wZuck/YETI60/mechanical/README.zh-CN.md

[英文](README.md) | 简体中文

# YETI60 机械检查

`felk60_plate_hhkb.audited.dxf` 来自 fredlb/FELK60。只修复三处 DXF 字典所有者句柄；圆、折线、圆弧凸度和图层几何在记录的 1e-9 毫米比较精度内不变。

FELK60 上游基线为 1.2 mm 不锈钢定位板。当前 YETI60 两方案均选择 **1.6 mm NiZ／钢板卫星轴定位板**，安装 28 套固定件、H26 不装。垫条原厚下侧 2.0 mm、上侧 1.2 mm；供方压缩性能及真实机构配合待确认。见 [E73 规格](../docs/build/key-mechanism.zh-CN.md)及 [Raytac 规格](../variants/raytac/docs/build/key-mechanism.zh-CN.md)。原上盖 M3 底孔约 2.529 毫米；当前派生设计改为冷粘嵌件座，见装配规范。

当前[装配报告](../docs/audit/yeti60-assembly.json)使用明确暂定的 PCB 至定位板间距，检查当前 PCB 与原始壳体、定位板几何。原生 STEP 基材厚度与声明的含铜、阻焊成品厚度分别记录。见[全面复查](../docs/audit/yeti60-comprehensive-review.zh-CN.md)和[装配渲染](../renders/yeti60-assembly/README.zh-CN.md)。

尚无获准生产的树脂 STL、选定嵌件、树脂收缩余量、合格轴体与胶碗堆叠、最终电池或完整后侧 USB 线缆及插头装配。

运行 `python3 scripts/run_audit.py` 导出当前 PCB 元数据、只读核对定位板几何、检查条件装配及渲染几何。发现 PCB、定位板、元件包络或电池候选包络碰撞时验证失败。依赖固定在 `requirements-audit.txt`。

渲染保持 FELK60 原始壳体尺寸：原始 CAD 坐标系中，上下壳联合包围尺寸为 325.700 × 125.200 × 31.190 毫米。网格线性离散偏差为 0.015 毫米，包围坐标差值检查小于 0.02 毫米。7° 展示旋转为刚性变换，不改变外壳尺寸。见[渲染几何验证](../docs/audit/yeti60-render-geometry.json)。

默认 P2 [工程装配图](../docs/engineering/assembly.zh-CN.md)与[单电芯选型和凹槽设计](../docs/engineering/battery-study.zh-CN.md)已同步。基础 `generated/yeti60-bottom.step` 包含 85×43×4.8 mm、1600 mAh 电池包的凹槽；E73 正式装配使用下述 M01 派生底壳。独立温度保护、供应商签图和实物验收仍是采购／生产条件。

E73 正式使用 [M01 内收定位板与地板修补](../docs/engineering/e73-mechanical-fit-candidate.zh-CN.md)，Raytac 使用其独立检查的 C04 定位板及短 USB 底壳；不要混用装配选项。共享的原 NiZ DXF 和 generated 基础壳体继续作为派生输入，E73 正式底壳为 [M01 STEP](e73-fit/yeti60-e73-bottom-m01.step)。
