wZuck/YETI60/hardware/raytac/README.md

English | [Chinese](README.zh-CN.md)

# Current Raytac candidate downloads

This directory mirrors the current repair candidate PCB, mainboard Gerber/drill ZIP and bottom-stencil ZIP from the [first-article entry](../../variants/raytac/hardware/usb-short-route/FIRST-ARTICLE.md). Identify the files with the [hash manifest](manifest.json). The duplicate download for the previous routing is removed; historical reference files remain in the variant directory.

Use the [first-article entry](../../variants/raytac/hardware/usb-short-route/FIRST-ARTICLE.md) for JLC selections, materials, wiring and case-free validation. Use the complete variant project for editing, models and footprint libraries; the individual PCB copy here is not a complete project. Supplier DFM precedes production; physical acceptance and production approval remain open.
