wZuck/YETI60/variants/raytac/README.zh-CN.md

[英文](README.md) | 简体中文

# YETI60 Raytac

**当前修补主板首样：**[制造文件、普通 JLC 参数、补购与无外壳步骤](hardware/usb-short-route/FIRST-ARTICLE.zh-CN.md)。原目录的旧主板清单、线束和压缩包不能代替当前候选版。

当前 J2 为 [SH 三针、1.0 mm 间距](hardware/usb-short-route/BATTERY-SERVICE.zh-CN.md)。插座按当前候选采购表购买，电池包采用 SHR-03V-S／SSH 端子；下方保留参考表中的 PH 器件行属于历史版本。

**首样下单暂停：**[含电池的无外壳流程](OPEN-BENCH.zh-CN.md) · [USB、螺钉与电池研究](docs/engineering/prototype-qualification.zh-CN.md)。当前制板包未放行下单。

> [下单与制作总入口](BUILD.zh-CN.md)：制板参数、材料、逐步焊接和固件。

> 本目录为同一分支中的 Raytac MDBT50Q-1MV2 方案；E73 方案在[仓库主目录](../../README.zh-CN.md)。两种 PCB 与固件须成套选择，不可互换模组。外壳、定位板与上游来源由仓库根目录共用；运行命令时以本目录为工作目录。

以 Cipulot EC60 为基础、使用 FELK60 外壳的单 nRF52840 静电容键盘 PCB。保留前侧感应焊盘和安装孔位置；右侧新增受控圆角射频支撑区，后侧 USB 子板连接 J1。

**有线使用：**电脑接受 USB 配置后，键盘一边给电池充电，一边通过 USB 发送按键。USB 自动优先于历史保存的蓝牙偏好；拔线后由 ZMK 回退到当前蓝牙配置。E73 和 Raytac 两套方案采用同一策略。描述符中的 500 mA 是输入预算，并非恒定电池充电电流。

> **P2 阶段提交：**保留 C5 JSH 子板；默认改为定制 1600 mAh 单电芯，正式底壳含凹槽，充电设定和 USB500 固件同步更新。工程装配图、PCB 动画及装配渲染记录来源哈希。见[阶段记录](docs/design-checkpoint.zh-CN.md)。

> **当前放行状态：**原生射频支撑区和 USB 保护修补已在工作区实施，完整文件刷新、供方及实物验收仍待完成。先阅读[下单与制作总入口](BUILD.zh-CN.md)，使用前核对报告与当前来源一致。

## 当前复查

**Raytac 当前原生导通检查通过，完整审查刷新、供方和实物验收仍待完成。** [完整复查](docs/audit/yeti60-comprehensive-review.zh-CN.md)记录当前 P2 设计和待供方、公差、线束及实物验收事项。

| 范围 | 结果 |
|---|---|
| PCB | 严格 DRC 0 错误／0 断线，267 对实际引脚连接通过；USB 电阻已改为 0 Ω，电源局部路径已缩短，只用普通机械通孔，无盲埋孔及模组盘中孔，采用 JLC 普通四层叠层 |
| 固件 | 按原理图绑定的新控制核心通过主机 ASan/UBSan；已完成 GPIO/SAADC 与 USB/BLE 目标集成，普通版和校准版构建通过；实机验证待进行 |
| 机械 | 明确暂定 Z 结构下，源 PCB／定位板／壳体无实体相交；胶碗、螺钉和树脂公差未定型 |
| 电池 | 默认定制 1600 mAh，完整包络 85×43×4.8 mm；供方签图、电流资料更正及独立温度保护验收待完成 |
| 可视化 | P2 的 PCB 图／动画、独立工程图和摄影风格装配渲染由来源哈希绑定 |

- [内部连接及线束装配图](docs/engineering/interconnects.zh-CN.md)
- [可行性评估回应](docs/engineering/assessment-response.zh-CN.md)
- [普通工艺制板审查包](docs/engineering/fabrication-review.zh-CN.md)
- [工程装配图及步骤](docs/engineering/assembly.zh-CN.md)
- [28 步逐图焊接与安装指南](docs/assembly/build-guide.zh-CN.md)
- [电池下挖可行性](docs/engineering/battery-study.zh-CN.md)
- [功耗、续航及充电计算](docs/engineering/power-budget.zh-CN.md)
- [材料与采购表](docs/engineering/materials.zh-CN.md)
- [PCB 标记清理](docs/engineering/board-markings.zh-CN.md)
- [完整复查](docs/audit/yeti60-comprehensive-review.zh-CN.md)
- [硬件及特殊制板要求](hardware/ec60-nrf52840/README.zh-CN.md)
- [控制核心、模拟和轨迹](firmware/yeti60/README.zh-CN.md)
- [装配渲染](renders/yeti60-assembly/README.zh-CN.md)
- [PCB 渲染及 360° 动画](renders/ec60-nrf52840/README.zh-CN.md)
- [当前审查索引](docs/audit/README.zh-CN.md)

外壳暂按树脂，信号／射频检查已开始，最小天线铜区检查已通过，USB 信号完整性、关壳射频及实物验收仍待完成。项目文档默认英文并提供 `.zh-CN.md`，机器数据字段保持稳定。

基于 [Cipulot/EC60](https://github.com/Cipulot/EC60) 和 [fredlb/felk60](https://github.com/fredlb/felk60)，保留上游作者、许可证和原名称。`EC60-nRF52840.*` 文件名及 `YAECKB` 库标识为技术兼容保留，公开项目名统一为 **YETI60**。

## 一把键盘需要准备的完整材料

**当前候选方案下单：**使用[首板入口](hardware/usb-short-route/FIRST-ARTICLE.zh-CN.md)、[当前 75 件采购表](hardware/usb-short-route/mainboard-purchase.zh-CN.csv)、[阻容规格](hardware/usb-short-route/PASSIVES.zh-CN.md)及 [C04 定位板／外壳／八条垫片](hardware/usb-short-route/MECHANICAL-FIT.zh-CN.md)。下方电子件和旧线束行属于保留的修补前参考；通用工具／紧固件仍可使用，但应服从这些当前修订。

以下为 **1 把完整键盘的装机净用量，不含备件**。主板与子板可购买焊装成品；若自行焊接，分别准备下面的散件，不能再重复购买同一总成的元件。尚未选定的供应商或型号明确标注，数量确定不代表已获采购放行。

**制板限制：只使用 JLC 普通四层工艺。已将旧盲孔／填孔封盖设计改为普通机械通孔；旧 HDI 文件不可用于下单。** 完成后以最新制板审查清单为准。没有第二颗主控，不需要每键二极管或 MX 热插拔座。

### 优先使用现有库存

按提供的订单库存记录核对标称值和封装，主板 75 只元件中可计划使用库存 **10** 只，净补购 **65** 只。装配前清点实际未使用数量，并完成电容有效容量确认。在途商品不计入可用数量。原始表格保持不变，也不上传到公开仓库。

| 库存型号 | 位号 | 计划使用数量 |
|---|---|---:|
| Samsung CL05B104KO5NNNC，100 nF／16 V／X7R／0402 | C9、C11、C12、C31 | 4 |
| Samsung CL05A105KA5NQNC，1 µF／25 V／X5R／0402 | C13、C48 | 2 |
| Uniroyal 0402WGF0000TCE，零欧姆／0402 | R30、R31 | 2 |
| Uniroyal 0402WGF1001TCE，1 kΩ／1%／0402 | R17 | 1 |
| Uniroyal 0402WGF1002TCE，10 kΩ／1%／0402 | R26 | 1 |

将 [扣除计划库存后的主板补购表](hardware/bom/mainboard-purchase.zh-CN.csv)、[库存判断说明](docs/engineering/inventory-allocation.zh-CN.md) 与下方完整准备清单配合使用。其他总成和结构材料仍需补购或确认兼容性。成品 C5 已包含七只元件；若改为自焊 C5 裸板，库存两只 5.1 kΩ 电阻可供 C5 的 R1／R2 使用。库存 nice!nano、110 mAh 电芯、0805 电容及过短的 PCB 螺丝不能直接替代指定物料。此次库存分配不改变板子或外壳尺寸。

### 需要下单制作哪些 PCB

数量为一把键盘的净用量，板厂起订数量另计。购买成品 C5 时，只制作 **一块主板**；自行焊子板时，制作 **一块主板加一块 C5 JSH 裸板**。

| PCB | 数量 | 尺寸与工艺 | 源文件及制板文件 |
|---|---:|---|---|
| YETI60 Raytac 主板 | 1 块 | 板框包围尺寸 289.39×94.6 mm；JLC 普通四层 FR-4、标称 1.6 mm，只用普通通孔 | [可编辑 KiCad PCB](hardware/ec60-nrf52840/EC60-nRF52840.kicad_pcb)、[当前 Gerber／钻孔审查压缩包](hardware/fabrication/yeti60-raytac-p2-dfm-review.zip)、[制板工艺要求](hardware/ec60-nrf52840/fabrication-notes.zh-CN.md) |
| Unified Daughterboard C5 JSH 子板 | 自焊时 1 块；买成品时 0 块 | 18.0×16.5 mm；**四层板**、标称 1.6 mm、普通通孔；安装孔矩形 14×12.5 mm | [上游固定版本 KiCad PCB](https://github.com/Unified-Daughterboard/UDB-C-JSH/blob/2b6c52aa2de6f9f60ca99c6250e4bdf01e8f4eea/UDB.kicad_pcb)、[下载固定版本 Gerber／钻孔包](https://raw.githubusercontent.com/Unified-Daughterboard/UDB-C-JSH/2b6c52aa2de6f9f60ca99c6250e4bdf01e8f4eea/production/UDB-C-JSH_5.0_gerbers.zip)、[七只焊装散件](hardware/bom/daughterboard.zh-CN.csv) |

两块板使用各自的制板文件，主板压缩包不包含 C5。两个压缩包均有四层铜，C5 不能按双层板下单。主板文件目前用于制造审查，最终物料、钢网及供应商验收仍待完成。J3 已在主板上，只需配探针治具，本设计无须再制作刷写小板。不锈钢定位板、树脂上下壳及五个走线支架属于机械件，不是额外 PCB。自行回流焊时，主板用 **B.Paste**，C5 用 **F.Paste**，钢网和温度曲线须与实际物料匹配。

### 电子总成、电池和连接线

| 材料 | 数量 | 详细规格及包含内容 |
|---|---:|---|
| 主板 PCB | 1 块 | 当前 YETI60 原生 PCB；普通四层 FR-4，目标 1.6 mm 标称厚度，保留 EC 电极／板框／安装中心；CAD 包络 1.6062 mm；按最新普通工艺审查包核对文件后下单 |
| 主板焊装散件 | 75 件 | 下表列明全部位号、数值、封装及指定／候选型号；购买焊装主板时此行已包含 |
| USB 子板 | 1 块焊装成品 | Unified Daughterboard C5 JSH，版本提交 `2b6c52a`；含 USB-C 母座、SH 板端座及其余元件，共 7 个实装元件；不选 S 版 |
| USB 内部线束 | 1 条四芯 | AWG28 多股铜线，绝缘外径不大于 0.8 mm；两端 SHR-04V-S 插壳，共 2 个插壳、8 个 SSH-003T-P0.2-H 端子；1→1 正电源、2→2 D−、3→3 D+、4→4 地。150 mm 为路径中心线，四根实际出线口间长度约 147.64／149.21／150.79／152.36 mm，须按控制路径预成形 |
| 电池总成 | 1 包 | 定制单电芯 YETI60-BAT-1600-1S，最低目标 1600 mAh，整个电池包不超过 85×43×4.8 mm，已包含保护板、温度传感器、包覆、焊片和增长空间；独立温度断充，实际充电窗口须在 15…43°C 内；供方须接受至少 500 mA 连续充电及 4.16–4.23 V 充电稳压范围 |
| 电池引线及插头 | 1 套三线，含在电池总成中 | AWG28、外径不大于 0.8 mm；PHR-3 插壳 1 个、SPH-004T-P0.5S 端子 3 个；1 红色正极、2 黑色负极、3 黄色独立 10k NTC 温度线。温度保护和第三线 NTC 反馈须分开；尺寸和出线位置须供方签图 |
| 外部 USB 数据线 | 1 条 | 主机端按电脑选择 USB-A／USB-C，键盘端 USB-C；必须支持 USB 数据，不能用仅充电线 |

### 主板全部实装元件

0402 电阻均按 1%、不低于 50 mW 选型；0 Ω 位置使用零欧姆连接。220 pF 电容使用 C0G，其余按 X5R／X7R、10% 或更优、不低于 10 V（标注 16 V 的位置使用 16 V）；有效容量仍须核对偏压降额。以下数值是当前电路要求，未选型号处不得自行宣称已定型。

| 位号 | 数量 | 数值／功能 | 封装 | 指定／候选型号 | 计划用库存 | 需补购 | 库存备注 |
| --- | --- | --- | --- | --- | --- | --- | --- |
| C9, C11, C12 | 3 | 100n | C_0402_1005Metric | 厂商型号待选 | 3 | 0 | 已有：Samsung CL05B104KO5NNNC；订单已收货池 100 只（同来源行共享，不可逐行相加）；装配前清点；须确认有效容量 |
| C10 | 1 | 220p | C_0402_1005Metric | 厂商型号待选 | 0 | 1 | 未匹配可用库存；需补购 |
| C13 | 1 | 1u | C_0402_1005Metric | 厂商型号待选 | 1 | 0 | 已有：Samsung CL05A105KA5NQNC；订单已收货池 50 只（同来源行共享，不可逐行相加）；装配前清点；须确认有效容量 |
| C30, C41, C42, C43, C45, C46 | 6 | 10u/10V | C_0603_1608Metric | 厂商型号待选 | 0 | 6 | 未匹配可用库存；需补购 |
| C31 | 1 | 100n/16V | C_0402_1005Metric | 厂商型号待选 | 1 | 0 | 已有：Samsung CL05B104KO5NNNC；订单已收货池 100 只（同来源行共享，不可逐行相加）；装配前清点；须确认有效容量 |
| C32 | 1 | 4.7u/10V | C_0603_1608Metric | 厂商型号待选 | 0 | 1 | 未匹配可用库存；需补购 |
| C40 | 1 | 1u/10V | C_0603_1608Metric | 厂商型号待选 | 0 | 1 | 未匹配可用库存；需补购 |
| C44 | 1 | 100n/16V | C_0603_1608Metric | 厂商型号待选 | 0 | 1 | 未匹配可用库存；需补购 |
| C47 | 1 | 10n | C_0402_1005Metric | 厂商型号待选 | 0 | 1 | 未匹配可用库存；需补购 |
| C48 | 1 | 1u/10V | C_0402_1005Metric | 厂商型号待选 | 1 | 0 | 已有：Samsung CL05A105KA5NQNC；订单已收货池 50 只（同来源行共享，不可逐行相加）；装配前清点；须确认有效容量 |
| D2 | 1 | STATUS | LED_0603_1608Metric | 0603 指示灯，厂商型号待选 | 0 | 1 | 未匹配可用库存；需补购 |
| F1 | 1 | 500mA | Fuse_1206_3216Metric | 1206 自恢复保险丝，保持电流 0.5 A | 0 | 1 | 未匹配可用库存；需补购 |
| J1 | 1 | REAR_USB_DAUGHTERBOARD | JST-SR-4 | JST SM04B-SRSS-TB(LF)(SN)，候选 | 0 | 1 | 未匹配可用库存；需补购 |
| J2 | 1 | PROTECTED_1S_4V2_NTC10K | JST_PH_S3B-PH-SM4-TB_1x03-1MP_P2.00mm_Horizontal | JST S3B-PH-SM4-TB(LF)(SN) | 0 | 1 | 未匹配可用库存；需补购 |
| L1 | 1 | 1.5uH_74438336015 | L_Wuerth_MAPI-3015 | Wurth 74438336015 | 0 | 1 | 未匹配可用库存；需补购 |
| R3, R4, R5, R6, R7, R47, R53, R54 | 8 | 100 | R_0402_1005Metric | 厂商型号待选 | 0 | 8 | 未匹配可用库存；需补购 |
| R8, R9, R10, R11, R12, R13, R14, R15, R16, R18, R19, R20, R21, R23, R24, R25, R42, R43, R44, R45, R46, R48, R49, R50 | 24 | 100k | R_0402_1005Metric | 厂商型号待选 | 0 | 24 | 未匹配可用库存；需补购 |
| R17 | 1 | 1k | R_0402_1005Metric | 厂商型号待选 | 1 | 0 | 已有：Uniroyal 0402WGF1001TCE；订单已收货池 100 只（同来源行共享，不可逐行相加）；装配前清点 |
| R26 | 1 | 10k | R_0402_1005Metric | 厂商型号待选 | 1 | 0 | 已有：Uniroyal 0402WGF1002TCE；订单已收货池 100 只（同来源行共享，不可逐行相加）；装配前清点 |
| R30, R31 | 2 | 0 | R_0402_1005Metric | 厂商型号待选 | 2 | 0 | 已有：Uniroyal 0402WGF0000TCE；订单已收货池 100 只（同来源行共享，不可逐行相加）；装配前清点 |
| R32 | 1 | 2.2k | R_0402_1005Metric | 厂商型号待选 | 0 | 1 | 未匹配可用库存；需补购 |
| R40 | 1 | 2.21k/1% | R_0402_1005Metric | 厂商型号待选 | 0 | 1 | 未匹配可用库存；需补购 |
| R41 | 1 | 7.50k/1% | R_0402_1005Metric | 厂商型号待选 | 0 | 1 | 未匹配可用库存；需补购 |
| R51, R52 | 2 | 1M/1% | R_0402_1005Metric | 厂商型号待选 | 0 | 2 | 未匹配可用库存；需补购 |
| R55 | 1 | 69.8k/1% | R_0402_1005Metric | 厂商型号待选 | 0 | 1 | 未匹配可用库存；需补购 |
| R56 | 1 | 1.69k/1% | R_0402_1005Metric | 厂商型号待选 | 0 | 1 | 未匹配可用库存；需补购 |
| SW1 | 1 | EVQPUC02K_RESET | Panasonic_EVQPUL_EVQPUC | Panasonic EVQPUC02K | 0 | 1 | 未匹配可用库存；需补购 |
| SW100 | 1 | JS102011SAQN_POWER | SW_SPDT_CK_JS102011SAQN | C&K JS102011SAQN | 0 | 1 | 未匹配可用库存；需补购 |
| U1 | 1 | MDBT50Q-1MV2 | Raytac_MDBT50Q | Raytac MDBT50Q-1MV2 | 0 | 1 | 未匹配可用库存；需补购 |
| U2, U4 | 2 | 74HC4051 | TSSOP16 | Nexperia 74HC4051PW,118 | 0 | 2 | 未匹配可用库存；需补购 |
| U3 | 1 | OPA350 | SOIC-8_3.9x4.9mm_P1.27mm | TI OPA350UA | 0 | 1 | 未匹配可用库存；需补购 |
| U5 | 1 | BQ24074RGT | VQFN-16-1EP_3x3mm_P0.5mm_EP1.6x1.6mm | TI BQ24074RGTR | 0 | 1 | 未匹配可用库存；需补购 |
| U6 | 1 | TPS63031DSK | WSON-10-1EP_2.5x2.5mm_P0.5mm_EP1.2x2mm | TI TPS63031DSKR | 0 | 1 | 未匹配可用库存；需补购 |
| U7, U8 | 2 | TPS22919DCK | SOT-363_SC-70-6 | TI TPS22919DCKR | 0 | 2 | 未匹配可用库存；需补购 |

JP1 数量 **0**，保持不装；J3 为 PCB 上的六个 SWD 接触焊盘，不另装排针。主板统计为 43 个电阻、17 个电容及 15 个其他器件，共 75 件。

### 可选：自行焊接 C5 JSH 子板

准备 **C5 JSH 裸板一块及下方七只元件**，替代购买成品子板。[本仓库库存抵扣表](hardware/bom/daughterboard.zh-CN.csv) · [上游固定版本材料表](https://github.com/Unified-Daughterboard/UDB-C-JSH/blob/2b6c52aa2de6f9f60ca99c6250e4bdf01e8f4eea/production/UDB-C-JSH_5.0_bom.csv) · [上游固定版本制板文件](https://github.com/Unified-Daughterboard/UDB-C-JSH/blob/2b6c52aa2de6f9f60ca99c6250e4bdf01e8f4eea/production/UDB-C-JSH_5.0_gerbers.zip)。

| 位号 | 数量 | 厂商及指定型号 | 封装／连接器焊盘 | LCSC 编号 | 计划用库存 | 需补购 | 库存备注 |
| --- | --- | --- | --- | --- | --- | --- | --- |
| D1 | 1 | FTR SMF6.0A | SOD-123FL | C708002 | 0 | 1 | 未匹配可用库存；需补购 |
| F1 | 1 | Shenzhen JDT Fuse ASMD1206-150 | F1206 | C135342 | 0 | 1 | 未匹配可用库存；需补购 |
| J2 | 1 | JST SM04B-SRSS-TB(LF)(SN) | SM04B-SRSS-TB(LF)(SN)_mounting-reliefs | C160404 | 0 | 1 | 未匹配可用库存；需补购 |
| J1 | 1 | Korean Hroparts TYPE-C-31-M-12 | TYPE-C-31-M-12 | C165948 | 0 | 1 | 已有同系列国产替代 6 只；尺寸及针脚待确认，暂不抵扣 |
| R1, R2 | 2 | Uniroyal 0402WGF5101TCE | R0402 | C25905 | 2 | 0 | 已有同型号；订单已收货池 100 只，计划用 2 只；装配前清点 |
| U1 | 1 | Texas Instruments TPD4E05U06DQAR | uSON-10 | C138714 | 0 | 1 | 未匹配可用库存；需补购 |

库存两只 5.1 kΩ 电阻可供 R1／R2 使用，因此自焊选项还需 **五只散件及一块裸板**。国产 TYPE-C-31-M-12 的实物尺寸未确认，暂不抵扣。这些位号属于子板，不能与主板同名位号混用。USB 线束、四只 M2 螺丝及垫圈另按下方准备。LCSC 编号来自固定版本的上游清单，不代表当前价格或库存保证。材料数据版权属于 Unified Daughterboard Project（2023），保留 [MIT 许可证](hardware/usb-daughterboard/LICENSE.upstream)。

### 壳体、静电容结构与紧固件

| 编号 | 材料 | 数量 | 详细规格／验收要求 |
|---|---|---:|---|
| M01 | 上壳 | 1 | 派生 FELK60 HHKB STEP；韧性 SLA 树脂，完成后固化；外部尺寸不缩放 |
| M02 | 底壳 | 1 | 默认 P2 派生 STEP，含 1600 mAh 电池槽，外形不变 |
| M03 | 定位板 | 1 | K07 NiZ 钢板卫星轴 DXF，304 不锈钢，CAD 厚 1.60 mm、成品 1.55—1.60 mm，28 处 M2×0.4；H26 不开安装孔 |
| M04 | NiZ 轴座／滑块及原配消音圈 | 60 套 | K01 每包 5 套，买 13 包共 65 套，装 60、余 5；大键也用普通中央轴座，不用 Deskeys 宽总成 |
| M05 | 胶碗 | 60 个位置 | K03 NiZ 45g 整张 1 张，取至少 60 个完整位置并按 HHKB 裁分；不是 K01 内含材料 |
| M06 | 锥形感应弹簧 | 60 | K02 NiZ 锥簧每包 5 个，买 13 包共 65，装 60、余 5；不是辅助回弹簧 |
| M07 | 钢板卫星轴及钢丝 | 1 套 | K04 原装 GMK Plate mount／2u 买 3 组，装六个壳和柱；用两根短丝，第三组改装 K05 单独 6U 长丝；短丝余 1 |
| M08 | 键帽 | 60 | K06 NicePBT BoW 当前完整套装 1 套，须含 6.0c Centered 居中空格；MX 接口 |
| M09 | 转接支柱 | 28 | YETI60-STANDOFF-46；黄铜 Ø3.5，肩长 4.50±0.03；上端 M2×0.4 外牙长 1.0，下端 M1.6×0.35 内牙深 3.2；H26 不装 |
| M10 | 上侧绝缘膜 | 28 | 聚酰亚胺 0.10±0.02 mm，外径 4.5／内径 1.8；支柱与 PCB 之间，H26 不装 |
| M11 | PCB 螺钉 | 28 | M1.6×5 盘头，头部包络和螺纹须首件确认；H26 不装 |
| M12 | PCB 垫片 | 28 | PEEK，外径不大于 4.0、内径 2.2、厚 0.8 mm；H26 不装，不换金属垫片 |
| M13 | 上壳嵌件 | 4 | 冷粘滚花黄铜 M3×0.5，外径 4.6、长 3.0；底孔 Ø4.85±0.05、深 3.5 |
| M14 | 子板嵌件 | 4 | 冷粘黄铜 M2×0.4，外径 3.2、长 2.5；底孔 Ø3.35±0.05、深 2.9 |
| M15 | 合壳螺钉 | 4 | 建议 M3×5 加 0.30 mm 薄垫；CAD 螺钉座 z=2.59、嵌件入口 z=4.79，名义啮合 2.50 mm；头径不大于 5.6，匹配 Ø5.8 沉孔 |
| M16 | 子板螺钉 | 4 | 建议 M2×4 加 0.30 mm 绝缘垫片；名义啮合 4−1.6062−0.30=2.0938 mm，嵌件长 2.5；头部与连接器间隙仍需检查 |
| M17 | 垫片安装胶棉 | 1 套 | 下侧原厚 2.0 mm、上侧原厚 1.2 mm，按原支承台裁切；名义装后各为 1.0162／0.5838 mm |
| M18 | 脚垫 | 4 个 | [SKUF 硅胶脚垫](https://keeb.io/products/skuf-silicone-rubber-keyboard-feet)，41.8×5.8×2 mm、45A、自带背胶；四个壳体脚槽约 42.2×6.2 mm。购买 1 包 8 个时余 4 个备件 |
| M19 | 嵌件胶粘剂 | 适量 | 与树脂相容的结构环氧胶；仅冷粘，按供方要求固化，不得堵塞螺纹 |
| M20 | 电池固定及绝缘材料 | 1 套 | 非导电可拆固定及边缘防护；胶带厚度计入槽深预算，不能压紧软包电池 |

**按键机构已改为 NiZ＋钢板卫星轴。** [准确选项、数量与安装](docs/build/key-mechanism.zh-CN.md)列出 K01—K07；它们分开购买，不再购买 Deskeys 配件包。PCB 原 29 孔不变，H26 不装，实际用 28 套紧固件。机械库存未核实。

### 补充固定材料和耗材

| 材料 | 数量 | 规格／包含关系 |
|---|---:|---|
| 合壳薄垫片 | 4 | 厚 0.30 mm，配上表 4 颗 M3×5；孔适配 M3，外径不超过螺钉座可用空间 |
| 子板绝缘垫片 | 4 | 厚 0.30 mm，孔适配 M2，配 4 颗 M2×4 |
| 后侧线束固定座底座 | 2 | `mechanical/generated/interconnect-guides/rear-1-base` 和 `rear-2-base` 的 STEP／STL 各 1 件；当前宽 5.4、路径方向长 2 mm |
| 后侧固定座可拆桥 | 2 | 对应 `rear-1-bridge` 和 `rear-2-bridge` 各 1 件；下层三根电池线、上层四根 USB 线，槽半径 0.5 mm |
| 前侧 USB 固定座 | 1 | `front-base` 的 STEP／STL；宽 6、路径方向长 1.8 mm；按壳体坐标安装，不能缩放 |
| 聚酰亚胺绝缘片材 | 1 张 | 至少 100×100×0.10 mm；用于上表 28 片绝缘圆片，已购买裁切件时不重复计入；线束保持膜另用下列带胶材料 |
| 胶棉片材 | 2 张 | 下侧至少 330×130×2.0 mm 一张，上侧至少 330×130×1.2 mm 一张；对应 M17 一套，不重复计数；材质硬度须首件确认 |
| 树脂相容双组分结构胶 | 1 小套 | 嵌件和支座粘接用，按胶与树脂供方工艺选型并完全固化；这是采购包装数，不是已测得耗胶量 |
| 电池可拆固定胶与边缘绝缘 | 1 套 | 槽底到电池包名义仅 0.20 mm；底部胶、绝缘和装配余量的总厚度不得超预算，不能额外压缩软包 |
| 上侧线束保持胶带 | 1 小卷，裁 3 片 | 带胶绝缘膜／胶带，含胶总厚不超过 0.10 mm；覆盖上层导线并向固定座侧面包覆 |
| 可拆桥固定胶带 | 1 小卷 | 非导电、可移除双面胶，总厚 0.05 mm，用于 2 个后侧桥的侧面支承区；上层保持膜与胶总厚不得超过 0.10 mm |

### 需要的工具（可共用，无须每把配一套）

| 工具 | 数量 | 用途／规格 |
|---|---:|---|
| 兼容 nRF52840 的 SWD 调试器 | 1 | 3.3 V 目标电平，支持 SWDIO／SWDCLK／地／复位 |
| J3 弹簧针治具 | 1 套 | 6 根针按 J3 焊盘图布置；3.3 V 为目标参考，不能同时盲目向已供电主板反灌电源 |
| 万用表 | 1 | 逐线导通、极性及上电短路检查 |
| 游标卡尺及厚度量具 | 各 1 | 检查电池完整包络、板厚、支柱和绝缘垫片 |
| 低扭矩螺丝刀及匹配批头 | 1 套 | M1.6／M2／M3；最终扭矩须按样件和螺纹质量确定 |
| 绝缘拨动工具 | 1 | 经底部检修孔操作 SW100 |
| 切割／去毛刺工具、镊子 | 1 套 | 裁垫片、清理支座与安装；不得损伤电池绝缘 |
| 焊台、热风或回流设备、焊料、助焊剂和清洗耗材 | 各 1 套（自行焊接时） | 0402、模组及裸露散热盘需要适合的焊装能力；购买焊装板时不属于随键盘材料 |
| 背面钢网 | 1 张（自行回流焊接时） | 按当前 B.Paste 光绘激光切割，样机暂按 0.10 mm 不锈钢；最终厚度与散热盘开口由贴片工艺确认 |
| 定位板攻牙工具 | 1 套（自行加工定位板时） | M2×0.4 丝锥及匹配底孔加工工具；买已攻牙定位板时不需要重复加工 |
| 嵌件孔精修工具 | 1 套（壳厂未精加工时） | 按 Ø4.85±0.05／Ø3.35±0.05 mm 及规定孔深加工，不能用未测量的打印孔直接代替 |
| 限流电源、电池模拟器、电流记录仪和温度探头 | 各 1 套（样机验证时） | 用于首次上电、充电／终止／温升和续航验收；不计入键盘装机数量 |

详细采购限制见[材料文档](docs/engineering/materials.zh-CN.md)与[功耗及充电计算](docs/engineering/power-budget.zh-CN.md)。电池供方签图、未选元件、静电容机械结构与普通工艺改版验收完成前，不应把这份准备清单当作可直接量产的采购单。
