wZuck/YETI60/firmware/ec60/readme.md

English | [Chinese](readme.zh-CN.md)

# EC60

60% Electrostatic Capacitive PCB, GH60 mounting compatible, with multi-layout support

* Keyboard Maintainer: [cipulot](https://github.com/cipulot)
* Hardware Supported: EC60
* Hardware Availability: TBD

Make example for this keyboard (after setting up your build environment):

    make ec60:default
    make ec60:via

Flashing example for this keyboard:

    make ec60:default:flash
    make ec60:via:flash

See the [build environment setup](https://docs.qmk.fm/#/getting_started_build_tools) and the [make instructions](https://docs.qmk.fm/#/getting_started_make_guide) for more information. Brand new to QMK? Start with our [Complete Newbs Guide](https://docs.qmk.fm/#/newbs).

This is the upstream STM32 reference. These commands do not build or flash the YETI60 nRF52840 application.
