wZuck/YETI60/variants/raytac/firmware/README.md

English | [Chinese](README.zh-CN.md)

# YETI60 firmware

USB charging now uses the [status callback and deconfiguration policy](../docs/testing/usb-event-policy.md), independently of scan polling. Suspend disables charging/input; resume and 500 mA permission follow the actual configuration byte. Both variants share this logic; recalibrate when upgrading from an older bundle.

Current repaired-board files: [candidate firmware and SWD entry](../hardware/usb-short-route/firmware/README.md). Read [selected-profile recovery and calibration v3 compatibility](../docs/testing/firmware-recovery.md); keep the normal/calibrator pair from the same bundle.

The current [nRF52840 control core](yeti60/README.md) and [host simulation](../docs/audit/yeti60-firmware-simulation.json) use the schematic-derived GPIO, SAADC and mux contract. Run `python3 scripts/simulate_yeti60_firmware.py` from the repository root.

Only the current core and its tests are maintained here. Original EC60 QMK sources remain in the attributed `EC60` submodule; duplicate legacy firmware and tests have been removed. The GPL license is retained.

The target module supplies a flashable SWD application, GPIO/ADC driver, USB/BLE stacks and HHKB keymap. Physical calibration and on-device operation require a sample. Host sanitizer tests establish logic behavior with mocked hardware, not on-device operation.

[Buildable target firmware](target/README.md) now supplies a custom YETI60 board, the same portable core, ZMK USB/BLE HID, persistent calibration and normal/calibrator HEX files. On-device verification remains pending.

The [plate/copper/firmware check](../docs/audit/yeti60-key-geometry.json) matches all 60 opening centers to actual ROW/COL copper, including the alternate lands inside SW60/SW62. Right Shift is ROW3/COL13 and Fn is ROW3/COL14; the former ROW3/COL12 and ROW4/COL14 choices were corrected in both the target transform and calibration mask, and both target variants were rebuilt. Geometric coverage does not replace physical key calibration. Follow the [illustrated programming and installation guide](../docs/assembly/build-guide.md).
