wZuck/YETI60/variants/raytac/firmware/README.zh-CN.md

[英文](README.md) | 简体中文

# YETI60 固件

USB 充电控制已改为[状态回调及取消配置处理](../docs/testing/usb-event-policy.zh-CN.md)，不再等待扫描轮询。挂起禁充／输入高阻；恢复和 500 mA 授权按实际配置字节处理。两版共用此逻辑，从旧包升级需重新校准。

当前修补板文件：[候选固件与 SWD 入口](../hardware/usb-short-route/firmware/README.zh-CN.md)。参阅[单槽位恢复和 v3 校准兼容性](../docs/testing/firmware-recovery.zh-CN.md)，普通版和校准版必须来自同一固件包。

当前 [nRF52840 控制核心](yeti60/README.zh-CN.md)和[主机模拟](../docs/audit/yeti60-firmware-simulation.json)使用从原理图推导的 GPIO、SAADC 和复用器契约。在仓库根目录运行 `python3 scripts/simulate_yeti60_firmware.py`。

此处只维护当前核心及其测试。原始 EC60 QMK 源码仍保留在具有上游署名的 `EC60` 子模块中，重复历史固件与测试已移除，GPL 许可证保留。

目标模块提供可通过 SWD 刷写的应用、GPIO／ADC 驱动、USB／蓝牙栈及 HHKB 键位映射；实物校准和实际运行仍待样机。主机消毒器测试验证模拟硬件下的逻辑行为，不证明实机可运行。

[可构建目标固件](target/README.zh-CN.md)现提供 YETI60 自定义板、同一可移植核心、ZMK USB／蓝牙 HID、持久校准和普通／校准版 HEX；实机验证仍待样机。

[定位板／铜箔／固件检查](../docs/audit/yeti60-key-geometry.json)将 60 个开孔中心对应到实际 ROW／COL 铜箔，包括 SW60／SW62 内的备选焊盘。右 Shift 对应 ROW3／COL13，Fn 对应 ROW3／COL14；目标键位变换和校准掩码均已纠正之前的 ROW3／COL12、ROW4／COL14 选择，两版固件已经重新构建。几何覆盖检查不能替代实物逐键校准。安装及刷写参见 [逐图指南](../docs/assembly/build-guide.zh-CN.md)。
