wZuck/YETI60/variants/raytac/firmware/target/README.zh-CN.md

[英文](README.md) | 简体中文

# YETI60 目标固件

静电容扫描已修正为先释放再升行、先钳位再降行；见[模拟时序研究](../../docs/testing/analog-waveform.zh-CN.md)。校准版新增 `yeti_calibrate timing`，报告行 GPIO 调用至 ADC 返回的 RTC 粗略耗时及计时频率，含一格量化余量；实际为 32768 Hz，不能据此确定精确采样时刻。升级后用同包两版重新校准。

USB 充电控制已改为[状态回调及取消配置处理](../../docs/testing/usb-event-policy.zh-CN.md)，不再等待扫描轮询。挂起禁充／输入高阻；恢复和 500 mA 授权按实际配置字节处理。两版共用此逻辑，从旧包升级需重新校准。

当前修补 PCB 使用[候选构建／刷写入口](../../hardware/usb-short-route/firmware/README.zh-CN.md)。[恢复与 v3 校准契约](../../docs/testing/firmware-recovery.zh-CN.md)新增 Fn＋双击 Backspace（两次按下间隔小于 400 ms），仅清除当前蓝牙槽位。首次升级 v3 需重新采集阈值；刷入配套普通版时保留设置。

此 ZMK 模块将已测试的可移植扫描核心接入 nRF52840 GPIO／SAADC，并使用当前原理图生成的引脚头文件。ZMK 提供 USB HID、蓝牙 HID、绑定、五组主机配置和持久设置。HHKB 映射依据实际定位板与感应焊盘对应关系，自定义板使用内部低频 RC 时钟，不占用开发板 LED 引脚，应用从地址零通过 SWD 刷写。

## 可复现构建

准确初始化步骤、自定义工作区及排障见[从新检出仓库构建的环境说明](../../docs/build/firmware-environment.zh-CN.md)。从仓库根目录执行：

```sh
python3 variants/raytac/scripts/prepare_yeti60_workspace.py
python3 variants/raytac/scripts/prepare_yeti60_workspace.py --check
python3 variants/raytac/scripts/build_usb_short_firmware.py
```

上述封装脚本构建当前候选板。独立的 `python3 variants/raytac/scripts/build_yeti60_firmware.py` 构建保留的参考板。两者使用冻结清单及固定容器，拒绝被改动的依赖源码／版本，并记录源码／配置／设备树／产物哈希。ZMK 使用项目 fork `https://github.com/wZuck/zmk` 的 `0862fc0f8c864834007986efcaf52f292ea6d37d`；相对上游只增加了可配置的可连接广播间隔（`ZMK_BLE_ADV_INT_MIN/MAX`）。

构建容器按摘要固定，临时构建目录已忽略。可分发 HEX、BIN、ELF 位于 `firmware/releases/`。J3 使用本项目自定义 SWD 引脚，连接探针前核对硬件契约。校准后更新普通固件时，保留末尾 64 KiB 设置分区；整片擦除会丢失校准与蓝牙绑定。

## 校准与操作

先刷校准版 HEX。全部松键执行 `yeti_calibrate release`，等待 128 帧完成提示。对 60 个实际按键分别操作：先将目标键完全按住，再执行 `yeti_calibrate press <row> <col>`，保持按住直到该键 128 个采样完成提示后再松开。用 `yeti_calibrate status` 检查样本数、最坏边界及保护裕量，全部有效后执行 `yeti_calibrate save`。不带行列的旧 `press` 命令会被拒绝。扫描持有者线程要求每状态至少 64 个有标签样本，拒绝饱和／重叠分布，以保守的六倍标准差保护值，在最坏边界之间选择严格分离的阈值。采样期间或没有有效校准时不发送按键。新指纹包含引脚、设备树、原生 PCB 和校准算法，旧的乐观校准会失效。写普通固件时须保持同一板型和设置分区。

Fn 层提供功能键、方向键和五组蓝牙主机选择。USB／蓝牙 HID 与输出切换由固定版本 ZMK 实现。P2 申请 500 mA（旧版 Zephyr `CONFIG_USB_MAX_POWER=250`）。仅主机接受配置后启用 USB500 充电；此前保持 USB100 且不充电，挂起时禁充并关闭输入，恢复后保留已接受配置。两个链接 ELF 的描述符均已检查。电池报告暂时关闭，待电池与测量接口完成后接入。扫描故障会将模拟前端锁定断电，排查后重启。

## 同时充电与自动优先 USB

电脑接受 USB 配置后，充电与 USB 按键传输同时运行。目标适配层明确选择 ZMK 的 USB 偏好，即使历史设置保存的是蓝牙也会自动切换；已经选择 USB 时不重复写设置。拔线后由 ZMK 回退到当前已连接的蓝牙配置，已有绑定无需重新配对。只供电的电源不会完成枚举，也不会变成 USB 数据主机。

| 主机状态 | 固件运行时充电状态 | 按键链路 |
|---|---|---|
| 已供电，尚未配置 | 禁止充电，USB100 输入模式 | 当前蓝牙配置已连接时可用 |
| 已配置，接受 500 mA | 允许充电，USB500 输入预算与系统负载共用 | 优先 USB，蓝牙已连接也会切换 |
| USB 挂起 | 禁止充电，输入高阻 | 由 ZMK 处理挂起，主机恢复后继续 USB 报告 |
| USB 拔出 | 无 USB 充电 | 当前已连接的蓝牙配置 |

500 mA 并非固定电芯充电电流；实际值受充电设定、负载分流、温度、线损及充电阶段影响。主机回归在 ASan/UBSan 下编译实际适配层，使用 GPIO／工作队列接口；USB 事件测试还编译完整固定版本 ZMK USB 源码。可移植核心另外测试。这些测试检查同时充电与 USB 偏好、历史蓝牙覆盖、挂起／恢复／复位／拔线、失败后重试，以及不重复写设置或 GPIO。该测试没有运行真实 USB 或蓝牙协议栈。

## 空闲功耗策略

扫描线程在有按键、状态变化或有效位置存在待确认消抖边沿时保持 4 ms 间隔；连续 30 s 无按键、变化或待确认边沿后改为 30 ms，并在空闲帧之间通过 U8/AFE_EN 关断 AFE，下一次扫描前重新稳定。参数由 `YETI60_ACTIVE_SCAN_MS`、`YETI60_IDLE_SCAN_MS`、`YETI60_IDLE_AFTER_MS` 和 `YETI60_AFE_IDLE_GATING` 控制。设备树把 REG1 设为 DC/DC；REG0 仍为 LDO，因为板上没有外部 DCCH 电感。BLE 连接优先请求 15–30 ms 间隔并使用 0 dBm；未连接时的可连接广播使用 200–300 ms 间隔（ZMK fork 的 `ZMK_BLE_ADV_INT_MIN/MAX`），主机仍可覆盖连接参数。`CONFIG_ZMK_SLEEP` 仍关闭：EC 键不是 System OFF 的 GPIO 唤醒源，直接启用会导致无法用按键唤醒。

编译通过证明能够生成目标二进制。阈值、时序、USB 枚举、蓝牙配对、电流和唤醒仍需首件实测，启动及校准参数目前属于待测工程参数。此固件不声称已经通过实物验收。

所有启用的 ZMK、Zephyr 和 HAL 依赖均锁定到提交；构建器拒绝不同依赖版本。引脚、设备树、原生 PCB 或校准算法的变化都会使旧校准失效。

本方案固件文件名为 `yeti60-raytac.hex/.bin/.elf`，位于 `firmware/releases/normal/` 与 `firmware/releases/calibrator/`。以本方案目录作为构建工作目录，不可刷写 E73 文件。

[逐键校准操作与拒绝条件](../../../../docs/testing/calibration.zh-CN.md)；[60 键行列命令表](calibration-keys.csv)。

模拟高阻和钳位释放现在使用 `GPIO_DISCONNECTED`，不接数字输入缓冲、输出或上下拉；初始化失败后统一尝试关闭 AFE。源码、主机电气约束与实物边界见[GPIO 模式说明](../../docs/testing/gpio-mode-policy.zh-CN.md)。模式辅助函数已纳入校准指纹，升级需重新校准。

扫描初始化失败时命令立即返回不可用；运行故障关闭模拟前端、释放已记录按键并拒绝继续采集／保存。两个固件均采用 128 项按键事件队列。见[扫描状态与故障回归](../../docs/testing/scan-control.zh-CN.md)，包含实际工作循环、60 键采集和 120 事件突发测试；真实主机送达仍待首板验收。

校准记录现为带独立 CRC-32 的 308 字节，旧 304 字节记录必须重新采集；全局 NVS 设置格式及蓝牙绑定不变。见[校准存储校验与升级](../../docs/testing/calibration-storage.zh-CN.md)。损坏注入已覆盖，真实闪存断电仍待首板验收。

新增[固定版本 NVS 中断恢复模型](../../docs/testing/nvs-powercut.zh-CN.md)：实际 NVS／校准加载代码完成 14,795 次指定中断试验，覆盖垃圾回收和恢复期间再次中断；哨兵及恢复后再次保存均通过。它不是物理 NVMC／欠压／蓝牙验收。NVS 模型本身只增加测试；已有候选产物可用 `--host-tests-only` 重新验证并发布测试，来源变动则必须完整构建。

空闲短按已修补：有效位置首次出现待确认消抖边沿即恢复活动扫描，并保留两帧确认，见[短按／未使用位置及门控测试](../../docs/testing/scan-control.zh-CN.md)。升级须采用配套固件并重新校准；实际首键延迟及单帧噪声引起的额外活动耗电仍需实测。
