wZuck/YETI60/requirements-audit.txt

# CAD audit interpreter: CPython 3.14.7; keep report and mesh generation on the same runtime.
cadquery-ocp==8.0.1.1.0
vtk==9.6.2
ezdxf==1.4.5
matplotlib==3.11.2
Pillow==13.0.0
shapely==2.1.2
