wZuck/YETI60/requirements-render.txt

# Separate from the CAD runtime; bpy requires its supported Python version.
bpy==5.0.1
