wZuck/YETI60/requirements-kicad-routing.txt

# Optional local routing helper, with KiCad's bundled CPython 3.9.
# Install to an isolated target, not the KiCad application installation.
numpy==2.0.2
pillow==11.3.0
