wZuck/YETI60/docs/engineering/e73-mechanical-fit-candidate.zh-CN.md

[English](e73-mechanical-fit-candidate.md) | 简体中文

# E73 正式选用的 M01 定位板与开关地板修补

**M01 现已接入 E73 正式装配、校准指纹及渲染流程。** 已测出的三个定位板／地板接口在规定尺寸包络内通过。这不代表整机或制造验收完成：整板取出、柔性检修运动及其他零件公差仍待检查。已有 C5 子板、PCB、电池基准、感应中心、卫星轴开孔和安装轴均保持原位。

## 可审阅文件

- [M01 定位板 DXF](../../mechanical/e73-fit/yeti60-e73-niz-m01.dxf)及 [STEP](../../mechanical/e73-fit/yeti60-e73-niz-m01.step)：1.6 mm 304 不锈钢，仅外缘内收 0.40 mm。
- [M01 底壳 STEP](../../mechanical/e73-fit/yeti60-e73-bottom-m01.step)及 [STL](../../mechanical/e73-fit/yeti60-e73-bottom-m01.stl)：只增加内部开关地板避空，保留原外形边界及八处受保护嵌件支撑。
- [验收限值](../../mechanical/e73-fit-spec.json)、[生成／测量证据](../audit/e73-fit-candidate.json)、[实现脚本](../../scripts/build_e73_fit_candidate.py)和 [10 项回归测试](../../tests/audit/test_e73_fit_candidate.py)。

图纸逐项保留 **88 个内部 DXF 实体**：60 个按键／卫星轴轮廓与 28 个安装圆孔。H26 继续不装。外缘至开孔的最小剩余金属为 **1.7498 mm**，高于 1.60 mm 标称设计要求；这只是几何检查，不代表钢板强度或挠曲已验收。

## 尺寸计算

定位板包络在 XY 方向包含 0.10 mm 轮廓误差及 0.10 mm 安装点位误差。为避免多边形弦线低估圆盘，另加 0.0001 mm。装好后的上下表面各须保持在标称 Z 的 ±0.10 mm 内，该总误差同时包含板厚、平面度、安装高度和胶棉压缩。

各接口先测放大后实体与壳体的精确距离，再扣除外壳三轴位移的保守上界 `sqrt(3) × 0.15 = 0.2598076 mm`，以及 0.002 mm 计算保护量：

| 接口 | 放大包络距离 | 扣减后余量 | 要求余量 |
|---|---:|---:|---:|
| 定位板／下壳 | 0.449900 mm | 0.188092 mm | ≥0.15 mm |
| 定位板／上壳 | 0.449900 mm | 0.188092 mm | ≥0.15 mm |
| SW100／修补地板 | 0.656200 mm | 0.394392 mm | ≥0.15 mm |

SW100 的安装高度限值为局部 PCB 下表面以下 **3.60 mm**，包含焊锡和拨杆。该值要求来料与安装后测量，并非声称原厂已保证此上限。向下放大的计算为：

```text
成品 PCB 增厚：1.7600 − 1.6062 = 0.1538 mm
支柱肩及绝缘膜：                   0.0300 + 0.0200 mm
定位板安装表面 Z 总误差：          0.1000 mm
固定后 PCB 额外向下弯曲：          0.1500 mm
开关安装高度超出原 3.50 mm 包络：  0.1000 mm
向下放大合计：                     0.5538 mm
```

SW100 每轴 XY 误差包含 0.10 mm 安装包络增量及 0.25 mm 已安装 PCB 点位误差。避空范围为 X **104.975～119.025**、Y **−127.525～−114.725**、Z **−6.710～−5.400 mm**，圆角半径 0.50 mm，切除体积 **41.9270 mm³**。切除部分至已检查朝下／朝后／端部外表面的距离，扣除外壳三轴误差和计算保护量后为 **10.5604 mm**，高于局部 2.0 mm 要求。此值仅覆盖选取的外表面，不代表全部壳体连接筋、操作孔壁、冲击载荷或树脂强度均合格。

上下层各四片 **33×3 mm** 胶棉，在计入位置与轮廓误差后，仍全部位于定位板及实际上下壳承托面上。下层片材原厚 2.0 mm，上层 1.2 mm；胶棉压力、蠕变及胶粘保持力仍待验收。

## 复现与接入

运行 `uv run --python 3.14.7 --with-requirements requirements-audit.txt python scripts/build_e73_fit_candidate.py`，再用同一环境运行 `tests/audit/test_e73_fit_candidate.py`。主审查也执行这两项。测试会拒绝原版定位板、原地板、过大的内收、偏位胶棉和超高开关；测试通过仅证明报告所列的有界接口。

装配现使用 M01 定位板和底壳引用。正常／校准固件及其校准标识绑定选定定位板、误差限值、机构和叠层规格。指南及四张整机图按这些正式输入重新生成。生成顺序为：原壳／PCB 元数据 → M01 零件 → 选定定位板检查 → 完整标称装配 → 线束／网格／渲染，消除了循环依赖。射频／壳体检查同样读取正式壳体、定位板及完整 1.6 mm 板高。文件名中的 `candidate` 仅为保留既有链接；报告用 `selected_by_assembly` 记录当前选用状态。

[原净空缺口计算](e73-mechanical-tolerances.zh-CN.md)有意检查保留的 M01 前定位板和原地板，作为回归证据，不是当前装配结果。整块 PCB 取出、柔性检修运动、其他零件公差、实收 NiZ／卫星轴尺寸，以及电气／充电／射频实测仍未完成。参见[完整 E73 审查](../audit/e73-review.zh-CN.md)。
