wZuck/YETI60/docs/engineering/e73-mechanical-tolerances.zh-CN.md

[English](e73-mechanical-tolerances.md) | 简体中文

# E73 M01 前公差缺口回归

本页保留 **M01 前**定位板／地板缺口诊断。E73 现在选用 [M01](e73-mechanical-fit-candidate.zh-CN.md)，放大的定位板／开关包络已通过。以下数值有意重现旧缺口，用来防止回退，不是当前正式装配的净空。

[原版诊断](../audit/e73-tolerance-diagnostic.json)使用实际定位板外缘分别测量上下壳，并用 E73 的 SW100 包络测量底壳。计算方式为：

`乐观剩余间隙 = 实测标称间隙 − 已知方向性误差之和`

`最少还需增加的净空 = max(0, 0.15 mm − 乐观剩余间隙)`

0.15 mm 是项目预留要求，不是制造商保证。以下只是已知误差小计，未纳入尚未量化的项目，不能当成完整最坏情况验收。

| 接口 | 标称间隙 | 已知误差 | 剩余间隙 | 未计未知项前至少还需增加 |
|---|---:|---|---:|---:|
| 定位板／上壳 | 0.2500 mm | 0.15 mm 壳壁局部误差＋0.002 mm 轮廓近似误差 | 0.0980 mm | 至少 0.0520 mm |
| 定位板／下壳 | 0.2500 mm | 同上 | 0.0980 mm | 至少 0.0520 mm |
| SW100／底壳地板 | 0.4100 mm | 0.1538 mm 成品板增厚＋0.03 mm 支柱肩＋0.02 mm 绝缘膜＋0.15 mm 地板误差 | 0.0562 mm | 至少 0.0938 mm |

板厚增量为 **1.7600 − 1.6062 = 0.1538 mm**，保留 JLC 普通板厚 1.44—1.76 mm 范围及 PCB 顶面固定的基准。不能把 CAD 实际板厚四舍五入成 1.6 mm 来少计误差。

定位板加工与定位、安装 XY 平移／旋转、Z 高度设置及胶棉顺应性仍未量化。SW100 还需包含焊锡和拨杆的最大安装高度、固定后 PCB 弯曲，以及完整检修孔净空。这些与当前为正的孔位／螺钉余量是不同检查。实收 NiZ N+ 卡扣、轴座下裙、钢丝弯形、胶碗预压和按键全行程仍需样件确认。

修补定位板外缘定位净空时，保留全部按键／卫星轴开孔及 28 个攻牙轴。先确定开关安装包络，再仅对底壳内部地板避让并检查剩余壁厚。重新生成完整板壳包络及连续安装／检修路径。保留已经做好的 C5 子板，不能靠下移 PCB、挤占电池空间解决不足。

[诊断实现](../../scripts/study_e73_mechanical_tolerances.py)及 [10 项故障测试](../../tests/audit/test_e73_tolerances.py)会拒绝漏计误差、漏掉壳体接口及擅自改为制造放行。测试通过仅代表如实记录了净空不足。[E73 审查](../audit/e73-review.zh-CN.md)仍保留其他装配、USB、电源和实物门槛。

CAD 证据使用 **CPython 3.14.7** 及 `requirements-audit.txt` 重现，审查脚本默认通过 uv 选择该解释器。一次 CPython 3.11 执行产生了两项约 3e-14 mm 的线长差异，其余报告字段及几何完全一致；几何上可忽略，但整份报告哈希会改变。报告与网格生成需使用同一运行环境；更换环境时应重生成受影响证据，不能改写存储的哈希。原生 KiCad 导出及 Blender 使用各自声明的运行环境。

[正式 M01 修补](e73-mechanical-fit-candidate.zh-CN.md)现已用放大的安装零件包络通过三个接口检查。M01 现已被装配及校准输入正式选用，本页仍有意保留原缺口诊断。
