wZuck/YETI60/docs/engineering/battery-pack-specification.zh-CN.md

[English](battery-pack-specification.md) | 中文

# YETI60-BAT-1600-1S 电池包供方图纸与验收规格

本文件用于定制单电芯保护包的审查与询价，每把键盘 1 包。尚无供方接受该规格，也未授权下单。受控输入为[装配规格](../../mechanical/assembly-spec.json)、[连接规格](../../mechanical/interconnect-spec.json)、[充电计算](power-budget.zh-CN.md)与[电池研究](battery-study.zh-CN.md)。

## 电芯及完整包络

参考电芯为 Honcell HCP404074，数据表日期 2024-04-01，标称 3.7 V；按表内测试协议最低 1600 mAh、典型 1620 mAh。这是电芯参考，不是已验收的成品电池包。表内 0.2C=270 mA、1C=1350 mA 与容量标注矛盾，采购前必须取得更正数据或签署澄清；不能自行将其改写为已确认的 320／1600 mA 限值。[制造商数据表](https://www.honcell.com/Public/Uploads/uploadfile/files/20240401/DATASHEETHCP4040743.7V1600mAhCELL2024.pdf)

**完整成品包不得超过 85×43×4.8 mm**，须包含保护板、温度保护、热敏电阻、焊片折叠、包覆、绝缘、胶粘剂、应力释放及规定寿命／增长条件。必须计入原电芯的交付及循环后厚度余量，不能随后追加。供方须确认包含焊片及折弯的全长；裸电芯外形不是成品包外形。提交正投影尺寸图、公差及保护板／焊片／传感器最厚处剖面、可拆取表面、重量和出线基准。

电池在壳体中的名义边界为 `[228.5,-149,-9.4]` 至 `[313.5,-106,-4.6]` mm。外壳不缩放，不能夹压软包。槽底到电池仅有名义 0.20 mm，总计用于固定胶、绝缘及装配余量；凹槽已包含在正式底壳中。

## 电气与温度要求

| 项目 | 所需答复／验收 |
|---|---|
| 充电协议 | 单节锂离子、名义 4.2 V 恒流／恒压；供方须接受 BQ24074 **4.16／4.20／4.23 V 最小／典型／最大**稳压范围，并与更正后的电芯绝对电压、保护阈值核对 |
| 连续充电能力 | 在获准实际温区内至少 **500 mA**；这是待确认要求，不是已获得的供方额定值。充电器计算最大 445.63 mA，另有 450 mA 编程工程上限 |
| 终止电流 | R56=1.69k／1%，USB500 计算为 16.87／22.94／29.26 mA；供方须接受完整协议，并在配置计时内验证实际终止 |
| 容量 | 明确电芯及成品包的测试温度、倍率、截止电压和充电稳压值；1600 mAh 标注不能证明充电器 4.16 V 低端仍可交付 1600 mAh，须单独表征 |
| 独立温度保护 | 无主控或第三线温度反馈也能断充；计入传感器／芯片误差及热延迟后，实际允许充电窗口必须落在 **15…43°C** 内，名义目标 **18…40°C** |
| 独立温度反馈 | 第三线采用电气特性兼容 **10k 103AT-2** 的热敏电阻并与电芯热耦合；提供阻温表、25°C 阻值／B 值公差、贴附图；厚度不足时选薄型兼容件，不能在包络外突出珠体 |
| 保护电路 | 提供原理图、精确保护芯片／开关管／传感器型号、电压／电流／温度阈值、最坏误差、延迟、恢复条件以及随电压／温度变化的漏电 |
| 证据 | 签署的更正限值、完整包图、容量／充电曲线、温度断充与恢复记录和生产检验标准 |

独立保护与 BQ24074 反馈需要**分开的感温安排**。未经电路验证，不能把保护电路分压接到 BQ 热敏节点上，其偏置会改变测温结果。仅有过压过流保护的保护板或两线电池不满足温度要求，充电芯片的结温调节也不能替代电芯温度保护。[TI BQ24074 SLUS810N 电气特性及 9.3.5／9.3.7 节](https://www.ti.com/lit/ds/symlink/bq24074.pdf)

## 线束及装配接口

每包使用 PHR-3 插壳 1 个、SPH-004T-P0.5S 端子 3 个，AWG28 多股铜线，绝缘外径不超过 0.8 mm。1 红色正极、2 黑色负极、3 黄色 NTC 接负极。图纸须同时标明**针号、卡扣与观察方向**，不能仅凭颜色。引线、插壳及端子已包含在电池包数量中，不再另购重复计数。[JST PH 图纸](https://www.jst.com/wp-content/uploads/2025/06/ePH.pdf)

电池局部原点为完整包络的最小 X／Y／Z 角。应力释放面的目标出线基准为 **[0,14,4.4] mm**，朝 -X；三个针端点沿 Y 偏移 +2／0／-2 mm。这是需要供方签署确认的工程接口要求，出线绝缘仍须处于 4.8 mm 全包厚度内。逐根自由长度和壳体坐标路径见[连接检查报告](../audit/yeti60-interconnects.json)；长度定义为出线面之间的绝缘长度，不是压接下料长度。自由长度名义公差为 ±0.5 mm，同时必须预成形并固定在控制路径内，不能仅凭长度判定可装。供方须接受选定的不小于 4 mm 静态弯曲半径及不小于 5 mm 的包端过渡区，不能弯压电芯焊片或拉扯焊点。

## 验收顺序

连接前核对供方签图、极性、热敏阻值和完整包络。先用电池模拟器验证充电器，再对合格电池记录开机配置 USB500、关机 USB100 两种状态的完整恒流／恒压、终止及计时行为，覆盖获准输入电压、系统负载和温度。验证独立高低温断充及恢复，记录合壳后的充电芯片／电芯温度。使用普通固件，断开 USB 与调试器，测关机漏电、容量和电池侧电流。首件实测与验收仍未完成，计算不能替代实物记录。
