wZuck/YETI60/variants/raytac/hardware/usb-short-route/BATTERY-SERVICE.zh-CN.md

[English](BATTERY-SERVICE.md) | 简体中文

# 低矮 SH 三针电池接口与插拔范围

采用指定的 **SHR-03V-S 无凸耳胶壳，宽 4.0 mm**。目录中的 **SHR-03V-S-B 带凸耳胶壳宽 6.0 mm**，未包含在当前胶壳包络中，不能未经单独适配检查就替换。[JST 胶壳尺寸表](https://www.jst-mfg.com/product/pdf/eng/eSH.pdf)

**SH 三针修订已完成成套资料检查。** 原生电气、制造回读、配套两版固件、装配、连续刚体插拔、线束资料和渲染已一并重验。供方、板厂和实物验收仍按下文要求执行；这不是量产放行。

J2 改用 **JST SM03B-SRSS-TB(LF)(SN)**、**SHR-03V-S** 和三颗 **SSH-003T-P0.2-H** 端子。这是 **SH、1.0 mm 间距**，与旧的 2.0 mm PH 接口不能互插。位置为 **PCB X 155.5／Y 129.0 mm，0°，B.Cu**。1 脚仍接保护包正极，2 脚负极，3 脚接相对负极的 NTC。板框、感应焊盘、安装轴线和 28 套实装五金保留。

## 为什么更换接口

原 PH 胶壳沿轴线拔出时会碰到 H8 五金和底壳。首次向前移位修补了插拔通道，并通过严格原生电气检查，但完整 PH STEP 实体仍与底壳相交 7.341 mm³，因此没有发布该移位稿。旋转 PH 插座又引入其他原生铜间距冲突。低矮 SH 三针方案在保留三根线和外壳外形的同时消除高度冲突。

[JST 对 SH／AWG28 标示额定 1 A、间距 1.0 mm](https://www.jst-mfg.com/product/index.php?lang=2&series=231)，[SH 图纸](https://www.jst.com/wp-content/uploads/2025/06/eSH.pdf)的侧插安装高度为 2.95 mm。本项目充电编程最坏值为 445.63 mA，另设 450 mA 工程上限。标称负载与额定值比较不能验收故障电流持续时间、触点温升或保护性能，电池包及短路条件仍须验证。

插座在 PCB 下方的安装验收包络为 3.20 mm，包含焊接高度；这是来料／装配限值，不是新增的原厂保证。标准 KiCad 模型及五个焊接落脚均与替换后的原生铜焊盘核对。[重放模板](battery-service-j2.json)保留来源和原理图路径，[修补约束](../../scripts/usb_short_battery_service.py)列出各处原生接线。

## 电气及制造修改

BAT_CELL、GND、BAT_NTC 仍接原编号引脚。邻近 APLEX_EN_PIN_0 经两颗孔径 0.30／焊盘 0.50 mm 普通贯通孔转入 In2.Cu，两面盖油。当前候选板共 815 个过孔，不引入盲埋孔、填孔或特殊 JLC 工艺。当前 PCB 与制造文件必须成套使用，旧 PH 焊盘和旧固件不代表本次修订。

主板插座仍是一颗实装器件，主板总数保持 75 件、计划抵扣库存 8 件、净补购 67 件。保护电池包包含一个 SH 三针胶壳和三颗 SH 端子，优先由供方压好。整机 USB／电源／电池合计使用 15 颗 SH 端子，其中两条互连线用 12 颗，电池包自带 3 颗。极性仍须供方编号图和逐针通断核实。

## 线束及插拔检查

SH 三针出线基准为 **外壳坐标 [155.5，−124.425，−3.60] mm**。插头端间距 1 mm，保留的电池主干路线和电池包出线端间距为 2 mm。受控扇出采用 4 mm 半径，前进距离为 `sqrt(4*4*1 - 1)＝3.872983 mm`，之后才改变高度。1／2／3 脚的起点 X 分别是 154.5／155.5／156.5 mm。USB 和板上电源跳线保留。

采用更新后的[关壳自由线长](CLOSED-CASE.zh-CN.md)：三根电池线标称约 **114.92／111.61／108.63 mm**，不是裁线长度。每根自由长度容差 ±0.5 mm，并须按受控路线预成形。理线件位置及电池包端的出线间距保留，真实线材弯曲限值、压接及固定仍需供方证据。

[连续刚体运动检查](audit/plug-motion.json)覆盖 J2／J4 胶壳，以及标称、1.44 和 1.76 mm 板厚。拔出采用完整的 ＋Y 方盒扫掠，与插座包络最终至少分离 0.50 mm；反向也覆盖刚体插入。胶壳计入 0.25 mm 安装余量，并保留有意接触的 PCB 安装基面。原 PH 对 H8 及底壳的阻挡保留为回归证据。

此检查不验收手指／工具、摩擦锁插拔力、自身导线变形、散放插头或带线抬升组件。[JST 操作说明](https://www.jst-mfg.com/product/pdf/eng/handling_e.pdf)要求支撑／握持胶壳，并给导线留出操作余量。遵守[检修边界](SERVICE-PATH.zh-CN.md)、当前[电池供方清单](../../docs/build/battery-vendor-checklist.zh-CN.md)及[开台测试](../../OPEN-BENCH.zh-CN.md)。PCB 指纹变化后，两版固件须重建，并重新采集阈值。
