wZuck/YETI60/variants/raytac/hardware/usb-short-route/POWER-LAYOUT.zh-CN.md

[English](POWER-LAYOUT.md) | 简体中文

# 电源区域重布局与验证

J2 现为 SH 三针插座，PCB 坐标 [155.5，129.0] mm、0°、B.Cu；[原生修补及线束扇出](BATTERY-SERVICE.zh-CN.md)覆盖旧 PH 位置／接口。

当前 U5 焊盘／钢网及 U5／U6 阻焊岛以[封装与普通工艺修订](PACKAGE-MODELS.zh-CN.md)为准；正反面均遮孔，旧的背面开放孔说明已作废。

本页适用于本目录的 USB 修补候选板。原有 U6 输出／反馈和 C46 线路绕过感应接地保护铜条，保守接触铜线长度分别约 29.183 mm 和 28.504 mm；本次移动完整稳压区域并重布充电电容。反馈缩短为 3.555 mm，C46 缩短为 4.681 mm。下表十条局部路径均在元件所在的 B.Cu 完成。

**布局设计检查通过，实物稳定性未验收。** 严格原生检查为 0 错误、0 断线、0 原理图不一致，411 组焊盘连接通过。102 条缺少封装外框的警告只属于非采购感应／机械图形；没有铜箔毛刺、实装封装外框重叠或悬空走线警告。[几何报告](audit/geometry-check.json)另行记录按层合并的地铜连通检查与移动器件的装配间隙。以上不能证明环路稳定性、纹波、USB 眼图、温升或电池充放电实测通过。

## 元件位置

坐标为 KiCad 原生毫米坐标和角度，全部在背面；不是镜像后的焊接视图。电气值和引脚分配保持不变，七颗电源电容继续使用 [0805 采购规格](PASSIVES.zh-CN.md)。C32 不在本次移动区域，仍为（346.4，118.0）mm、90°。旧定位图不能用来寻找下面的移动元件。

| 位号 | X（mm） | Y（mm） | 角度（°） |
|---|---:|---:|---:|
| C40 | 122.0 | 146.9 | -90 |
| C41 | 113.0 | 143.7 | 180 |
| C42 | 121.9 | 142.7 | 0 |
| C43 | 132.0 | 136.5 | 0 |
| C44 | 137.0 | 139.8 | 0 |
| C45 | 132.5 | 143.3 | 0 |
| C46 | 136.0 | 144.0 | 0 |
| L1 | 128.5 | 141.5 | -90 |
| R45 | 124.5 | 136.0 | 0 |
| R46 | 137.0 | 135.0 | 0 |
| R47 | 136.6 | 136.5 | 0 |
| U6 | 133.0 | 140.8 | 0 |

## 局部铜线约束

长度按相互接触的完整铜线对象求和，是保守几何量，不是传播延迟或回路电感。路径接触一个过孔对象不代表切换层；C46 路径接触一个同层节点过孔，但走线仍全在 B.Cu。最大长度和最小线宽是项目设计检查门槛，不是 TI 对稳定性的保证。

| 起点 → 终点 | 长度／上限（mm） | 最小线宽／要求（mm） |
|---|---:|---:|
| U6.4 → L1.1 | 2.829 / 4.0 | 0.300 / 0.300 |
| U6.2 → L1.2 | 1.759 / 4.0 | 0.300 / 0.300 |
| U6.5 → C43.1 | 3.454 / 4.0 | 0.250 / 0.250 |
| U6.8 → C44.1 | 2.334 / 3.0 | 0.200 / 0.200 |
| U6.1 → C45.1 | 1.519 / 3.0 | 0.250 / 0.250 |
| U6.1 → C46.1 | 4.681 / 8.5 | 0.200 / 0.200 |
| U6.1 → U6.10 | 3.555 / 5.0 | 0.200 / 0.200 |
| U5.13 → C40.1 | 3.276 / 4.5 | 0.300 / 0.300 |
| U5.2 → C41.1 | 3.384 / 4.0 | 0.250 / 0.250 |
| U5.10 → C42.1 | 2.242 / 4.0 | 0.300 / 0.300 |

39 组移动器件检查覆盖标称及允许的 PCB 厚度。保守包络与原外壳最小间隙约 0.756 mm，与安装五金约 0.245 mm，与电池包约 31.875 mm。这里改变了 PCB 厚度，没有叠加全部横向贴装、孔位与树脂公差；0.245 mm 不能当作最终装配公差验收。

## 普通通孔与焊接

继续使用 JLC 普通四层 FR4、成品厚度 1.6 mm。相对上一版电容修改稿，新增 9 个普通贯通孔、删除 4 个无用过孔、移动 3 个过孔，电源检查点为 813 个过孔；当前 [SH 三针电池修订](BATTERY-SERVICE.zh-CN.md)再增加 2 个，合计 815 个；精确坐标、孔径与网络见[机器约束](power-layout.json)。新增孔盘／孔径均为 0.50／0.30 mm，不要求盲埋孔、树脂塞孔、电镀填孔或盖帽。

C43 地端、U6 PGND 和 GND 接至本地散热地；C45 使用邻近地过孔。补上了 U5.8 到 U5 散热地的连接，修复原先分裂的地铜；独立检查按各层实际填铜分别合并，仅通过地通孔／镀孔焊盘连接层间，不能因为同属一个铺铜对象就视为导通。

L1 两焊盘之间增加 B.Cu 禁铜区，约 X=126.8～130.2、Y=141.1～141.9 mm，禁止走线、过孔和铺铜。这是本项目的中央焊盘间隙约束。L1 采购型号仍为 Würth 74438336015，实际为 WE-MAPI 3020、1.5 µH，器件最大外形 3.2 × 3.2 × 2.0 mm；原生封装名中保留的 `3015` 是历史技术标识，不是采购尺寸。参见[厂商图纸](https://www.we-online.com/components/products/datasheet/74438336015.pdf)。

## 感应与首板检查边界

感应电极、螺孔、外形与引脚分配保持原位置。为避开新增 U6 通孔，局部调整 F.Cu 的 ROW_DRV3、CHG_EN1 和 In1.Cu 的 ROW1；CHG_N 内层连接也已重布并修平尖角。因此不能把“电极不动”写成“正面全部铜线不动”。实际寄生参数、扫描噪声和逐键校准仍需首板。

本次关闭的是旧电源长绕线的设计问题，不是生产验收。原制板压缩包仍属于旧布线，不可据本页下单。完整关壳检修路径、实际线材、电池供方确认和实物测量另见[候选总入口](README.zh-CN.md)。无需外壳的首板测试按[开台步骤](README.zh-CN.md#焊接及裸板测试顺序)，仍必须准备保护电池包、定位板、NiZ 轴座／滑块、胶碗和弹簧。
