wZuck/YETI60/variants/raytac/hardware/usb-short-route/SERVICE-PATH.zh-CN.md

[English](SERVICE-PATH.md) | 简体中文

# 检修路径：翼板已修补，连接线束仍待验收

[SH 三针电池修订](BATTERY-SERVICE.zh-CN.md)替换 PH 接口，并对 J2／J4 增加连续刚体插拔检查；工具接近、释放后的导线运动、散放插头及带线抬升组件仍需另外验收。

**关壳检修尚未放行。** 当前候选底壳已修补原来的右侧翼板阻挡。连续标称刚体取出检查通过，前提是 USB 和电池线已断开，散开的插头已放在运动包络之外。这不能证明在装好的外壳内可以完成断开操作。

[验证脚本](../../scripts/check_usb_short_vertical_motion.py) · [运动证据](audit/vertical-motion.json) · [壁厚及嵌件保护](audit/closed-assembly.json)

## 已落实的几何修改

- SW100 底部凹槽和 C04 内收定位板见[当前机械适配](MECHANICAL-FIT.zh-CN.md)。凹槽位于内部，保留原外形和操作孔；八条有尺寸的安装垫片替代原料托盘示意。

- 新增圆角半径 0.5 mm 的内部避空，范围 X 357.25～365.25、Y −132.75～−113.75、Z −4.45～12.30 mm，切除定位板承托保护区之外的右侧台阶。原外形边界坐标及嵌件支撑体积保持不变。计入三处新增避空，所检查的剩余壁厚扣除既有 0.15 mm 外壳公差后至少为 2.01 mm；这不代表原壳每一处壁厚都合格。
- 后部 USB 路径改为 Y −100.80 mm。顶挂夹 USB-R1／R2／R3 及其压线膜，朝前／朝后半宽为 2.35／2.70 mm。前侧槽壁标称最薄 0.35 mm，扣除打印公差后为 0.30 mm。不要混用旧夹件或旧线长。
- PCB 与后部夹件的扫掠间隙标称 0.75966 mm。扣除 PCB 位置 0.25、外壳 0.15、夹件粘接位置 0.10、打印 0.05 mm 后，余量 0.20966 mm，要求不低于 0.15 mm。这些是必须在实物上测量确认的装配限值。

## 连续检查证明的范围

检查器将 PCB 和定位板的精确平面轮廓沿完整 22 mm 行程拉伸，包含全部中间姿态。保守扫掠包络覆盖 75 个主板实装元件、28 套安装件、随板供电跳线、其两个插头及理线件／压线膜，本版合计 172 个运动包络。供电线按独立几何段取界，避免把低处扇出高度错误投影到高处直线段。标称条件下它们避开底壳及固定理线件实体。

未修补底壳仍与 PCB、模块的运动扫掠相交。回归测试拒绝旧底壳、旧后部夹件及过度削薄的槽壁。连续检查已取代原来的离散姿态诊断。

## 尚未完成的工作

1. 确定 USB J4、电池 J2 的完整退出／插入路径，握住塑料胶壳操作，并保持每根导线的弯曲半径得到支持。侧插退出会改变插头至首个固定夹件的距离与方向，安装姿态不能证明可拆卸。规定检修操作前，还要验证散插头停放及实际工具通道。当前底壳没有发布新增检修孔。
2. [C04 定位板内收及开关底部凹槽](MECHANICAL-FIT.zh-CN.md)已在给定误差限值内通过这些界面的有界几何检查，包含定位板连续取出。[原方向性诊断](TOLERANCES.zh-CN.md)保留为修补前基线。其他元件公差、按键机构、泡棉和完整带线检修仍待验收。
3. 最终运动／首件检查仍需包含合格的 NiZ 轴座、键帽、胶碗、卫星轴，导线回弹及粘接保持力。PCB／定位板／电子元件的扫掠没有证明这些依赖实物的运动包络合格。

继续暂停制造放行。[候选入口](README.zh-CN.md) · [装配指南](ASSEMBLY.zh-CN.md) · [修订路径](CLOSED-CASE.zh-CN.md)
