wZuck/YETI60/variants/raytac/hardware/usb-short-route/WIRE-QUALIFICATION.zh-CN.md

[English](WIRE-QUALIFICATION.md) | 简体中文

# 线材资格：具体料号尚未确定

本页的 4 mm 弯曲半径约束针对关壳线束。无外壳首板可以按[首板入口](FIRST-ARTICLE.zh-CN.md)采用松散线圈和至少 10 mm 的设计弯曲半径，并让所购线材满足相应供方参数；这不放行当前关壳线材，也不证明完整 USB 链路合格。

关壳路径要求 AWG28 多股铜线、兼容 SH 的统一绝缘外径 0.5～0.8 mm，以及允许不大于 4 mm 的静态弯曲半径。这是设计要求，不是实购导线已经取得的合格证明。参见[路径几何](CLOSED-CASE.zh-CN.md)及[供电核算](POWER-FEED.zh-CN.md)。

## 已研究的料号

[Alpha Wire 2842/19 原厂规格](https://www.alphawire.com/disteAPI/SpecPDF/DownloadProductSpecPdf?productPartNumber=2842/19)第 2、5 页列出 AWG28、19/40 镀银铜、PTFE 绝缘外径 0.027 ±0.002 英寸、20°C 标称直流电阻 58 Ω／1000 英尺，以及十倍线径的弯曲半径。

```text
最大外径 = 0.029 × 25.4 = 0.7366 mm
标称直流电阻 = 58 / 304.8 = 0.19029 Ω/m
按最大外径要求的弯曲半径 = 10 × 0.7366 = 7.366 mm
```

**该型号不能用于当前 4 mm 的关壳路径。** 外径虽合适，原厂弯曲要求却不满足。标称电阻也不能证明采购要求的电阻上限或高温性能。它是单芯导线，不能证明组装后 USB 对线的阻抗。

## 选定前需要的证据

取得准确线材结构、最大外径、规定温度下的静态弯曲许可、电阻随温度变化，以及与指定 JST 端子、压接工具的兼容性。用成品样件检查压接拉力、成形后的回弹、绝缘损伤及实测回路电阻；完整 USB 链路另行验收。如果没有供方支持的导线满足 4 mm 路径，就按最终线材重画理线件和路径，重新检查间隙、自由长度、压降及检修运动。

本页没有批准线材采购。裸板测试时的松放线长不能证明关壳装配合格。[候选入口](README.zh-CN.md) · [装配指南](ASSEMBLY.zh-CN.md)
