wZuck/YETI60/variants/raytac/hardware/usb-short-route/TOLERANCES.zh-CN.md

[English](TOLERANCES.md) | 简体中文

# 壳体公差问题与修补要求

**C04 修补前的基线诊断。** 下表记录原定位板和开关底部为什么需要修补；[当前 C04 定位板、底部凹槽及有界适配结果](MECHANICAL-FIT.zh-CN.md)已取代这三处基线余量问题。整键盘／实物验收仍待完成；仍可进行[无外壳首板验证](FIRST-ARTICLE.zh-CN.md)。

[测量证据](audit/tolerance-diagnostic.json) · [复现 CAD 检查](../../scripts/study_usb_short_tolerances.py) · [检修路径](SERVICE-PATH.zh-CN.md)

## 测得的限制界面

检查器依据实际定位板 DXF，在安装高度 Z 4.2062～5.8062 mm 重建定位板外周侧面，再分别测量其与上、下壳 STEP 的距离。下壳结果还与完整标称取出检查交叉核对。外周测量不含内部轴孔和安装孔，不能替代完整定位板检查。SW100 底部距离和最近点来自完整取出报告。

| 界面 | 标称间隙 | 已量化公差小计 | 乐观剩余间隙 | 达到 0.15 mm 余量至少还需增加的间隙，**未计未知项** |
|---|---:|---:|---:|---:|
| 定位板定位耳／上壳 | 0.2500 mm | 壳壁 0.1500 mm＋弦误差 0.0020 mm | 0.0980 mm | ≥0.0520 mm |
| 定位板定位耳／下壳 | 0.2500 mm | 壳壁 0.1500 mm＋弦误差 0.0020 mm | 0.0980 mm | ≥0.0520 mm |
| SW100／底壳地板 | 0.4100 mm | 0.3538 mm | 0.0562 mm | ≥0.0938 mm |

这些数值是**乐观的方向性小计**，并非完整最坏情况分析。0.15 mm 是项目设计余量，不是厂商或 IPC 保证。即使改按 0.10 mm 余量，SW100 的小计仍不足。余量不足本身并不等于已经证明实物一定碰撞。

定位耳的限制壳壁在**上下两片壳体中都存在**。一组最近点位于 X 307.2877／307.5377、Y −200.8097、Z 4.79 mm 附近。仅修改底壳射频翼板避空，不能解除上壳这一处限制。

## 计算方式与未计项目

每个界面按具体限制方向作公差算术和；不能用统计均方根保证彼此独立的允许最坏情况能装入。下列数值来自[装配规格](../../mechanical/assembly-spec.raytac.json)和[普通 PCB 工艺参数](../../mechanical/pcb-fabrication-spec.json)。

CAD 外周离散采用 0.002 mm 弦误差上限，装配报告中也有记录；这项同样消耗间隙。定位耳先算 `0.25 − 0.15 − 0.002 = 0.098 mm`，尚未加入定位板外周切割尺寸／位置偏差、装好的定位板 XY 位移／转动，以及垫片柔顺性。实际定位板公差和安装位置限值尚未验收，不能默认都是零。0.15 mm 壳体偏差按朝向限制壳壁的方向使用，不宣称它能约束任意三维树脂收缩。

SW100 的计算先固定定位板标称高度：成品 PCB 增厚时，板底向下移动。CAD 成品板厚包络为 **1.6062 mm**，普通工艺接收上限为 **1.76 mm**。因此：

```text
PCB 板底向下增加量 = 1.76 − 1.6062 = 0.1538 mm
已知公差小计 = 0.1538 + 支柱 0.03 + 绝缘片 0.02 + 底面 0.15
             = 0.3538 mm
乐观剩余间隙 = 0.4100 − 0.3538 = 0.0562 mm
```

这里不能把 1.6062 舍入成 1.6。虽然标称板间距为 4.6 mm，仍须加入支柱 0.03 mm 和绝缘片 0.02 mm 公差；不要再把单列的 0.05 mm 堆叠余量加一次，造成同一误差重复计算。

SW100 尚未计入定位板安装 Z／垫片变化、板翘、开关安装高度和焊接离板高度。现有开关 3.5 mm 包络仍是暂定值。[C&K JS102011SAQN 原厂图，第 4 页](https://www.littelfuse.com/assetdocs/littelfuse-c-k-slide-js-series-datasheet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)提供标称尺寸，并未证明本装配的安装高度上限已经合格。不能仅根据标称图缩小包络，或将高度公差当作零。

## 修补及验收顺序

1. 与定位板／外壳供应方确定可测量的定位板外周及安装 XY／Z 限值。应包含最远定位耳处的转角影响、板翘、焊接离板高度和垫片压缩，装配后实际检查。
2. 修改**上下两片壳体**的定位耳侧壁，或修改定位板定位结构并保留键位和安装孔中心。额外侧隙至少为 `0.052 mm＋定位板外周／安装位置等误差项`。保留垫片承托面、嵌件支撑和 FELK60 原外形。只削 0.052 mm 不能算完成修补。
3. 对 SW100 下方避空，或采用重新完整计算的堆叠结构。若有保证的器件最大尺寸，以及受控的焊接／拨柄安装包络，也可据此采用较小开关包络，但必须重新计算整项公差。沿用当前包络时，额外底部间隙至少为 `0.0938 mm＋定位板向下位置／安装高度／板翘等误差项`。同时检查局部外壁余厚、现有操作孔和螺丝支撑。本保留基线不包含修补后的底部 STEP，请使用当前机械适配入口。
4. 依据修补后的几何重新生成壳体／定位板、连续取出检查、全部元件／紧固件／线束检查及图纸／渲染。按批准的限值完成整套公差分析，并纳入实际 NiZ／卫星轴／键帽和插头带线检修路径。
5. 测量首件。CAD 间隙不证明树脂强度、胶粘保持力、导线回弹或按键全行程合格。

以上通过前，当前 PCB 和电池按文档使用带绝缘的无外壳夹具验证。连接实物电池之前，仍须完成供方电池确认。本诊断没有改变 PCB、USB、固件设计及已生成的制板文件。
