wZuck/YETI60/variants/raytac/hardware/usb-short-route/F1-SELECTION.zh-CN.md

[English](F1-SELECTION.md) | 简体中文

# 主板 F1：选定保险丝与修订焊盘

本修补候选板购买 **Littelfuse 0466001.NRHF，1 只**：1206／3216 封装、**1 A、63 V、一次性快断**。[原厂资料](https://www.littelfuse.com/assetdocs/fuse-466-datasheet?assetguid=dbe9bcd7-6072-4adf-bf5b-d33e52a6b90f) · [立创商城 C151135](https://www.lcsc.com/product-detail/Fuses_Littelfuse-0466001-NRHF_C151135.html)。可另买 2 只备件；没有分配库存抵扣。它**仅在本修补候选方案中**替换原来未指定料号的 0.5 A 自恢复保险丝，F1 不能照旧主板材料表购买。

F1 用于次级故障保护，输入电流仍由 BQ24074 和固件的 USB100／USB500 策略控制。1 A 保险丝不代表允许从 USB 取 1 A。熔断后须先排查故障再更换，拔插不会使它复位，不能用导线短接替代。C5 保留自己的上游保险丝和保护元件。

## 为什么选这个电流档

2023 年 6 月版原厂资料给出 70°C 下连续工作的降额示例：

```text
连续工作允许值 = 额定电流 × 0.75 × 0.80
1.00 A 型号：允许 0.600 A，高于配置后的 USB 0.500 A 上限
0.75 A 型号：允许 0.450 A，低于 0.500 A
0.50 A 型号：允许 0.300 A，低于 0.500 A
```

这是原厂针对快断保险丝的标称降额因子，不是本板实测限值，也不是自恢复保险丝的曲线。此设计筛查要求实测 F1 局部环境不超过 70°C。原来的通用自恢复规格没有合格的温度／电阻约定。选定型号标称冷态电阻为 **0.075 Ω**，不是原厂最大值；500 mA 时对应约 37.5 mV 压降、18.75 mW 损耗，尚未计电阻升高。额外线束／触点损耗见[修订供电核算](POWER-FEED.zh-CN.md)。

原厂 25°C 动作时间表规定：两倍额定电流时最长 5 s，三倍时最长 0.2 s。它不能证明与 C5、主机端口或电池保护器的选择性配合，也不表示恰好 1 A 就会熔断。浪涌、高温和故障仍需夹具测试。输入保险丝不能替代保护电池包及其独立温度断充。

## 原生 PCB 的修改

F1 仍在背面 B.Cu，PCB 坐标 **(88.609827, 114.198524) mm，90°**。第 1 脚仍为 USB_5V，第 2 脚仍为 VBUS。原理图改用一次性保险丝符号；原生板和冻结封装库均使用 `Fuse_Littelfuse_0466_1206__F1`。

原厂回流焊图给出焊盘总外跨度 0.150 英寸、内间隙 0.060 英寸、宽度 0.080 英寸。从这些尺寸推导，避免把四舍五入后的毫米标注继续累加：

```text
焊盘长度 = (0.150 − 0.060) / 2 × 25.4 = 1.143 mm
焊盘宽度 = 0.080 × 25.4 = 2.032 mm
中心位置 = ±(0.150 + 0.060) / 4 × 25.4 = ±1.3335 mm
```

原来的 1.25 × 1.75 mm 圆角焊盘已换成上述矩形焊盘；重新填铜，并重跑严格 DRC 和连接检查。原孔位和感应位置保持不变；当前候选版另有[七颗电源电容焊盘修订](PASSIVES.zh-CN.md)及[完整电源区域移动](POWER-LAYOUT.zh-CN.md)，不能把本页的 F1 修改范围当作全部板级修改。保险丝最大本体为 3.302 × 1.651 × 0.660 mm，加上记录的位置／焊接余量后仍在原来更大的 F1 净空包络内。提供的[标称 STEP 包络](models/Littelfuse_0466001_NRHF_nominal.step)使用正确标称尺寸，端头细节和材质仍为示意。

## 安装与验证

1. 按[焊接及开放台架顺序](README.zh-CN.md#焊接与开放台架顺序)，使用本候选板修订的 F1 焊盘和一次性保险丝。检查焊接及电阻时断开电池与 USB。
2. 核对供方料号、顶部代码 H 和实际封装。测电阻时，对独立零件采用四线法；25°C 冷态来料目标不超过 0.10 Ω。普通两线万用表的表笔电阻不能证明这个小阻值合格。
3. 用限流夹具验证带载高温电阻目标不超过 0.15 Ω、局部温度、USB 配置、边充边输入及浪涌。这些电阻是规定的来料／测试限值，不是原厂保证最大值。
4. 熔断后先排查再换件。电源／C5／保险丝／线束配合，以及真实 USB／蓝牙／充电行为，仍属于实物验收项目。

[零件约定](parts-qualification.json) · [修订补购表](mainboard-purchase.zh-CN.csv) · [装配指南](ASSEMBLY.zh-CN.md) · [候选方案入口](README.zh-CN.md)
