wZuck/YETI60/variants/raytac/hardware/usb-short-route/PASSIVES.zh-CN.md

[English](PASSIVES.md) | 简体中文

# 阻容采购规格——修订后的 Raytac 候选板

按下表规格自行选择品牌和供应商即可。这里的 **0402、0603、0805 均为英制封装**，分别对应公制 1005（1.0 × 0.5 mm）、1608（1.6 × 0.8 mm）、2012（2.0 × 1.25 mm），不要误买公制 0402。数量是一块主板的实装数量，不含备件及另行规定的 C5 子板材料。[完整采购表](mainboard-purchase.zh-CN.csv)另含芯片、插座等：主板实装 75 件，计划使用库存 8 件，补购 67 件。

本次修改了七处电源电容及原生焊盘，只适用于本目录的[候选 PCB](EC60-nRF52840.kicad_pcb)。旧制板压缩包和旧焊接位置图不含这些修改。通用阻容不限定品牌；芯片、模块、保险丝、电感和插座继续按完整表中的型号及引脚选购，封装相似不代表可以互换。

**电源长绕线已修补：**完整稳压区域及充电电容已重布，反馈和 C46 保守走线长度分别为 3.555 mm、4.681 mm；十条局部路径均留在 B.Cu。原生 DRC 和按层地铜连通通过。位置、普通散热通孔与检查边界见[电源布局](POWER-LAYOUT.zh-CN.md)，实物稳定性仍须首板验证。

## 电容

均使用无极性陶瓷贴片电容。下表耐压是最低要求；标注两种介质时，X5R、X7R 均可，不能用 Y5V/Z5U。购买更高耐压的器件也要满足后面的有效容量要求。

| 位号 | 实装数量 | 库存／补购 | 容量 | 封装 | 耐压 | 容差 | 介质 |
|---|---:|---:|---|---|---|---|---|
| C9、C11、C12 | 3 | 3／0 | 100 nF | 0402 | ≥16 V | ±10% | X7R |
| C10 | 1 | 0／1 | 220 pF | 0402 | ≥25 V | ±5% | C0G/NP0 |
| C13 | 1 | 1／0 | 1 µF | 0402 | ≥10 V | ±10% | X5R/X7R |
| C30 | 1 | 0／1 | 10 µF | 0603 | ≥10 V | ±10% | X5R/X7R |
| C31 | 1 | 1／0 | 100 nF | 0402 | ≥16 V | ±10% | X7R |
| C32 | 1 | 0／1 | 4.7 µF | **0805** | **≥16 V** | ±10% | X5R/X7R |
| C40 | 1 | 0／1 | 2.2 µF | **0805** | **≥25 V** | ±10% | X5R/X7R |
| C41、C42、C43、C45、C46 | 5 | 0／5 | 22 µF | **0805** | ≥10 V | ±20% | X5R/X7R |
| C44 | 1 | 0／1 | 100 nF | 0603 | ≥16 V | ±10% | X7R |
| C47 | 1 | 0／1 | 10 nF | 0402 | ≥16 V | ±10% | X7R |
| C48 | 1 | 1／0 | 1 µF | 0402 | ≥10 V | ±10% | X5R/X7R |

计划使用库存的八件器件中，六件是电容：四颗 Samsung CL05B104KO5NNNC、两颗 CL05A105KA5NQNC。后者实际耐压为 **25 V**，高于表中的 10 V 最低要求，见 [Samsung 原厂规格](https://product.samsungsem.com/mlcc/CL05A105KA5NQN.do)。装配前核实实际库存数量与外观。C30 仍是 3.3 V 模块附近的补充储能，不把它计入 C45/C46 的稳压输出有效容量。

七处新 0805 电容的瓷体最大外形（含尺寸容差）为 **2.2 × 1.45 × 1.45 mm**。冻结焊盘为 0.9 × 1.2 mm、中心位于 ±0.95 mm，安装方向按原生 PCB。无须额外 PCB、填孔或特殊 JLC 工艺。

## 有效容量与 USB 输入电容预算

以下为**本项目的选型目标**，不能推断任意通用电容都满足，也不是已经实测通过稳压器稳定性。关键电源位置需检查所购器件的直流偏压曲线，并计入初始容差、温度和老化。筛选公式为：`筛选容量 = 标称容量 × 对应偏压下的保留比例 × 容差系数 × 0.85 × 0.90`。0.85 为 X5R/X7R 温度变化留出余量；0.90 是项目老化预留，不能当作所有厂商保证的寿命指标。若器件规定的老化更差，应使用更差系数。仅有典型曲线时，计算属于选型筛查，首板还要测启动和纹波。

| 位置 | 计算偏压 | 筛选结果最低要求 | 用途 |
|---|---:|---|---|
| C32 | 5.25 V | ≥2.2 µF | USB 电源局部旁路，含项目余量 |
| C40 | 5.25 V | ≥1.0 µF | 充电芯片输入旁路 |
| C41 | 4.23 V | ≥4.7 µF | 电池端旁路 |
| C42、C43 | 4.50 V | 每颗 ≥4.7 µF，合计 ≥9.4 µF | 系统输出及升降压芯片局部输入 |
| C45、C46 | 3.60 V | 每颗 ≥5.0 µF，合计 ≥10 µF | 3.3 V 稳压器局部输出 |

TI 对 BQ24074 的 BAT/OUT 建议标称 4.7–47 µF，对 IN 建议 1–10 µF，见[原厂引脚说明](https://www.ti.com/lit/ds/symlink/bq24074.pdf)。C41 为 22 µF，C42＋C43 为 44 µF，均在上述标称范围内。TPS63031 的电容选型节建议标称输入不小于 4.7 µF、输出不小于 10 µF，允许增加输出容量；VINA 建议 0.1 µF、最大 0.22 µF，因此 C44 保持 100 nF，见[原厂 §9.2.2.3](https://www.ti.com/lit/ds/symlink/tps63031.pdf)。上表有效容量是项目额外的设计余量。

3.60 V 是项目采用的保守电容筛选偏压，不是 3.3 V 标称输出，也不是假设稳压器只有 ±2% 误差。TPS63031 原厂电气特性表对省电模式给出相对 3.3 V 最高 +6% 的范围，因此不能只按 3.366 V 筛选该模式。

可参考但**不强制购买**的例子：TDK [C2012X5R1A226M125AB](https://product.tdk.com/en/search/capacitor/ceramic/mlcc/info?part_no=C2012X5R1A226M125AB)、[C2012X5R1C475K125AC](https://product.tdk.com/en/search/capacitor/ceramic/mlcc/info?part_no=C2012X5R1C475K125AC)、[C2012X5R1E225K125AC](https://product.tdk.com/en/search/capacitor/ceramic/mlcc/info?part_no=C2012X5R1E225K125AC)。原厂参考曲线说明：不同耐压和结构的器件，容量下降程度并不一样。有些 10 µF／10 V／0603 在约 4 V 偏压下会损失大部分标称容量，只改采购表上的容量数字并不能解决问题。

直接挂在 USB_5V 上的 C32＋C40 为**标称 6.9 µF，按初始正容差 10% 为 7.59 µF**。这只是主板两个电容在未计偏压前的小计，**不等于 USB 主机看到的全部电容**。还应加入 C5 保护、模块内部旁路及其他直接相连的电容，检查接入浪涌；充电芯片软启动不能隔离并联的 C32/C40。实际接入电流与 USB 信号质量仍须实测。本次增容不改变 USB100/USB500 输入电流策略。

## 电阻及状态灯

全部实装电阻均为 **0402**，额定功率不小于 **0.0625 W（1/16 W）**、耐压不小于 **50 V**、容差 **±1%**、温度系数不大于 **100 ppm/K**。下表写的是阻值，不是丝印编码；0402 本体经常没有字。更高功率只在实际外形仍是 0402 时可用。充电、电流限制和定时电阻保持 ±1%，不要换成邻近的 E24 阻值。

| 位号 | 实装数量 | 库存／补购 | 阻值 |
|---|---:|---:|---|
| R3、R4、R5、R6、R7、R47、R53、R54 | 8 | 0／8 | 100 Ω |
| R8–R16、R18–R21、R23–R25、R42–R46、R48–R50 | 24 | 0／24 | 100 kΩ |
| R17 | 1 | 1／0 | 1 kΩ |
| R26 | 1 | 1／0 | 10 kΩ |
| R32 | 1 | 0／1 | 2.2 kΩ |
| R40 | 1 | 0／1 | 2.21 kΩ |
| R41 | 1 | 0／1 | 7.50 kΩ |
| R51、R52 | 2 | 0／2 | 1 MΩ |
| R55 | 1 | 0／1 | 69.8 kΩ |
| R56 | 1 | 0／1 | 1.69 kΩ |

若自行焊接 C5，另备 **两颗 5.1 kΩ、±1%、0402 电阻**，功率 ≥1/16 W、耐压 ≥50 V，分别用作 CC1/CC2 下拉。这两颗已在独立的 [C5 材料表](../bom/daughterboard.zh-CN.csv)中抵扣库存，不计入上述主板 75 件。C5 保护器件、USB-C 插座、SH 插座及保险丝继续按该表采购。

R17/R26 使用库存 Uniroyal 0402WGF1001TCE／0402WGF1002TCE。**R30/R31 已移除，采购和实装数量都是零。** JP1 保持开路。

D2：一颗普通 **0603 绿色 LED**，不带控制芯片，最大外形 **1.8 × 1.0 × 1.0 mm**；在约 0.4–0.7 mA 下有可见亮度，0.5 mA 时正向压降不高于 2.4 V。R32 是外部限流电阻。原生焊盘 1 为阴极／GND，2 为阳极／LED_A；应核对供应商极性图，不要仅凭外观标记判断。状态灯不限定品牌。

## 焊接与验证变化

C32 仍在原生坐标（346.4，118.0）mm／90°。C40／C41／C42／C43／C45／C46 已随电源区域移动，精确位置见[完整电源位置表](POWER-LAYOUT.zh-CN.md#元件位置)；全部为 B.Cu，不能使用旧位置图。

沿用[候选板装配顺序](ASSEMBLY.zh-CN.md)：电源级阻容与 U5/U6 一起焊接，随后再装模块和模拟部分；检查新焊盘与无电短路情况，限流启动后测 USB／电池供电下的 3.3 V 纹波与负载变化，再复测边充电边 USB 枚举、断开及重连。DRC、连通性、主机固件测试和几何检查不能测出真实模拟稳定性、充电温度或实际电容特性。

[机器可读电源阻容约束](power-passives.json)记录容量、位置、焊盘与保守最大外形。原生检查还会将中英文采购表全部 75 件器件的设计值与新导出网表比较，并检查电阻、电容封装一致性。
