wZuck/YETI60/variants/raytac/hardware/usb-short-route/POWER-FEED.zh-CN.md

[English](POWER-FEED.md) | 简体中文

# 修订 USB 供电路径：压降验收

新增的 J5 → J1 跳线为充电供电路径增加两条导线和两个插接连接器，必须结合最终导线与主板保险丝验证。AWG28 导线在几何上放得下，不代表能够维持完整充电电流。[可复现计算](../../scripts/calculate_usb_short_feed.py)和[计算数据](audit/feed-budget.json)使用新的关壳线长。

正负回路为 C5 SH → J4 → J5 → J1。刻意保守地采用黑色跳线回流时，四条导线合计约 1.0533 m，不含压接内部延长段。四条自由长度各计 +0.5 mm 后，本模型使用 1.0553 m。该模型计入八个载流接触对。原生 PCB 地平面也连接 J1／J4／J5 的地，与黑色供电跳线并联；计算刻意忽略此并联路径，不表示八个接触对实际都流过相同电流，也没有求解 PCB 电流分布。[JST SH 原厂资料第 1 页](https://www.jst-mfg.com/product/pdf/eng/eSH.pdf)规定接触电阻初始最大 20 mΩ，环境试验后最大 40 mΩ。

```text
回路电阻 = 各导线长度 × 每米电阻之和 + 8 × 单个接触电阻
压降 = 输入电流 × 回路电阻
线束损耗 = 输入电流² × 回路电阻
```

采购敏感性计算暂设导线目标：20°C 时不超过 0.25 Ω/m，60°C 时不超过 0.30 Ω/m。**这是建议验收限值，不是已经取得的线材厂数据。** 高温导线目标叠加环境试验后的接触电阻限值，得到回路约 0.637 Ω、500 mA 时压降约 0.318 V。尚未计入额外压接长度／电阻、外接 USB／C5 上游损耗及主板保险丝／铜线，成品回路实测必须覆盖这些项目。不能把本计算当成未指定实购线束的保证上限。

[F1 已选定](F1-SELECTION.zh-CN.md)：Littelfuse 0466001.NRHF，1 A 一次性快断保险丝，焊盘已按原厂图修改。0.075 Ω 是 25°C 冷态标称电阻；0.15 Ω 热态带载电阻是要求实测达到的目标，不是原厂保证上限。把这些数值加入导线／触点模型，得到以下 500 mA 筛查结果。冷态列混合了 20°C 导线目标与保险丝 25°C 标称值，只用于敏感性计算，不是某个工作点的实测。

| C5 SH 板上焊盘电压 | 初始线束＋冷态标称 F1 后 | 高温／环境后线束＋热态目标 F1 后 |
|---:|---:|---:|
| 4.75 V | 4.501 V | 4.357 V |
| 5.00 V | 4.751 V | 4.607 V |
| 5.25 V | 5.001 V | 4.857 V |

表中仍未计 PCB 铜线及额外压接损耗。[BQ24074 原厂资料 N 版第 12 页电气表](https://www.ti.com/lit/ds/symlink/bq24074.pdf)规定 USB 输入动态功率管理阈值最小／典型／最大为 4.35／4.5／4.63 V。用 4.63 V 做保守的**维持完整输入电流的余量筛查**，不能当作器件绝对工作截止电压。5.00 V 时，高温／环境后场景在计入 PCB 损耗之前已经低于该筛查值约 23 mV；4.75 V 时，初始场景也低于该值。输入动态功率管理可能降低充电电流，所以设置的充电电流不等于保证的实际充电速率或充满时间。1 A 保险丝不改变 USB100／USB500 电流策略。

首件验收前需要：

1. 在修订焊盘上安装已选定的一次性 F1，按 [F1 验收要求](F1-SELECTION.zh-CN.md)检查来料身份、电阻、局部温度、浪涌与故障保护配合。料号及标称降额计算已经确定，实物验证仍未完成。
2. 向线束供方取得导线电阻随温度的变化及成品压接／回路电阻，保持规定外径与弯曲几何。
3. 用电池模拟器和正常系统负载，在 USB100 和完成枚举后的 USB500 下测量 C5 SH、J1 输入、U5 IN／OUT 与主控 VBUS。完整测试包含外接 USB 数据线和 C5 保险丝。
4. 验证充电及限流时仍稳定经 USB 输入，并测试挂起、拔插和仅电池蓝牙。不能通过绕过保险丝或调高 USB 电流策略掩盖压降。

保险丝已选定，最终线材、成品回路与保险丝实物验证仍未完成。本计算没有声称实物已经工作。[装配指南](ASSEMBLY.zh-CN.md) · [候选方案入口](README.zh-CN.md)
