wZuck/YETI60/variants/raytac/hardware/usb-short-route/fabrication/drill-report.txt

Drill report for EC60-nRF52840.kicad_pcb
Created on 2000-01-01T00:00:00

Copper Layer Stackup:
    =============================================================
    L1 :  F.Cu                      front
    L2 :  In1.Cu                    in1
    L3 :  In2.Cu                    in2
    L4 :  B.Cu                      back

Drill file 'EC60-nRF52840-PTH.drl' contains
    plated through holes:
    =============================================================
    T1  0.300mm  0.0118"  (212 holes))
    T2  0.400mm  0.0157"  (603 holes))
    T3  2.200mm  0.0866"  (3 holes)  (with 2 slots)

    Total plated holes count 818

Drill file 'EC60-nRF52840-NPTH.drl' contains
    unplated through holes:
    =============================================================
    T1  0.750mm  0.0295"  (2 holes))
    T2  0.900mm  0.0354"  (2 holes))
    T3  2.200mm  0.0866"  (26 holes))

    Total unplated holes count 30
