wZuck/YETI60/docs/audit/e73-review.zh-CN.md

[English](e73-review.md) | 简体中文

# E73 完整方案审查——2026 年 11 月 12 日

下列测量对应正式选定的 M01／PH 主板。后续独立 USB／SH 三针修补检查点记录在本页末尾，不能代替完整复查，也没有关闭整机门槛。

**结论：暂停设计放行。** DRC 和 ARM 构建通过，不能消除已测得的 USB 保护支路问题、PH 电池插头检修干涉及完整机械公差验收缺口；NiZ／钢板卫星轴几何与 M01 局部修补现已同步。使用[制作／审查入口](../../BUILD.zh-CN.md)和[机器可读门槛](e73-readiness.json)。已经做好的 UDB-C-JSH C5 子板保持不变。

本轮实际执行结果：基础资料审查 **63／63 项通过（含指南重生成）**；随后完整复查的 **13／13 个执行步骤成功**，包含 28 个模拟前端 SPICE 灵敏度场景、射频／USB／插拔检查和故障测试。见[本轮复查记录](e73-review-run.json)。命令使用 `--require-design` 返回 **2**，因为测得的设计失败项和未完成门槛仍存在；执行成功不是设计放行。

## 已通过的检查

- E73 引脚分配、全部 43 个厂商焊盘、21 个 GPIO 功能、USB／SWD／电源及五个实际连接的底部焊盘相符。严格原生检查为零错误、零未连接，270 组信号／电源连接及**额外 142 组接地连接**均接通。102 项边界告警来自保留的非实装图形；隐藏焊点仍需实物检查。
- 普通四层 1.6 mm PCB 使用机械贯通孔，无盲埋孔和模组盘中孔。板框、孔位检查通过，制造 DFM 需单独确认。
- E73 正常版和校准版 ARM 固件已重建，核对内部 RC 低频时钟、REG1 LDO、NFC GPIO UICR 和链接后的 500 mA USB 配置，并保留设置分区。尚无实物 USB／BLE 运行测试。
- 充电控制改为同步处理 USB 配置、复位、挂起及取消配置事件。`SET_CONFIGURATION(0)` 不会保留充电许可，充电控制不再等待扫描轮询。11 个测试在 ASan／UBSan 下使用完整的固定版本 ZMK USB 回调，包括初始化、启用和 GPIO 写入故障。E73 特有的 **GPIO1.13 CE_N** 通过独立的 GPIO1 测试设备验证；USB HID 优先切换仍在系统工作队列中串行执行。
- 当前源文件的天线工程检查带内，铜与金属定位板投影均已清空。保留的 Ebyte 来源没有数字化主板净空要求，所以末端 3 mm 仍是临时工程检查区，不能代替距离或抗干扰验收。
- 原参考方案的七线安装路径、标称 PCB／外壳叠层、安装中心、电池包包络和壁厚检查通过。修订后的 NiZ 定位板保留 60 个感应中心，安装 28 套固定件并留空 H26；供方外形、完整检修运动及实物全行程尚未验收。

- E73 的扫描、GPIO、校准 CRC、NVS 恢复及按键流水线回归已针对重新构建的正常版／校准版通过。[当前固件证据](../testing/e73-firmware-validation.zh-CN.md)说明 308 字节记录迁移、受保护的蓝牙恢复手势及模型边界；实物模拟信号／时序裕量仍待测量。

## 设计发现与修补顺序

| 优先级 | 发现 | 修补／验收要求 |
|---|---|---|
| P1 | 主板 TVS 支路为 **29.7482／37.5611 mm**，超过项目设定的 5 mm 目标。J1 至模组路径为 **254.5547／257.8642 mm**，分别经过 **4／6 个过孔**。 | 修订 E73 主板 USB 路由、保护拓扑和参考回流，保留现有 C5，重新生成原生、制造、固件和装配文件。上述几何数值不是 USB 合规测试。 |
| P1 | 原 PH 电池胶壳的标称连续拔出路径与 **H8 相交 6.0978 mm³**，与**底壳相交 23.0639 mm³**；只检查插入后的静态位置没有碰撞。 | 修订 E73 接口高度、位置及插拔通道，重算电池出线点、弯曲半径和理线件。不能未经 E73 走线及几何检查直接照搬 Raytac SH 三针位置。 |
| 仅标称 CAD | 已同步 NiZ、1.6 mm 定位板、三组卫星轴及 28 套固定件；PCB 原 H26 孔保留，但不装五金。 | [定位板契约](plate-mount.json)检查 60 个感应中心及真实 DXF 开孔；完整标称叠层通过。NiZ N+ 塑料件、钢丝弯形、卡扣和全行程仍需局部实物确认。 |
| 局部配合通过；完整公差未关闭 | 正式 M01 在规定误差下，两处定位板／壳体剩余净空均约 0.1881 mm，SW100／地板约 0.3944 mm，高于 0.15 mm 局部要求。 | [正式 M01 修补](../engineering/e73-mechanical-fit-candidate.zh-CN.md)已接入装配、图纸、渲染和固件校准指纹。八处胶棉承托与八处嵌件保护通过；其他元件、安装五金、NiZ／卫星轴行程、完整检修及强度公差仍未关闭。[修补前公差计算](../engineering/e73-mechanical-tolerances.zh-CN.md)保留用于回归。 |
| P1 | Raytac 改进后的局部电源布局、封装落点／阻焊／钢网和九线检修证据尚未全部移植。 | 针对 E73 检查 U5／U6 电源回路、完整封装尺寸、电容降额、普通散热孔的锡膏／阻焊及电池接口净空。网络接通不代表这些项目已验收。 |

测量来源：[USB 路径](USB-signal-paths.json)、[PH 连续插拔](e73-service-motion.json)、[标称装配](yeti60-assembly.json)、[USB 事件测试](usb-event-policy.json)、[完整文件检查](outcome.json)。来源哈希及逐项门槛见 [e73-readiness.json](e73-readiness.json)。

## 供应商与实物验收

仍需电池：带保护的单节 4.2 V 锂电包、1600 mAh 规划容量、完整包络 85×43×4.8 mm、第三根 NTC 线。电芯规格勘误、独立充电温度保护、电压／截止／恢复保证及完整包图纸尚待供应商确认。充电电流计算为标称 402.71 mA、最坏 445.63 mA，不能代替温升和保护动作验收。使用[电池包规格](../engineering/battery-pack-specification.zh-CN.md)。

设计收尾后，先获得板厂 DFM，再检查首板。开台验收包括电源轨、USB 各状态、充电与 USB HID 同时工作、USB／BLE 切换、逐键校准、60 键按下／释放、存储写入断电、温度中断及相应放电限值。完整关壳还需柔性线束／工具检修通道、NiZ／卫星轴实际行程、树脂／嵌件公差和射频／静电容检查。当前没有把任何上述实物项目记为通过。

## 复现方式

使用 KiCad 和 CAD Python 环境运行 `scripts/run_audit.py`；`scripts/test_yeti60_usb_events.py` 使用固定的完整上游回调。运行射频／USB 提取脚本、`scripts/study_e73_service.py`，再运行 `scripts/review_e73_readiness.py`。审查会写入明确的暂停放行结果及失败／未完成门槛；使用 `--require-design` 时，只要仍有未解决项就返回非零。测试程序执行成功不等于方案验收通过。

## USB 修补阶段记录

[E73 独立 USB 修补候选](../engineering/e73-usb-repair.zh-CN.md)已提供自身的原生工程、原理图／网表、采购差异及故障检查。短数据线拓扑与上文正式方案测量分开；[主板参考面及局部模型阶段记录](../engineering/e73-usb-return.zh-CN.md)补充了原生铜箔、电镀接地及焊脚落点检查。[局部匹配度检查](../engineering/e73-usb-local-fit.zh-CN.md)增加候选内部底面修补，以及计入有界公差、按顺序进行的 J5/J4 刚性胶壳拔出检查。[SH 三针电池修补](../engineering/e73-battery-service.zh-CN.md)独立核对 E73 原生重连、五处模型焊脚和 J2 刚性插拔，并由 M03 合并两处内部凹槽。制造放行、完整信号完整性、柔性线束／完整检修验收，以及配套固件／制造文件仍未完成。
