wZuck/YETI60/docs/audit/2026-10-28-feasibility-assessment.zh-CN.md

[English](2026-10-28-feasibility-assessment.md) | 简体中文

# YETI60 P2 键盘方案可行性与元件匹配评估

> 本文是当日 Raytac 基线评估。E73 当前引脚、固件与验证状态见[模组方案](../engineering/module-options.zh-CN.md)，E73 不可使用旧模组引脚编号。 其中 1.2 mm／29 套固定件机构也已由[当前 E73 NiZ 规格](../build/key-mechanism.zh-CN.md)替代。

评估日期：2026-10-28。对象：当前工作目录中的 YETI60 P2，基线提交 `39ae3cc59d0e98faf3aea6630d677b6c8c9ea990`，结合本次工作树。本文是设计评估，不是生产放行文件。

## 1. 结论

**方案在系统架构和静态电气连接层面可行，值得继续制作受控工程样机；目前不宜直接按“已完成产品”批量采购和生产。** 核心 IC 的功能、电压与接口总体匹配；主要未闭环项集中在定制电池、按键机械套件、特殊制板工艺、被动器件具体型号及实物性能。

该方案不是普通 MX 键盘：它组合 EC60 静电容电极、60 键 HHKB 机构、单颗 nRF52840 的 USB/BLE 控制，以及 FELK60 派生树脂壳。元件名称相近、孔位相同或检查脚本通过，都不能单独证明整机兼容。

用一句话概括：**做一台能工作的工程样机可行；按当前文件直接投产不可行。**

| 维度 | 评估 | 判断依据 |
|---|---|---|
| 系统架构 | 可行 | 主控同时承担扫描、USB 和 BLE；独立充电与升降压电源链合理 |
| 核心电子元件 | 总体匹配，附带条件 | 3.3 V 逻辑与模拟前端协调，封装及关键引脚有 CAD 契约；实际波形及降额待测 |
| PCB 可制造性 | 有条件可制造 | 需要支持指定非对称四层 HDI、微盲孔和盘中孔盖铜的板厂 |
| 机械与按键配套 | 部分匹配 | 壳板几何有证据；完整轴座、胶碗、弹簧和稳定机构尚未定型 |
| 电池与充电 | 关键条件未闭环 | 定制包图纸、原厂电流资料矛盾、独立温度保护和完整充电均待验收 |
| 固件 | 可生成目标产物，整机待验证 | 普通版／校准版产物检查及主机模拟通过，实机 USB/BLE 与逐键校准未完成 |
| 功耗与续航 | 可估算，未证实 | 已实现空闲降速、AFE 门控和 REG1 DC/DC；深度睡眠因 EC 键无可靠唤醒而关闭；106.64 小时仍是保守规划点 |
| 采购与复制 | 尚未冻结 | 多个阻容、连接器及机械件未完成最终料号或供方确认 |

不使用综合百分制评分：当前缺少实物数据和采购报价，数字评分会掩盖尚未解决的必要条件。

### 1.1 阶段放行判断

| 阶段 | 判断 | 依据 | 建议动作 |
|---|---|---|---|
| 架构／概念 | 通过 | 单主控、EC 模拟前端、USB/BLE、充电与升降压链路完整；原理图和 PCB 契约检查通过 | 保持当前架构 |
| 受控工程样机（1–3 台） | 有条件通过 | 静态电气、CAD 和固件产物证据齐备；电池、按键机构和特殊制板未闭环 | 先做电源板、局部按键样件，再装整机 |
| 小批试产（10–30 台） | 未通过 | 62／76 个焊装件尚无可下单 MPN；电池、HDI、机构未签图 | 关闭第 8 节 A 类风险后再评估 |
| 量产 | 不通过 | 无实物测试、寿命、认证和供方产能证据 | 不在本次评估范围 |

这张表比“可行／不可行”更重要：当前方案已经跨过“画得出来、连得通、能生成固件”的门槛，但还没有跨过“买得齐、装得上、测得完”的门槛。

## 2. 范围、证据和验证边界

本次阅读当前原理图／网表、PCB 检查数据、BOM、目标固件、机械装配规范、STEP 几何审计、功耗与电池资料，并执行 `python3 scripts/run_audit.py`。验证结果见第 9 节。未重新构建 ARM 固件、未重新渲染摄影图；流水线检查现有目标产物与来源的一致性，复跑主机模拟及 CAD/工程检查。

直接证据优先于 README 结论：

- [原理图与导出一致性](schematic-current.json)、[严格 PCB 检查](../../hardware/ec60-nrf52840/audit-current.json)、[电气路径检查](yeti60-electrical.json)。
- [主板 BOM](../../hardware/bom/mainboard.zh-CN.csv)、[机械及采购要求](../engineering/materials.zh-CN.md)、[装配规范](../../mechanical/assembly-spec.json)。
- [装配检查](yeti60-assembly.json)、[电池槽检查](yeti60-battery-pocket.json)、[目标固件检查](yeti60-target-check.json)、[功耗计算](yeti60-power-budget.json)。
- 第 10 节列出的原厂资料，本次联网核对；库存、报价、交期和供应商量产能力未核实。

开始评估时已有 `EC60` 子模块工作树修改，以及未跟踪的 `mechanical/interconnect-spec.json`、`docs/audit/yeti60-interconnect-connectors.json`、`scripts/check_yeti60_interconnects.py` 和 `scripts/interconnect_geometry.py`。本文没有修改这些内容。前两项给出的 J1／J2 焊盘刚性匹配结论可作为参考，但这套线束检查尚未接入 `run_audit.py`，本次普通 Python 环境也因缺少 OCP 未能复跑，因此不计入第 9 节的通过结论。自动检查覆盖范围见脚本和各 JSON 的 `scope`／`limits` 字段。

## 3. 系统架构可行性

信号链为：GPIO 行驱动 → EC 电极／锥簧 → 两颗 74HC4051 → OPA350 → nRF52840 SAADC → ZMK USB/BLE HID。电源链为：后置 USB-C 子板 → 主板保护与 BQ24074 → VSYS → TPS63031 → 3.3 V；电池接入 BQ24074 电源路径。U8 管理模拟前端供电，U7 管理电池测量分压。

单主控避免双 MCU 的通信与启动同步问题，功能数量与现有引脚分配相符。MDBT50Q 模组也减少裸芯片射频匹配工作。但它没有消除天线净空、整机射频验证、模拟噪声和校准工作。EC60 上游几何的保留降低了重新设计感应电极的风险，不能证明更换主控、ADC、叠层及机械组合后仍具有相同触发特性。

**判断：架构没有明显的功能性缺口；最终成败更取决于扫描裕量、供电噪声和机械预压的一致性。** 仓库将 SI/RF 分析列为延期项，本次不声称完成该分析。

## 4. 元件匹配矩阵

“匹配”表示功能和名义规格合理，不表示已取得实物验收或所有焊盘的原厂尺寸签核。

| 元件／组合 | 当前配置 | 匹配程度 | 条件、风险与建议 |
|---|---|---|---|
| U1 主控 | Raytac MDBT50Q-1MV2 | 高，待整机验证 | nRF52840 提供 USB、BLE、GPIO 与 SAADC；扫描接模组 pin20/P0.04/AIN2，电池接 pin21/P0.05/AIN3。严格区分芯片天线版与其他模组变体，并复核原厂天线净空 |
| U2/U4 复用器 | 74HC4051PW，TSSOP16 | 高，动态待测 | HC 支持当前低压逻辑；不能因名称相近直接换 HCT。3.3 V 下导通电阻、寄生电容和通道切换残留需结合实际 EC 波形验收 |
| U3 模拟放大 | OPA350UA，SOIC-8 | 功能高，功耗代价大 | 支持 3.3 V 单电源和快速 ADC 驱动；R16/R17 对应名义增益 101，JP1 不装。需确认不饱和、建立时间和噪声裕量；不能直接用 OPA2350 或不同封装替代 |
| U5 充电／路径 | BQ24074RGTR，VQFN16 | 功能高，电池条件未闭环 | 适合 1S 4.2 V 和 USB100/500；须焊接散热焊盘，验证热限流、计时、终止及电池温度窗口 |
| U6/L1 稳压 | TPS63031DSKR + 1.5 µH 74438336015 | 名义匹配 | 单节锂电跨越 3.3 V，采用升降压合理；固定输出料号正确。电感值及两颗 10 µF 输出电容与原厂典型应用方向一致，但尚不能证明环路、纹波及轻载表现 |
| U7/U8 负载开关 | TPS22919DCKR，SC70-6 | 合理 | 分别切换电池分压和前端，减少无效负载。需实测上电稳定、关断残压及 GPIO/ADC 反灌；不能把逻辑关断当作整机零功耗 |
| USB 数据链 | C5 JSH + J1 + D1 + R30/R31=0 Ω | 电气契约匹配，装配待验收 | 四针 1 VBUS／2 D−／3 D+／4 GND；nRF PHY 已有终端，保留零欧链接。子板 SH 模型 Y 偏移已由 +2.425 mm 修正为 −1.45 mm，避免本体后移 3.875 mm；仍是几何修正，不是插入力或信号完整性验收 |
| J1 插座 | 继承 1.0T-4P 焊盘，候选 SM04B-SRSS-TB | 焊盘匹配，装配待验收 | 补充检查显示 4 个信号焊盘和 2 个固定焊盘与 JST 标准封装仅差 **0.0625 mm 刚性平移**；仍需核对本体高度、插入方向、保持力和试插。该补充检查未接入统一审计 |
| J2 电池接口 | S3B-PH-SM4-TB，三针 PH | 焊盘匹配，线序自定义 | 3 个信号焊盘和 2 个固定焊盘与 JST 标准封装零平移；pin1 正极、pin2 负极、pin3 NTC，供方必须按针号签图。市售三线电池不能仅凭插壳相同直接插入 |
| 电池包 | 定制 1600 mAh，85×43×4.8 mm | 几何有条件匹配，采购未匹配 | 包络必须包含保护板、NTC、极耳折弯、绝缘与寿命增长，不能用裸电芯尺寸代替；独立温度保护为必要条件 |
| 电容、电阻 | 0402/0603，多数未定 MPN | 规格框架合理，采购不完整 | 220 pF 用 C0G；电源电容需用最终型号的偏压曲线验算有效容量，额定 10 µF 不等于工作时仍有 10 µF |
| F1/D2 | 0.5 A 自恢复保险丝／0603 LED | 待最终选型 | F1 保持电流、热降额及电阻影响 USB 压降；LED 正向压降影响实际亮度及电流，不能按外形任意替代 |
| 60 套 EC 按键机构 | Topre 兼容 HHKB 轴座／胶碗／锥簧／键帽 | 尚未形成完整采购匹配 | 应使用同源套件，核对 6U 空格、宽键轴座及稳定机构。NIZ、Topre、MX 转换滑块不能未经验证混装 |
| 定位板与支柱 | 1.2 mm 钢板 + 29 个定制支柱 | CAD 匹配，制造较复杂 | M2 上牙／M1.6 下牙并非普通 M2 隔离柱；需专门加工、攻丝、绝缘和螺纹验收 |

主板 BOM 为 **76 个焊装元件，JP1 不装**；PCB 的 74 个可选电极位置、固件 75 个扫描位置和实际 60 键不是同一计数。子板作为成品另计，不能遗漏，也不要把其散件再重复算入成品采购。

### 4.1 元件匹配覆盖率

按“是否已有可下单的原厂型号”分级，而不是按元件是否常见分级：

| 等级 | 含义 | 元件数 | 占比 | 包含 |
|---|---|---:|---:|---|
| A | 原厂型号明确，封装／引脚有契约 | 13 | 17.1% | D1、J2、L1、SW1、SW100、U1、U2/U4、U3、U5、U6、U7/U8 |
| B | 有候选型号，焊盘或装配待试配 | 1 | 1.3% | J1 SM04B-SRSS-TB |
| C | 仅有规格值，尚无 MPN | 62 | 81.6% | 43 个电阻、17 个电容、F1、D2 |
| 合计 | — | **76** | 100% | JP1 为 DNP，不计入 |

按 BOM 行统计：36 行中 11 行 A、1 行 B、24 行 C（含 1 行 DNP）。**覆盖率低不等于方案不可行**：62 个 C 类中 60 个是通用阻容，真正的选型风险集中在 F1 的保持／动作电流与 USB 压降、D2 的正向压降与亮度，以及这些阻容在偏压、温度和容差下的实际值。反过来，A 类也不等于已验收：U1 的订货后缀与天线版本、U5 的散热焊盘、U6 的环路补偿仍要按实物确认。

### 4.2 数量契约

| 项目 | 数量 | 说明 |
|---|---:|---|
| 原理图元件记录 | 178 | 含电极符号、电源符号等，不等于焊装件 |
| 主板焊装元件 | 76 | JP1 默认不装 |
| PCB 电极焊盘 | 74 | 继承 EC60 的可选布局位置 |
| 固件扫描矩阵 | 5×15＝75 | 每帧扫描全部 75 个位置 |
| 实际安装按键 | 60 | HHKB 定位板与键位映射 |
| PCB／定位板安装中心 | 29 | 两套几何匹配 |
| 实际引脚连接对 | 270 | 连通回归检查 |

**74、75、60 不能互相替代。** 74 是可用电极焊盘，75 是固件扫描位置，60 是本次安装键数；多出的位置不证明多出按键，也不代表可以少校准。首件仍须逐键校准并确认未安装位置不会产生误触发。

## 5. 关键定量分析

### 5.1 供电容量充足，效率和散热尚未证明

规划 3.3 V 电流为 11.39 mA，压力情景为 17.69 mA；从额定输出能力看，TPS63031 不构成当前负载瓶颈。更值得关注的是轻载效率、开关噪声进入扫描前端以及最差电容降额，而不是追求更大额定电流。

按名义充电电流 0.403 A，若 USB 为 5 V、电池为 3.0 V，充电通路的粗略线性损耗量级约为 `(5−3)×0.403≈0.81 W`，尚未计系统负载等影响。这是热设计筛查估算，不是结温计算；在树脂封闭壳内必须测 U5 温升和热调节后的实际电流。BQ24074 的热保护不能替代电芯温度保护。

### 5.2 电池与充电是当前最明确的放行阻塞项

R40=2.21 kΩ、R55=69.8 kΩ、R56=1.82 kΩ，计入项目采用的芯片系数和 1% 电阻误差后：

| 参数 | 计算结果 | 评估 |
|---|---|---|
| 充电电流 | 357.06／402.71／445.63 mA | 最大值低于项目包规格 450 mA，但只剩约 4.37 mA 数值余量；450 mA 当前是设计要求，不是供方保证 |
| 最短快充安全计时 | 6.9102 h | 高于按最小设定电流算出的理想 CC 时间 4.48 h，仍不能保证实际完成 CV 收尾 |
| 最大终止电流 | 31.51 mA | 小于按 1600 mAh×0.02C 算出的 32 mA，余量仅约 0.49 mA；须与更正后的供方规格核对 |
| USB500 输入下限预算 | 450−40=410 mA | 40 mA 是整机输入预留假设；高端充电设定可能被输入限制压低，并非持续保证 403 mA |

HCP404074 原厂 PDF 同时给出最低 1600 mAh、0.2C=270 mA 和 1C=1350 mA，倍率与容量不自洽。当前资料不足以把 445.63 mA 充电直接判为“已获电芯认可”。应取得供方更正资料，明确电流、温度、容量测试条件和终止条件，再决定保留设定或降低充电电流。

当前方案要求保护包在 MCU 不工作时也能将实际充电温度约束于 15…43°C，目标窗口 18…40°C。仅有第三线 10k NTC 或普通过压过流保护不能等效满足。完整电池包必须由供方签图，并验证充电、温度断充及恢复行为。[原厂电芯资料](https://www.honcell.com/Public/Uploads/uploadfile/files/20240401/DATASHEETHCP4040743.7V1600mAhCELL2024.pdf)

### 5.3 续航符合“数天”规划，不支持长期待机结论

仓库模型在 80% 可用容量下，规划电池电流 12.003 mA，1600 mAh 对应 **106.64 h，约 4.44 天连续运行**。不同假设得到 57.73～153.01 h，这只是敏感性情景，不是实测范围或保证上下界。

OPA350 典型静态电流 5.2 mA，约占规划 3.3 V 总电流的 **46%**。当前固件已实现空闲 30 ms 扫描、用 U8 门控 AFE，并启用 REG1 DC/DC；但规划表仍按 AFE 连续开启计算，因此 106.64 小时是保守值，没有计入空闲门控收益。`CONFIG_ZMK_SLEEP=n` 仍保留，因为 EC 键不是 System OFF 的 GPIO 唤醒源。若后续目标是数周续航，应先测空闲占空比和首键延迟，再评估低功耗运放或唤醒通道；直接换低功耗运放可能损失建立速度、噪声或稳定性，需重新验证。[OPA350 原厂资料](https://www.ti.com/lit/ds/symlink/opa350.pdf)

### 5.4 扫描可运行，但不能宣称低延迟已经达标

现有时序预算每帧至少 8.32 ms，未计 GPIO、驱动和调度开销，对应理想扫描速率上限约 120 Hz；两帧去抖还会增加确认时间。按键到主机延迟还包括触发相位、USB/BLE 调度，不能把扫描速率当作端到端性能。

SAADC 采用内部参考、1/6 增益和 40 µs 采集；电池 1M:1M 分压配合 10 nF 滤波及 50 ms 稳定等待，名义设计合理。但前端输出幅度、扫描时序、最大源阻抗及每键释放／按下分布需在真板上核验。固件无有效校准时不发按键事件，属于合理的失败保护，也意味着首件必须完成校准流程才可作为可用键盘验收。

### 5.5 关键裕量汇总

| 项目 | 计算值 | 门槛／假设 | 判断 |
|---|---:|---:|---|
| 最大充电电流 | 445.63 mA | 包规格 450 mA | 数值余量 4.37 mA（约 0.97%），名义通过但供方未确认 |
| 最大终止电流 | 31.51 mA | 0.02C＝32 mA | 余量 0.49 mA（约 1.5%），窗口过窄 |
| USB500 最差输入预算 | 410 mA | 最小充电 357.06 mA | 余量 52.94 mA，但 40 mA 整机预留只是假设 |
| 规划 3.3 V 电流 | 11.39 mA | TPS63031 额定能力 | 容量充足；轻载效率、纹波和热未证 |
| 规划续航 | 106.64 h | “数天”目标 | 约 4.44 天，仅为模型点 |
| 扫描帧预算 | 8.32 ms | 约 120 Hz 上限 | 未计 GPIO、驱动、调度和两帧去抖 |
| 最小螺钉径向余量 | 0.0766 mm | 0 | 极紧，必须首件验证 |
| 电池包到元件最小间隙 | 0.555 mm | 0.50 mm | 余量 0.055 mm，不能再叠加未控公差 |
| 槽底剩余壁厚 | 3.6585 mm | 3.0 mm | 几何余量 0.6585 mm，不代表强度认证 |

这张表说明风险不在“额定值是否够大”，而在**窄窗口、未验证假设和不可见公差**。充电终止电流和螺钉间隙都属于“算出来刚好过、实测很容易不过”的项目。

## 6. 机械与制造可行性

### 6.1 壳板能容纳，不等于手感机构已匹配

CAD 装配证据为 1.2 mm 定位板、4.50 mm 支柱加 0.10 mm 绝缘膜、1.59 mm PCB，形成 4.60 mm 板间距；29 个安装中心参与匹配。最差螺钉径向余量约 **0.0766 mm**，不能再无条件叠加未经控制的打印、冲孔、攻丝和装配偏差。

1.2 mm 薄钢板直接攻 M2×0.4，名义仅约三个螺距，且支柱上牙长 1.0 mm。其夹紧力、攻丝质量和重复拆装寿命需要验证；不能因为孔位对齐就认定长期可靠。建议先做包含普通键、宽键及螺柱连接的局部样件，确认轴座卡扣、胶碗预压、全行程及回弹，再定型整套钢板和支柱。

树脂壳采用冷粘嵌件，方向合理；当前缺少最终树脂牌号及缩水、蠕变、拉拔数据。Gasket 50% 压缩量也只是名义装配假设，实际胶棉牌号与硬度会影响板位置和手感。

### 6.2 电池空间余量有限，不能只看壳体不碰撞

当前默认包络计入 XY ±0.40 mm 后，与元件最小间隙 **0.555 mm**；与紧固件名义间隙 **0.700 mm**；槽底扣除公差后的最小壁厚 **3.6585 mm**。这些支持“当前包络放得下”，不支持“任意 1600 mAh 电池可用”。

85×43×4.8 mm 必须是完整最大包络。胶带、边缘保护、焊点、导线出线和可拆卸空间均不能侵占未分配余量。C5 子板安装和线序已有检查，但完整插头、弯折半径、拔插及维修路径尚未验收；150 mm 线长是设计要求，不能当作已验证的线束成品。

### 6.3 PCB 工艺显著超出普通四层打样

当前包含九个 B.Cu↔In2.Cu 的 0.40/0.20 mm 填充整平微盲孔，以及两个 U1 信号盘中通孔填孔盖铜要求。上层感应介质为 0.20 mm，下层激光介质 0.15 mm，成品包络 1.59 mm，不能交由板厂默认对称叠层替换。

静电容电极对介质和加工一致性敏感，需把[制板要求](../../hardware/ec60-nrf52840/fabrication-notes.zh-CN.md)交给板厂进行 DFM，并由贴片厂确认散热焊盘、钢网及模组焊接工艺。若报价或工艺能力不接受当前结构，应视为需要重新布板的工程变更，不能静默改为普通通孔。

## 7. 采购、使用与维护体验

电子核心型号较明确，但阻容具体 MPN、F1、D2、J1 以及树脂／胶棉／按键套件等尚不构成可直接复制的冻结 BOM。主要成本与交期不确定性来自 HDI、定制电池、29 个异径定制支柱、定位板攻丝及成套 EC 机构；没有报价，本文不提供虚构成本或“低成本”结论。

还有几项需要明确接受的使用限制：

- 主板开启时，只有主机接受 500 mA USB 配置后才能快充；仅充电适配器不能完成该枚举流程，当前固件会禁充。
- SW100 关闭后硬件默认 USB100 慢充；开关不隔离电池与所有电源电路，长期收纳仍有漏电和自放电。
- 电量上报暂时关闭；当前不能按完整无线成品的电量体验验收。
- 首次烧录需要 SWD 探针治具，使用前需逐键校准；整片擦除会丢失校准和蓝牙绑定。
- SW100 从底部检修孔用工具操作，维护便利性需实际确认。

这些不推翻架构可行性，但应写入使用说明并纳入样机验收，避免到整机完成后才发现预期不同。

## 8. 风险优先级与建议顺序

以下是评估建议，没有在本次文档任务中修改设计。A 表示采购／制造前须解决的依赖；B 表示整机定型前必须通过的样机验证；C 表示后续体验或成本优化。

| 级别 | 风险 | 最小闭环动作 | 验收证据 |
|---|---|---|---|
| A | 电芯规格及保护条件不明确 | 供方更正电流表，签署完整包络、450 mA 设计上限或调整后的电流、温度窗口及针序 | 有版本的包图、规格及独立温度保护报告 |
| A | 特殊 PCB 工艺不能默认承接 | 锁定板厂，逐项确认叠层、微盲孔和填孔盖铜；锁定贴片工艺 | DFM 回签、叠层图、首板切片／检验要求 |
| A | 按键套件与 Z 结构未定型 | 选同源机构，制作局部板／板间距夹具，验证普通键和宽键 | 尺寸记录、行程／回弹、弹簧定位和预压结果 |
| A | BOM 和线束尚未冻结 | 补最终 MPN、J1 原厂焊盘核对、插头模型和线束针号图 | 可下单 BOM、逐线测通、极性及合壳试装 |
| B | 电源与充电热性能 | 电池模拟器／受控电源先验电源，再接批准电池；测负载变化和充电过程 | 电压／纹波／温升曲线，CC/CV/终止及计时记录 |
| B | EC 波形及逐键一致性 | 覆盖 USB/BLE、充电／不充电、电池高低电压和环境变化 | 每键松开／按下统计、噪声裕量、漏报误报与重启校准结果 |
| B | USB/BLE 整机可用性 | 验枚举、挂起恢复、拔插切换、绑定重连与目标距离 | 主机日志、重复测试结果；恢复延期 SI/RF 工作后补专项验证 |
| B | 机械耐久与电池防护 | 验嵌件拉拔、螺纹拆装、Gasket 压缩、线束应变和软包边缘防护 | 首件尺寸、装配扭矩与结构试验记录 |
| C | 续航及体验 | 实测各工作状态后评估 DC/DC、睡眠、电量上报和充电器兼容策略 | 电池侧功耗和完整续航测量、相应固件回归 |

推荐顺序是先并行取得电池／板厂确认和按键局部样件，再冻结 BOM；完成这些条件后制作少量工程板，依次验电源、扫描、USB/BLE 和完整装配。性能通过后再优化休眠和采购成本，最后讨论批量放行。

### 8.1 建议的样机验证阶梯

| 阶段 | 样件 | 主要验证 | 退出条件 |
|---|---|---|---|
| S0 电源／扫描台架 | 主板 1 块＋测试夹具 | 3.3 V 上电时序、USB 枚举、充电 CC/CV、扫描波形、AFE 开关 | 无过温、无饱和、逐键信号可区分；校准版可保存阈值 |
| S1 局部机械样件 | 局部定位板＋普通键、宽键、6U 空格 | 轴座卡扣、胶碗预压、锥簧对中、全行程与回弹、29 支柱中的代表位置 | 无卡滞、无偏磨，行程与回弹可重复 |
| S2 整机工程样机 | 3 台完整装配 | 60 键逐键校准、USB/BLE 切换、电池续航、合壳与线束 | 全部按键通过、无夹线、充电与续航有实测记录 |
| S3 试产前验证 | 10–30 台 | HDI 首板切片、嵌件拉拔、螺纹寿命、跌落、温升、供方一致性 | 第 8 节 A 类关闭，B 类抽样通过 |

不要跳过 S0/S1 直接做整机：当前最便宜的失败是电源板和局部按键样件，最贵的失败是整批 HDI 板、电池包和树脂壳同时报废。

## 9. 本次复核结果

本次执行 `python3 scripts/run_audit.py` 返回 **0**，结果为 `checks-passed-production-incomplete`，**29 项阶段／输入保护记录全部通过**，`production_approved=false`。包括原理图与 PCB、270 对实际引脚导通、目标固件产物、主机 ASan/UBSan 模拟、机械几何、BOM／电池／功耗算术、来源一致性及负向故障注入检查。设计输入保持未变；详见[阶段结果](outcome.json)。这不等于重新编译目标固件或进行实物测试。

自动通过仅说明当前实现的检查没有发现违规；它不证明所有元件额定值、模拟性能和真实连接器装配。DRC 为 **0 错误、0 断线、111 条警告**（102 条非装配几何庭院提示、9 条走线端点未对准过孔中心），应逐项交由工程人员／板厂审阅，不能概括为“零警告”。ERC 另有 **184 条警告**（183 条端点偏离网格、1 条多网络名），未作为电气错误计数，但出图前应清理或书面接受。信号完整性／射频、样机、寿命和法规认证均不在通过结论内。

## 10. 原厂资料及进一步阅读

本次核对原厂资料，判断结合仓库设计作出；型号可用性及订货状态未作保证。

- [Raytac MDBT50Q-1MV2，Version L](https://www.raytac.com/download/index.php?index_id=43)：模组型号、引脚、焊盘与天线布局指导。
- [Nexperia 74HC/HCT4051，Rev.12](https://assets.nexperia.com/documents/data-sheet/74HC_HCT4051.pdf)：HC/HCT 电气条件及开关参数。
- [TI OPA350，SBOS099D](https://www.ti.com/lit/ds/symlink/opa350.pdf)：供电、速度及静态电流。
- [TI TPS63031，SLVS696D](https://www.ti.com/lit/ds/symlink/tps63031.pdf)：输入范围、固定输出、典型应用及效率限制。
- [TI BQ24074，SLUS810N](https://www.ti.com/lit/ds/symlink/bq24074.pdf)：电源路径、输入限制、热调节、计时与终止。
- [JST SH 系列](https://www.jst-mfg.com/product/pdf/eng/eSH.pdf)：连接器及推荐焊盘尺寸。
- [Honcell HCP404074 电芯](https://www.honcell.com/Public/Uploads/uploadfile/files/20240401/DATASHEETHCP4040743.7V1600mAhCELL2024.pdf)：容量、尺寸及存在矛盾的充电电流表。
- [项目完整工程复查](yeti60-comprehensive-review.zh-CN.md)、[功耗与充电计算](../engineering/power-budget.zh-CN.md)、[装配要求](../engineering/assembly.zh-CN.md)。
