wZuck/YETI60/docs/audit/yeti60-comprehensive-review.md

English | [Chinese](yeti60-comprehensive-review.zh-CN.md)

# E73 review entry has moved

The previous checkpoint review is superseded by the [complete-design review dated November 12, 2026](e73-review.md). It lists actual passing checks, measured USB/plate/plug defects and unperformed physical acceptance. Earlier checkpoint passes do not release the current design.

Start at the [E73 build and review entry](../../BUILD.md). Raytac has a [separate handbook](../../variants/raytac/BUILD.md).
