wZuck/YETI60/variants/raytac/OPEN-BENCH.zh-CN.md

[English](OPEN-BENCH.md) | 简体中文

# Raytac 无外壳首样，包含电池验证

本页 B0～B7 采用当前候选版：四线 C5→J4、两线 J5→J1、三线电池，共九线；J1.2／3 不接。固件使用[当前同包校准版／普通版](hardware/usb-short-route/firmware/README.zh-CN.md)。挂起／恢复须连接合格保护包或合适电池模拟器；无电池时禁用 USB 输入可能使系统断电。[USB 事件及取消配置验收](docs/testing/usb-event-policy.zh-CN.md)包含主机取消配置、复位、挂起和恢复。

电池由用户向供方核实：[可直接转发的参数清单](docs/build/battery-vendor-checklist.zh-CN.md)。USB 修补同步推进。

**电池是必需验证项，第一台样机可以暂不制作外壳。** 当前修补板使用[首板下单入口](hardware/usb-short-route/FIRST-ARTICLE.zh-CN.md)的文件，生产前取得板厂 DFM；旧长 USB 制板包继续暂停。接真实保护包前仍须供方确认。DRC 和制造文件一致性不能代替实物验收。

首次上电不接电芯，是接入真实电池前的检查步骤，不是取消电池。无外壳测试时，电池可以固定在独立绝缘托盘中；这样通过测试，不代表最终电池已能装进 FELK60。

## 需要准备

| 项目 | 数量 | 要求 |
|---|---:|---|
| Raytac 主板 | 装配 1 块 | 按[当前候选板文件及参数](hardware/usb-short-route/FIRST-ARTICLE.zh-CN.md)采用 JLC 普通四层工艺；板厂 DFM 在生产前，实测在首板后 |
| C5 JSH 子板 | 成品 1 块 | 七只元件全部保留，尤其数据／电源保护和保险丝；[材料表](hardware/bom/daughterboard.zh-CN.csv) |
| 主板电子元件 | 实装 75 只 | [当前库存抵扣清单](hardware/usb-short-route/mainboard-purchase.zh-CN.csv)，计划用库存 8 只、补购 67 只；阻容按[采购规格](hardware/usb-short-route/PASSIVES.zh-CN.md)，F1 按已选型号 |
| NiZ 定位板与按键机构 | 钢板 1 张、有效按键 60 套 | 按 [K01—K07](docs/build/key-mechanism.zh-CN.md)及[C04 钢板](hardware/usb-short-route/MECHANICAL-FIT.zh-CN.md)，含三组钢板卫星轴、两根短钢丝、居中 6U 钢丝及键帽 |
| 定位板／PCB 紧固件 | 28 套 | [机械材料表](docs/engineering/materials.zh-CN.md)；H26 不装。无外壳阶段不需要树脂壳、壳体嵌件、合壳螺钉或胶棉 |
| 保护电池包 | **1 包，电池验收必需** | 默认 1600 mAh、单节 4.2 V CC/CV、连续允许充电至少 500 mA；含独立贴近电芯的充电器 NTC 和独立温度断充。[供方完整规格](docs/engineering/battery-pack-specification.zh-CN.md)；目前没有已获确认的准确成品包 |
| 电源／数据线束 | 完整 1 套 | C5→J4 四线、J5→J1 两线跳线及 SHR-03V-S 三根电池引线；按[当前逐针连接](hardware/usb-short-route/README.zh-CN.md#必须采用的连接方式)核对，共九线，J1.2／3 留空 |
| 电脑／终端及另一把可用键盘 | 1 套 | 作为 USB 数据主机及串口终端；YETI60 尚未校准时，用笔记本键盘或另一把键盘输入校准命令 |
| SWD 调试器 | 1 个 | 兼容 nRF52840、3.3 V 参考电平，配自定义六焊盘 J3 夹具 |
| 绝缘 PCB 固定夹具 | 1 套 | 稳定、不导电，元件离桌；初始至少留 12 mm 下方空间，实际接头／螺钉更高则增加。只支撑经过核对的机械位置，不夹电极、元件或天线 |
| 电池绝缘托盘及固定材料 | 1 套 | 不压软包，不露端子，不弯折极耳，不让线束承受电池重量 |
| 台架仪器 | 1 套 | 万用表、可限流 5 V 电源、带保护的 USB 数据源及电流测量、示波器、独立电芯／充电芯片测温 |
| 电池模拟器 | 保护测试用 1 台 | 在所需单节电压范围能输出且吸收至少 0.5 A，或用合适的源测量单元。普通只能输出的直流电源不能直接当电池模拟器 |

按[当前焊接顺序及变化位置](docs/build/soldering.zh-CN.md)，配合[28 步参考指南](docs/assembly/build-guide.zh-CN.md)。保留 PCB、定位板、已校准固件和测试日志的版本关联。当前正式固件关闭电池电量报告，尚无经过验收的自主软件低电压关机。不能把通用 2.4 V 保护板当作已满足电芯表中的 3.0 V 正常放电截止要求。

## 操作顺序及通过条件

| 阶段 | 接线与操作 | 继续前必须记录 |
|---|---|---|
| B0 收货与断电检查 | 检查板框、板厚、孔、钢板厚度、28 套转接柱、H26 留空、元件方向、电源轨及线束针序；先局部试装 NiZ 与卫星轴 | 无短路，螺纹可用，无螺钉顶底、垫片碰元件或硬拉孔位。见[C04 当前公差](hardware/usb-short-route/MECHANICAL-FIT.zh-CN.md) |
| B1 首次供电，不接电池 | C5 与电脑均断开。隔离、限流的 5.0 V 电源接主板 J1 的 1 脚 VBUS 和 4 脚地，初始限流 100 mA，不接数据脚。检查 SW100 开／关、VSYS 与 3.3 V | 极性正确，电源稳定，无异常热或持续触发限流；有问题不能直接调高限流。这一步不验证 C5 的保护功能 |
| B2 刷写及真实 USB，不接电池 | 断开台架电源，经完整 C5→J4 及必需的 J5→J1 跳线接带保护的电脑数据口；J3 只连接参考电压并刷写／校验校准版 | 两种固件正常枚举，配置后描述符请求 USB500，校准版串口可用。**禁止外部 5 V 与电脑 VBUS 并接** |
| B3 模拟电池接口 | 可吸收充电电流的电池模拟器接 J2 的 1 脚正极、2 脚负极；仅在没有真实电芯时，用电阻替代夹具测试第 3 脚 NTC | 实测充电电流方向、输入限流、终止、挂起／复位／拔线、温度故障禁充及电源轨，按下方协议检查 |
| B4 真实电池放电 | 供方电池已获确认、极性及 NTC 检查合格后，拔掉 USB 和模拟器，连接保护包，放在绝缘托盘中开机 | 3.3 V 稳定，蓝牙广播、配对、重连正常；测量电芯电压、电流、温度。首次台架测试在带载 3.2 V 手动停止，不拿真实软包故意深放来证明保护板有效 |
| B5 真实边充边用 | 在已获允许的室温、有人监测条件下，保护包保持连接，再将 C5 接入已配置的电脑 USB | 电池侧确有正向充电电流，同时 USB 枚举／串口通信保持工作，无复位或异常热；B6 校准后再验证按键报告。复测挂起、恢复、复位、拔线和重连。USB500 是共享输入预算，不是电芯固定获得 500 mA |
| B6 完整按键，仍不装外壳 | 绝缘夹具上装好 60 键定位板／PCB／胶碗／锥簧结构，安装 28 套五金，H26 留空；校准全部 60 键 | 每键、功能层及蓝牙配置选择都正常；用真实按键报告复测 B4／B5 的蓝牙输入及 USB 边充边输入。回车、左 Shift、6U 空格按两端均无卡滞、松手回弹；操作大键时邻键保持松键 |
| B7 完整充放电与关机状态 | 在主板开机、电脑接受配置时记录完整 CC/CV／终止周期；另测关机 USB100 充电 | 终止及定时符合要求，电芯／芯片温度合格，软包无鼓胀，记录容量、续航和关机漏电。不能反复切换充电使能或电源来绕过定时故障 |

限流值和夹具离桌高度是初始条件，不是实测结论；须核对实际仪器行为和元件／插头高度。无壳通过后，关壳射频／USB、树脂收缩、嵌件强度及最终电池空间仍需另验。

## 电池及充电规则

- J2 为自定义针序：**1 正极、2 负极、3 相对负极的 NTC**。两针 JST 电池不能直接替代；插壳能插入、线色相同，都不能代替极性检查。
- 主充电为单节、标称 4.2 V 的 CC/CV；供方须接受实际 4.16—4.23 V 稳压范围和最大计算充电电流 445.63 mA。不支持 USB-PD／QC 协商，不能注入 9／12 V。
- 充电 GPIO 初始化完成且固件持续运行时，电脑接受配置才启用 USB500 充电及 USB 输入优先；配置前不充电，挂起时禁充及断开输入。普通纯充电器不会进行 USB 数据配置；关 SW100 后硬件允许 USB100 慢充，完整充电时间须另测。
- 开路／短路传感器、热／冷、定时及保护故障，均在模拟器和替代电阻夹具上检查，**不以折磨真实软包的方式测试**。接真实电芯时不能保留绕过 NTC 的固定电阻。
- USB 输入保险丝不能保护直接跨接电池接口的短路；电池包自身必须有经过核对的电压、电流、温度保护及截止／恢复条件。
- 默认完整包络 85×43×4.8 mm 仍需供方签图；不能买裸 HCP404074 后，把额外保护板、传感器及包装算在包络外。无壳样机可在电气／安全规格独立获确认后使用较厚的外置测试包，但这不替代最终电池配合验收。

## 无外壳能证明什么

可验证刷写、真实 USB／BLE、边充边输入、60 键校准、卫星轴行程、电压／电流／温升及受控充放电周期；不能保证还未制造的板子必然成功。当前候选板已提供修补布线与制造文件；板厂 DFM、电池资格及首板实测仍各自独立，不能以其中一项通过替代其他项目。

[制作总手册](BUILD.zh-CN.md) · [本轮审查](docs/audit/raytac-review.zh-CN.md) · [机器研究数据](docs/audit/prototype-research.json) · [实物验收](docs/testing/README.zh-CN.md)

启动、主控复位与 USB 总线复位要[分开捕获](docs/engineering/power-states.zh-CN.md)：主控未接管 GPIO 时可默认 USB100 充电。B3 还须在无真实电芯条件下，表征挂起期间电池支撑消失后的掉电／重启及输入电流；不能把重启算作挂起通过。关机电流不为零，J2 外线测量也不含包内保护电路自耗。
