wZuck/YETI60/docs/audit/checkpoint-2026-10-27.zh-CN.md

[英文](checkpoint-2026-10-27.md) | 简体中文

# 2026-10-27 阶段提交

当前方向为单颗 nRF52840。保留 FELK60 外壳基准、EC60 感应电极及安装孔，Type-C 经后侧 USB 子板接 J1。

新硬件在 `hardware/ec60-nrf52840/`。本次提交保存原理图、网表、PCB 布线中间成果、生成／核对脚本、扫描参考代码及机械审查记录。

验证结果：

- 单主控网表逐引脚检查通过，176 个元件。
- PCB 网表核对通过；74 个感应电极封装、板框、安装孔和四层板结构核对通过。
- 原理图 ERC：0 错误，仍有 184 条警告。
- PCB DRC：12 错误，35 处未连接；布线尚未完成。
- STM32 扫描参考代码的三个 mock 用例通过 ASan/UBSan；这不是 nRF52840 固件编译或实机验证。

按用户指定的顺序，信号干扰模拟尚未开始，应在 PCB 完成后进行。新板仍需完成布线、DRC、具体物料及电源布局审核、后侧 USB 子板／电池装配、nRF52840 固件及实机校准，不能据此生产。

EC60 子模块内本地工程设置、历史缓存和 `.kicad_prl` 不包含在此阶段提交中。
