wZuck/YETI60/docs/audit/pcb-review-2026-10-27.zh-CN.md

[英文](pcb-review-2026-10-27.md) | 简体中文

# 单 nRF52840 PCB 修复与验证

日期：2026-10-27。阶段基线：`12d9d5819602ab5d5a3da412bc2454cc18c48f26`。

**当前 CAD 检查通过：严格 DRC 0 错误、0 处未连接，原理图一致性 0 错误。** 本次接续修复了此前的 2 条 SWDIO 间距违规和 17 处未连接。射频及信号干扰分析按要求暂不进行。

## 验证结果

| 项目 | 结果 |
|---|---|
| 严格原生 DRC，包括原工程默认忽略项 | 0 错误；没有降低或屏蔽既定间距规则 |
| 全板未连接项，含地网络 | 0 |
| 网表逐引脚物理连接 | 268 对通过；0 对失败；0 个断开网络 |
| PCB／原理图／本地封装一致性 | 通过 |
| 阶段版已连通引脚对回归 | 0 对退化；98 对改善（非地网络比较） |
| 单主控网表契约 | 176 个符号，仅一颗 nRF52840 |
| 原始 EC60 几何保留 | 74 个感应相关封装、板框、安装孔、板厚和四层结构核对通过 |
| 原理图 ERC | 0 错误；184 条警告 |
| 报告截断检查 | 无单类项目触及报告上限 |
| 信号干扰／射频分析 | 未进行 |

严格 DRC 在临时工程中启用原先忽略项，不改写主工程规则。检查器验证工程设置未被覆盖。PCB、原理图、网表、工程及冻结封装的 SHA256 记录在 [audit-current.json](../../hardware/ec60-nrf52840/audit-current.json)，原始结果见 [DRC-strict.json](../../hardware/ec60-nrf52840/DRC-strict.json)。

## 主要修复

- 接通稳压电感、电源支路、充电控制与温度／电流设定、ADC、复用控制、放电控制、五路行驱动、USB D− 与主控 VBUS。
- L1 原旋转方向导致两条开关节点走线交叉，现旋转 180°，将 L1.1／L1.2 分别短接 U6.4／U6.2。
- 将 R40 移至 U5 的 ISET 引脚旁，直接短线连接；同步挪开 C40，避免装配边界和过孔冲突。布局生成器与摆位契约同步更新。
- U1.39 与 U1.51 使用焊盘内过孔换层，消除原先不能满足 0.127 mm 线宽加两侧 0.15 mm 间距的引出路径。主控位置、外壳安装孔和电极保持原位。
- 保留 U5 地／散热焊盘与内层地的连接，并复查稳压器、充电器、主控、USB、ADC 和 SWD 的实际铜连接。
- 逐轮清除原生 DRC 标记的悬空铜线与过孔，共删除 533 个铜对象；清理后重新检查全部引脚对和阶段版连通性。
- 前轮已修复的工程规则保存、封装库一致性、采购属性、丝印和局部孔距问题继续保留并通过复查。

## 保留的警告与工艺要求

当前严格 PCB 警告：`{"track_not_centered_on_via": 5, "missing_courtyard": 102}`。

102 条缺少装配边界对应电极、孔位、测试触点或板框等非装配几何；实际安装器件没有此类遗漏。过孔端点未居中的警告表示线端连接在过孔铜面内，当前间距检查与实际连通检查均通过；它们仍完整列入报告。原理图警告为 183 条端点网格警告和 1 条共用放电网络别名警告。

**U1.39、U1.51 的两个焊盘内过孔必须树脂填孔、磨平并盖铜。** 具体坐标、孔径及装配要求见 [制板说明](../../hardware/ec60-nrf52840/fabrication-notes.zh-CN.md)。普通开孔或仅盖油不能替代此工艺。

## 验证边界

此次通过的是 CAD 电气／制造几何检查，不是实物验收。稳压器稳定性、电容 DC bias 后的有效容量、充电温升、USB 子板及 CC 电阻、外壳装配和 nRF52840 扫描固件仍需样板验证。尚未进行射频或信号干扰模拟，也未据此批准批量生产。

阶段提交的历史检查结果继续保留在 [checkpoints](checkpoints/12d9d58-checkpoint.json)。

## 设计可视化

当前 CAD 的[正反面渲染与旋转动画](../../renders/ec60-nrf52840/README.zh-CN.md)由独立的渲染副本生成，原板 SHA256 保持不变。模型替代及外形简化记录在渲染清单中，不代替机械装配或信号干扰验证。
