wZuck/YETI60/variants/raytac/docs/engineering/power-budget.zh-CN.md

[English](power-budget.md) | 简体中文

# 功耗及续航计算

这是可复算的**敏感性计算**，不是实测续航。目前没有实物。下表用原厂参数确定器件行为；主控平均电流、转换效率和可用容量均明确作为情景假设，不能从蓝牙峰值电流直接推出整机平均功耗。

## 原始数据及固件状态

| 项目 | 原厂数据／当前设计 | 用途及限制 |
|---|---|---|
| OPA350 | 25°C 典型 5.2 mA、最大 7.5 mA；−40…85°C 最大 8.5 mA | [TI SBOS099D，第 7 页](https://www.ti.com/lit/ds/symlink/opa350.pdf)；模拟前端持续耗电，与是否打字无关 |
| nRF52840 | 从闪存运行 CoreMark：LDO 典型 6.3 mA，DC/DC 典型 3.3 mA | [Nordic PS v1.10，5.2.1.3 节](https://docs-be.nordicsemi.com/bundle/nRF52840_PS_v1.10/raw/resource/enus/nRF52840_PS_v1.10.pdf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)；基准程序值不能确定实际固件占空比 |
| 射频 | 0 dBm 发射典型：LDO 10.6 mA／DC/DC 4.8 mA；1M 接收典型 9.9／4.6 mA | [Nordic 射频电气表](https://docs.nordicsemi.com/r/bundle/ps_nrf52840/page/radio.html)；仅射频峰值，不是整机平均电流 |
| TPS22919 | 25°C 导通典型 8 µA、关闭典型 2 nA | [TI SLVSEN5B，第 5 页](https://www.ti.com/lit/ds/symlink/tps22919.pdf)；当前普通版 U8 导通、U7 关闭 |
| 74HC4051 | 25°C、6 V、输入位于电源轨时，每颗静态最大 8 µA | [Nexperia 第 12 版，第 9 页](https://assets.nexperia.com/documents/data-sheet/74HC_HCT4051.pdf)；两颗按 16 µA 作静态预算，不代表 3.3 V 动态电流实测 |
| BQ24074 | 无输入、OUT 无负载、结温 85°C：BAT 静态典型 4.3 µA、最大 6.5 µA | [TI SLUS810N，第 12 页](https://www.ti.com/lit/ds/symlink/bq24074.pdf)；作为偏置近似，带载电源路径仍需测量 |
| TPS63031 | VIN／VINA 静态典型／最大 25／35 µA，输出静态 4／6 µA，受规定测试条件限制 | [TI SLVS696D，第 5 页](https://www.ti.com/lit/ds/symlink/tps63031.pdf)；不能直接把宣传的最高 96% 当全工况效率 |

当前目标配置 `CONFIG_ZMK_SLEEP=n`，空闲 30 秒后扫描间隔从 4 ms 降到 30 ms，并在空闲扫描之间用 U8 关闭 AFE；有按键、状态变化或有效位置有待确认消抖边沿时立即回到 4 ms。电量上报关闭，适配层没有驱动指示灯。设备树已把 REG1 切到 DC/DC；REG0 仍为 LDO，因为板上没有外部 DCCH 电感。[Raytac 第 L 版](https://www.raytac.com/download/index.php?index_id=43)说明 REG1 电感已集成在模组内。下面的规划表仍按 AFE 连续开启计算，因此是保守值，没有把空闲门控的收益计入；实测前不能把改善量写成保证续航。广播和重连可能比稳定连接更耗电。

每帧采样 75 个矩阵位置。显式忙等待为 `15×3 + 75×(10+5) = 1170 µs`，采集为 `75×40 = 3000 µs`，每次转换按 2 µs 时间预算共 150 µs，之后休眠 4000 µs，合计 **8320 µs，尚未包含 GPIO、驱动和调度开销**。阻塞 ADC 等待可让 CPU 休眠，所以不能把 4320／8320 当作实际 CPU 占空比，须结合线程时间戳和电池侧电流测定。

## 公式与假设

下式单位为 mA、V、mAh 和小时。`I_MCU` 已包括 CPU、ADC、时钟、蓝牙及软件开销，不能再重复叠加一份相同射频／ADC 电流。

```text
I_3V3 = I_OPA + I_MCU + 2×3.3/100000×1000 + 0.008 + 0.016 + 0.100
       = I_OPA + I_MCU + 0.190
I_电池 = 3.3×I_3V3/(V_电池×η) + V_电池/100000×1000 + I_BQ + I_PCM
t = 容量×可用比例/I_电池
```

R44、R50 两个 100k 下拉在 `/CE` 和 AFE_EN 为高时共耗 66 µA；R48 从 VSYS 取电，单独按电池电压近似。其余被动负载、运放输出和动态逻辑预留 0.100 mA，属于**假设**。保护板耗电未知，规划按 10 µA、压力情景按 20 µA 假设。转换效率按包含稳压器静态损耗的端到端效率处理，不能再重复加入其静态电流。默认指示灯关闭；若全亮，额外电流约为 `(3.3−Vf)/2200` A。

| 情景 | 运放 mA | 假设主控平均 mA | 假设效率 | 假设电池 V | 3.3 V 电流 mA | 电池电流 mA | 默认 1600 mAh 小时 |
|---|---:|---:|---:|---:|---:|---:|---:|
| 较低负载 | 5.2 | 3 | 90% | 3.7 | 8.390 | 8.366 | 153.01 |
| 规划值 | 5.2 | 6 | 85% | 3.7 | 11.390 | 12.003 | 106.64 |
| 压力情景 | 7.5 | 10 | 80% | 3.3 | 17.690 | 22.172 | 57.73 |

统一假设可用容量为 80%，用于预留老化、截止电压和环境影响，并非厂商保证。默认 1600 mAh 对应 HCP404074 裸电芯最低容量，完整定制包仍须验收；不能把 57.73–153.01 小时宣传成保证范围。规划点 `3.3×11.39=37.587 mW`，电池功率为 `44.40981 mW`，所以 `3.7×1.6×0.8 / 0.04440981 = 106.64 小时`。没有样机，不能声称已测得这一续航。

空闲门控的收益没有计入上表：按照 30 ms 空闲帧、每帧约 5 ms AFE 稳定加扫描窗口，AFE 平均电流会明显低于 5.2 mA；实际占空比、首键延迟、mux/ADC 建立和射频干扰仍需首件测量。上表保持“AFE 连续开启”的保守口径，便于和旧计算直接比较。

执行 `python3 scripts/calculate_yeti60_power.py` 复算。[中文表格](../../hardware/bom/power-scenarios.zh-CN.csv)和[计算数据](../audit/yeti60-power-budget.json)记录中间值及源码哈希，[资料索引](sources.json)列出版本、页码、访问日期及可获取文件的哈希。

## 默认 P2 充电设计

保留 [BQ24074，SLUS810N 第 12–13、27–28 页](https://www.ti.com/lit/ds/symlink/bq24074.pdf)。R40 从 8.87k 改为 2.21k／1%；新增 R55=69.8k／1% 接 TMR 到地，R56=1.69k／1% 接 ITERM 到地。与旧小电池配置不能混用。

```text
I_CHG = K_ISET / R40；K_ISET = 797 / 890 / 975 AΩ
最小 = 797/(2210×1.01) = 357.06 mA
典型 = 890/2210 = 402.71 mA
最大 = 975/(2210×0.99) = 445.63 mA

t_快充 = 10 × R55(kΩ) × K_TMR / 3600 小时
K_TMR = 36 / 48 / 60 秒/kΩ
最小／典型／最大 = 6.9102 / 9.3067 / 11.7497 小时

I_TERM = K_ITERM × R56 / R40
K_ITERM(USB500) = 0.0225 / 0.0300 / 0.0375
最小／典型／最大 = 16.87 / 22.94 / 29.26 mA
电芯规格的 0.02C 终点 = 1600×0.02 = 32 mA
```

R55 全公差范围 69.102…70.498k，位于 18…72k 的允许区间内；预充计时为快充的十分之一。USB100 下终止系数是 0.008／0.010／0.012，不能把上下限都精确按三分之一处理。计算保留在 JSON 中，包含全部电阻误差。

固件的旧版 Zephyr `CONFIG_USB_MAX_POWER=250` 对应 500 mA，已从普通版／校准版的链接 ELF 描述符检查。只有主机接受配置后才选 USB500 并允许充电；未枚举时保持 USB100 且不充电，挂起时禁充并将输入置高阻，恢复后保留主机接受的配置。BQ 的 USB500 实际输入限制最小／典型／最大为 450／475／500 mA，**不是电池始终得到 500 mA**。按假设整机输入预留 40 mA，最差输入预算剩余 `450−40=410 mA`，高于 357.06 mA 的最小设定值；高设定公差端可能发生电源路径限流。40 mA 预留仍须实测，热调节、线损和恒压阶段也会降低电流。

上述控制策略适用于主板 3.3 V 已开启、固件运行时。**SW100 关闭时**，R42／R43／R44 的硬件下拉使 EN1=0、EN2=0、/CE=0，充电器可自主以 USB100 慢充；此时不能枚举或启用 500 mA，也没有已验证的完整充满时间。只有充电功能的适配器在主板开启时不能完成 USB 配置，因此固件会禁充；关闭主板后才回到硬件 USB100 慢充。完整快速充电验收使用主板开启、主机接受 500 mA 配置的条件，同时还须分别验收关机慢充和安全计时。独立电池温度保护必须在没有 MCU 的情况下仍有效。

仅以最小设定值计算理想恒流阶段 `1600/357.06=4.48 小时`，距最小快充计时约余 2.43 小时供恒压收尾。这不是充满时间证明，不包含深度放电预充、低温、热限流和主机供电异常。TI 的动态计时会在规定的限流状态下变慢，不能用反复复位或关闭安全计时器来规避验收。供方曲线及样机必须验证允许条件下充到终止电流，未满足时须改版。

HCP404074 原厂资料的倍率和电流数值存在不一致，详见[电池选型](battery-study.zh-CN.md)。当前最大 445.63 mA 高于其明确标准电流 270 mA，但低于 15…45°C 条件下写出的最大 1350 mA；因此定制包的独立温度保护必须保证实际电芯充电窗口在 15…43°C 内，目标 18…40°C 并计入全部误差。BQ24074 加 103AT-2 的典型温度窗口本身不满足此约束；仅提供第三线 NTC 或普通过压过流保护板不够。供应商未书面确认前不能放行采购。

电源开关只关闭 3.3 V 转换器，充电器、保护板和自放电仍消耗电量。发布前以校准的电池侧分析仪测试打字、连接空闲、广播、重连、关机和允许温度／电压下的完整充电；使用普通固件，测续航时断开 USB／调试器并关闭日志。信号干扰检查已开始，最小天线铜区检查已通过，USB 信号完整性和关壳射频仍待验收。

R56 从 1.82k 降至 1.69k 后，最大终止电流为 29.26 mA，距暂定 32 mA 终点余量 2.74 mA；恒压时间仍需实测。450 mA 仅为编程工程上限，采购要求电池包在获准温区内至少具有 500 mA 连续充电能力，相对最大值 445.63 mA 余量为 54.37 mA。供方须书面接受 BQ24074 的整个 4.16–4.23 V 稳压范围及低电压端容量影响，并澄清电芯表矛盾。

首次有效消抖边沿现在会唤醒活动扫描；单帧尖峰不会绕过两帧确认，但会重置 30 秒空闲计时，因此噪声可能增加活动占比。该逻辑修补不改变表中的 AFE 常开保守假设、充电限值或电池容量，不能据模型时序推算实测延迟或续航，见[短按测试](../testing/scan-control.zh-CN.md)。

[关机与复位状态补充](power-states.zh-CN.md)：SW100 不是电池总断开；主控未接管 GPIO／保持复位时可默认 USB100 充电，与初始化后的配置前禁充不同。新增原厂关断电流条目及量纲明确的电量损失计算，不把不同条件的小计当作整机上界，也不修改上述运行时续航情景。
