wZuck/YETI60/variants/raytac/docs/audit/yeti60-comprehensive-review.zh-CN.md

中文 | [English](yeti60-comprehensive-review.md)

# YETI60 P2 电气、固件及装配复查

历史审查快照：其中 1.2 mm 定位板、29 套紧固件及旧元件数量不再是当前装配规格。当前版本请看[本轮审查](raytac-review.zh-CN.md)及 [NiZ 钢板卫星轴方案](../build/key-mechanism.zh-CN.md)。

当前单 nRF52840 方案具备原生 CAD 检查、可构建 USB／BLE 固件和条件装配证据。目前没有实物，检查通过不等于批准生产。[阶段记录](../design-checkpoint.zh-CN.md)说明默认配置，[阶段结果](outcome.json)记录当前完整流水线。

## 电气和布线

严格 DRC／原理图一致性为 **0 错误、0 断线**，**270 对实际引脚**导通。回归检查保留基线已导通的引脚对，并单列新增元件连接。静电容电极、板框和安装孔中心保持源几何。已删除的中央品牌字样仅为装饰；电极圆环及接地屏蔽铜保留。

U1 为单颗 Raytac MDBT50Q-1MV2。U1.20 使用 P0.04／AIN2 扫描，U1.21 使用 P0.05／AIN3 测量电池；nRF USB PHY 已有终端，R30／R31 保持 0 Ω。复用通道顺序来自实际原理图。U8 控制模拟前端，U7 控制 1M:1M 电池分压；固件避免向未供电前端反灌，并给电池测量留出稳定时间。

电源线路已改为普通通孔；移动输入电容 C40 及充电控制电阻以完成布线。输入电容路径保留至少 0.25 mm 铜线，低电流 ITERM 可用 0.127 mm。[电气证据](yeti60-electrical.json)记录当前保守长度、线宽和过孔数，不宣称回流电感、瞬态或热性能合格；警告数量以当前严格审计为准。

原 9 个盲孔和两个模组信号盘中孔已移除。采用[JLC 普通四层工艺](../../hardware/ec60-nrf52840/fabrication-notes.zh-CN.md)，标称下单 1.6 mm、CAD 包络 1.6062 mm、感应介质 0.2104 mm，仅用机械通孔。电容降额、焊装和稳压／充电温升仍需验收，信号及射频检查已开始，天线布局阻塞项仍待解决。

## 电池、充电和功耗

默认 **1600 mAh**，参考 HCP404074 电芯，定制完整电池包为 **85×43×4.8 mm**。[选型证据](../engineering/battery-study.zh-CN.md)列明 651 型号的有界目录筛选、组包预算和原厂资料矛盾；充电行的倍率与毫安数不一致，须由供方更正。普通两线软包或仅过压过流保护板不能等效替代指定的独立温度断充和第三线 NTC。

R40=2.21k、R55／TMR=69.8k、R56／ITERM=1.69k，均为 1%；名义充电 402.71 mA、最大 445.63 mA，最小快充计时 6.9102 小时，最大终止电流 29.26 mA。定制包必须保证实际电芯充电窗口在 15…43°C 内。[公式和情景](../engineering/power-budget.zh-CN.md)包含误差、USB 输入预算、理想恒流／恒压余量及 106.64 小时规划续航。它们不是充满时间或续航保证，组包尺寸／保护签图和完整充电实测仍待验收。

## 固件

普通版和 USB 串口校准版 ARM ELF／BIN／HEX 已由固定 ZMK／Zephyr 依赖构建；两个链接 ELF 描述符均申请 500 mA。主机接受配置前保持 USB100 且禁充；挂起关闭充电和输入，恢复保留已接受配置。负向用例拒绝只申请 100 mA 的链接描述符；HEX 检查保护设置分区。

实际控制核心 C 代码通过 ASan／UBSan 主机模拟，覆盖扫描／复用时序、滞回去抖、故障断电、报告切换、USB 模式及重入保护；其中硬件抽象层为模拟。目标代码提供 GPIO／SAADC、ZMK HID／BLE 和持久校准，实际枚举、配对、阈值及按键行程未测试。[目标固件说明](../../firmware/target/README.zh-CN.md)规定 SWD 和释放／按压／保存校准，不声称预设阈值可直接工作。

## 装配、材料及渲染来源

派生树脂壳保留 FELK60 外部联合包围尺寸 **325.700×125.200×31.190 mm**，加入冷粘嵌件座、SW100 检修孔及默认电池槽。1.2 mm 钢板、4.50 mm 支柱加 0.10 mm 绝缘、1.6062 mm CAD PCB envelope 和底部 M1.6 螺钉形成规定的 4.60 mm 间距。29 个安装中心匹配，计入规定公差后最差径向螺钉余量约 0.06163 mm；实际轴座胶碗、螺纹和树脂缩水仍需首件验收。

选定电池包与检查的上下壳、元件和紧固件包络无碰撞；包含 XY ±0.40 mm 后，最小元件间隙 0.555 mm，螺钉头名义间隙 0.700 mm。精确实体槽底距离扣除 0.30 mm 后最小壁厚 3.6585 mm；它不证明强度、蠕变或跌落性能。保留 **C5 JSH** 子板及四个 M2 位置，完整插头／线束弯折和维修路径仍须验收。

[76 件主板材料及机械材料](../engineering/materials.zh-CN.md)、[独立工程装配图](../engineering/assembly.zh-CN.md)、[PCB 动画](../../renders/ec60-nrf52840/README.zh-CN.md)和[摄影风格装配图](../../renders/yeti60-assembly/README.zh-CN.md)绑定当前来源哈希。壳体／钢板／PCB 不缩放；键帽、轴座、材质、元件本体和组包结构有明确示意部分。完整集成会拒绝单张旧图或图片字节变更。中英文文件分开，上游署名和兼容库标识保留。
