wZuck/YETI60/variants/raytac/docs/engineering/board-markings.zh-CN.md

[English](board-markings.md) | 简体中文

# PCB 标记清理

仅删除中央的非功能性项目署名行 `YETI60 / EC60 by Cipulot`，保留版本和后置 USB 标识。孔位指引、位号、引脚编号、极性／装配文字及制造注释均逐项原样保留。仓库文档继续保留上游署名。

板面的大圆形及重叠圆形是连接到电路的静电容感应电极和地屏蔽，属于功能铜层，予以保留。删除这些结构会改变感应性能，不符合保留当前功能设计的要求。

执行 `python3 scripts/check_yeti60_board_markings.py` 核对历史装饰清理提交 `03c2be3` 相对 `2789470` 只删除上述文字；当前 P2 另有明确的充电电路变更，不再声称整块 PCB 铜层完全不变。检查继续要求全部独立指导文字和原有位号保留，电极／板框／安装孔由 `check_single_nrf_pcb.py` 单独核对。[机器报告](../audit/yeti60-board-markings.json)记录当前板哈希。
