wZuck/YETI60/docs/audit/yeti60-comprehensive-review.zh-CN.md

[English](yeti60-comprehensive-review.md) | 简体中文

# E73 复查入口已更新

原有阶段复查已由 [2026 年 11 月 12 日的完整方案审查](e73-review.zh-CN.md)取代。该审查列出实际通过项、已测得的 USB／定位板／插头问题及尚未执行的实物验收，不能用旧阶段的通过记录放行当前方案。

总入口：[E73 制作与审查](../../BUILD.zh-CN.md)。Raytac 使用[独立手册](../../variants/raytac/BUILD.zh-CN.md)。
