wZuck/YETI60/variants/raytac/hardware/usb-short-route/firmware/trace.csv

scenario | time_us | sample_0_0 | pressed_0_0 | transport | hid_modifiers | hid_first_usage
single-keys | 9170 | 2500 | 0 | 0 | 0 | 0
single-keys | 13340 | 2500 | 1 | 0 | 0 | 0
single-keys | 17510 | 1000 | 1 | 0 | 0 | 0
single-keys | 21680 | 1000 | 0 | 0 | 0 | 0
single-keys | 25850 | 1000 | 0 | 0 | 0 | 0
single-keys | 30020 | 1000 | 0 | 0 | 0 | 0
single-keys | 34190 | 1000 | 0 | 0 | 0 | 0
single-keys | 38360 | 1000 | 0 | 0 | 0 | 0
single-keys | 42530 | 1000 | 0 | 0 | 0 | 0
single-keys | 46700 | 1000 | 0 | 0 | 0 | 0
single-keys | 50870 | 1000 | 0 | 0 | 0 | 0
single-keys | 55040 | 1000 | 0 | 0 | 0 | 0
single-keys | 59210 | 1000 | 0 | 0 | 0 | 0
single-keys | 63380 | 1000 | 0 | 0 | 0 | 0
single-keys | 67550 | 1000 | 0 | 0 | 0 | 0
single-keys | 71720 | 1000 | 0 | 0 | 0 | 0
single-keys | 75890 | 1000 | 0 | 0 | 0 | 0
single-keys | 80060 | 1000 | 0 | 0 | 0 | 0
single-keys | 84230 | 1000 | 0 | 0 | 0 | 0
single-keys | 88400 | 1000 | 0 | 0 | 0 | 0
single-keys | 92570 | 1000 | 0 | 0 | 0 | 0
single-keys | 96740 | 1000 | 0 | 0 | 0 | 0
single-keys | 100910 | 1000 | 0 | 0 | 0 | 0
single-keys | 105080 | 1000 | 0 | 0 | 0 | 0
single-keys | 109250 | 1000 | 0 | 0 | 0 | 0
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
