wZuck/YETI60/renders/ec60-nrf52840/pcb-back.png

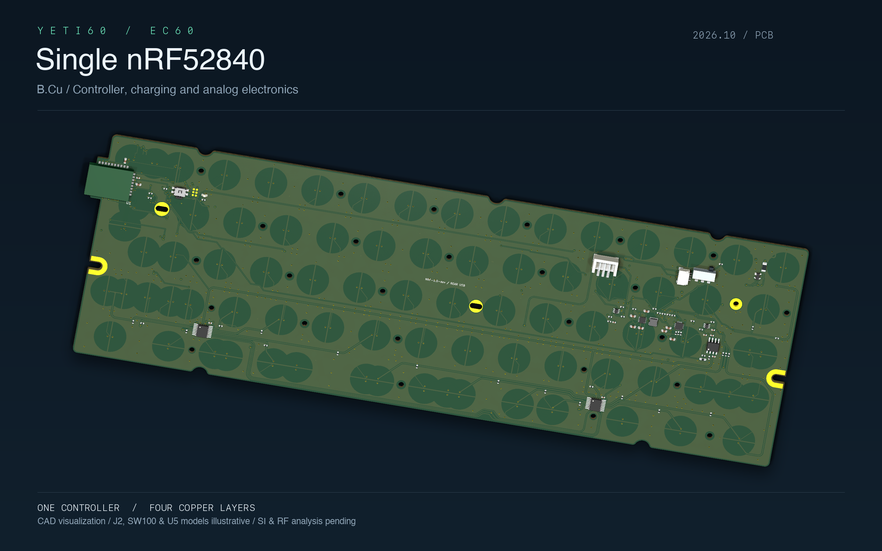
renders/ec60-nrf52840/pcb-back.png
