wZuck/YETI60/renders/ec60-nrf52840/pcb-front.png

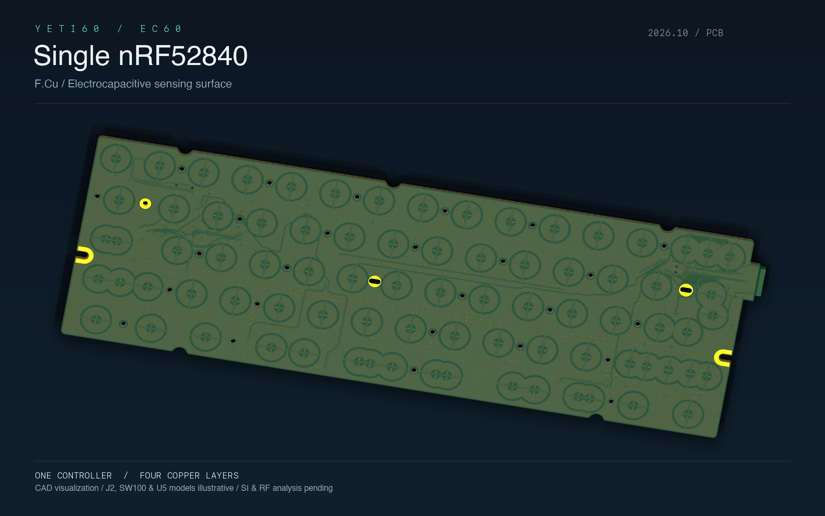
renders/ec60-nrf52840/pcb-front.png
