wZuck/YETI60/variants/raytac/docs/engineering/images/deskeys-mechanism.png

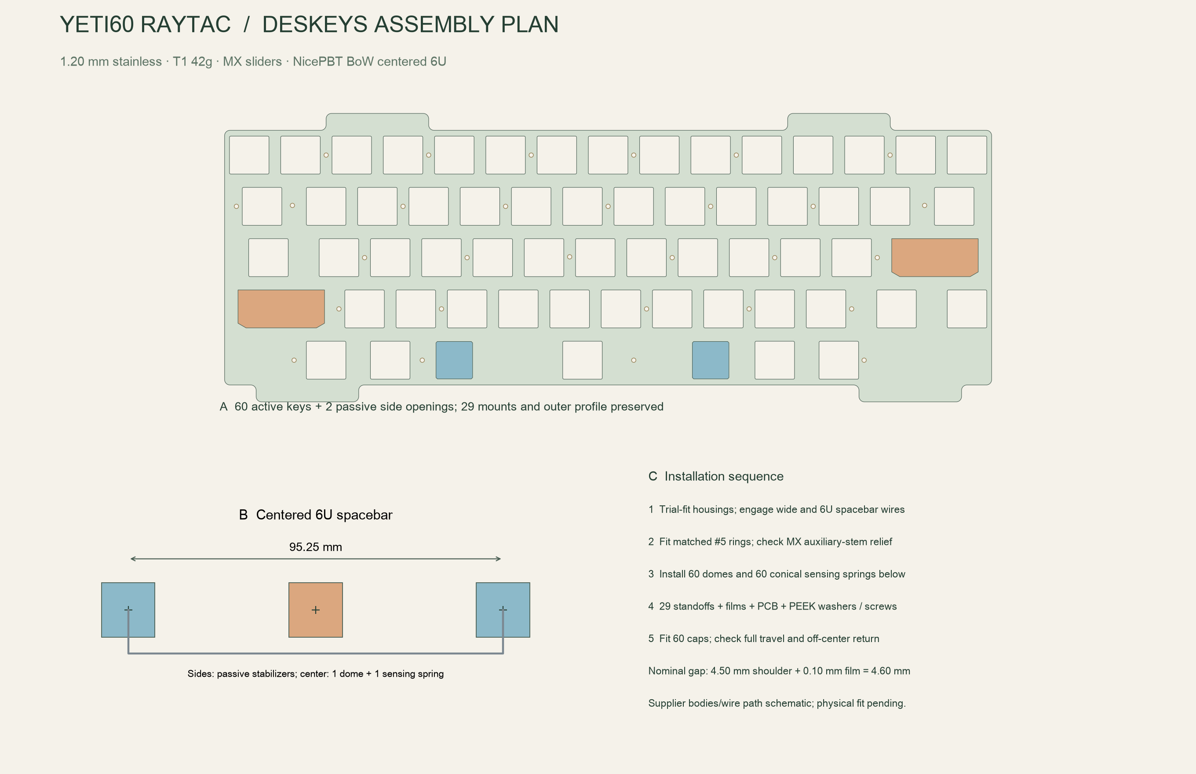
variants/raytac/docs/engineering/images/deskeys-mechanism.png
