wZuck/YETI60/docs/engineering/materials.md

English | [Chinese](materials.zh-CN.md)

# YETI60 materials and procurement requirements

Revision P2, 2026-10-29. This table is a prototype procurement plan; rows with unqualified dimensions or candidate MPNs are not approved purchase orders. Quantities are per keyboard, without spares. Electronics use the current schematic, not a historical EC60 BOM.

## Electronics

Use the [inventory allocation](inventory-allocation.md) and [stock-adjusted mainboard CSV](../../hardware/bom/mainboard-purchase.csv) before buying loose parts. The current order-derived snapshot plans 10 mainboard parts from received stock and 66 to buy; actual remaining stock and capacitor qualification require confirmation. All other preparation quantities below remain applicable.

The [grouped mainboard CSV](../../hardware/bom/mainboard.csv) is regenerated by `python3 scripts/export_yeti60_bom.py`: **76 fitted components**, one DNP gain-adjustment site JP1, and no purchasable electrode, mounting-hole or SWD-pad parts. JP1 must remain open; R16/R17 already provide gain 101. There are 74 alternate-layout electrode footprints but **60 installed key mechanisms** in this HHKB plate. J3 is a six-pad SWD probe interface, not a soldered header.

| Assembly | Quantity | Requirements |
|---|---:|---|
| Main PCB | 1 | Current EC60-nRF52840 source, ordinary JLC four-layer FR-4, 1.6 mm nominal order, 1.6062 mm CAD envelope; ordinary through vias only, no fill/capping requirement |
| Mainboard components | 76 | Grouped CSV lists values, references, packages, specified/candidate MPNs and qualification gaps |
| USB daughterboard | 1 assembled | Unified Daughterboard C5 JSH, pinned commit `2b6c52a`; [upstream BOM](https://github.com/Unified-Daughterboard/UDB-C-JSH/blob/2b6c52aa2de6f9f60ca99c6250e4bdf01e8f4eea/production/UDB-C-JSH_5.0_bom.csv) has 7 fitted components; do not also count them as loose parts if buying assembled |
| USB internal harness | 1 | 150 mm route centerline; individual lengths per interconnect specification; 4 conductors, SH-compatible housings at both ends; continuity 1→1 VBUS, 2→2 D−, 3→3 D+, 4→4 GND; mated-envelope/controlled-route CAD checks added; crimps, bending and serviceability need physical acceptance |
| Battery pack | 1 | Default YETI60-BAT-1600-1S, HCP404074 reference, complete 85×43×4.8 mm; independent thermal interruption within actual cell 15…43°C, separate 10k NTC; PHR-3: 1 positive, 2 negative, 3 NTC. Supplier-signed limits/drawing required |
| USB-C data cable | 1 | External host cable supporting data, not charge-only |

The main J1 footprint has an inherited 1.0T-4P supplier identifier. JST SM04B-SRSS-TB is a candidate with a matching nominal interface; check retention pads and mating orientation against the [JST SH drawing](https://www.jst-mfg.com/product/pdf/eng/eSH.pdf) before ordering. J2 is S3B-PH-SM4-TB; use the [PH series drawing](https://www.jst-mfg.com/product/pdf/eng/ePH.pdf). Connector family names alone do not establish polarity. Passive MPNs, capacitance under DC bias, fuse trip behavior and the LED are not supplier-qualified; the CSV makes these gaps explicit.

## Mechanical materials

Use the [E73 NiZ and plate-stabilizer specification](../build/key-mechanism.md). Purchase K01–K07 separately; install 28 fastener sets and leave H26 empty. The old 1.2 mm plate and unspecified Topre mechanisms are superseded.

| ID | Item | Quantity | Specification / acceptance |
|---|---|---:|---|
| M01 | Top shell | 1 | Derived FELK60 HHKB STEP, tough SLA resin, post-cured; no exterior scaling |
| M02 | Bottom shell | 1 | Selected [E73 M01 STEP](../../mechanical/e73-fit/yeti60-e73-bottom-m01.step), P2 1600 mAh recess and SW100 floor relief; original exterior |
| M03 | Plate | 1 | K07 E73 M01 NiZ plate-mount DXF, 304 stainless, CAD thickness 1.60 mm, finished 1.55-1.60 mm, 28 M2 x 0.4 axes; no H26 plate mounting hole |
| M04 | NiZ housings / sliders / original rings | 60 | K01 five per pack, buy 13 packs / 65; install 60, spare 5; ordinary center housings for big keys, no Deskeys wide assembly |
| M05 | Rubber domes | 60 positions | K03 NiZ 45g sheet, one sheet; use 60 complete positions trimmed for HHKB; not included in K01 |
| M06 | Conical EC springs | 60 | K02 NiZ five per pack, buy 13 packs / 65; install 60, spare 5; not helper springs |
| M07 | Plate-mounted stabilizers / wires | 1 matched set | K04 genuine GMK Plate mount / 2u, three sets / six side units; use two short wires and separate K05 6U wire, spare one short wire |
| M08 | Keycaps | 60 | K06 NicePBT BoW current complete kit, one kit including 6.0c Centered spacebar; MX mounts |
| M09 | Adapter standoffs | 28 | YETI60-STANDOFF-46, brass OD3.5, shoulder 4.50 +/-0.03; top M2 x0.4 stud 1.0; bottom M1.6 x0.35 female depth 3.2; H26 unused |
| M10 | Top insulating films | 28 | Polyimide 0.10 +/-0.02 mm, OD4.5 / ID1.8; between standoff and PCB; H26 unused |
| M11 | PCB screws | 28 | M1.6 x5 pan head; verify actual head/thread; H26 unused |
| M12 | PCB washers | 28 | PEEK OD <=4.0, ID2.2, thickness0.8 mm; H26 unused; no conductive metal substitution |
| M13 | Top-shell inserts | 4 | Cold-bonded knurled brass M3×0.5, OD 4.6, length 3.0; bores Ø4.85±0.05, depth 3.5 |
| M14 | Daughterboard inserts | 4 | Cold-bonded brass M2×0.4, OD 3.2, length 2.5; bores Ø3.35±0.05, depth 2.9 |
| M15 | Shell closure screws | 4 | M3×5 with 0.30 mm shim washer; proposed from CAD seat z=2.59 and insert entry z=4.79; nominal engagement 2.50 mm, verify head Ø≤5.6 in Ø5.8 recess |
| M16 | Daughterboard screws | 4 | M2×4 with 0.30 mm insulating washer; nominal thread engagement 4−1.6062−0.30=2.0938 mm in 2.5 mm insert; head clearance to connector requires check |
| M17 | Gasket stock | 1 set | Four 33 x 3 mm pads per layer; lower stock 2.0 mm, upper 1.2 mm; installed gaps 1.0162 /0.5838 mm; force/creep qualification open |
| M18 | Case feet | 4 | [SKUF silicone feet](https://keeb.io/products/skuf-silicone-rubber-keyboard-feet), 41.8 x 5.8 x 2 mm, 45A, adhesive backed; four approximately 42.2 x 6.2 mm case pockets. One 8-pack leaves four spares |
| M19 | Insert adhesive | As needed | Resin-compatible structural epoxy; cold-bond only, cure per adhesive/resin supplier, keep thread bores clear |
| M20 | Battery retention and insulation | 1 set | Nonconductive removable retention and edge protection; include tape thickness in the pocket budget; do not clamp the pouch |

## Cable guides and auxiliary materials

Also prepare two rear bases, two removable bridges and one front base; 0.05 mm removable nonconductive double-sided tape and three retention films with total thickness <=0.10 mm. Dimensions, published STEP/STL and installation are in [internal connections](interconnects.md). The [complete README preparation list](../../README.md) itemizes shims, stock purchase quantities, tools and assembly inclusion to prevent double counting.

## Tools and assembly release

Use an SWD probe plus the custom J3 pogo fixture, multimeter for every harness conductor/polarity, small torque-controlled driver, calipers and an insulated tool for SW100 access. No soldered per-key diodes, MX sockets or second MCU belong in this design. Quantities do not imply supplier availability or prices.

FELK60 supplies the plate/gasket mounting basis. [DELTA OMEGA BOM](https://github.com/wZuck/delta-omega/blob/main/docs/BOM.md) was reviewed at commit `64db818`: its separate mechanical/electronic rows and explicit cap envelope are useful documentation references; its MX switches, XIAO controllers and two batteries are not compatible substitutions. [PH60 Rev.3](https://github.com/ph-design/PH60) documents a dedicated removable battery tray and a much larger battery allowance; that tray concept informs the default recess design, while its FDM case and different PCB/firmware do not prove YETI60 fit or runtime.
