wZuck/YETI60/docs/engineering/materials.zh-CN.md

[English](materials.md) | 简体中文

# YETI60 材料及采购要求

P2 阶段，2026-10-29。数量均为单把键盘净用量，不含备件。这是工程样机采购计划，标为候选、尺寸未确认的项目不能直接作为批准下单清单。电子材料以当前原理图为准，不沿用历史 EC60 材料表。

## 电子材料

购买散件前先查看 [库存分配说明](inventory-allocation.zh-CN.md) 和 [扣除计划库存的主板补购表](../../hardware/bom/mainboard-purchase.zh-CN.csv)。当前订单记录快照计划使用已收货库存 10 只、补购 66 只；装配前仍须清点实际余量并确认电容规格。下方其他准备数量继续适用。

执行 `python3 scripts/export_yeti60_bom.py` 可重新生成[主板分组材料表](../../hardware/bom/mainboard.zh-CN.csv)：**76 个实际焊装元件**，JP1 默认不装。电极、安装孔和 SWD 焊盘不是采购器件。R16／R17 已设增益 101，JP1 不能直接装零欧姆短接。PCB 包含 74 个可选布局电极位置，本次 HHKB 定位板只安装 **60 套按键机构**。J3 是六个探针焊盘，不是焊接排针。

| 总成 | 数量 | 要求 |
|---|---:|---|
| 主板 PCB | 1 | 当前 EC60-nRF52840 源文件；JLC 普通四层 FR-4、标称 1.6 mm；CAD 包络 1.6062 mm；只用普通通孔，不要求填孔盖铜 |
| 主板焊装元件 | 76 | 分组材料表列出数值、位号、封装、指定／候选型号及待确认项目 |
| USB 子板 | 1 块成品 | Unified Daughterboard C5 JSH，锁定提交 `2b6c52a`；[上游材料表](https://github.com/Unified-Daughterboard/UDB-C-JSH/blob/2b6c52aa2de6f9f60ca99c6250e4bdf01e8f4eea/production/UDB-C-JSH_5.0_bom.csv)有 7 个焊装元件，购买成品时不要重复计入散件 |
| USB 内部线束 | 1 | 中心线路径 150 mm，逐根长度按连接规格；四芯、两端 SH 兼容插壳；电气直通：1→1 为 VBUS、2→2 为 D−、3→3 为 D+、4→4 为地；插头及控制路径 CAD 检查已加入，实物压接／弯折／维修仍待验收 |
| 电池包 | 1 | 默认 YETI60-BAT-1600-1S，以 HCP404074 为参考，完整 85×43×4.8 mm；独立温度断充须保证实际电芯充电窗口在 15…43°C 内，另带 10k NTC；PHR-3：1 正极、2 负极、3 温度线。须由供方签署图纸和限值 |
| USB-C 数据线 | 1 | 主机外接数据线，不能用仅充电线 |

主板 J1 继承了 1.0T-4P 供方标识。JST SM04B-SRSS-TB 是名义接口相符的候选，下单前须按[JST SH 图纸](https://www.jst-mfg.com/product/pdf/eng/eSH.pdf)复核固定焊盘和插接方向。J2 为 S3B-PH-SM4-TB，参见[PH 系列图纸](https://www.jst-mfg.com/product/pdf/eng/ePH.pdf)。连接器系列名不能保证线序正确。阻容具体型号、偏压下有效容量、保险丝动作特性和指示灯尚未完成供方确认，材料表已明确标注。

## 机械材料

使用 [E73 NiZ 及钢板卫星轴规格](../build/key-mechanism.zh-CN.md)。K01–K07 分别采购；安装 28 套固定件，H26 不装。旧 1.2 mm 定位板及未指定的 Topre 机构已被替代。

| 编号 | 材料 | 数量 | 规格／验收要求 |
|---|---|---:|---|
| M01 | 上壳 | 1 | 派生 FELK60 HHKB STEP；韧性 SLA 树脂，完成后固化；外部尺寸不缩放 |
| M02 | 底壳 | 1 | [E73 正式 M01 STEP](../../mechanical/e73-fit/yeti60-e73-bottom-m01.step)，含 1600 mAh 电池槽与 SW100 地板避空，外形不变 |
| M03 | 定位板 | 1 | K07 E73 M01 NiZ 钢板卫星轴 DXF，304 不锈钢，CAD 厚 1.60 mm、成品 1.55—1.60 mm，28 处 M2×0.4；H26 不开安装孔 |
| M04 | NiZ 轴座／滑块及原配消音圈 | 60 套 | K01 每包 5 套，买 13 包共 65 套，装 60、余 5；大键也用普通中央轴座，不用 Deskeys 宽总成 |
| M05 | 胶碗 | 60 个位置 | K03 NiZ 45g 整张 1 张，取至少 60 个完整位置并按 HHKB 裁分；不是 K01 内含材料 |
| M06 | 锥形感应弹簧 | 60 | K02 NiZ 锥簧每包 5 个，买 13 包共 65，装 60、余 5；不是辅助回弹簧 |
| M07 | 钢板卫星轴及钢丝 | 1 套 | K04 原装 GMK Plate mount／2u 买 3 组，装六个壳和柱；用两根短丝，第三组改装 K05 单独 6U 长丝；短丝余 1 |
| M08 | 键帽 | 60 | K06 NicePBT BoW 当前完整套装 1 套，须含 6.0c Centered 居中空格；MX 接口 |
| M09 | 转接支柱 | 28 | YETI60-STANDOFF-46；黄铜 Ø3.5，肩长 4.50±0.03；上端 M2×0.4 外牙长 1.0，下端 M1.6×0.35 内牙深 3.2；H26 不装 |
| M10 | 上侧绝缘膜 | 28 | 聚酰亚胺 0.10±0.02 mm，外径 4.5／内径 1.8；支柱与 PCB 之间，H26 不装 |
| M11 | PCB 螺钉 | 28 | M1.6×5 盘头，头部包络和螺纹须首件确认；H26 不装 |
| M12 | PCB 垫片 | 28 | PEEK，外径不大于 4.0、内径 2.2、厚 0.8 mm；H26 不装，不换金属垫片 |
| M13 | 上壳嵌件 | 4 | 冷粘滚花黄铜 M3×0.5，外径 4.6、长 3.0；底孔 Ø4.85±0.05、深 3.5 |
| M14 | 子板嵌件 | 4 | 冷粘黄铜 M2×0.4，外径 3.2、长 2.5；底孔 Ø3.35±0.05、深 2.9 |
| M15 | 合壳螺钉 | 4 | 建议 M3×5 加 0.30 mm 薄垫；CAD 螺钉座 z=2.59、嵌件入口 z=4.79，名义啮合 2.50 mm；头径不大于 5.6，匹配 Ø5.8 沉孔 |
| M16 | 子板螺钉 | 4 | 建议 M2×4 加 0.30 mm 绝缘垫片；名义啮合 4−1.6062−0.30=2.0938 mm，嵌件长 2.5；头部与连接器间隙仍需检查 |
| M17 | 垫片安装胶棉 | 1 套 | 每层四片 33×3 mm；下侧原厚 2.0 mm、上侧 1.2 mm；装后各为 1.0162／0.5838 mm；受力／蠕变待验收 |
| M18 | 脚垫 | 4 个 | [SKUF 硅胶脚垫](https://keeb.io/products/skuf-silicone-rubber-keyboard-feet)，41.8×5.8×2 mm、45A、自带背胶；壳体有四个约 42.2×6.2 mm 的槽。买 1 包 8 个时剩 4 个备件 |
| M19 | 嵌件胶粘剂 | 适量 | 与树脂相容的结构环氧胶；仅冷粘，按供方要求固化，不得堵塞螺纹 |
| M20 | 电池固定及绝缘材料 | 1 套 | 非导电可拆固定及边缘防护；胶带厚度计入槽深预算，不能压紧软包电池 |

## 线束固定件与辅助材料

另需后侧底座 2 个、可拆桥 2 个、前侧底座 1 个；0.05 mm 可移除非导电双面胶及 3 片总厚不大于 0.10 mm 的保持膜。尺寸、公开 STEP／STL 和装配方法见[内部连接](interconnects.zh-CN.md)。[README 完整准备清单](../../README.zh-CN.md)另列垫片、片材采购量、工具及总成包含关系，避免重复计数。

## 工具及装配放行

需要 SWD 调试器和自定义 J3 探针治具、逐线测通及测极性的万用表、小扭矩工具、卡尺，以及操作 SW100 的绝缘工具。本方案不需要逐键二极管、MX 热插拔座或第二颗主控。数量不代表库存或价格保证。

FELK60 提供定位板及胶棉安装依据。已查阅提交 `64db818` 的 [DELTA OMEGA 材料表](https://github.com/wZuck/delta-omega/blob/main/docs/BOM.md)，参考其机械／电子分项及键帽包络说明方式；其 MX 轴、XIAO 主控及双电池不能直接替换本项目材料。[PH60 Rev.3](https://github.com/ph-design/PH60)的可拆电池托盘和较大电池空间可供底壳下挖方案参考，但不同的 FDM 外壳、PCB 和固件不能证明 YETI60 的装配或续航。
