wZuck/YETI60/variants/raytac/docs/build/ordering.zh-CN.md

[English](ordering.md) | 简体中文

# PCB 下单操作表

**当前候选板改用[首板制造文件与参数](../../hardware/usb-short-route/FIRST-ARTICLE.zh-CN.md)。** 本页下方链接的原主板压缩包仅作旧设计参考，不能用于修补候选板下单。C5 仍需单独采购或制板。

返回[制作总入口](../../BUILD.zh-CN.md)。本页给出设计规定的选项；实际报价界面名称可能改变。**尚未放行下单**，请先核对总入口的未关闭事项，不能用旧审查包代替本轮验证后的文件。

## 需要制作几种板

| 板 | 每把数量 | 文件 |
|---|---:|---|
| Raytac 主板 | 1 | [Gerber 与钻孔包](../../hardware/fabrication/yeti60-raytac-p2-dfm-review.zip)、[原生 PCB](../../hardware/ec60-nrf52840/EC60-nRF52840.kicad_pcb)、[导出及文件哈希](../audit/yeti60-fabrication.json) |
| C5 JSH | 买成品时 0；自焊时 1 | [固定版本上游 Gerber](https://raw.githubusercontent.com/Unified-Daughterboard/UDB-C-JSH/2b6c52aa2de6f9f60ca99c6250e4bdf01e8f4eea/production/UDB-C-JSH_5.0_gerbers.zip)、[自焊材料表](../../hardware/bom/daughterboard.zh-CN.csv) |

主板包不含 C5。J3 是主板上的 SWD 焊盘，不需要再制刷写板。定位板是金属机械件，不是 PCB。首样建议买完整 C5 JSH；不要买 S 版、JST-PH 版或只有接口没有 ESD 元件的简化板。

## 主板报价界面逐项选什么

| 项目 | 选择／填写 |
|---|---|
| 产品／板材 | 普通刚性 FR-4；不选铝基、柔性、Rogers 或 HDI |
| 层数 | 4 层；F.Cu、In1.Cu、In2.Cu、B.Cu，不能删内层 |
| 板厚 | **1.6 mm**；不要填 CAD 包络 1.6062 mm |
| 叠层 | 普通 **JLC04161H-7628**；外层到相邻内层介质目标 0.2104 mm；不得自行换叠层 |
| 外层铜 | 1 oz；内层按该普通叠层约 0.5 oz，不额外加厚 |
| 尺寸 | 自动识别板框约 **289.39×94.60 mm**；含右侧圆角支撑区，禁止裁回 285 mm 矩形 |
| 数量 | 一把净需 1 块；首轮建议装配 2 块，实际制板按平台起订量选择，余板留作备件 |
| 拼板 | 单款单片；不由买家自行拼板。贴片工艺边由装配商确认，不能压占电极或天线区域 |
| 阻焊／字符 | 绿色阻焊、白色字符；保留孔位、方向、编号和功能标识 |
| 表面处理 | ENIG 沉金，使用标准可选等级；不请求加厚硬金、金手指工艺 |
| 过孔 | 普通机械通孔，最小孔／盘 0.30／0.50 mm；普通盖油按工厂工艺确认 |
| 特殊孔工艺 | 不选盲埋孔、激光微孔、树脂塞孔、填孔封盖、盘中孔专项工艺；U5 的开放散热孔须审核吸锡 |
| 半孔／金手指／包边 | 均不需要；模块自身的半孔不等于主板需要做半孔 |
| 阻抗服务 | 当前文件不宣称已设计并验证 90 Ω 差分阻抗；不能勾选阻抗服务就当成 USB 合格。维持指定普通叠层，交付前复核 USB 路径，首样实测通讯与信号完整性 |
| 电测 | 要求裸板电测，对照 IPC-D-356 和原生网表，不接受删掉不通过的网络 |
| 厂家编号 | 不放在正面感应电极、模块天线及安装接触区域；位置须在审图时确认，不能自动覆盖功能图形 |
| 钢网 | 自行回流时需要主板 **B.Paste／背面**钢网 1 张；0.10 mm 不锈钢为待工艺确认起点；JP1 不开口，U5／U6 裸露盘减量／分窗与开放热孔吸锡须确认 |
| SMT／贴片 | 自焊选不贴片；委外时提交本版 BOM、75 件坐标表、原生 PCB 和钢网要求，由装配商确认模组及隐藏焊点能力；普通制板不保证所有元件可由平台现货贴装 |

上传后看 Gerber 预览：四层铜都存在、没有镜像或缩放、29 个安装孔和右侧圆角板框完整、PTH／NPTH 钻孔都识别。若自动识别尺寸、层数不符，停止支付并核对文件。制造商不得为了过审悄悄改感应铜、接地、钻孔、叠层或板框。

## C5 自焊选项

C5 是 **18.0×16.5 mm、4 层、1.6 mm**，安装孔矩形 14×12.5 mm。单独上传上游固定版本的压缩包；使用普通 FR-4、1 oz 外铜、绿色阻焊、白字、ENIG、普通通孔。不能复用主板的尺寸或贴片面；C5 钢网为 **F.Paste／正面**。其上游默认 DRC 有封装、courtyard 和 0.25 mm 板边等审查项，须板厂确认；本项目没有把这些告警伪装为零。自焊时 U1 数据保护、D1 电源保护、F1、R1／R2 与两个连接器共 7 件全部必装。

## 给板厂的备注

“YETI60 Raytac 工程首样，普通四层 FR-4，JLC04161H-7628，1.6 mm，标准沉金，普通机械通孔。保留全部感应铜、29 个安装中心和圆角支撑板框。不要改叠层或使用 HDI、填孔封盖。请按原生网表电测，列明任何线宽、间距、板边、钻孔及阻焊需调整处和坐标，修改前回传审图。”

[工艺规定](../../hardware/ec60-nrf52840/fabrication-notes.zh-CN.md)与[制造审查清单](../engineering/fabrication-review.zh-CN.md)是配套交付文件。能力依据为 [JLC 官方能力表](https://jlcpcb.com/capabilities/pcb-capabilities/)及[普通叠层资料](https://jlcpcb.com/impedance)，不把界面截图或报价当作已经取得的制造批准。

定位板另按[NiZ 钢板卫星轴方案及加工要求](key-mechanism.zh-CN.md)下单新的 1.60 mm 不锈钢 DXF，不是原过小定位板，也不是另一张 PCB；原主板不增加卫星轴安装孔。
