wZuck/YETI60/variants/raytac/docs/engineering/inventory-allocation.zh-CN.md

中文 | [English](inventory-allocation.md)

# YETI60 库存使用与补购清单

P2 版本，2026-10-29。按制作一把键盘、主板购买散件并自行焊接、**C5 JSH 子板购买成品**计算，计划**使用库存 10 只主板元件、补购 65 只**。这里是元件只数，不是型号种类数。这些库存选用不需要改动 PCB、固件、外壳或电池规格。

[主板补购表](../../hardware/bom/mainboard-purchase.zh-CN.csv) 列出所有实装位号、需要数量、计划用库存数量及净补购数量。外壳、静电容轴体、电池、线束、导线支架、耗材和工具仍按 [README 完整准备清单](../../README.zh-CN.md#一把键盘需要准备的完整材料) 准备。这些项目暂未分配经过确认的直接兼容库存，需要补购或先完成实物兼容性检查。

## 计划用于主板的库存

README 的主板及可选自焊 C5 表格逐行标注计划用库存、需补购数量和库存备注。已收货池按库存来源行共享：C9／C11／C12 与 C31 共用同一池 100 只，不能按材料表各行重复相加。同系列 C5 USB 座标为已有但待确认，暂不抵扣。分配生成器同步更新两种语言的表格，材料检查会拒绝过期的数量或备注。

| 库存明细行号 | 库存型号及规格 | 记录已收货只数 | 记录在途只数，不计入 | 位号 | 使用数量 | 按记录计算的使用后余量 |
|---|---|---:|---:|---|---:|---:|
| 48 | Samsung CL05B104KO5NNNC，100 nF、16 V、10%、X7R、0402 | 100 | 100 | C9、C11、C12、C31 | 4 | 96 |
| 57 | Samsung CL05A105KA5NQNC，1 µF、25 V、10%、X5R、0402 | 50 | 100 | C13、C48 | 2 | 48 |
| 50 | Uniroyal 0402WGF0000TCE，零欧姆、0402 | 100 | 100 | R30、R31 | 2 | 98 |
| 51 | Uniroyal 0402WGF1001TCE，1 kΩ、1%、62.5 mW、0402 | 100 | 100 | R17 | 1 | 99 |
| 52 | Uniroyal 0402WGF1002TCE，10 kΩ、1%、62.5 mW、0402 | 100 | 100 | R26 | 1 | 99 |

电容系列的标称规格和封装符合电路要求，但这不代表已经验证实际库存器件的真伪、状态或直流偏压下有效容量。沿用现有电容验收要求，包括相关位置 3.3 V 工作偏压下的有效容量确认。装配前核对料带标签并清点实际未使用数量。零欧姆器件作为跳线使用，须按其额定电流验收，不能用标称电阻功率或零欧姆的“1% 精度”判断承载能力。

原表根据订单整理，并不是当前实际盘点结果。E 列是已收货**只数**，H 列是在途只数；D 列是采购份数，不能当作可用元件数。上表余量是计划值，不是库存账扣减。本次没有将任何库存标记为已消耗，也没有修改原始表格。

每种库存的可用输入取“记录已收货只数”，分配给所有匹配位号的总量不超过这个数。每组材料的计算方式为：`净补购数量 = 需要数量 − 计划库存分配数量`。主板合计为 `75 − (4 + 2 + 2 + 1 + 1) = 65`。在途数量不计入。JP1 保持不装，J3 保持为裸露刷写触点。

## C5 JSH 自焊选项与待确认库存

默认购买一块成品子板，其中七只元件已经包含，不再购买散件。如果改为购买 **C5 裸板自行焊接**，库存第 55 行的 Uniroyal 0402WGF5101TCE（5.1 kΩ、1%、0402）可为 C5 的 R1／R2 提供两只；记录已收货 100 只。这种选项两块板合计使用 12 只库存电子元件，仍需准备 C5 其余五只元件，主板补购量仍为 65 只。其余五只以 [固定版本的上游 C5 材料表](https://github.com/Unified-Daughterboard/UDB-C-JSH/blob/2b6c52aa2de6f9f60ca99c6250e4bdf01e8f4eea/production/UDB-C-JSH_5.0_bom.csv) 为准。

| 库存行号 | 潜在用途 | 判断与尚缺证据 |
|---|---|---|
| 43 | TYPE-C-31-M-12，供自焊 C5 的 J1 使用 | 记录已收货六只。型号系列文字一致，但库存标为国产替代，上游指定 Korean Hroparts。须核对触点、固定脚、插接高度及线序后才能分配。成品 C5 已包含插座。 |
| 21 | M2×5、头径 4 mm，固定子板 | 记录已收货 200 只。当前为 M2×4 搭配 0.30 mm 绝缘垫圈。使用库存 5 mm 螺丝及原垫圈时，标称啮合为 3.0938 mm，超过 2.5 mm 嵌件深度。若绝缘垫片总厚度改为 1.30 mm，可恢复 2.0938 mm 啮合，但必须先检查头高、连接器空间、实际螺纹及固定可靠性。默认清单暂不抵扣。 |
| 22 | M3×8、头径 5 mm，固定外壳 | 记录已收货 100 只。当前为 M3×5 搭配 0.30 mm 垫片。垫片总厚度改为 3.30 mm 可恢复设计的 2.50 mm 啮合。5 mm 头径符合标称 5.8 mm 沉孔，但实际头高、工具操作空间、垫片支承面及螺距尚未确认。默认清单不抵扣，也不额外列购替代垫片。 |
| 19 | 现有 133 键键帽套装 | 轴心接口、6U 空格及卫星轴间距尚未确认。先选定成套兼容 Topre 的滑块／轴壳后再检查，不直接算作 60 个兼容键帽。 |
| 41–42 | 耳机编织线，用于内部线束 | 未明确线规、每根绝缘外径、弯折性能及 SH／PH 压接适配性。设计要求 AWG28 多股铜线、单根外径不超过 0.8 mm，先保留指定线束。 |

以上垫片替代方案只是尺寸初筛计算，尚未写入已接受的 CAD 或装配步骤。库存不能通过这些检查时，购买默认规格螺丝。当前默认材料与装配图保持一致。

## 不能替代当前需求的库存

| 库存行号 | 库存物料 | 不采用原因及保留要求 |
|---|---|---|
| 49 | CL21A106KAYNNNE，10 µF、25 V、0805 | C30／C41／C42／C43／C45／C46 要求 0603。容量相同、耐压更高不代表较大封装能装入焊盘；补购六只符合要求的 0603 10 µF。 |
| 48、57 | 0402 的 100 nF 和 1 µF 电容 | C44 和 C40 为 0603，上面的库存分配刻意未包括这两个位号。不能为了消耗库存，未经电气和布局复核就缩小充电器输入电容。 |
| 44–45 | 0402 15 pF、0603 20 pF | C10 要求 0402、220 pF、C0G。容量不符，20 pF 的封装也不符。 |
| 46、53–54 | 0603 10 Ω、0402 27 Ω、0402 4.7 kΩ | 没有匹配的实装阻值／封装。不能用于近似替代 USB 零欧姆跳线、充电设定电阻或增益电阻。 |
| 47、56 | 100／600 Ω 磁珠 | 特定频率下的阻抗不是 1.5 µH 电感量。L1 保持 Wurth 74438336015 或经过独立确认的替代件。 |
| 12 | MF-MSMF075-2，1812、保持电流 0.75 A | 主板 F1 为 1206／0.5 A；C5 F1 按上游为 ASMD1206-150，1206／1.5 A。库存与两者的封装及电流要求都不匹配。 |
| 9 | USBLC6-2SC6，SOT-23-6 | 主板 D1 为 SOT-143 的 PRTR5V0U2X；C5 U1 为 uSON-10 的 TPD4E05U06DQAR。封装和线序不同，不能直接替换。 |
| 8、39 | RP2040、nice!nano nRF52840 开发板 | U1 为焊接在主板上的 Raytac MDBT50Q-1MV2 模组。两种库存都不匹配焊盘，继续保持单主控方案。 |
| 37 | 301230、110 mAh 电芯 | 无法满足指定的受保护 1600 mAh 电池包、独立温度切断及第三线 NTC 要求。当前典型充电约 403 mA，对 110 mAh 电芯约为 3.65C，库存没有支持该充电倍率的规格证据。购买指定电池包，不将此电芯接到当前充电设置上。 |
| 23 | M1.6×2 螺丝 | 需要 28 只 M1.6×5，H26 不装。标称可到达深度为 `2 − 0.8 − 1.6062 − 0.1 = −0.5062 mm`，库存短螺丝甚至无法接触转接铜柱螺纹。 |
| 24–25 | M2 双通 6／18 mm 铜柱 | 需要肩高 4.50 mm、上部 M2 外牙、下部 M1.6 内牙的转接柱。高度与螺纹结构不符。 |
| 26–28、30 | MSK 微型拨动开关、6×6 mm PTS645 轻触开关 | 不匹配 JS102011SAQN 电源开关、EVQPUC02K 复位开关的焊盘和操作空间。 |
| 17–18 | 7U MX 卫星轴、MX 静音圈 | 无法提供匹配的兼容 Topre 轴壳、胶碗、锥形感应弹簧或 HHKB 6U 空格机构。 |
| 14–15 | SK6812 RGB 灯 | 当前 D2 为普通 0603 状态指示灯，没有相应 RGB 焊盘或固件功能。 |
| 58 | K-704N 室温硫化硅胶 | 未验证可替代树脂嵌件用结构环氧胶，也未验证适合薄型、可拆卸的电池固定。继续使用指定的胶粘／绝缘方案。 |
| 6–7、10–11、13、16、20、29、31–36、40 | 存储器、触摸／电平转换芯片、二极管、晶振、旋钮／编码器、导航开关、显示屏及音频插头 | 当前没有对应实装需求，不能替代静电容模拟前端或按键机构。 |

其他非元件记录不参与分配。不公开购物订单号、商家联系方式、无关购买明细或原始库存表。

## 依据与刷新方式

私有源表 SHA-256 为 `8a93ff0d1690e40ed8a3c9b1988946915bd4c6c8dc82e189426a1ef25d8a10de`；上文行号均指向“库存明细”工作表。只将相关库存字段录入 [库存分配输入](../../hardware/bom/inventory-allocation.json)。它是一次快照，不会自动同步库存。其他项目使用了元件，或在途商品到货后，先清点并更新脱敏数量，再运行 `python3 scripts/plan_yeti60_inventory.py`。

厂商核对依据：[Samsung 2024 年 1 月 MLCC 目录](https://www.samsungsem.com/resources/file/kr/support/product_catalog/MLCC_2401.pdf) 印刷页码 50、63，列有 CL05A105KA5NQN# 和 CL05B104KO5NNN# 的上述尺寸／参数，`#` 为订货后缀位置。这是系列规格证据，仍需核对实际来料的完整后缀及标签。[Uniroyal 2024 年 6 月目录](https://www.uni-royal.cn/images/upload/UniroyalCatalog2024.06.07.pdf) 第 10–12、175 页说明 0402 尺寸、普通规格 1/16 W、零欧姆额定 1 A，以及 WG／F 的功率／精度编码。验收条件以 [当前主板材料表](../../hardware/bom/mainboard.zh-CN.csv)、[材料要求](materials.zh-CN.md)、[内部连接](interconnects.zh-CN.md) 和 [电池包规格](battery-pack-specification.zh-CN.md) 为准。公开的厂商参数不等于已经验证库存真伪或键盘实测结果。
