wZuck/YETI60/hardware/bom/daughterboard.csv

References | Quantity | Manufacturer and specified MPN | Package | LCSC code | Planned stock use | Net purchase
D1 | 1 | FTR SMF6.0A | SOD-123FL | C708002 | 0 | 1
F1 | 1 | Shenzhen JDT Fuse ASMD1206-150 | F1206 | C135342 | 0 | 1
J2 | 1 | JST SM04B-SRSS-TB(LF)(SN) | SM04B-SRSS-TB(LF)(SN)_mounting-reliefs | C160404 | 0 | 1
J1 | 1 | Korean Hroparts TYPE-C-31-M-12 | TYPE-C-31-M-12 | C165948 | 0 | 1
R1, R2 | 2 | Uniroyal 0402WGF5101TCE | R0402 | C25905 | 2 | 0
U1 | 1 | Texas Instruments TPD4E05U06DQAR | uSON-10 | C138714 | 0 | 1
