wZuck/YETI60/hardware/e73-usb-repair/mechanical/yeti60-e73-usb-battery-bottom-m03.step

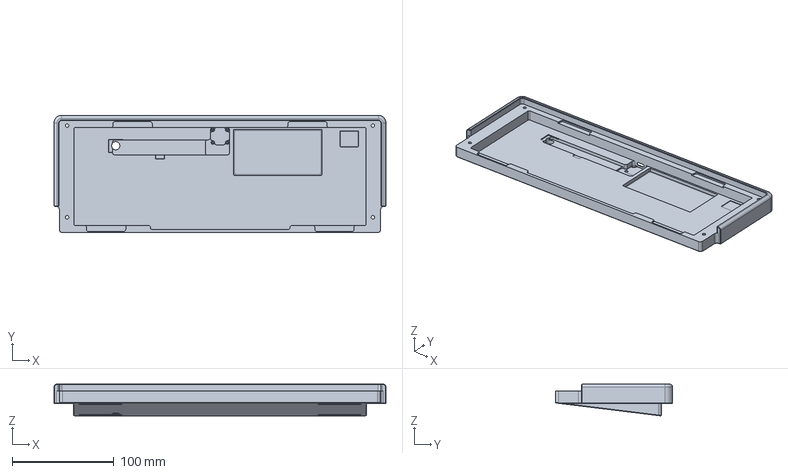
[picture p25: CAD file, 2026-11-13]
hardware/e73-usb-repair/mechanical/yeti60-e73-usb-battery-bottom-m03.step
325.7 x 115.2 x 31.2 mm
