wZuck/YETI60/mechanical/e73-fit/yeti60-e73-niz-m01.step

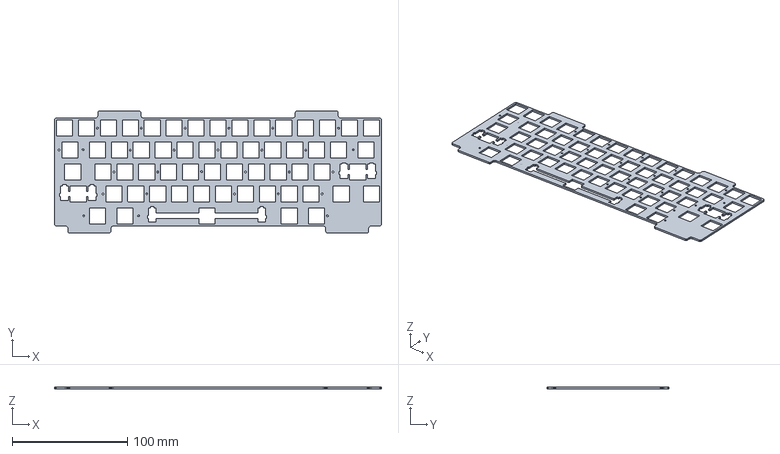
[picture p26: CAD file, 2026-11-12]
mechanical/e73-fit/yeti60-e73-niz-m01.step
284.2 x 106.3 x 1.60 mm
