wZuck/YETI60/mechanical/felk60_plate_hhkb.plate-mount.dxf

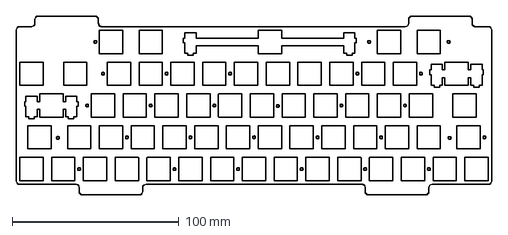
[picture p27: CAD file, 2026-11-02]
mechanical/felk60_plate_hhkb.plate-mount.dxf
285.0 x 107.1 mm
