wZuck/YETI60/mechanical/generated/interconnect-guides/rear-2-base.step

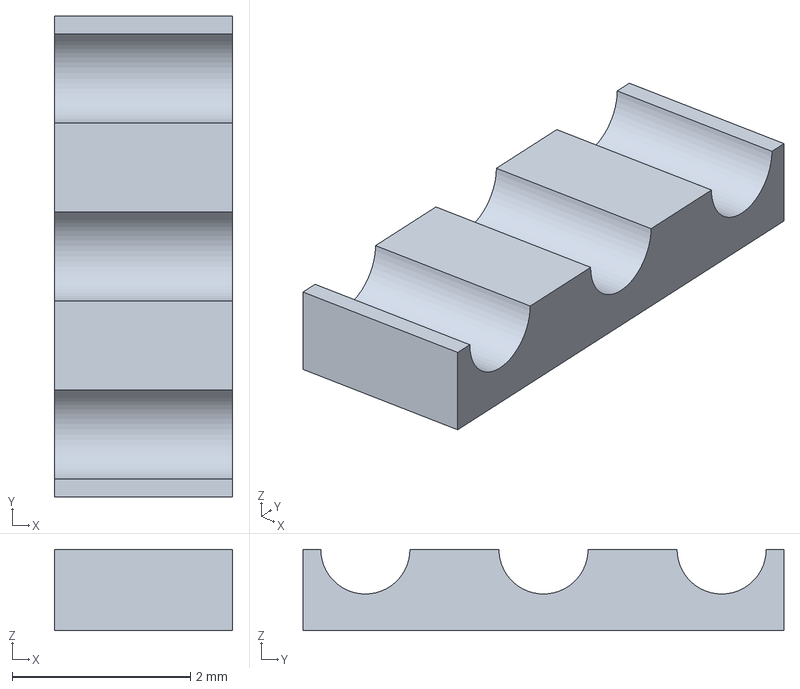
[picture p28: CAD file, 2026-10-29]
mechanical/generated/interconnect-guides/rear-2-base.step
2.00 x 5.40 x 0.91 mm
