wZuck/YETI60/variants/raytac/hardware/usb-short-route/mechanical/guides/USB-R2.step

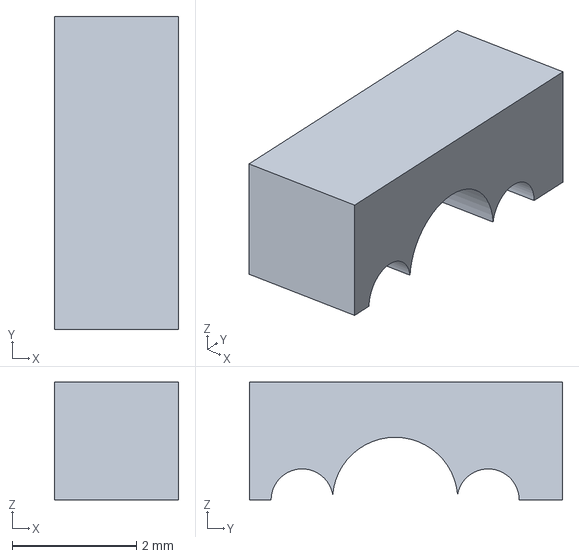
[picture p29: CAD file, 2026-11-03]
variants/raytac/hardware/usb-short-route/mechanical/guides/USB-R2.step
2.00 x 5.05 x 1.90 mm
