wZuck/YETI60/variants/raytac/hardware/usb-short-route/mechanical/harness/battery-3.step

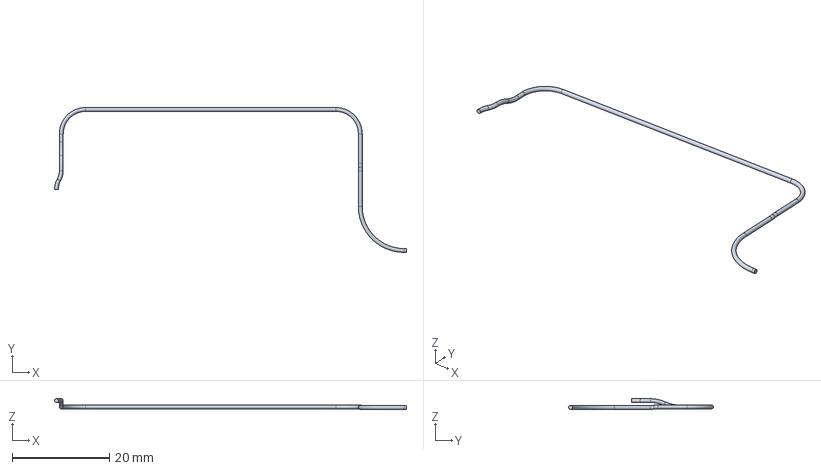
[picture p30: CAD file, 2026-11-11]
variants/raytac/hardware/usb-short-route/mechanical/harness/battery-3.step
72.4 x 29.8 x 2.20 mm
