wZuck/YETI60/variants/raytac/hardware/usb-short-route/models/JST_S3B-PH-SM4-TB_Celestial.step

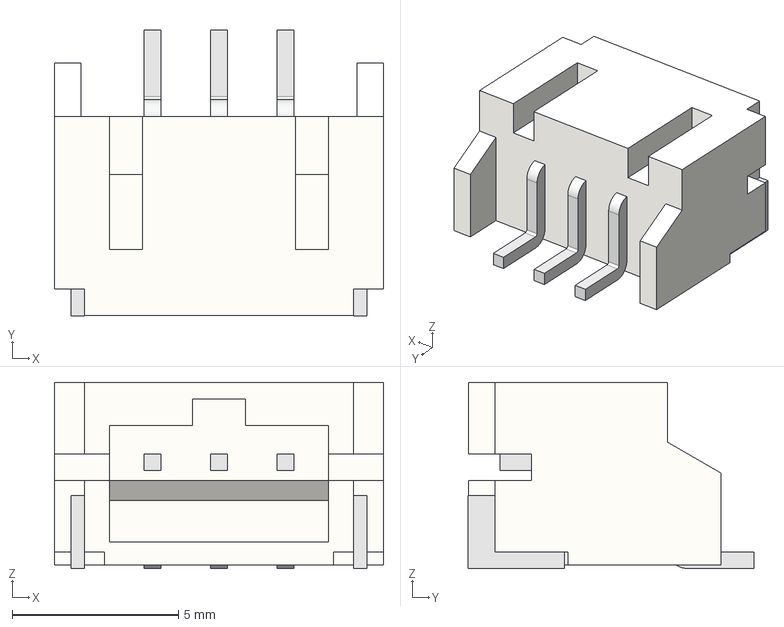
[picture p31: CAD file, 2026-11-07]
variants/raytac/hardware/usb-short-route/models/JST_S3B-PH-SM4-TB_Celestial.step
9.90 x 8.61 x 5.60 mm
