wZuck/YETI60/mechanical/felk60_plate_hhkb.deskeys.dxf

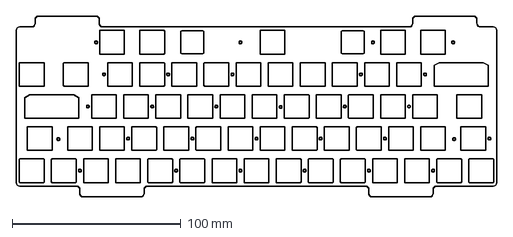
[picture p32: CAD file, 2026-11-01]
mechanical/felk60_plate_hhkb.deskeys.dxf
285.0 x 107.1 mm
