wZuck/YETI60/variants/raytac/hardware/usb-short-route/mechanical/harness/battery-1.step

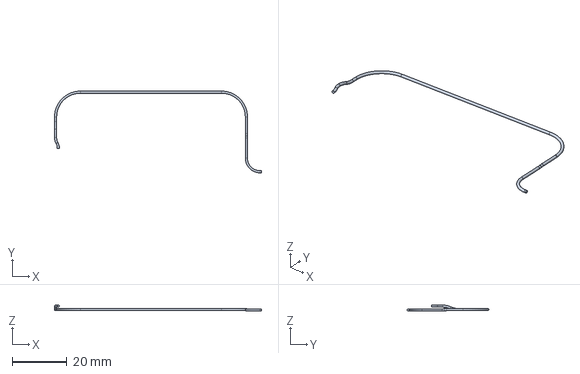
[picture p33: CAD file, 2026-11-11]
variants/raytac/hardware/usb-short-route/mechanical/harness/battery-1.step
75.4 x 29.8 x 2.20 mm
