wZuck/YETI60/variants/raytac/hardware/usb-short-route/mechanical/yeti60-niz-pm1-c04.dxf

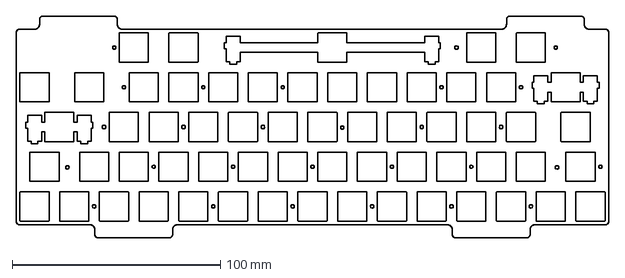
[picture p34: CAD file, 2026-11-05]
variants/raytac/hardware/usb-short-route/mechanical/yeti60-niz-pm1-c04.dxf
284.2 x 106.3 mm
