wZuck/YETI60/variants/raytac/hardware/usb-short-route/models/TI_RGT16_3x3_EP1p68_dimensioned.step

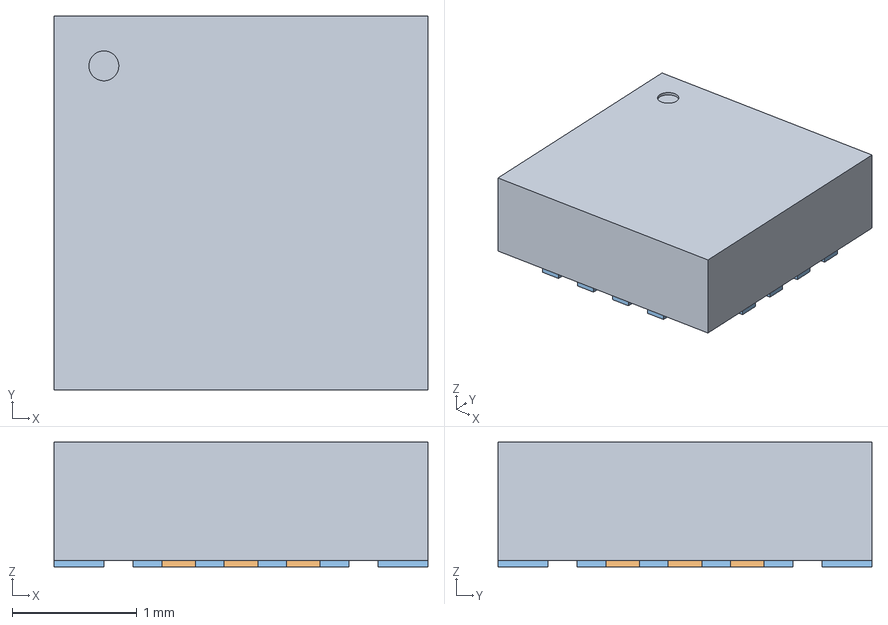
[picture p35: CAD file, 2026-11-07]
variants/raytac/hardware/usb-short-route/models/TI_RGT16_3x3_EP1p68_dimensioned.step
3.00 x 3.00 x 1.00 mm
