wZuck/YETI60/mechanical/felk60_plate_hhkb.audited.dxf

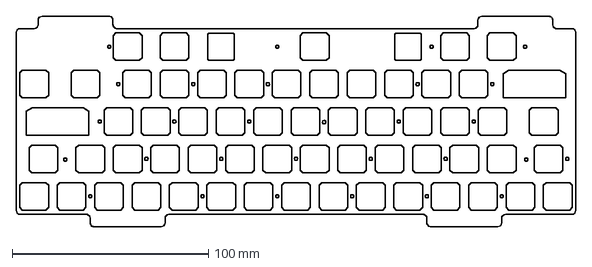
[picture p36: CAD file, 2026-10-27]
mechanical/felk60_plate_hhkb.audited.dxf
285.0 x 107.1 mm
