wZuck/YETI60/mechanical/generated/interconnect-guides/front-base.step

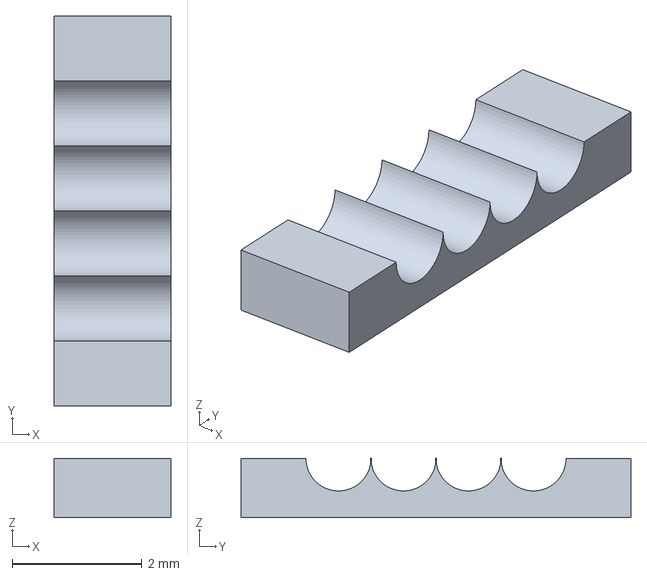
[picture p37: CAD file, 2026-10-29]
mechanical/generated/interconnect-guides/front-base.step
1.80 x 6.00 x 0.91 mm
