wZuck/YETI60/mechanical/generated/yeti60-standoff-46.step

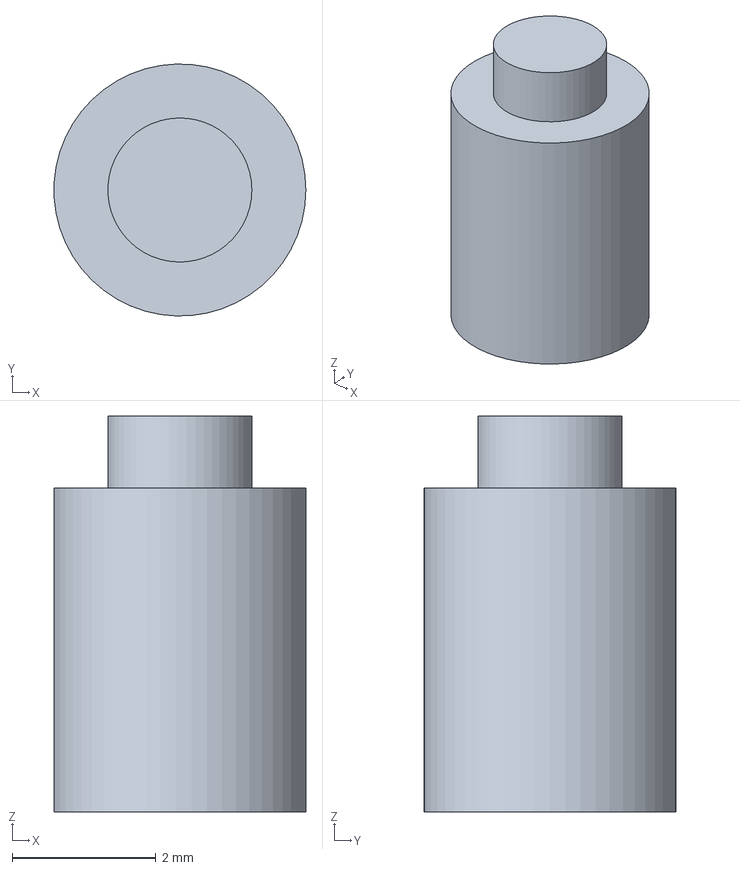
[picture p38: CAD file, 2026-10-28]
mechanical/generated/yeti60-standoff-46.step
3.50 x 3.50 x 5.50 mm
