wZuck/YETI60/variants/raytac/hardware/usb-short-route/mechanical/harness/battery-2.step

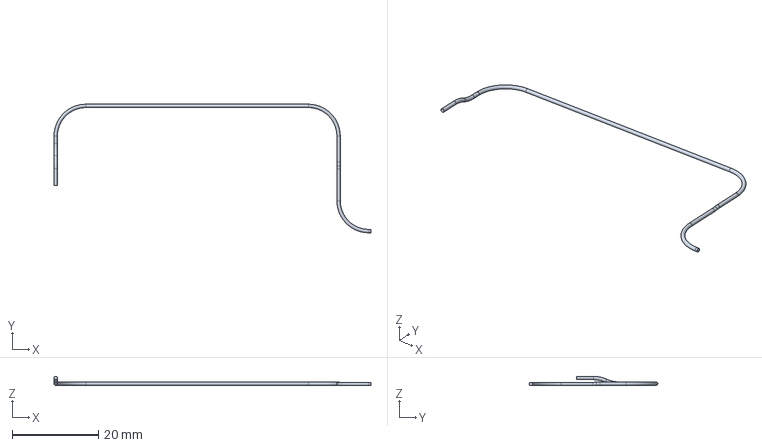
[picture p39: CAD file, 2026-11-11]
variants/raytac/hardware/usb-short-route/mechanical/harness/battery-2.step
73.4 x 29.8 x 2.20 mm
