wZuck/YETI60/variants/raytac/hardware/usb-short-route/models/CK_JS102011SAQN_dimensioned.step

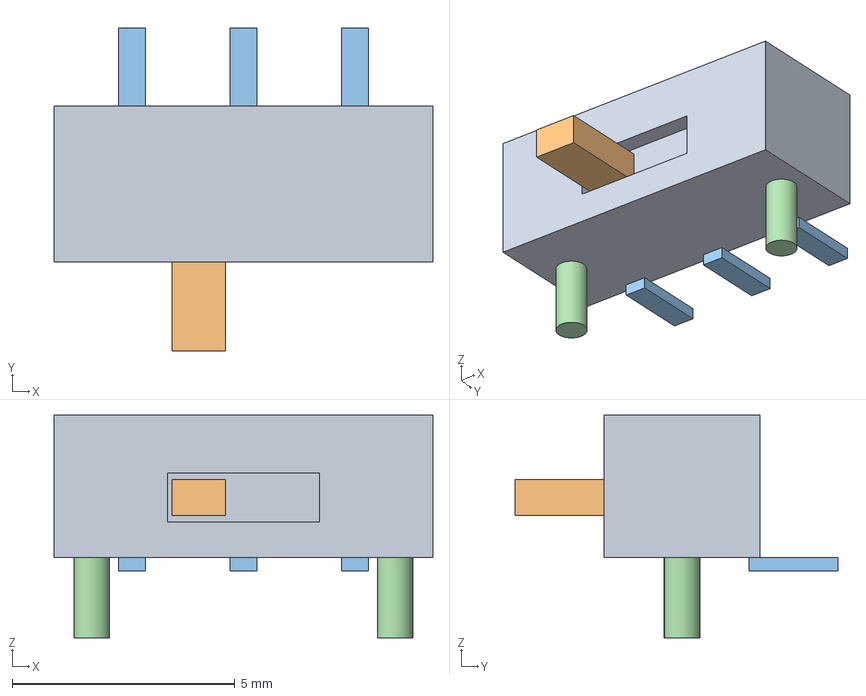
[picture p40: CAD file, 2026-11-07]
variants/raytac/hardware/usb-short-route/models/CK_JS102011SAQN_dimensioned.step
8.50 x 7.25 x 5.00 mm
