wZuck/YETI60/mechanical/generated/interconnect-guides/rear-2-bridge.step

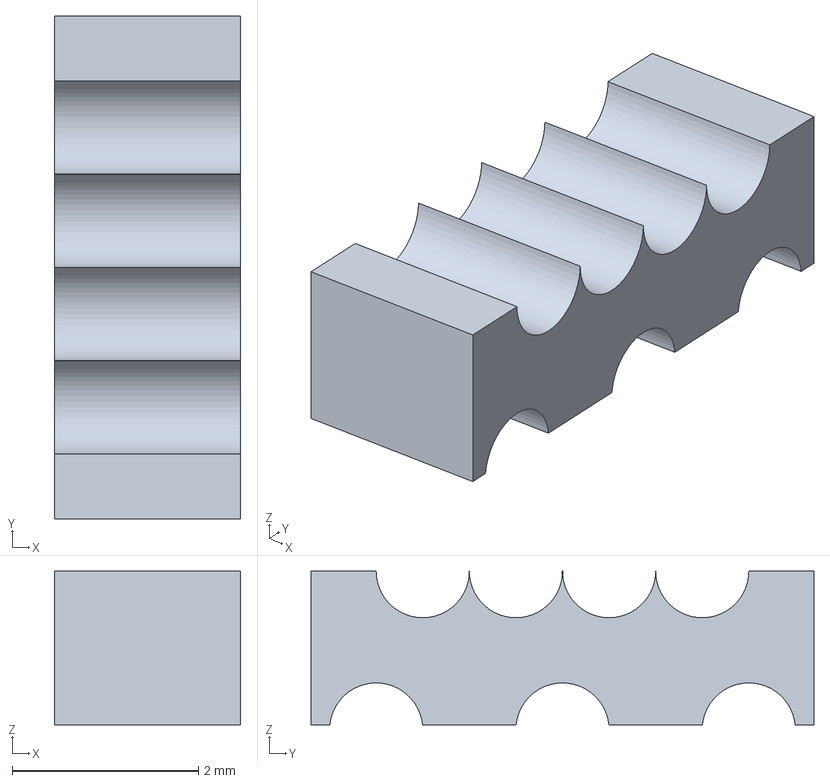
[picture p41: CAD file, 2026-10-29]
mechanical/generated/interconnect-guides/rear-2-bridge.step
2.00 x 5.40 x 1.65 mm
