wZuck/YETI60/mechanical/generated/yeti60-top.step

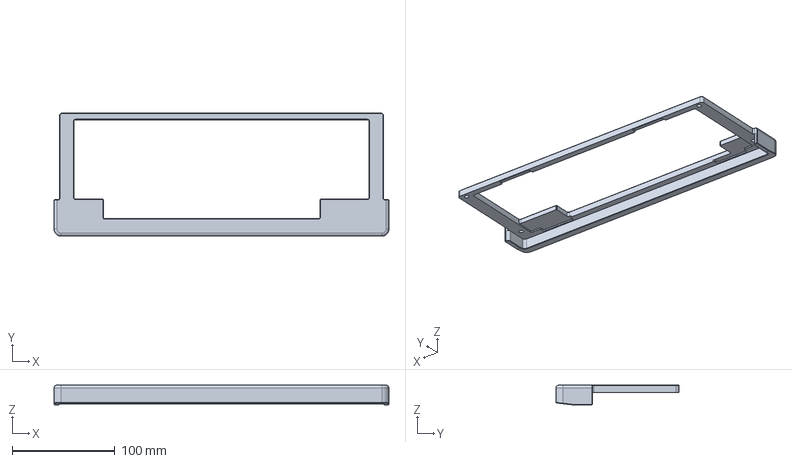
[picture p42: CAD file, 2026-10-28]
mechanical/generated/yeti60-top.step
325.7 x 120.0 x 19.2 mm
