wZuck/YETI60/variants/raytac/hardware/usb-short-route/mechanical/guides/USB-F2-lid.step

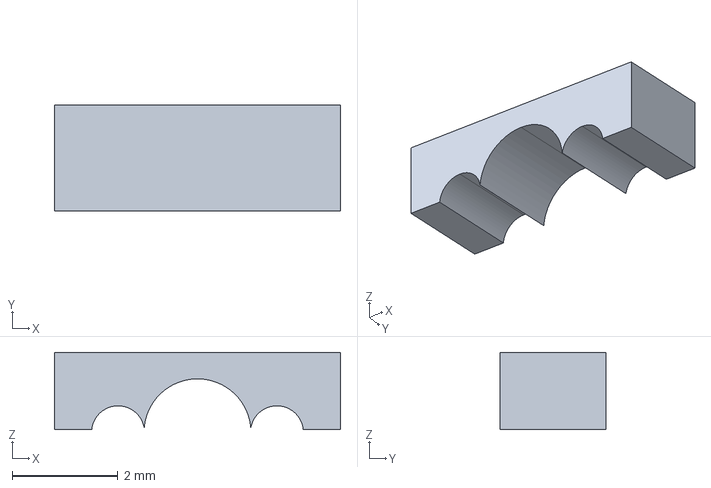
[picture p43: CAD file, 2026-11-02]
variants/raytac/hardware/usb-short-route/mechanical/guides/USB-F2-lid.step
5.40 x 2.00 x 1.46 mm
