wZuck/YETI60/variants/raytac/hardware/usb-short-route/mechanical/harness/usb-4.step

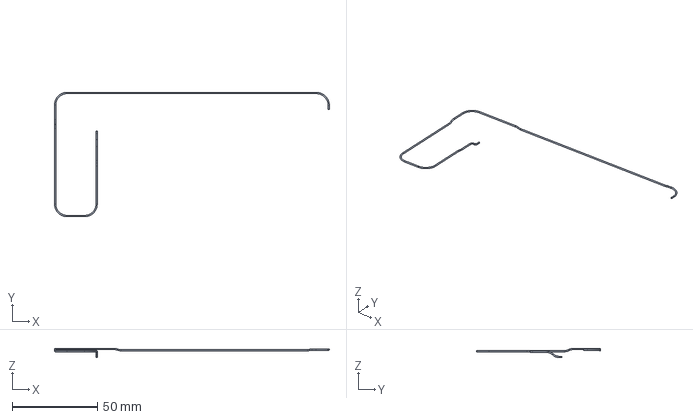
[picture p44: CAD file, 2026-11-03]
variants/raytac/hardware/usb-short-route/mechanical/harness/usb-4.step
161.3 x 73.0 x 5.50 mm
