wZuck/YETI60/variants/raytac/hardware/usb-short-route/models/Littelfuse_0466001_NRHF_nominal.step

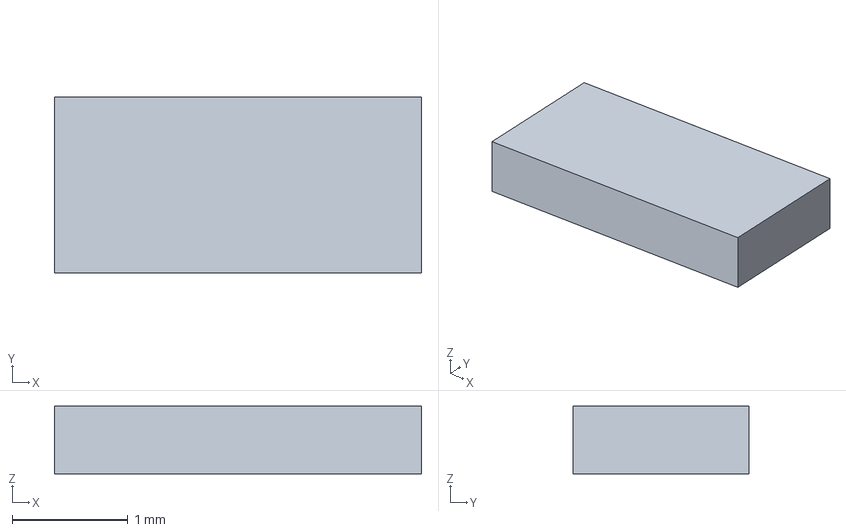
[picture p45: CAD file, 2026-11-03]
variants/raytac/hardware/usb-short-route/models/Littelfuse_0466001_NRHF_nominal.step
3.17 x 1.52 x 0.584 mm
