wZuck/YETI60/variants/raytac/hardware/usb-short-route/mechanical/harness/usb-3.step

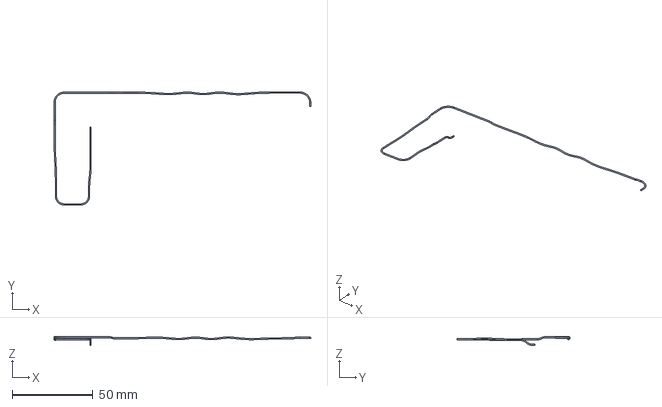
[picture p46: CAD file, 2026-11-03]
variants/raytac/hardware/usb-short-route/mechanical/harness/usb-3.step
159.2 x 70.1 x 5.50 mm
