wZuck/YETI60/variants/raytac/hardware/usb-short-route/mechanical/guides/USB-F2-base.step

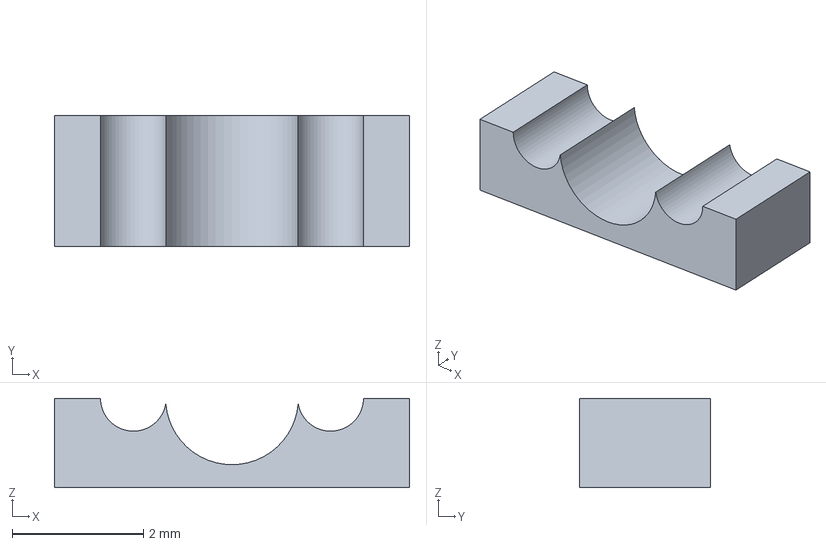
[picture p47: CAD file, 2026-11-02]
variants/raytac/hardware/usb-short-route/mechanical/guides/USB-F2-base.step
5.40 x 2.00 x 1.36 mm
