wZuck/YETI60/variants/raytac/hardware/usb-short-route/mechanical/harness/usb-2.step

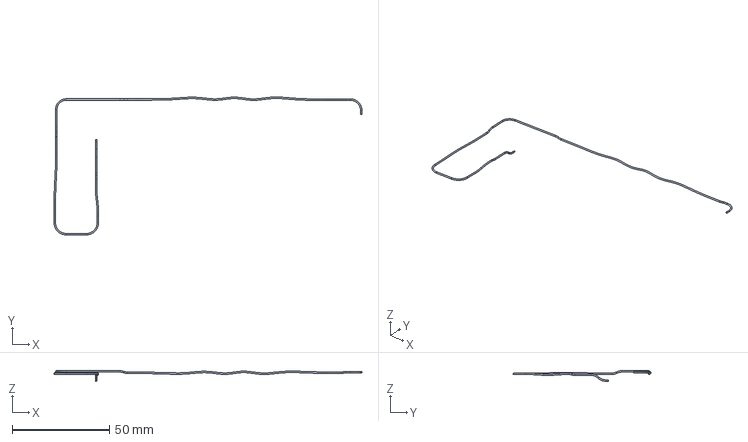
[picture p48: CAD file, 2026-11-03]
variants/raytac/hardware/usb-short-route/mechanical/harness/usb-2.step
158.2 x 70.9 x 5.50 mm
