wZuck/YETI60/variants/raytac/hardware/usb-short-route/mechanical/harness/usb-1.step

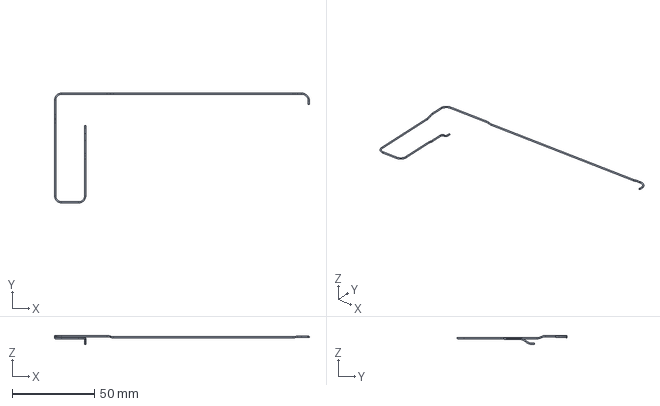
[picture p49: CAD file, 2026-11-03]
variants/raytac/hardware/usb-short-route/mechanical/harness/usb-1.step
155.3 x 67.0 x 5.50 mm
