wZuck/YETI60/variants/raytac/hardware/usb-short-route/mechanical/guides/PWR-R3.step

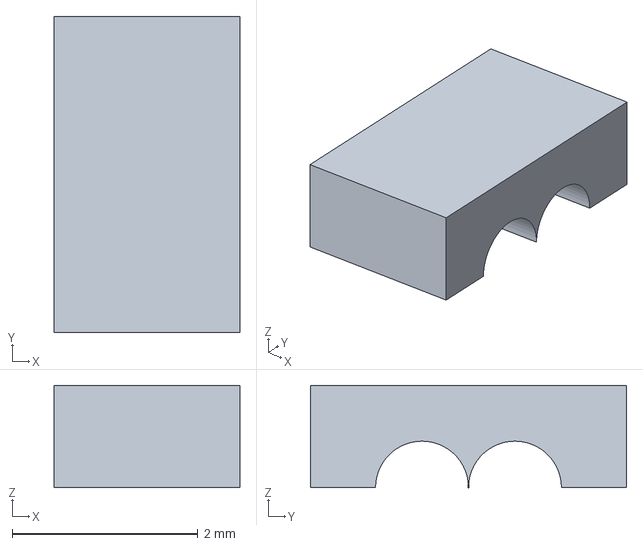
[picture p50: CAD file, 2026-11-02]
variants/raytac/hardware/usb-short-route/mechanical/guides/PWR-R3.step
2.00 x 3.40 x 1.10 mm
