wZuck/YETI60/variants/raytac/hardware/usb-short-route/mechanical/harness/power-2.step

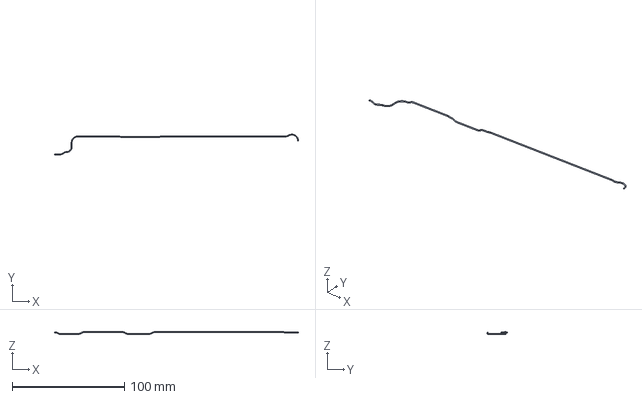
[picture p51: CAD file, 2026-11-02]
variants/raytac/hardware/usb-short-route/mechanical/harness/power-2.step
217.7 x 18.4 x 2.50 mm
