wZuck/YETI60/variants/raytac/hardware/usb-short-route/mechanical/harness/power-1.step

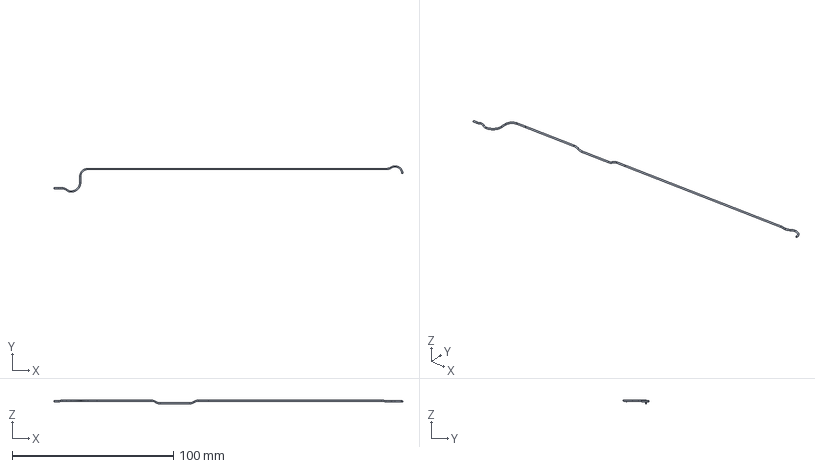
[picture p52: CAD file, 2026-11-02]
variants/raytac/hardware/usb-short-route/mechanical/harness/power-1.step
216.7 x 16.4 x 2.50 mm
