wZuck/YETI60/variants/raytac/hardware/usb-short-route/mechanical/guides/PWR-F-lower.step

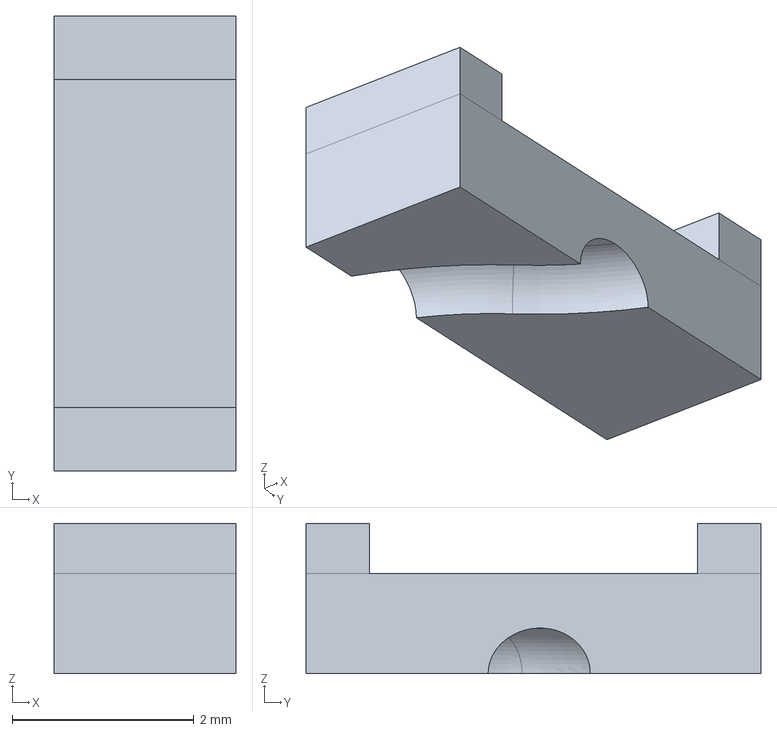
[picture p53: CAD file, 2026-11-02]
variants/raytac/hardware/usb-short-route/mechanical/guides/PWR-F-lower.step
2.00 x 5.00 x 1.65 mm
