wZuck/YETI60/(list of files, cad)

Other CAD files:
mechanical/generated/yeti60-bottom.step
variants/raytac/hardware/usb-short-route/mechanical/yeti60-bottom-short-usb.step
hardware/e73-usb-repair/mechanical/yeti60-e73-usb-bottom-m02.step
mechanical/e73-fit/yeti60-e73-bottom-m01.step
mechanical/generated/interconnect-guides/rear-1-base.step
mechanical/generated/yeti60-bottom-battery-pocket.step
variants/raytac/hardware/usb-short-route/mechanical/guides/USB-R1.step
variants/raytac/hardware/usb-short-route/mechanical/guides/USB-R3.step
mechanical/generated/interconnect-guides/rear-1-bridge.step
variants/raytac/hardware/usb-short-route/mechanical/guides/BAT-R1.step
variants/raytac/hardware/usb-short-route/mechanical/guides/USB-F1-lid.step
variants/raytac/hardware/usb-short-route/mechanical/guides/PWR-R2.step
variants/raytac/hardware/usb-short-route/mechanical/guides/PWR-R5.step
variants/raytac/hardware/usb-short-route/mechanical/guides/PWR-R1.step
variants/raytac/hardware/usb-short-route/mechanical/guides/USB-F1-base.step
variants/raytac/hardware/usb-short-route/mechanical/guides/BAT-R2.step
variants/raytac/hardware/usb-short-route/mechanical/guides/PWR-R4.step
hardware/e73-usb-repair/mechanical/yeti60-e73-usb-battery-bottom-m03.stl
hardware/e73-usb-repair/mechanical/yeti60-e73-usb-bottom-m02.stl
mechanical/e73-fit/yeti60-e73-bottom-m01.stl
mechanical/generated/interconnect-guides/front-base.stl
mechanical/generated/interconnect-guides/rear-1-base.stl
mechanical/generated/interconnect-guides/rear-1-bridge.stl
mechanical/generated/interconnect-guides/rear-2-base.stl
mechanical/generated/interconnect-guides/rear-2-bridge.stl
variants/raytac/hardware/usb-short-route/mechanical/guides/BAT-R2.stl
variants/raytac/hardware/usb-short-route/mechanical/guides/PWR-F-lower.stl
variants/raytac/hardware/usb-short-route/mechanical/guides/PWR-F-upper.stl
variants/raytac/hardware/usb-short-route/mechanical/guides/PWR-R3.stl
variants/raytac/hardware/usb-short-route/mechanical/guides/USB-F1-base.stl
variants/raytac/hardware/usb-short-route/mechanical/guides/USB-F1-lid.stl
variants/raytac/hardware/usb-short-route/mechanical/guides/USB-F2-base.stl
variants/raytac/hardware/usb-short-route/mechanical/guides/USB-F2-lid.stl
variants/raytac/hardware/usb-short-route/mechanical/guides/USB-R1.stl
variants/raytac/hardware/usb-short-route/mechanical/yeti60-bottom-short-usb.stl
