wZuck/YETI60/docs/engineering/fabrication-review.zh-CN.md

[English](fabrication-review.md) | 中文

# P2 制板与贴装审查交付

[审查压缩包](../../hardware/fabrication/yeti60-e73-p2-dfm-review.zip)供板厂和贴片厂进行可制造性审查，不代表已获下单许可。运行 `python3 scripts/export_yeti60_fabrication.py` 可重新生成；[清单](../audit/yeti60-fabrication.json)记录压缩包与 PCB、物料表、工艺说明的哈希关系。

## 交付内容

包含四层铜、双面阻焊／钢网／丝印／装配层、板框、分开的金属化／非金属化通孔钻孔文件、IPC-D-356 电测网表、76 个实装器件的坐标表、中英文采购要求和普通工艺说明。JP1 不装。电极和治具几何不计入采购与贴装，但保留在 PCB 和光绘中。此包仅含主板；C5 JSH 子板按成品单独采购。

导出程序确认没有层对盲孔文件、76 个实装坐标完整，并确认 PCB 源文件没有被导出过程改写。坐标采用 KiCad 绝对原点、毫米单位，背面 X 不取反；贴片厂须对照原生 PCB 和首件确认旋转与正反面约定。包内清单记录各文件哈希，两种语言的技术要求一致。

## 必须取得的书面工艺答复

| 项目 | 供应商须答复的内容 |
|---|---|
| 叠层 | 选择 JLC04161H-7628 普通四层、1.6 mm 标称，确认 1.44–1.76 mm 厚度范围；CAD 1.6062 mm 含模型阻焊，不是特殊下单板厚。详见[普通工艺说明](../../hardware/ec60-nrf52840/fabrication-notes.zh-CN.md) |
| 通孔 | 所有过孔为普通机械通孔，最小焊盘／孔径 0.50／0.30 mm；不得转换成盲埋孔或要求特殊填孔 |
| 模组引出 | 确认无 U1 盘中孔；两个信号通过焊盘外通孔引出，不要求盖铜 |
| 表面与贴装 | 沉金；审查 U1 模组、U5 裸露散热盘、U5 散热孔吸锡、钢网开口、清洗和检测 |
| 几何 | 所有线宽、间距、钻孔、槽孔、阻焊或装配边界让步均须在带坐标图上指出，不能静默改变电极铜形状、连接网络或已规定的普通叠层 |
| 验收 | 按原生网表电测，提交常规尺寸／板厚检查，并确认焊接工艺 |

现存 DRC／ERC 警告仍是审查输入；零错误不等于零警告。不能为宣称就绪而删除警告。介质或过孔工艺变化须重新进行工程审查，因为电容感应电极依赖叠层。

## 贴装放行条件

物料表尚有未选定型号的阻容、F1 和 D2。贴装前须记录精确可订货型号、电阻额定参数和公差、保险丝保持／动作电流与温度特性、LED 极性／压降／电流，以及电容在工作偏压、公差、温度下的有效容量。C45／C46 标称共 20 uF 不能证明满足稳压器的有效输出容量要求。最终电容须取得厂商偏压数据或测量结果，再与 TPS63031 要求对照。

首批按[评估回应及样机阶段门槛](assessment-response.zh-CN.md)执行。电池采购另须满足[电池包规格](battery-pack-specification.zh-CN.md)。厂商工艺确认、报价、实测波形和装配良率仍待完成；此工作流没有联系供应商。信号及射频检查已开始，天线布局阻塞项仍待解决。
