wZuck/YETI60/hardware/ec60-nrf52840/fabrication-notes.zh-CN.md

[English](fabrication-notes.md) | 中文

# YETI60 嘉立创普通工艺要求

采用**普通四层 FR-4、JLC04161H-7628、标称 1.6 mm**。用户不使用 HDI 或特殊填孔盖铜。当前 PCB 只采用 F.Cu–B.Cu 机械通孔，最小焊盘／钻孔为 **0.50／0.30 mm**。**没有盲埋孔、激光孔或模组盘中孔。** 旧 HDI 导出文件不可下单。

原先 9 个局部盲孔已经移除，重新布置充电输入／电容／计时／终止电流线路，并移动 R55／R56 和 C40／C41。U1.39、U1.51 改为焊盘外通孔引出，SWDIO 另增加一个普通中转通孔。仍须通过原生设计规则、网表及实际铜连接检查，不能仅凭孔数判断正确。

## 普通叠层与板厚

[JLC 公布的标准叠层](https://jlcpcb.com/impedance)：正面铜 0.035、7628 半固化片 0.2104、内层铜 0.0152、FR-4 芯板 1.065、内层铜 0.0152、7628 半固化片 0.2104、背面铜 0.035 mm。CAD 另在两面各计入 0.010 mm 阻焊，得到 **1.6062 mm 的 CAD 包络**。阻焊厚度是工程模型，不是厂商保证。实际下单选普通 **1.6 mm**，不定制 1.6062 mm 叠层。[JLC 成品厚度公差为 ±10%，即 1.44–1.76 mm](https://jlcpcb.com/capabilities/pcb-capabilities/)，须实测来料并遵守装配记录中的公差限制。

感应介质由原假设的 0.200 改为 0.2104 mm。保留电极铜形状不能证明电容量不变，仍需实物逐键校准。不再要求非对称的 0.150 mm 激光介质。

## 贴装及工艺审查

采用绿色阻焊和普通沉金表面处理，可使用普通过孔盖油；不要求树脂填孔、整平或镀铜封盖。U5 地／裸露散热盘区域保留一个普通开口散热通孔，贴片厂须审查钢网开口、吸锡和散热盘润湿，CAD 通过不能代替焊接工艺验收。

[审查包与清单](../../docs/engineering/fabrication-review.zh-CN.md)提供光绘、分开的金属化／非金属化通孔钻孔文件、电测网表及 76 个器件的贴装坐标。仍需厂商下单审查、最终阻容额定值／有效容量、波形／温度测试和机械首件。信号及射频干扰分析继续暂缓。
