wZuck/YETI60/variants/raytac/docs/build/battery-vendor-checklist.zh-CN.md

[English](battery-vendor-checklist.md) | 简体中文

# 可直接转发给电池供应商的参数

采用指定的 **SHR-03V-S 无凸耳胶壳，宽 4.0 mm**。目录中的 **SHR-03V-S-B 带凸耳胶壳宽 6.0 mm**，未包含在当前胶壳包络中，不能未经单独适配检查就替换。[JST 胶壳尺寸表](https://www.jst-mfg.com/product/pdf/eng/eSH.pdf)

电池由用户向供方核实；不能仅凭型号代码就视为已经合格。先询**成品样品 1 包**，要求逐项书面回复。默认仍是每把键盘使用 1 包、1600 mAh。

| 参数 | 请供方确认 |
|---|---|
| 化学体系／串数 | **单节 1S 锂离子聚合物**，标称 **3.7 V**、标称 **4.2 V 恒流／恒压充电**；不能是两串、磷酸铁锂或 4.35 V 高压包 |
| 容量 | **最低容量 1600 mAh**；提供测试电流、温度、充电电压及放电截止条件，最低值与典型值分开写；倍率与毫安数有矛盾时须更正 |
| 完整成品尺寸 | **长≤85 mm、宽≤43 mm、厚≤4.8 mm**；包含保护板、温度保护、传感器、折叠极耳、包皮、绝缘、应力释放及规定增长余量。提供最大尺寸和剖面图；无外壳样品可以先外置较厚包，但不能据此宣称最终能装进壳体 |
| 充电电压兼容 | 接受 BQ24074 的 **4.16—4.23 V** 输出范围，明确最高允许充电电压；单独说明 4.16 V 低端容量表现，不能默认仍能交付 1600 mAh |
| 持续充电能力 | 在允许温区内**至少允许 500 mA**；本键盘的编程最大计算充电电流为 **445.63 mA**，500 mA 是要求的电池额定能力，不代表实际固定充入该电流 |
| 充电终止 | 接受 **16.87—29.26 mA** 终止范围，典型 **22.94 mA**；按该恒流／恒压协议提供充电及终止曲线 |
| 放电能力 | 建议确认在拟使用温区内**持续放电≥0.5 A**；这是采购余量，不是键盘实测耗电。提供真实持续／脉冲额定值及允许温度 |
| 正常放电截止 | 电芯正常工作截止 **3.0 V**；分别说明正常截止、保护板应急截止、全部公差／延迟及恢复条件。只写“2.4 V 过放保护”不够；当前正式固件没有自主低压关机 |
| 独立温度断充 | 不依赖键盘主控或外部充电器反馈也能硬件禁充；计入误差及热延迟后，实际允许充电窗口须落在 **15—43°C 内**，名义目标 **18—40°C**。提供冷／热截止、恢复、迟滞、传感器开短路行为及公差 |
| 第三线温度反馈 | 与电芯有效热耦合；电气特性兼容 **SEMITEC 103AT-2：25°C 为 10 kΩ、B25/85＝3435 K**，阻值／B 值公差 **≤1%**；其他器件须提供完整等效阻温表复核。独立保护器不能额外加载这条充电器反馈节点 |
| 传感器安装 | 剖面图标出真实位置；2.4 mm 珠体叠在 4.3 mm 电芯上不能满足 4.8 mm 成品厚度。须用经确认的薄型传感器或端部耦合结构 |
| 其他保护 | 提供准确保护芯片／开关管型号及过压、欠压、充放电过流、短路、温度阈值、延迟、恢复和漏电。只回复“带保护板”“三线”不能视为已确认 |
| 插头／极性 | **JST SHR-03V-S、1.0 mm 间距、三针**；1 脚红色正极，2 脚黑色负极，3 脚黄色 NTC、参考保护包负极。提供带针号、卡扣和观察方向的插接图；不能套用通用电池线序 |
| 引线 | AWG28 多股铜线，绝缘外径≤0.8 mm；受控包端与插头出线面之间自由长度：1 脚 **114.92 mm**、2 脚 **111.61 mm**、3 脚 **108.63 mm**，公差±0.5 mm，按图预成形。这不是端子下料长度；确认应力释放及≥4 mm 静态弯曲半径 |
| 资料 | 更正后的电芯规格、准确成品包型号、完整尺寸图、保护原理图／规格、容量及完整充电曲线、保护测试记录、样品／批次检查记录 |

请供方返回**实际型号、数值、公差与图纸**，逐项列出不满足之处。不能仅凭商家说“兼容”，就接受不同电压、极性、保护板或温度窗口。[完整电池包规格](../engineering/battery-pack-specification.zh-CN.md)约束包络与出线基准。

电池核实由用户负责，可与 PCB／USB 修补并行。首次断电检查、通电和 USB 测试可以暂不接电池；完整无外壳验收**仍包含电池放电及充电**。[无外壳流程](../../OPEN-BENCH.zh-CN.md) · [制作总手册](../../BUILD.zh-CN.md)。
