wZuck/YETI60/variants/raytac/docs/engineering/assembly.zh-CN.md

[English](assembly.md) | 简体中文

# 装配图及装配顺序

[28 步逐图指南](../assembly/build-guide.zh-CN.md)涵盖主板从裸板开始焊接、可选 C5 自焊、分阶段通电、刷写及完整安装；机械图示以下方尺寸为准。

工程图采用当前原尺寸 FELK60 派生壳体网格、原生定位板／PCB 几何及原生导出的 USB 子板 CAD，与旧的摄影风格渲染分别保存。键帽／轴座轮廓、螺纹及分解高度为示意，以文字尺寸要求为准。编号和数量对应[材料表](materials.zh-CN.md)。

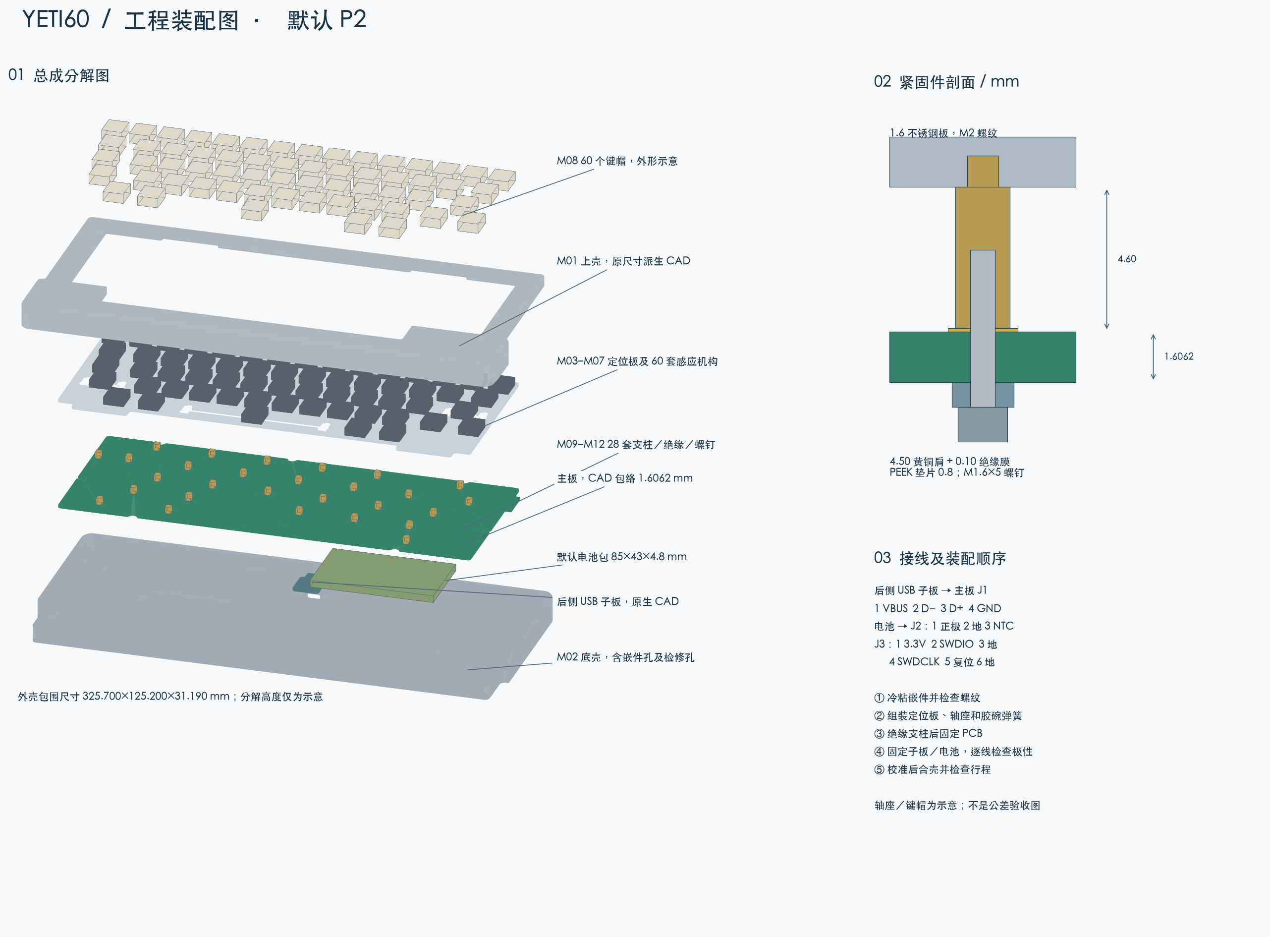
[picture p193: variants/raytac/docs/engineering/images/assembly.zh-CN.png]
原尺寸工程装配图


[矢量装配图](images/assembly.zh-CN.svg) · [默认电池槽图](images/battery-pocket.zh-CN.svg) · [底壳下挖研究](battery-study.zh-CN.md)

## 装配基准

| 接口 | 要求 |
|---|---|
| 上下壳外部联合包围尺寸 | 原坐标系 325.700×125.200×31.190 mm，不缩放 |
| 下／上胶棉支承台 | z=3.19／6.39 mm；名义安装间距下侧 1.0162、上侧 0.5838 mm；片材下侧 2.0、上侧 1.2 mm |
| 不锈钢定位板 | 底面 z=4.2062、顶面 z=5.8062、CAD 厚 1.60 mm；成品 1.55—1.60 mm |
| PCB | 顶面 z=−0.3938、底面 z=−2.00、成品厚 1.6062 mm |
| PCB 到定位板间距 | 4.60 mm，由 4.50 mm 黄铜肩及 0.10 mm 聚酰亚胺膜组成 |
| 安装中心 | PCB 原 29 孔不变，H26 不装，只安装 28 套支柱／螺钉；最大原中心偏差 0.05337 mm |
| 最差螺钉径向余量 | 采用 M1.6 螺杆及规定孔径、位置、同轴度公差后约 0.06163 mm，属于严格制造要求 |
| 子板 | PCB 底面 z=−10.91、厚 1.6062 mm；安装孔矩形 14×12.5 mm |
| SW100 操作 | 底部 Ø8 检修孔，中心 X=112、Y=−121 mm；仅用绝缘工具 |

支柱绝缘膜位于 **PCB 顶面与黄铜肩之间**，PEEK 垫片位于 PCB 下侧。底部螺钉穿过垫片和 PCB，进入 M1.6 内螺纹。名义啮合 `5−0.8−1.6062−0.10=2.4938 mm`，小于 3.2 mm 内牙深度。M2 外牙从下侧进入已攻牙定位板。CAD 中只画螺纹包络，不是实际牙型；首件须确认攻牙、啮合、头高及绝缘。禁止强行让错位螺钉穿过感应电极。

## 装配顺序

1. 选择并制造一个明确版本的壳体。韧性树脂充分后固化，检查收缩后再精加工嵌件底孔。上壳冷粘四个 M3 嵌件，底壳子板座冷粘四个 M2 嵌件。胶液不得进入螺纹，按要求完全固化；热固性树脂不能按热熔嵌件工艺操作。
2. 按 [NiZ 钢板卫星轴指南](../build/key-mechanism.zh-CN.md)加工新 1.6 mm 钢板及 28 处 M2；先装三组钢板卫星轴和两根短丝／一根 6U 长丝，再试装 60 个普通 NiZ 轴座，检查下裙边避让。只有中央有效轴装胶碗／感应锥簧，六个卫星轴侧柱都是被动机构。
3. 将 28 个黄铜转接支柱装到定位板。每个支柱肩与 PCB 感应面之间放 0.10 mm 聚酰亚胺绝缘环。PCB 对位时不能偏移感应中心，底部装 28 个 PEEK 垫片和 M1.6×5 螺钉。分步均匀拧紧，扭矩须经首件确认，不给出未经验证的数值。H26 整套留空。
4. 将后侧子板装到四个冷粘 M2 嵌件座，按建议采用 M2×4 螺钉及绝缘薄垫。先检查 USB 口对位和实际插头出线空间，再继续装配。四芯线束逐线测通并确认极性后才能插接；150 mm 为控制路径中心线，按逐根长度及固定座安装；实物应力释放仍待验收。
5. 仅安装符合 P2 规格、由供方签图的 1600 mAh 保护电池包，完整包络 85×43×4.8 mm。确认独立温度断充、第三线 NTC 和自定义线序；固定／绝缘层须计入 0.2 mm 槽底预算，不能挤压软包。电池到螺钉头名义间隙为 0.7 mm。不得混用旧小电池充电配置。
6. 开壳状态核对电池极性，通过 **自定义** J3 探针接口先刷写 USB 校准版。按[固件校准流程](../../firmware/target/README.zh-CN.md)操作，保留设置分区刷普通版，然后实测全部 60 键及 USB／蓝牙。
7. 将胶棉放到原有支承台，逐步均匀合壳。建议 M3×5 加 0.30 mm 薄垫，按记录的壳体座面可得名义 2.50 mm 嵌件啮合；确认螺钉不顶底且头部进入沉孔。检查完整按键行程、接口空间、无夹线以及关壳后可操作电源开关，最后核对底部支承面并安装脚垫。

后侧子板按用户决定保留 **C5 JSH**，不切换 UDB S。继续使用锁定版本 `2b6c52a`、14×12.5 mm 四孔安装矩形及四线 J1 接口。

快速充电需要开启主板并连接接受 500 mA 配置的 USB 主机。关机时仅由硬件 USB100 慢充，完整充满时间尚未验证；仅充电适配器的行为见[充电状态说明](power-budget.zh-CN.md)。

## 接线

| 接口 | 编号顺序 | 装配检查 |
|---|---|---|
| 子板 → J1 | 1 VBUS；2 D−；3 D+；4 GND | 按针脚编号确认电气直通，不能按肉眼左右顺序判断 |
| 电池 → J2 | 1 正极；2 负极；3 相对负极的 10k NTC | 先测极性；按电池签图确认温度线及独立温度断充保护 |
| J3 SWD | 1 3.3 V 参考；2 SWDIO；3 地；4 SWDCLK；5 RESET_N；6 地 | 自定义治具；不能直接插未经核对的标准 ARM 插头或向已供电板反灌电源 |

## 复现及验收

用 KiCad Python 运行 `export_yeti60_mechanical_metadata.py` 和 `export_yeti60_daughterboard.py`；使用 `requirements-audit.txt` 依次运行 `check_yeti60_assembly.py`、`export_yeti60_render_meshes.py`、`study_yeti60_battery_pocket.py`、`screen_yeti60_batteries.py`、`draw_yeti60_assembly.py`。最后运行 `python3 scripts/check_yeti60_engineering.py`，并执行既有目标固件及 DRC 检查。[图纸证据](../audit/yeti60-assembly-drawings.json)记录来源及产物哈希。

当前没有实物。壳体及电池包实体检查只证明明确条件下的几何关系，不证明实际胶碗压缩、手感、树脂蠕变或电气工作。完整线束路径、具体配套轴体兼容性、供方元件高度、打印壳体公差及全部实物检查仍是首件要求。本轮最小天线投影已清铜；真实关壳射频、静电容干扰及 USB 信号验收仍待实测。
