wZuck/YETI60/variants/raytac/hardware/usb-short-route/assembly/pcb-surface-back.png

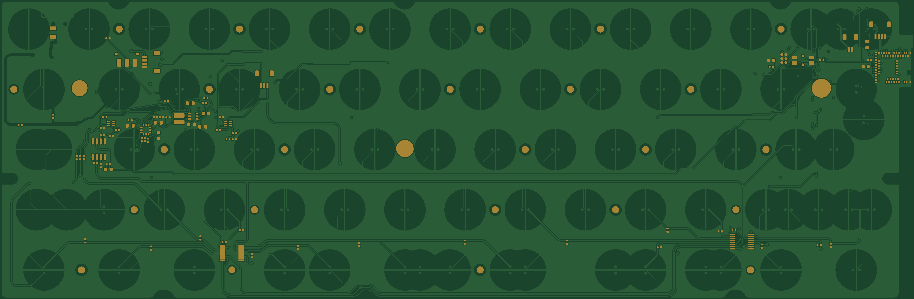
variants/raytac/hardware/usb-short-route/assembly/pcb-surface-back.png
