wZuck/YETI60/variants/raytac/hardware/usb-short-route/assembly/pcb-surface-front.png

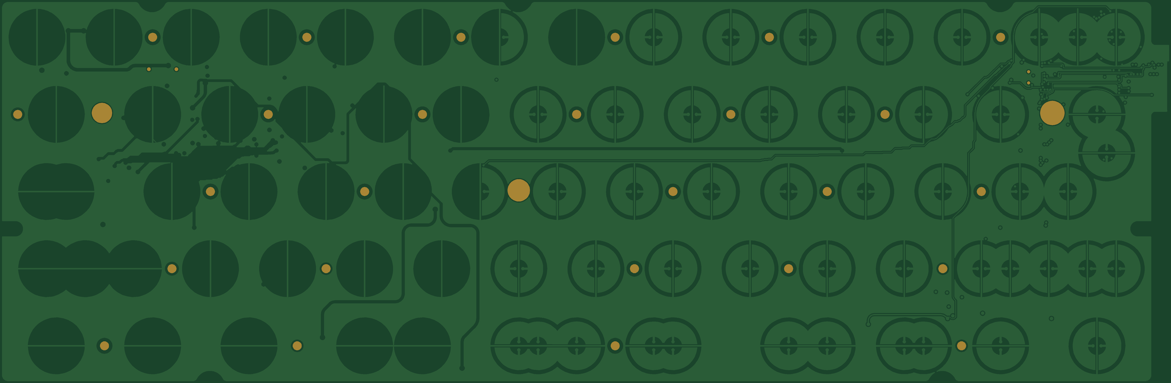
variants/raytac/hardware/usb-short-route/assembly/pcb-surface-front.png
