wZuck/YETI60/variants/raytac/docs/testing/README.zh-CN.md

[English](README.md) | 简体中文

# Raytac 本轮审查与首件验收

静电容扫描已修正为先释放再升行、先钳位再降行；见[模拟时序研究](analog-waveform.zh-CN.md)。校准版新增 `yeti_calibrate timing`，报告行 GPIO 调用至 ADC 返回的 RTC 粗略耗时及计时频率，含一格量化余量；实际为 32768 Hz，不能据此确定精确采样时刻。升级后用同包两版重新校准。

返回[总入口](../../BUILD.zh-CN.md)。本页对应 Raytac 的本轮 RF 板框、USB 保护修补和 75 件材料表；仓库根目录旧的双方案验收报告不能替代这轮本版结果。

**软件／CAD 是否全部通过，以本目录最新[审查结果](../audit/outcome.json)的 `checks_passed` 为准；生产与实物验收仍不通过软件检查自动放行。** 没有实物，下面的硬件测试均为待执行。

## 本轮检查范围

| 范围 | 证据和边界 |
|---|---|
| 原理图与导通 | [当前候选板严格检查](../../hardware/usb-short-route/audit/native-check.json)核对 411 对信号连接，严格 DRC 零错误、零断线；旧参考板的 267 对结果单独保留，不替代当前板。 |
| 普通工艺 | [当前首板参数](../../hardware/usb-short-route/FIRST-ARTICLE.zh-CN.md)、[制造回读](../../hardware/usb-short-route/audit/fabrication-check.json)：普通四层、1.6 mm，813 处过孔、846 处孔槽；旧参考板的 816 个过孔不是当前板数量。 |
| USB 保护与路径 | [C5 实际保护通道](../audit/C5-protection.json)、[接触点路径提取](../audit/USB-signal-paths.json)；C5 的 U1 1／2／4／5 为保护 I/O，6／7／9／10 的内部未连接脚不能代替保护通道；保留 C5 U1／D1／F1，删除主板重复 D1 长支线；尚无 USB 眼图或整板 ESD 认证 |
| 天线铜区 | [本版四层原生铜检查](../audit/interference-layout.json)；Raytac 最小 10.5×3.8 mm 投影内 GND 和非 GND 铜面积均为零，并做逐层真实铜注入的负向测试；这不等于实测射频通过 |
| 固件 | [普通版／校准版目标检查](../audit/yeti60-target-check.json)、[核心与 USB 策略主机回归](../audit/yeti60-firmware-simulation.json)；描述符接受后为 USB500 预算，启用充电并优先 USB 输入，实际充电电流另受设定和负载分流控制 |
| 结构与线束 | [当前 C04 装配](../../hardware/usb-short-route/ASSEMBLY.zh-CN.md)、[九根线及理线件](../../hardware/usb-short-route/CLOSED-CASE.zh-CN.md)、[60 键映射](../audit/yeti60-key-geometry.json)；PCB 原有 29 孔、实际安装 28 套紧固件，H26 留空；完整公差与插接检修仍须验收。 |
| 图纸、材料与完整性 | [75 件物料及库存](../audit/yeti60-inventory.json)、[28 步指南](../assembly/build-guide.zh-CN.md)、[完整爆炸图](../engineering/exploded.zh-CN.md)、[跨域来源校验](../audit/integration.json)；不得手工更新哈希掩盖过期图像 |

原生 PCB 保留 102 条非实装电极、安装图形和探针相关 courtyard 告警；它们不代表 102 只缺件。ERC 仍有 183 条继承的离网格端点告警，新导出网表及引脚合同会独立核对真实连接。共享模拟／放电总线统一为 `APLEX_OUT_PIN_0`，没有把两个 MCU 输出短接。C5 上游默认 DRC 仍有封装／courtyard／边缘间距审查项，不能混同为主板严格 DRC 零错误；首样优先用成品 C5。

## 首件按以下顺序记录

1. **收板和断电检查：**量板厚、板框和 29 个孔，检查电极、方向、焊接和隐藏焊点；用万用表核对供电、线束通断和每个连接器针序。检查失败先返修，不接电池。
2. **电源与刷写：**使用限流 USB 源和电池模拟器，确认电源轨、无异常热点与电流，再 SWD 编程／校验；不用真实软包做反接、短路或过温试验。见[接线与刷写命令](../build/flashing.zh-CN.md)。
3. **局部结构：**先试普通键、宽键和 6U 空格；确认独立轴座、胶碗预压、弹簧位置、全行程／回弹及稳定机构。验证支柱与隔离垫，不能靠拧紧螺钉消除干涉。
4. **逐键校准：**装好真实机构后执行 release、逐键持按 press、status、save；全部 60 键满足保护区间、无饱和／重叠才通过。不用安静环境的一次校准掩盖充电或蓝牙时的误触。
5. **USB 与蓝牙：**在真实电脑上确认枚举和 HID；电脑接受配置后，同时记录电池侧正向充电电流与 USB 按键报告。检查历史蓝牙偏好不会阻止 USB 自动优先，拔线、重插、复位、挂起、恢复和蓝牙重连均正常。
6. **充电与温度：**配置前和固件运行时挂起不充电；USB500 为输入预算，不是固定电池电流。SW100 关闭时另验 USB100 自主慢充；普通充电器不枚举，不能当作数据主机。只有供方签收的完整保护包才能做真实充电、终止、独立温度断充及续航测试。温度反馈替代等操作由合格台架人员实施，不加热真实软包强迫触发。
7. **最终合壳：**复查 PCB 居中、射频凹槽、线束压接／弯曲／插拔、支架、螺钉啮合和电池不受压；检查各项公差，再合壳重做 60 键、USB／BLE、充电和温升测试。
8. **射频和电容干扰：**在实际树脂外壳、最终电池与键帽下测距离、方向、丢包／重连，以及空闲、按键、USB 输入、充电、BLE 发射时各键的松键／按键分布。未测的项目记为未测，不记为通过；需要的 USB／EMC／ESD 合规测试由有能力的实验室完成。

保留板号、PCB／固件哈希、实际物料和电池批次、仪器设置、日志、波形、温度、照片与每项通过／失败结果。首件通过后才能评估扩大数量，不能把 CAD 一致性结论当成量产批准。

机械验收按 [NiZ 钢板卫星轴指南](../build/key-mechanism.zh-CN.md)：28 套紧固件、H26 留空、下／上胶棉 2.0／1.2 mm；核对 NiZ 卡扣下缘、三组独立卫星轴、实际 6U 钢丝键帽配合、松键回弹及完整行程，按大键时同时检查附近未按的静电容按键。

新增[模拟 GPIO／初始化清理检查](gpio-mode-policy.zh-CN.md)覆盖实际回调、初始化函数、固定 Zephyr 标志以及关轨结束状态；实际漏电和电源下降仍须测量。

扫描初始化失败时命令立即返回不可用；运行故障关闭模拟前端、释放已记录按键并拒绝继续采集／保存。两个固件均采用 128 项按键事件队列。见[扫描状态与故障回归](scan-control.zh-CN.md)，包含实际工作循环、60 键采集和 120 事件突发测试；真实主机送达仍待首板验收。

校准记录现为带独立 CRC-32 的 308 字节，旧 304 字节记录必须重新采集；全局 NVS 设置格式及蓝牙绑定不变。见[校准存储校验与升级](calibration-storage.zh-CN.md)。损坏注入已覆盖，真实闪存断电仍待首板验收。

新增[固定版本 NVS 中断恢复模型](nvs-powercut.zh-CN.md)：实际 NVS／校准加载代码完成 14,795 次指定中断试验，覆盖垃圾回收和恢复期间再次中断；哨兵及恢复后再次保存均通过。它不是物理 NVMC／欠压／蓝牙验收。NVS 模型本身只增加测试；已有候选产物可用 `--host-tests-only` 重新验证并发布测试，来源变动则必须完整构建。

[矩阵、Fn 与 HID 链路](key-pipeline.zh-CN.md)执行固定版本 ZMK 的实际转换、层选择和 HID 代码。当前为六个普通键的 HID 槽位，修饰键另算；60 键扫描不等于全键无冲。六组场景及四个错误变体验证通过，真实主机和传输仍待验收。

[实际 ELF 的 HID 格式核对](key-pipeline.zh-CN.md#已链接的-usb蓝牙报告格式)确认 USB 报告 9／13 字节匹配 16 字节端点，蓝牙报告体为 8／12 字节；两份映射及 Report Reference 一致。运行时描述符填充、枚举和主机收包仍待实测。

[电源状态审查](../engineering/power-states.zh-CN.md)区分主控复位、USB 总线复位和关机。首板增加启动默认充电、挂起时电池支撑消失及真实关机电流捕获；保护包仍须独立验收。
