wZuck/YETI60/docs/testing/USB-paths.zh-CN.md

[English](USB-paths.md) | 中文

# USB 路径审查

**当前范围：**E73 数值以[最新提取](../audit/USB-signal-paths.json)和[当前复查](../audit/e73-review.zh-CN.md)为准。Raytac 历史正式板已无主板 D1，其外部保护支路在本提取器中记为 `null`，不能冒充 0 mm；当前短 USB 修补板使用[独立证据](../../variants/raytac/hardware/usb-short-route/README.zh-CN.md)。下述旧正式板路线不代表候选板。

E73 当前正式 PCB 需要修补 USB 布局，其 TVS 支线远长于项目设定的 5 mm 筛查目标。这是几何检查发现的问题，并非实测 USB 故障，也不是认证限值。

| 当前正式板 | D+ 几何路径，mm | D− 几何路径，mm | D+ TVS 支线，mm | D− TVS 支线，mm | 主路径过孔数，+ / − |
|---|---:|---:|---:|---:|---:|
| E73 | 254.555 | 257.864 | 29.748 | 37.561 | 4 / 6 |
| Raytac 历史正式板 | 263.038 | 265.203 | 外部保护，未在此提取 | 外部保护，未在此提取 | 4 / 6 |

[接触感知提取程序](../../scripts/check_yeti60_signal_paths.py) 根据 KiCad 的实际铜连接构建图，在走线中间分支处分割路径，计入焊盘引入段、连接桥、R30/R31 中心间距，并从声明的四层叠层计算过孔跨层长度。圆弧采用最大偏差 0.002 mm 的折线。先求 J1 经串联元件至模块 USB 焊盘的最短路径，再求 TVS 输入焊盘至主路径节点集合的最短路径。[生成报告](../audit/USB-signal-paths.json) 保存逐段路径和源文件哈希。

```text
主路径几何长度 = 走线中心线 + 接触桥 + 过孔跨层段 + 串联封装中心间距
TVS 支线长度 = TVS 输入焊盘到主路径节点集合的最短几何路径
```

该方法没有求解焊盘内电流分布、差分阻抗、传播时延、线对耦合或接收端眼图，也不包含 C5、线缆、连接器内部和模块内部布线。几何长度差不能称为实测电气偏斜。原生连通性和描述符电流也不能证明 USB 信号完整性。

[Nexperia PRTR5V0U2X 数据手册](https://assets.nexperia.com/documents/data-sheet/PRTR5V0U2X.pdf) 第 10 节要求器件靠近输入连接器，缩短保护支线和接地回流路径。5 mm 是本项目设置的工程筛查目标，厂商没有给出这一数值限值。修补必须缩短两条数据支线、提供局部接地回流、删除旧残桩，并保留经过保险丝的供电关系。如果调整两个输入通道的分配，必须同步修改原理图、原生 PCB 和保存的网表。

修补后重新运行原生 DRC、普通工艺、连通性、路径提取和机械检查。最终验收前，还需在实物上验证完整线缆／C5／主板路径，以及 USB 枚举和挂起行为。验收程序分别判断支线布局与 USB 信号完整性，缩短支线不会自动关闭后者。

使用 KiCad Python 依次运行 `scripts/check_yeti60_signal_paths.py` 和 `tests/audit/test_signal_paths.py`。回归夹具包含走线中部的 T 形分支，仅统计线段端点会得到错误的支线长度。
