wZuck/YETI60/docs/testing/remediation-plan.zh-CN.md

[English](remediation-plan.md) | 简体中文

# 修补方案与验收门槛

目标先达到可制作工程首件的设计状态，再完成实测验收。脚本执行成功不等于最终验收。保留同一分支的两版方案、每板一个 nRF52840、C5 JSH、JLC 普通四层机械通孔，以及 60 个感应电极和 29 个安装孔。FELK60 外形保持原尺寸；明确记录的小型 PCB 延伸区和树脂内部避让仅为候选设计，不是已批准量产几何。

| 编号／优先级 | 问题与修补 | 关闭所需证据 | 当前状态 |
|---|---|---|---|
| CAL-01／关键 | 旧校准取松开最小／按下最大值，可能接受重叠分布；改为逐键标签采样、最坏边界及噪声保护值 | 缺样本／重叠／噪声／饱和反例，两版普通／校准 ARM 构建，指南与命令表一致 | 四个 ARM 目标均已重建；E73 47 项、Raytac 44 项完整检查通过；实物校准仍待进行 |
| RF-01／高 | Raytac 最小天线投影有约 0.05mm 接地铜薄边；E73 天线端位于大量主板铜内 | 原生各层焊盘／走线／填充铜相交为零；注入铜后检查能拒绝 | 现有板失败／未关闭；已准备向板外避让的候选 |
| RF-02／高 | 两版附近均有定位板金属投影 | 天线／定位板投影零重叠、明确横向裕量，再做整机射频实测 | 候选实体检查通过，尚未落实到 PCB |
| MECH-01／高 | 板外放置需要焊盘支撑、板边净距和壳内避让 | 原生焊盘与板框检查、严格 DRC、全公差壳体／器件／PCB／线束间距，外形和原电极／安装孔保持 | 候选在 Y114.5–132.0mm 将右板边从 X356.812704 延至 X361.2 |
| SI-01／高 | USB 旧检查是含分支的总长，不能证明实际差分失配、阻抗或回流 | 提取经过串联电阻的 J1 至模组有序路径，统计支路／过孔；相邻差分布线及参考地，普通叠层模型及完整线束／C5 边界，实机眼图／枚举 | 需继续复核和布线，不用总长差伪造通过 |
| POWER-01／高 | 模组去耦较远，保守的整段长度也需核实 | 按实际焊盘接触点测量路径／回流，旁路电容靠近模组，核对线宽／压降，再做瞬态／温升 | 需原生电源复核，现有计算不是稳定性证明 |
| AFE-01／高 | 101 倍增益放大低频扰动，尚无提取的静电容与 ADC 采样网络 | 全电源／射频模式的带保护分布，电源／负载／时序扫描及实际波形 | 已有 TI 运放敏感性仿真，实物裕量未关闭 |
| BAT-01／高 | 电芯资料电流行冲突，完整保护 1600mAh 包未经供方批准 | 更正限值、完整包络签图、独立 15–43°C 中断、NTC 和充电／终止记录 | 供方证据缺失，不能靠 CAD 或软件关闭 |
| FW-01／高 | 外设、射频和主机行为只有构建与替身核心证据 | 四个匹配 ARM 产物及源码来源；逐板刷写／回读、USB／蓝牙及切换循环日志 | 四个新 ARM 目标已重建及验证；没有实物 |
| MECH-02／高 | 胶碗预压、树脂收缩／嵌件、完整插头／线束可维修性仍有条件 | 匹配供体零件、干装、尺寸、抗拔及合壳记录 | 需要首件实测 |
| TEST-01／中 | 验收摘要硬编码阻塞状态及旧问题名称 | 按新鲜证据推导设计门槛，独立保留实物门槛，用反例拒绝虚假／过期关闭 | 需要修复；不能为了完成计划直接改成通过 |
| DFM-01／中 | 任何改板后均须复查 JLC 普通工艺输出 | 无盲埋孔／盘中孔特殊要求，严格原生 DRC／网表，光绘／钻孔／材料／坐标与板型正确 | 最终布线后重跑，制造压缩包仍为审查包 |

## 已检查的天线候选

[受控候选尺寸](../../mechanical/rf-remediation.json)将 E73 放到原点 (346,117)、0°，Raytac 放到 (356.25,125.25)、90°，均在元件面，天线端超出原定位板边缘。两版共用的底壳内部避让为 X355.5–364.8、Y−133–−114、Z−5.7–0.2mm，圆角 0.8mm，外形不变。

[候选执行记录](../audit/rf-remediation-candidate.json)得到模组／壳体零碰撞，天线到定位板横向间距分别 E73 4.187mm、Raytac 3.387mm；PCB 延伸区到壳体 0.5mm；计入设定的 0.15mm 壳体公差后，采样槽底最小壁厚 1.56mm，E73 最深器件距壳仍有 0.296mm。槽底检查包含 595 个位置，不能代替完整结构薄壁或树脂强度分析。E73 最后 3mm 天线区仍为暂定，因为厂商未给出数字主板净空。**这些结果只证明候选几何可行，不代表 PCB 已完成布线或射频通过。**

## 实施顺序

1. 修复校准及其验收测试，重建四个固件目标，更新两套中英文图解指南；形成证据完整的阶段提交并推送。
2. 先证明焊盘支撑和板边间距，再在两版落实天线延伸区／壳内避让，移动模组及局部旁路器件，按原普通工艺规则重布相关网络。保留原几何和确定性的改动规格用于回归。
3. 修补 USB 路径几何，复核电源／地回流；任何局部修补若引入新 DRC、断线、感应变化或机械碰撞，都不能接受。
4. 重新生成受影响的制造数据、STEP、线束图、步骤图及渲染来源；重跑两版完整审计和干扰／验收反例测试，再发布阶段提交。
5. 设计门槛和下单审查通过后才制作；取得已验收电池及供体机构，再执行[首件流程](README.zh-CN.md)和[干扰矩阵](interference.zh-CN.md#实物干扰矩阵)。实测失败保持未关闭，修复后重跑受影响项目。没有硬件或缺少供方文件不能自动算通过。

复现：`python3 scripts/test_yeti60_calibration.py`；在 CAD 环境中运行 `scripts/study_yeti60_rf_remediation.py`。当前设计和实物状态以[验收证据](../audit/acceptance.json)为准，不以本候选计划代替验收。
