wZuck/YETI60/variants/raytac/docs/testing/scan-control.zh-CN.md

[English](scan-control.md) | 简体中文

# 扫描器可用状态、故障关闭与校准命令

Raytac 普通版和校准版共用原子扫描状态与单命令邮箱。初始化完成后才接受命令。ADC 或 GPIO 故障会关闭模拟前端，经 kscan 回调释放已记录的按键，取消采集，并锁定停止扫描直到复位。USB 充电控制仍由独立状态回调处理。PCB、材料及制板文件没有变化。

## 发现的问题及修补行为

此前扫描器初始化失败后，串口仍可能确认命令已排队；工作线程不会消费它，后续命令便一直忙。运行故障前刚排队的请求也可能在关闭后继续执行。GPIO 错误原本在采集和按键回调后检查，故障帧可能被计入校准。关闭核心虽清空矩阵，却没有立即释放工作线程已上报的按键。

| 扫描器状态 | `release`、`press row col`、`save` | `status`、`timing` |
|---|---|---|
| 初始化未完成或失败 | 返回 `-ENODEV` 并提示不可用 | 同样拒绝 |
| 正常运行 | 只排队一个请求；第二个返回 `-EBUSY` | 共用同一邮箱 |
| 运行故障已锁定 | 返回 `-EIO`；排查后复位 | 可用于诊断，通常在下一次 100 ms 工作线程周期内处理 |

只有扫描线程修改采集数据和关闭核心。串口通过 [scanner_control.c](../../firmware/target/src/scanner_control.c)通信，采用固定版本 Zephyr 的顺序一致原子操作。初始化先公布设备指针，再公布运行状态。重复初始化被拒绝；准备就绪操作不能清除已锁定故障。

工作线程取命令时再次检查状态。故障前刚被接受的修改类请求会丢弃并明确输出提示，只读请求仍可用。故障后的 `status` 显示 `scanner_fault=1`，本次运行的校准有效状态置零。故障处理不擦除保存的校准或蓝牙绑定。排查后复位，兼容的已保存校准可在启动时重新加载；固件信号标识变化仍需重新采集。

故障检查在采集与整帧按键回调之前进行。关闭路径尝试关闭核心电源，对全部已记录按住位置各发一次松开回调，清除采集有效状态并停止继续扫描。扫描禁用或空闲模拟前端门控时的 GPIO 错误也会锁定。软件无法保证物理损坏的 GPIO 或负载开关关闭，必须测量实际电源轨。

## 空闲后的首次短按

审查在实际工作线程中复现了另一处漏键：进入空闲后，模型中的一次 50 ms 持按只覆盖一帧扫描。旧策略要等到消抖后的矩阵变化才恢复活动速度，因此确认前又等待了完整 30 ms 空闲间隔；键已松开，最终没有产生按下／松开回调。

持有者线程现在还检查**有效位置上非零的待确认消抖计数**。首次发现边沿即恢复 4 ms 活动间隔，确认期间保持模拟前端开启。原有两帧消抖保留，不降低阈值规则或缩短各位置的脉冲等待。扫描源码变化会改变校准指纹，升级采用重建后的配套固件并重新采集 60 键。

| 原生工作线程场景 | 按下／松开回调 |
|---|---|
| 旧空闲策略，50 ms 模型持按 | 0／0；回归检查失败 |
| 修补后，同样持按，随后另加单帧尖峰 | 1／1；尖峰不产生额外事件 |
| 故意绕过消抖，同样输入 | 2／2；抗单帧噪声检查失败 |

短按正向场景运行 7,520 帧，15 个未使用位置始终输入 4095，记录 564,000 次读取、一次空闲休眠及 7,519 次活动休眠。相对模型持按边沿，按下／松开延迟为 29／7 ms；这些主机时钟结果不计 ADC／GPIO／稳定等待／调度时间，不是硬件延迟实测。首次发现仍依赖空闲轮询，不能保证所有短脉冲均被发现或实际 USB／蓝牙送达。

单帧越阈值尖峰可能重置 30 秒活动计时，但不会成为已上报按键。因此噪声可能增加活动占比；耗电计算仍保守采用模拟前端常开假设，真实功耗和首键延迟须台架测量。

## 未使用位置与空闲／唤醒边界

现有生产代码已经正确禁用 15 个未使用位置。未使用位置策略不变；本固件包还修补前文所述的空闲短按问题，升级后需重新校准。普通版与校准版设备树须符合构建哈希及板型来源中的映射顺序；两者 60 个位置及扫描器有效位图必须一致。独立的[定位板／铜层映射检查](../audit/yeti60-key-geometry.json)将该来源顺序关联到原生几何。

| 矩阵行 | 有效位图 | 使用／未使用位置 |
|---:|---|---|
| 0 | `0x7FFF` | 15／0 |
| 1 | `0x3FFF` | 14／1 |
| 2 | `0x2FFF` | 13／2 |
| 3 | `0x6FFD` | 13／2 |
| 4 | `0x0646` | 5／10 |
| 合计 | | 60／15 |

实际校准保存流程将未使用位置的低／高阈值设为 **4094／4095**，清空矩阵及消抖计数，并采用严格 `sample > high` 判断按下。合法 12 位 ADC 数值均满足 `sample <= 4095`，因此未使用位置满量程也不能按下。超过 4095 或 ADC 失败由原故障路径撤销整帧。这描述的是校准器生成的记录及正常初始化状态，不代表任意手写记录或真实模拟抗干扰能力。

原生工作线程测试在完整的 128 帧松键、60 键持按采集及保存过程中，始终向全部未使用位置注入 4095。实际保存只审核有效键，因此这些未使用位置饱和不会使正常采集失效；保存及应用后的阈值必须保持 4094／4095。随后连续运行 **7,511 帧／563,325 次 ADC 读取**，进入空闲并请求模拟前端门控，再对全部 60 个有效键完成消抖按下及松开。观察到三次空闲休眠、7,508 次活动休眠，以及各 60 次按下／松开回调；任何未映射回调都会触发测试断言失败。队列完整保留 120 个事件，没有溢出。

测试采用目标实际扫描选项（活动 4 ms、空闲 30 ms、空闲门限 30,000 ms）、报告的时钟及该固件包的校准标识。总计 30,122 ms 仅是**模型中的休眠时间**：GPIO／ADC 操作、忙等、模拟前端稳定、链路及调度没有推进主机时钟，不能当作扫描速率、唤醒延迟、耗电或 HID 送达实测。每帧仍读取全部 75 个位置，不缩短脉冲或跳过未使用电极。

新增两个错误版本必须失败：降低未使用位置保存阈值，以及把高阈值比较改成 `>=`。真实空闲电流、模拟前端电源切换、按键唤醒及 USB／蓝牙／充电联动仍需首板测试。

## ZMK 事件队列

固定版本的[定位布局回调](https://github.com/wZuck/zmk/blob/0862fc0f8c864834007986efcaf52f292ea6d37d/app/src/physical_layouts.c)逐个通过 `K_NO_WAIT` 投递事件，队列满时不重试。此前默认只有四项。两个目标现在均设置 **`CONFIG_ZMK_KSCAN_EVENT_QUEUE_SIZE=128`**。确定性测试暂停消费，连续投递全部 60 键按下及全部 60 键松开，验证 **120 个事件**顺序保留、没有溢出。两整帧之外还剩八项。

队列仍有容量上限。这个有界测试不保证系统工作队列无限停滞时仍能送达，也不证明 USB／BLE HID 送达。目标构建检查确认两个解析后的配置均采用 128 项及内建原子操作。主机运行相同固定版本的原子实现，但使用主机字长，没有执行 Cortex-M4 原子指令或真实 Zephyr 调度。

## 重现与证据

在仓库根目录执行：

```sh
python3 variants/raytac/scripts/test_yeti60_scan_control.py
python3 variants/raytac/scripts/test_yeti60_gpio_modes.py
python3 variants/raytac/scripts/test_yeti60_recovery.py
```

需要主机 Clang、固定版本 ZMK／Zephyr 工作区、已构建普通版及校准版的实际配置／设备树，以及构建容器。[扫描测试脚本](../../scripts/test_yeti60_scan_control.py)逐字提取实际串口命令、工作循环和故障函数，链接真实核心、校准及状态模块；ADC／GPIO、设置存储、休眠和队列接口采用模型。固定版本 ZMK 回调也原样编译，仅在主机侧映射其布局指针名称，以避免与扫描器位图重名。

[参考证据](../audit/scan-control.json)与[候选证据](../../hardware/usb-short-route/firmware/scan-control.json)记录准确来源哈希、15 个正向场景及 17 个必须拒绝的变异版本。覆盖启动不可用；60 个有效位置及 15 个无效位置；邮箱忙；120 事件突发；故障前已接受命令；60 键释放及重复关闭；真实工作循环的 ADC／GPIO 故障；故障帧不得进入校准；禁用门控故障；128 帧松键及 60 键逐键采集／保存，包括未采集完整和设置写入失败时的拒绝。

错误版本分别取消初始化保护、故障命令保护、消费端复查，覆盖待处理命令，遗漏按键释放或电源关闭，允许故障采集数据，或把事件队列缩回四项；均必须失败。主机执行采用 ASan／UBSan。这些检查没有模拟真实 RTOS、闪存、USB／BLE 协议栈或电气损坏。

升级采用配套的[候选固件包](../../hardware/usb-short-route/firmware/README.zh-CN.md)，并重新校准。状态源码／头文件及扫描配置纳入校准指纹，CMake 变异测试确认修改状态源码会改变标识。先重建两套板型产物，再以 `--refresh-guide` 运行完整审查。

## 首板仍需检查

在绝缘、限流的台架上检查启动诊断、USB 枚举、实际松键／持按／保存／状态／时序命令，以及从配套校准版刷到普通版后的设置保留。测试多键按住与释放、空闲门控及 USB／蓝牙切换。使用安全、带测量的扫描故障注入，确认回调最终成为电脑上的实际松键；不要短接带电引脚制造故障。记录模拟前端电源轨关闭、USB 诊断／充电策略继续运行及复位恢复。这些实物项目仍待验收。

校准存储还覆盖旧长度、短读、版本／CRC／阈值拒绝、正确加载及保存失败；实际固定版本设置分发函数确认拒绝坏校准不阻断后续设置。新增五个错误版本分别取消长度检查、记录验证、完整读取要求、保存 CRC，以及错误地传播分发错误。见[校准存储](calibration-storage.zh-CN.md)。
