wZuck/YETI60/docs/testing/first-article-template.csv

variant | board_serial | HEX_sha256 | date_UTC | test_id | project_criterion | instrument | instrument_settings | host_OS | battery_V | temperature_C | radio_pose_TX_interval | measured_result | raw_evidence_path | status | operator
e73 |  |  |  | inspection | hidden joints and polarity | Microscope and qualified hidden-joint inspection |  |  |  |  |  |  |  | not-run
e73 |  |  |  | power-start | 3.3V +/-5%; no persistent current limit or abnormal heat | Bench supply and oscilloscope |  |  |  |  |  |  |  | not-run
e73 |  |  |  | C5-harness | Two separate 5.1k CC; correct continuity and final fit | Meter and actual plugs |  |  |  |  |  |  |  | not-run
e73 |  |  |  | flash-calibrate | Matching HEX; readback; 60 actual keys; no ADC saturation | SWD and USB logs |  |  |  |  |  |  |  | not-run
e73 |  |  |  | mechanical | 29 mounts; no forced closure/pouch load; accepted donor stack | Calipers and photographs |  |  |  |  |  |  |  | not-run
e73 |  |  |  | battery-full | 10min released + 100 cycles per key; zero false/missed/stuck | ADC and HID logs |  |  |  |  |  |  |  | not-run
e73 |  |  |  | battery-mid | Same event/margin criterion | ADC and HID logs |  |  |  |  |  |  |  | not-run
e73 |  |  |  | battery-low | Same event/margin criterion | ADC and HID logs |  |  |  |  |  |  |  | not-run
e73 |  |  |  | USB100 | Correct power state; same event/margin criterion | USB analyzer and scope |  |  |  |  |  |  |  | not-run
e73 |  |  |  | USB500-charge | Configured host; charge/rail/temp per pack and power specs | USB analyzer and battery logger |  |  |  |  |  |  |  | not-run
e73 |  |  |  | suspend-off | Correct power state; charge thermal protection per spec | Analyzer and sensor substitution |  |  |  |  |  |  |  | not-run
e73 |  |  |  | BLE-activity | Advertise/HID/reconnect; same event/margin criterion | BLE/HID and ADC logs |  |  |  |  |  |  |  | not-run
e73 |  |  |  | WiFi-1-6-11 | Normal traffic at fixed 1m; same event/margin criterion | Traffic and RSSI log |  |  |  |  |  |  |  | not-run
e73 |  |  |  | USB3-hub | Intended hub active; same event/margin criterion | HID and ADC log |  |  |  |  |  |  |  | not-run
e73 |  |  |  | RF-range | 1/3/5m x four poses x10min; no missing/duplicate HID or disconnect | HID sequence and RSSI; sniffer for packet statistics |  |  |  |  |  |  |  | not-run
e73 |  |  |  | transport-cycles | 100 USB cycles +100 BLE reconnect/profile cycles; no stuck keys | Automated host HID log |  |  |  |  |  |  |  | not-run
e73 |  |  |  | runtime | Measured delivered capacity and mode currents; reconcile budget | Battery analyzer |  |  |  |  |  |  |  | not-run
raytac |  |  |  | inspection | hidden joints and polarity | Microscope and qualified hidden-joint inspection |  |  |  |  |  |  |  | not-run
raytac |  |  |  | power-start | 3.3V +/-5%; no persistent current limit or abnormal heat | Bench supply and oscilloscope |  |  |  |  |  |  |  | not-run
raytac |  |  |  | C5-harness | Two separate 5.1k CC; correct continuity and final fit | Meter and actual plugs |  |  |  |  |  |  |  | not-run
raytac |  |  |  | flash-calibrate | Matching HEX; readback; 60 actual keys; no ADC saturation | SWD and USB logs |  |  |  |  |  |  |  | not-run
raytac |  |  |  | mechanical | 29 mounts; no forced closure/pouch load; accepted donor stack | Calipers and photographs |  |  |  |  |  |  |  | not-run
raytac |  |  |  | battery-full | 10min released + 100 cycles per key; zero false/missed/stuck | ADC and HID logs |  |  |  |  |  |  |  | not-run
raytac |  |  |  | battery-mid | Same event/margin criterion | ADC and HID logs |  |  |  |  |  |  |  | not-run
raytac |  |  |  | battery-low | Same event/margin criterion | ADC and HID logs |  |  |  |  |  |  |  | not-run
raytac |  |  |  | USB100 | Correct power state; same event/margin criterion | USB analyzer and scope |  |  |  |  |  |  |  | not-run
raytac |  |  |  | USB500-charge | Configured host; charge/rail/temp per pack and power specs | USB analyzer and battery logger |  |  |  |  |  |  |  | not-run
raytac |  |  |  | suspend-off | Correct power state; charge thermal protection per spec | Analyzer and sensor substitution |  |  |  |  |  |  |  | not-run
raytac |  |  |  | BLE-activity | Advertise/HID/reconnect; same event/margin criterion | BLE/HID and ADC logs |  |  |  |  |  |  |  | not-run
raytac |  |  |  | WiFi-1-6-11 | Normal traffic at fixed 1m; same event/margin criterion | Traffic and RSSI log |  |  |  |  |  |  |  | not-run
raytac |  |  |  | USB3-hub | Intended hub active; same event/margin criterion | HID and ADC log |  |  |  |  |  |  |  | not-run
raytac |  |  |  | RF-range | 1/3/5m x four poses x10min; no missing/duplicate HID or disconnect | HID sequence and RSSI; sniffer for packet statistics |  |  |  |  |  |  |  | not-run
raytac |  |  |  | transport-cycles | 100 USB cycles +100 BLE reconnect/profile cycles; no stuck keys | Automated host HID log |  |  |  |  |  |  |  | not-run
raytac |  |  |  | runtime | Measured delivered capacity and mode currents; reconcile budget | Battery analyzer |  |  |  |  |  |  |  | not-run
