wZuck/YETI60/variants/raytac/docs/testing/key-pipeline.zh-CN.md

[English](key-pipeline.md) | 简体中文

# 矩阵、键位与 HID 链路审查

当前普通版与校准版都使用 **六个普通按键的 HID 槽位，修饰键另用位图**。扫描六十个物理按键、队列能容纳 120 次变化，不等于支持六十键同时上报。固定版本 ZMK 的 HKRO 实现中，已有六个普通键保持按下时，第七个键会被忽略；之后松开先前某键，也不会自动补报仍按住的第七键，需要松开再按。这是已执行代码呈现的软件行为，真实主机上的验收仍待首板。

本轮只增加测试与说明，不改变 PCB、固件字节、校准标识、六键报告格式或 USB／蓝牙策略。继续使用现有配套镜像，不因这项测试而重新采集校准。

## 执行的代码与模拟边界

运行器读取两种 ARM 构建实际解析后的 `zephyr.dts` 与 `.config`，先与构建清单核对哈希，再要求两版矩阵和两层键位完全一致。六十个基础键名及物理行列来自校准 CSV。Fn 层另列独立预期：重音键、F1～F12、Delete，以及 J／K／L／分号位置的左／下／上／右方向键。

固定 ZMK 版本 `0862fc0f8c864834007986efcaf52f292ea6d37d` 提供以下实际函数体：

- 物理布局的扫描回调、队列消费，以及矩阵查询函数。
- 键位层状态变化、按下时的层快照、绑定查询和位置分发。
- 普通按键、暂时切层及蓝牙命令处理、编码键值向事件的转换。
- HID 监听器的按下／松开函数及完整 `hid.c`。键盘／消费者报告结构、按键、用途和修饰键常量来自同一固定版本头文件。

测试夹具模拟队列操作、原位置映射、事件分发、设备查询、端点报告提交和时间。矩阵查询表及绑定表由实际目标设备树生成；断言检查真实 HID 报告状态和模拟端点收到的报告体。ADC 扫描由独立的[扫描线程测试](scan-control.zh-CN.md)覆盖；本运行器从扫描回调处注入边沿，不运行整套固件、实时系统、USB 栈、蓝牙栈或电脑 HID 驱动。

实际蓝牙行为解码函数通过模拟蓝牙接口执行五次槽位选择，行为路由器记录一次连击行为入口按下；不实现槽位／绑定存储或连击计时。绑定及固定版本连击实现另见[恢复测试](firmware-recovery.zh-CN.md)，真实配对仍待验收。传输切换和报告清空需要结合[USB 策略检查](usb-event-policy.zh-CN.md)及实物主机测试。

## 结果

| 场景 | 已检查的行为 |
|---|---|
| 基础层 | 全部 60 个物理位置按下／松开；59 个产生 HID 的位置和一个 Fn；共 118 次模拟 HID 报告提交 |
| Fn 层 | 按住 Fn，遍历其余 59 个位置；核对 Fn 键值及透明回落，五次槽位选择、一次连击入口；松开后报告及层状态清空 |
| 松键顺序 | 先按基础键再按 Fn，按基础键值松开；先按 Fn 再按层上按键，先松 Fn 后仍按原 Fn 键值松开；均无残留键值 |
| 同时按键上限 | 保留六个普通键，忽略第七键；松开再按后可进入报告，最终报告为空 |
| 未使用矩阵位置 | 十五个空位置均不产生位置事件或 HID 报告 |
| 全部松开 | 六十次按下后按相反顺序松开；报告、层状态和八个修饰键计数均归零；不声称六十键可同时进入 HID 报告 |

四个故意错误的版本均被拒绝：矩阵位置错移、缺少按下层快照、松键使用当前层、遗漏 HID 松键。主机程序使用 Clang 地址／未定义行为检测器。测试结果不代表实物送达、输入延迟、真实主机的多键处理或电气行为已通过。

## 重现与查看证据

在仓库根目录运行：

```sh
python3 variants/raytac/scripts/test_yeti60_key_pipeline.py
python3 variants/raytac/scripts/build_usb_short_firmware.py --host-tests-only
python3 variants/raytac/scripts/check_usb_short_firmware.py
```

第一条命令需要已有的固定 west 工作区和解析后的本地 ARM 构建。仅更新主机测试的发布模式会先拒绝过期的固件来源／镜像，再按候选板构建独立重复测试；它不会代替固件改动后的重新编译。

[参考构建证据](../audit/key-pipeline.json) · [当前候选板证据](../../hardware/usb-short-route/firmware/key-pipeline.json) · [实际运行器](../../scripts/test_yeti60_key_pipeline.py) · [主机测试夹具](../../tests/yeti60/key_pipeline.c) · [首板验收](README.zh-CN.md)

首板应在 USB 和蓝牙下分别核对每个基础／Fn 位置、两种 Fn 松键顺序、修饰键组合、六个普通键加修饰键、第七键限制及最终完整松开；在挂起／恢复、断开／重连和更换主机后重复。记录所用主机及系统的实际报告，模拟报告提交不能证明主机收到了数据包。

## 已链接的 USB／蓝牙报告格式

本次从普通版和校准版的实际 ARM ELF 读取符号及字节，不只检查源代码。参考板及当前候选板各自独立核对，两种固件中各保留两份完全相同的 77 字节报告映射，分别供 USB 和蓝牙使用。解析器逐项计算输入字段，并与已链接的报告对象大小、编号及蓝牙 Report Reference 比较。

| 报告 | 编号 | 报告体 | USB 含编号总长 | 蓝牙 Report Reference |
|---|---:|---:|---:|---|
| 键盘 | 1 | 8 字节 | 9 字节 | `[1, 1]`，输入报告 |
| 消费者控制 | 2 | 12 字节 | 13 字节 | `[2, 1]`，输入报告 |

已链接 USB HID 接口的中断输入端点为 16 字节、1 ms 间隔，两种报告均能容纳。蓝牙端通过报告特征及其 Reference 指定编号，报告体不再带 USB 的编号字节。固定 Zephyr 头文件 `BT_ATT_DEFAULT_LE_MTU` 为 23；按该最低值扣除 3 字节 ATT 通知头后，20 字节容量能够容纳 8／12 字节报告体。这不是实测或已协商的 MTU。77 字节映射通过描述符／属性读取传输，不是一次按键通知的长度。

ELF 中的 USB 配置总长、接口／端点编号及 HID 描述符长度仍是启动时待填入的字段；检查不把静态零值当作运行时已枚举数据，也没有执行这些运行时填充。两版配置未启用 USB 启动键盘协议，当前接口子类／协议初值均为零；BIOS／UEFI 使用尚未验收。实际描述符请求、GATT 属性读取、加密／订阅、通知送达、主机兼容及速率仍须实物测试。

12 项目标产物测试覆盖原有电流声明／回调链接及新增 HID 检查。在两种镜像上拒绝映射不一致、报告槽位／类型／编号错误、修饰键范围错误、端点过小、蓝牙 Reference 错误、对象编号错误及截断／不配平条目。检查器自己的来源哈希也记录在目标检查报告中。

[参考目标检查](../audit/yeti60-target-check.json) · [当前候选目标检查](../../hardware/usb-short-route/firmware/target-check.json) · [实际二进制解析器](../../scripts/yeti60_hid_contract.py) · [目标产物测试](../../tests/audit/test_target.py)
