wZuck/YETI60/firmware/target/calibration-keys.csv

index | key_binding | row | column | hold_then_command
0 | &kp ESC | 0 | 0 | yeti_calibrate press 0 0
1 | &kp N1 | 0 | 1 | yeti_calibrate press 0 1
2 | &kp N2 | 0 | 2 | yeti_calibrate press 0 2
3 | &kp N3 | 0 | 3 | yeti_calibrate press 0 3
4 | &kp N4 | 0 | 4 | yeti_calibrate press 0 4
5 | &kp N5 | 0 | 5 | yeti_calibrate press 0 5
6 | &kp N6 | 0 | 6 | yeti_calibrate press 0 6
7 | &kp N7 | 0 | 7 | yeti_calibrate press 0 7
8 | &kp N8 | 0 | 8 | yeti_calibrate press 0 8
9 | &kp N9 | 0 | 9 | yeti_calibrate press 0 9
10 | &kp N0 | 0 | 10 | yeti_calibrate press 0 10
11 | &kp MINUS | 0 | 11 | yeti_calibrate press 0 11
12 | &kp EQUAL | 0 | 12 | yeti_calibrate press 0 12
13 | &kp BSLH | 0 | 13 | yeti_calibrate press 0 13
14 | &kp GRAVE | 0 | 14 | yeti_calibrate press 0 14
15 | &kp TAB | 1 | 0 | yeti_calibrate press 1 0
16 | &kp Q | 1 | 1 | yeti_calibrate press 1 1
17 | &kp W | 1 | 2 | yeti_calibrate press 1 2
18 | &kp E | 1 | 3 | yeti_calibrate press 1 3
19 | &kp R | 1 | 4 | yeti_calibrate press 1 4
20 | &kp T | 1 | 5 | yeti_calibrate press 1 5
21 | &kp Y | 1 | 6 | yeti_calibrate press 1 6
22 | &kp U | 1 | 7 | yeti_calibrate press 1 7
23 | &kp I | 1 | 8 | yeti_calibrate press 1 8
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
