wZuck/YETI60/docs/testing/afe-ac.csv

frequency_Hz | out_real_V_per_V | out_imag_V_per_V
10.0 | 100.960231 | -0.146434352
10.391223 | 100.960211 | -0.152162069
10.7977516 | 100.96019 | -0.158113751
11.2201845 | 100.960167 | -0.164298149
11.659144 | 100.960143 | -0.170724357
12.1152766 | 100.960117 | -0.177401825
12.5892541 | 100.960089 | -0.184340368
13.0817747 | 100.960058 | -0.19155019
13.5935639 | 100.960023 | -0.19904188
14.1253754 | 100.959988 | -0.20682647
14.6779927 | 100.95995 | -0.214915396
15.2522296 | 100.959909 | -0.223320551
15.8489319 | 100.959866 | -0.232054291
16.4689787 | 100.959819 | -0.241129457
17.113283 | 100.959766 | -0.250559381
17.7827941 | 100.959712 | -0.260357951
18.478498 | 100.959653 | -0.270539563
19.2014194 | 100.95959 | -0.281119191
19.9526231 | 100.959521 | -0.29211238
20.7332157 | 100.959448 | -0.303535326
21.5443469 | 100.95937 | -0.315404817
22.3872114 | 100.959287 | -0.327738315
23.2630507 | 100.959195 | -0.340553951
24.1731548 | 100.959098 | -0.353870612
25.1188643 | 100.958992 | -0.367707863
26.1015722 | 100.95888 | -0.382086101
27.1227258 | 100.958758 | -0.397026457
28.1838293 | 100.958629 | -0.412550958
29.2864456 | 100.958488 | -0.428682424
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
