wZuck/YETI60/docs/testing/afe-sensitivity.csv

mux_ohm | ADC_load_pF | C10_pF | rshunt_ohm | DC_output_V | step_output_delta_mV | at_5us_after_step_delta_mV | at_45us_after_step_delta_mV | gain_10Hz_V_per_V | gain_1kHz_V_per_V | gain_100kHz_V_per_V | gain_1MHz_V_per_V
60 | 5 | 198 | 1e12 | 0.501949181 | 99.69651499999999 | 20.236056 | 89.54420299999998 | 100.96036883879265 | 100.13655776348713 | 7.594429386651423 | 0.2888723263223595
60 | 5 | 220 | 1e12 | 0.501949181 | 99.02609900000003 | 18.465498000000082 | 86.85163900000003 | 100.96034811204095 | 99.95260363026614 | 6.8608006039432885 | 0.2610861772433108
60 | 5 | 242 | 1e12 | 0.501949181 | 98.21496500000005 | 16.978978000000033 | 84.165936 | 100.96032831525 | 99.75103988267803 | 6.256178965088096 | 0.23817636514352405
60 | 10 | 198 | 1e12 | 0.501949181 | 99.69651499999999 | 20.236071000000024 | 89.54420500000005 | 100.96036883879395 | 100.13655808693582 | 7.594662196062632 | 0.28901001227502454
60 | 10 | 220 | 1e12 | 0.501949181 | 99.0261 | 18.465510000000073 | 86.85164200000006 | 100.96034811204241 | 99.95260395584798 | 6.861010690528039 | 0.2612107202037972
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
