wZuck/YETI60/docs/testing/afe-transient.csv

time_s | sense_V | out_V
0.0 | 0.00499893057 | 0.501949141
1e-09 | 0.00499893057 | 0.501949141
2e-09 | 0.00499893057 | 0.501949141
4e-09 | 0.00499893057 | 0.501949141
8e-09 | 0.00499893057 | 0.501949141
1.6e-08 | 0.00499893057 | 0.501949141
3.2e-08 | 0.00499893057 | 0.501949141
6.4e-08 | 0.00499893057 | 0.501949141
1.28e-07 | 0.00499893057 | 0.501949141
2.28e-07 | 0.00499893057 | 0.501949141
3.28e-07 | 0.00499893057 | 0.501949142
4.28e-07 | 0.00499893057 | 0.501949141
5.28e-07 | 0.00499893057 | 0.501949141
6.28e-07 | 0.00499893057 | 0.501949141
7.28e-07 | 0.00499893057 | 0.501949141
8.28e-07 | 0.00499893057 | 0.501949141
9.28e-07 | 0.00499893057 | 0.501949141
1.028e-06 | 0.00499893057 | 0.501949141
1.128e-06 | 0.00499893057 | 0.501949141
1.228e-06 | 0.00499893057 | 0.501949141
1.328e-06 | 0.00499893057 | 0.501949141
1.428e-06 | 0.00499893057 | 0.501949141
1.528e-06 | 0.00499893057 | 0.501949141
1.628e-06 | 0.00499893057 | 0.501949141
1.728e-06 | 0.00499893057 | 0.501949141
1.828e-06 | 0.00499893057 | 0.501949141
1.928e-06 | 0.00499893057 | 0.501949141
2.028e-06 | 0.00499893057 | 0.501949141
2.128e-06 | 0.00499893057 | 0.501949141
2.228e-06 | 0.00499893057 | 0.501949141
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
