wZuck/YETI60/docs/testing/analog-waveform-sensitivity.csv

order | key_pF_assumed | ADC_API_delay_us_assumed | sample_after_row_us | sense_at_sample_V | ideal_gain_proxy_at_sample_V | ADC_code_proxy | ideal_proxy_clipped_at_sample | sense_0_2us_after_row_fall_V
correct | 0.5 | 0 | 45.5 | 0.00125240753 | 0.12649316 | 144 | False | -2.444660623752646e-09
correct | 0.5 | 5 | 50.5 | 0.0010738469400000004 | 0.10845854100000005 | 123 | False | -2.448850450524449e-09
correct | 0.5 | 20 | 65.5 | 0.0006769125020000004 | 0.06836816270000003 | 78 | False | -2.441998181725483e-09
correct | 0.5 | 50 | 95.5 | 0.00026897556900000013 | 0.02716653250000001 | 31 | False | -2.4029756801498315e-09
correct | 0.5 | 100 | 145.5 | 5.77670249e-05 | 0.00583446952 | 7 | False | -2.452702429614649e-09
correct | 0.5 | 200 | 245.5 | 2.66449146e-06 | 0.000269113638 | 0 | False | -2.452702433738265e-09
correct | 1 | 0 | 45.5 | 0.00250635865 | 0.253142224 | 288 | False | -4.987395071217272e-09
correct | 1 | 5 | 50.5 | 0.002149524300000001 | 0.2171019540000001 | 247 | False | -5.018072582380496e-09
correct | 1 | 20 | 65.5 | 0.0013559378500000007 | 0.13694972300000005 | 156 | False | -5.0564411615293475e-09
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
