wZuck/YETI60/docs/testing/images/analog-waveform.png

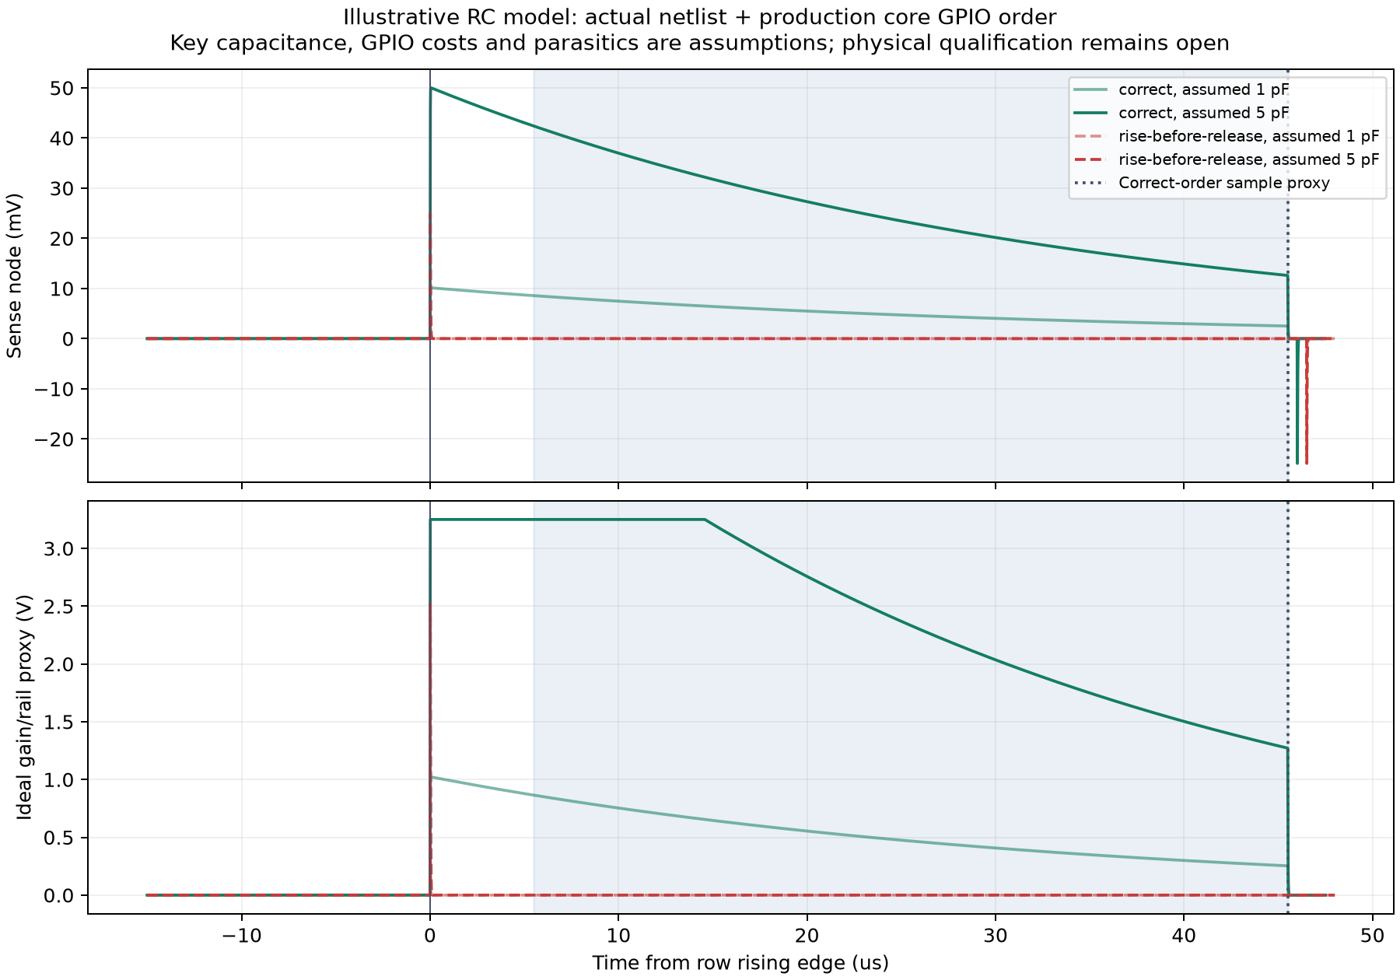
docs/testing/images/analog-waveform.png
