wZuck/YETI60/(list of files, drawings)

Other design files:
docs/audit/pcb-drc.json
docs/audit/pcb-metadata.json
docs/audit/schematic-current.json
hardware/ec60-nrf52840/pcb-contract-check.json
hardware/ec60-nrf52840/pcb-placement-contract.json
mechanical/pcb-fabrication-spec.json
variants/raytac/docs/audit/schematic-current.json
