wZuck/YETI60/hardware/e73-hhkb-corner/EC60-nRF52840.kicad_pcb

## KiCad design hardware/e73-hhkb-corner/EC60-nRF52840.kicad_pcb (2026-11-14)

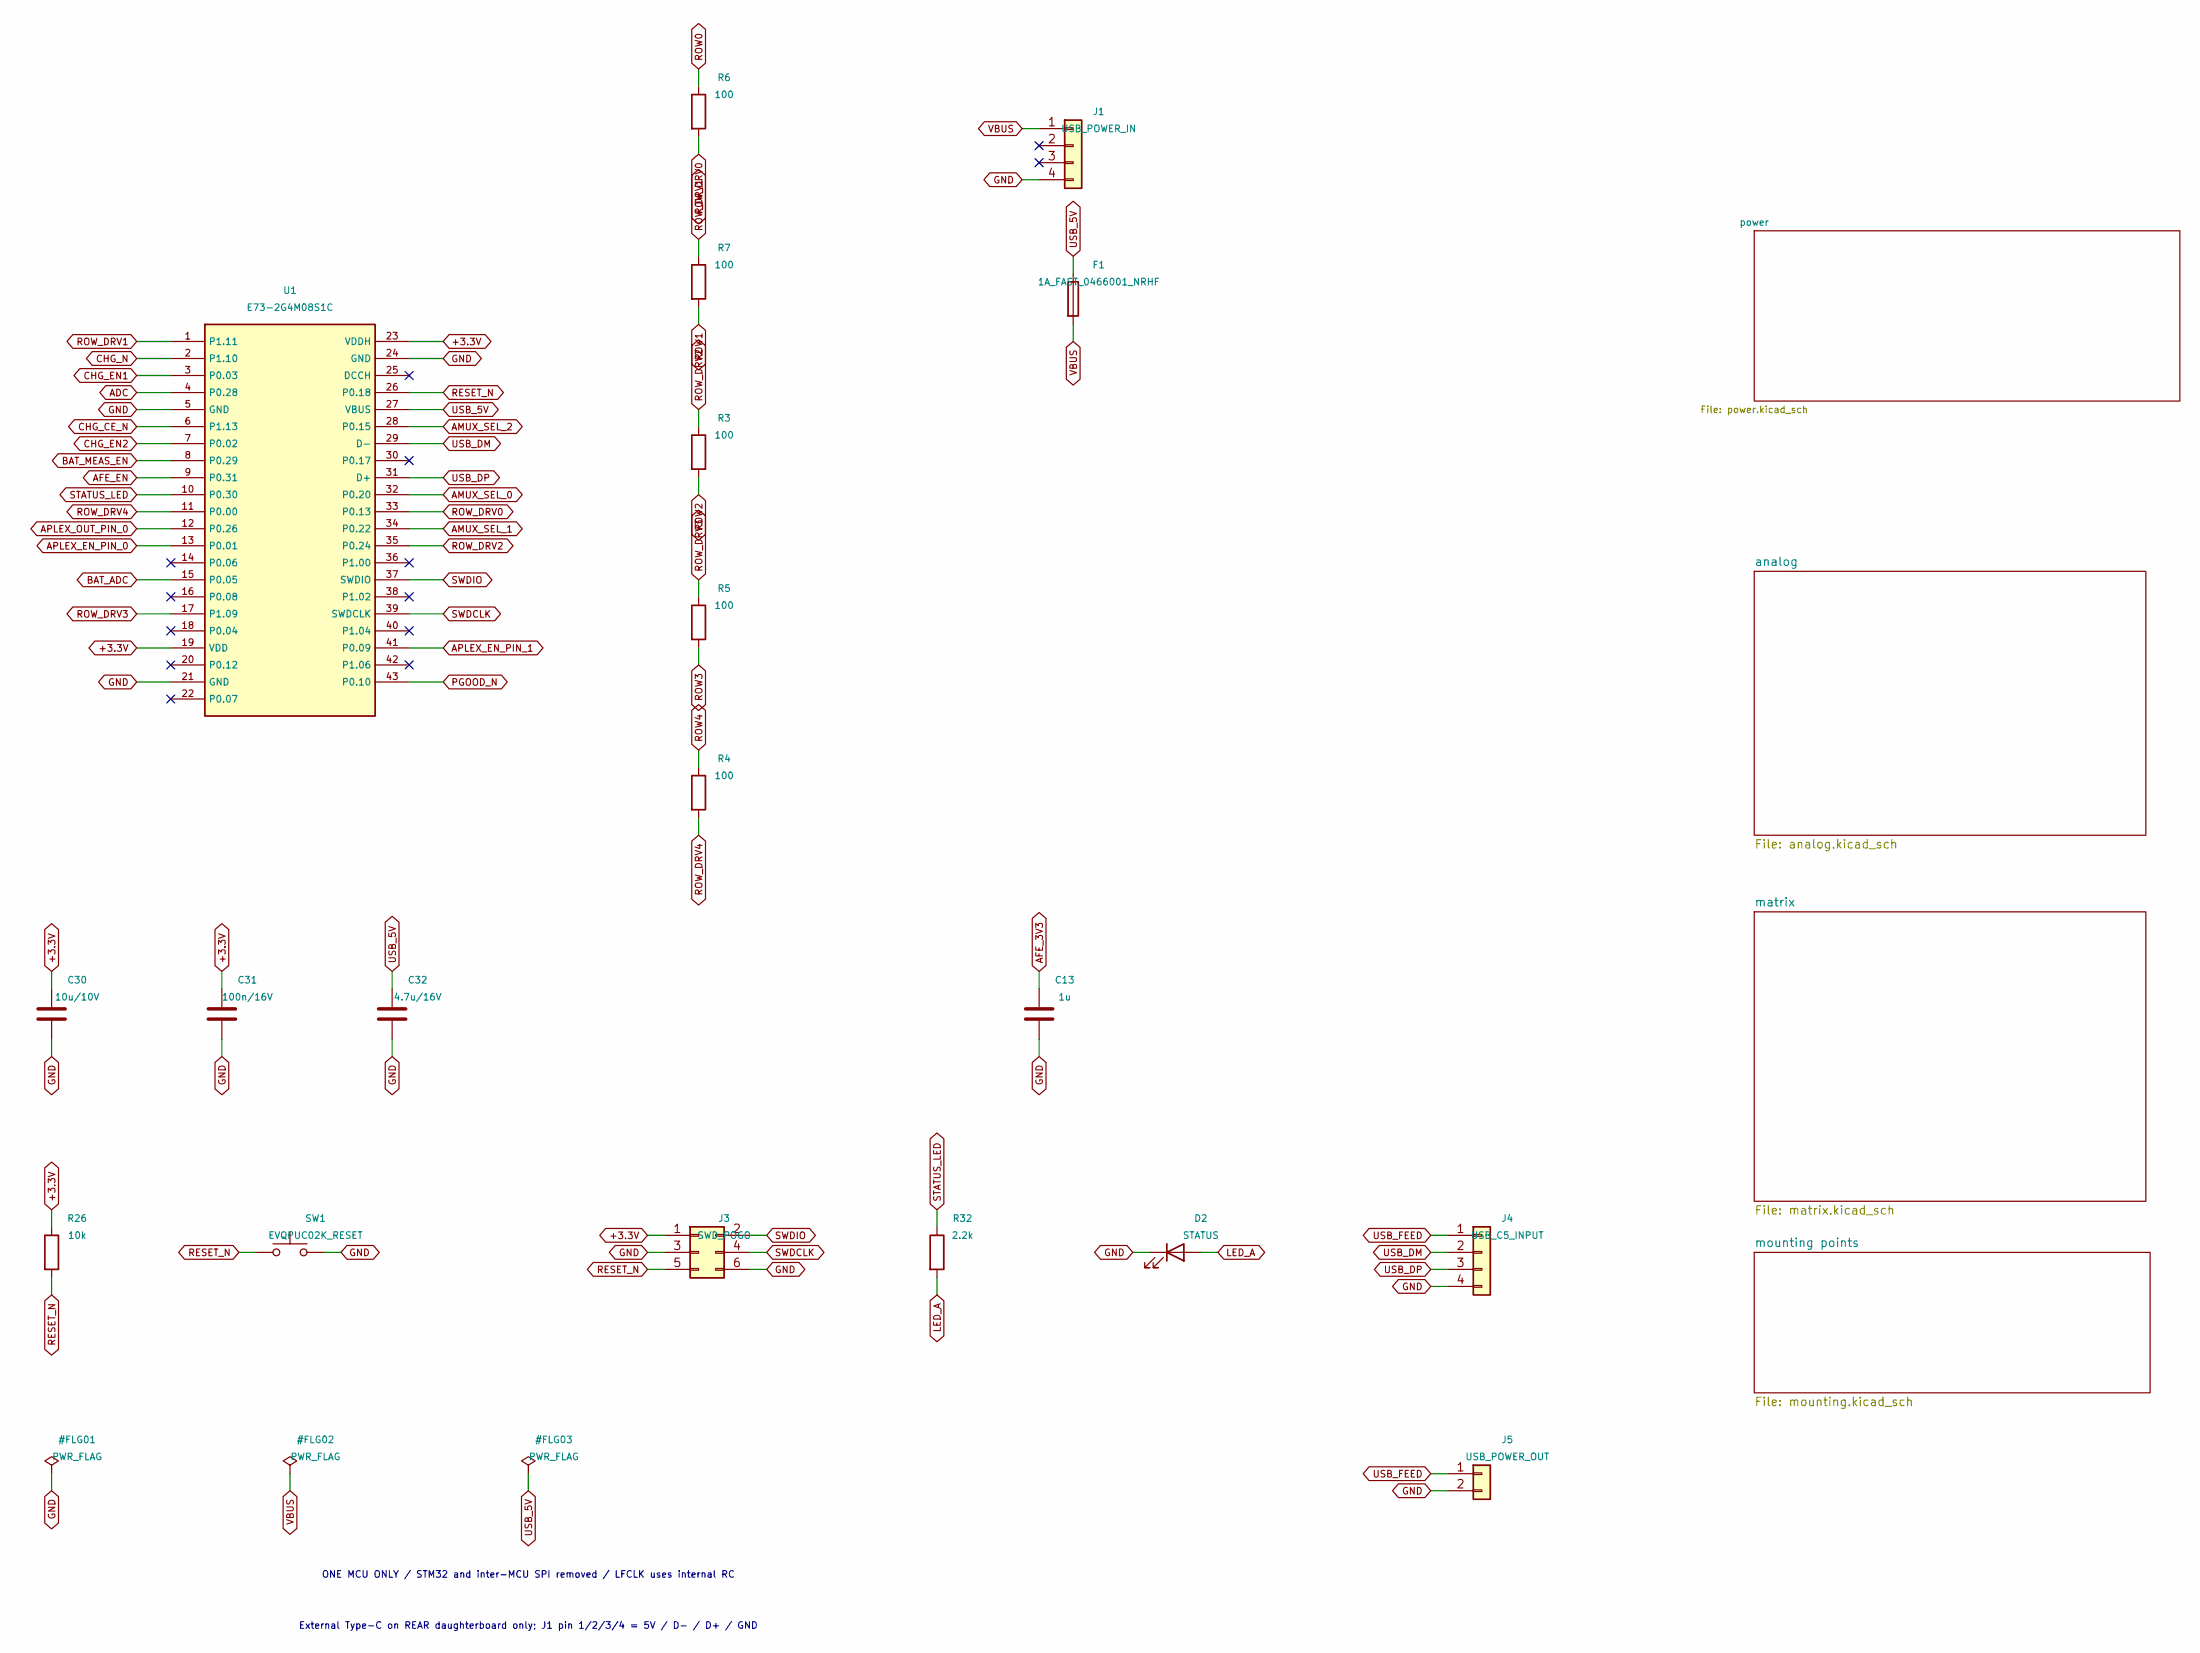
[picture p198: schematic EC60-nRF52840.kicad_sch, EC60 / single nRF52840 / rear USB daughterboard]

Parts:
C13: 1u; C_0402_1005Metric__C13
C30: 10u/10V; C_0603_1608Metric__C30
C31: 100n/16V; C_0402_1005Metric__C31
C32: 4.7u/16V; C_0603_1608Metric__C32
D2: STATUS; LED_0603_1608Metric__D2
F1: 1A_FAST_0466001_NRHF; Fuse_Littelfuse_0466_1206__F1
J1: USB_POWER_IN; JST-SR-4__J1
J3: SWD_POGO; SWD_Pogo_2x03__J3
J4: USB_C5_INPUT; JST-SR-4__J4
J5: USB_POWER_OUT; JST_SH_SM02B_SRSS_TB__J5
R3: 100; R_0402_1005Metric__R3
R4: 100; R_0402_1005Metric__R4
R5: 100; R_0402_1005Metric__R5
R6: 100; R_0402_1005Metric__R6
R7: 100; R_0402_1005Metric__R7
R26: 10k; R_0402_1005Metric__R26
R32: 2.2k; R_0402_1005Metric__R32
SW1: EVQPUC02K_RESET; Panasonic_EVQPUL_EVQPUC__SW1
U1: E73-2G4M08S1C; E73-2G4M08S1C__U1

Connections:
+3.3V: C30.1, C31.1, J3.1, R26.1, U1.19 (VDD), U1.23 (VDDH); also elsewhere on the board
ADC: U1.4 (P0.28); also elsewhere on the board
AFE_EN: U1.9 (P0.31); also elsewhere on the board
AMUX_SEL_0: U1.32 (P0.20); also elsewhere on the board
AMUX_SEL_1: U1.34 (P0.22); also elsewhere on the board
AMUX_SEL_2: U1.28 (P0.15); also elsewhere on the board
APLEX_EN_PIN_0: U1.13 (P0.01); also elsewhere on the board
APLEX_EN_PIN_1: U1.41 (P0.09); also elsewhere on the board
APLEX_OUT_PIN_0: U1.12 (P0.26); also elsewhere on the board
BAT_ADC: U1.15 (P0.05); also elsewhere on the board
BAT_MEAS_EN: U1.8 (P0.29); also elsewhere on the board
CHG_CE_N: U1.6 (P1.13); also elsewhere on the board
CHG_EN1: U1.3 (P0.03); also elsewhere on the board
CHG_EN2: U1.7 (P0.02); also elsewhere on the board
CHG_N: U1.2 (P1.10); also elsewhere on the board
GND: C13.2, C30.2, C31.2, C32.2, D2.1 (K), J1.4, J3.3, J3.6, J4.4, J5.2, SW1.2, U1.5 (GND), U1.21 (GND), U1.24 (GND); also elsewhere on the board
LED_A: D2.2 (A), R32.2
PGOOD_N: U1.43 (P0.10); also elsewhere on the board
RESET_N: J3.5, R26.2, SW1.1, U1.26 (P0.18)
ROW0: R6.1; also elsewhere on the board
ROW1: R7.2; also elsewhere on the board
ROW2: R3.2; also elsewhere on the board
ROW3: R5.2; also elsewhere on the board
ROW4: R4.1; also elsewhere on the board
ROW_DRV0: R6.2, U1.33 (P0.13)
ROW_DRV1: R7.1, U1.1 (P1.11)
ROW_DRV2: R3.1, U1.35 (P0.24)
ROW_DRV3: R5.1, U1.17 (P1.09)
ROW_DRV4: R4.2, U1.11 (P0.00)
STATUS_LED: R32.1, U1.10 (P0.30)
SWDCLK: J3.4, U1.39 (SWDCLK)
SWDIO: J3.2, U1.37 (SWDIO)
USB_5V: C32.1, F1.1, U1.27 (VBUS); also elsewhere on the board
USB_DM: J4.2, U1.29 (D-)
USB_DP: J4.3, U1.31 (D+)
USB_FEED: J4.1, J5.1
VBUS: F1.2, J1.1

Notes on the sheet:
ONE MCU ONLY / STM32 and inter-MCU SPI removed / LFCLK uses internal RC
External Type-C on REAR daughterboard only; J1 pin 1/2/3/4 = 5V / D- / D+ / GND

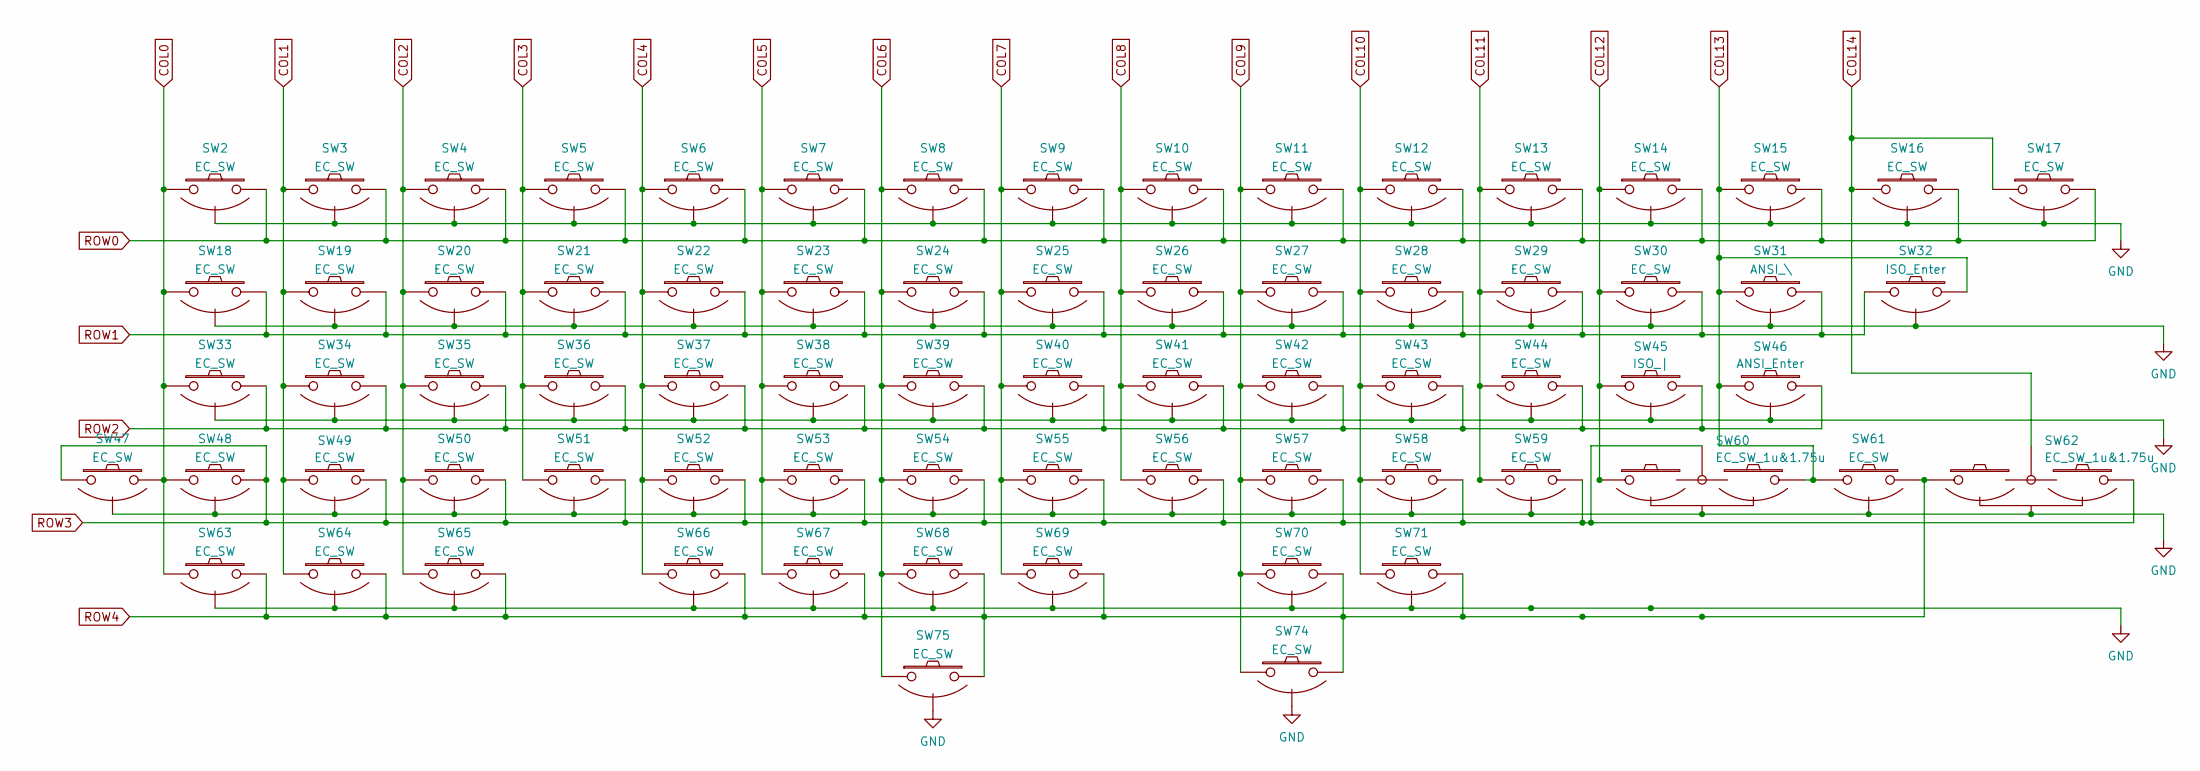
[picture p199: schematic matrix.kicad_sch, EC60 - Matrix]

Parts:
SW2: EC_SW; ecs_pad_no_ring__SW2
SW3: EC_SW; ecs_pad_no_ring__SW3
SW4: EC_SW; ecs_pad_no_ring__SW4
SW5: EC_SW; ecs_pad_no_ring__SW5
SW6: EC_SW; ecs_pad_no_ring__SW6
SW7: EC_SW; ecs_pad_no_ring__SW7
SW8: EC_SW; ecs_pad_no_ring__SW8
SW9: EC_SW; ecs_pad_no_ring__SW9
SW10: EC_SW; ecs_pad_no_ring__SW10
SW11: EC_SW; ecs_pad_no_ring__SW11
SW12: EC_SW; ecs_pad_no_ring__SW12
SW13: EC_SW; ecs_pad_no_ring__SW13
SW14: EC_SW; ecs_pad_no_ring__SW14
SW15: EC_SW; ecs_pad_no_ring__SW15
SW16: EC_SW; ecs_pad_no_ring__SW16
SW17: EC_SW; ecs_pad_no_ring__SW17
SW18: EC_SW; ecs_pad_no_ring__SW18
SW19: EC_SW; ecs_pad_no_ring__SW19
SW20: EC_SW; ecs_pad_no_ring__SW20
SW21: EC_SW; ecs_pad_no_ring__SW21
SW22: EC_SW; ecs_pad_no_ring__SW22
SW23: EC_SW; ecs_pad_no_ring__SW23
SW24: EC_SW; ecs_pad_no_ring__SW24
SW25: EC_SW; ecs_pad_no_ring__SW25
SW26: EC_SW; ecs_pad_no_ring__SW26
SW27: EC_SW; ecs_pad_no_ring__SW27
SW28: EC_SW; ecs_pad_no_ring__SW28
SW29: EC_SW; ecs_pad_no_ring__SW29
SW30: EC_SW; ecs_pad_no_ring__SW30
SW31: ANSI_\; ecs_pad_no_ring__SW31
SW32: ISO_Enter; ecs_pad_no_ring__SW32
SW33: EC_SW; ecs_pad_no_ring_stepped&normal__SW33
SW34: EC_SW; ecs_pad_no_ring__SW34
SW35: EC_SW; ecs_pad_no_ring__SW35
SW36: EC_SW; ecs_pad_no_ring__SW36
SW37: EC_SW; ecs_pad_no_ring__SW37
SW38: EC_SW; ecs_pad_no_ring__SW38
SW39: EC_SW; ecs_pad_no_ring__SW39
SW40: EC_SW; ecs_pad_no_ring__SW40
SW41: EC_SW; ecs_pad_no_ring__SW41
SW42: EC_SW; ecs_pad_no_ring__SW42
SW43: EC_SW; ecs_pad_no_ring__SW43
SW44: EC_SW; ecs_pad_no_ring__SW44
SW45: ISO_|; ecs_pad_no_ring__SW45
SW46: ANSI_Enter; ecs_pad_no_ring__SW46
SW47: EC_SW; ecs_pad_no_ring__SW47
SW48: EC_SW; ecs_pad_no_ring_1u_edge_cut__SW48
SW49: EC_SW; ecs_pad_no_ring_1u_edge_cut__SW49
SW50: EC_SW; ecs_pad_no_ring__SW50
SW51: EC_SW; ecs_pad_no_ring__SW51
SW52: EC_SW; ecs_pad_no_ring__SW52
SW53: EC_SW; ecs_pad_no_ring__SW53
SW54: EC_SW; ecs_pad_no_ring__SW54
SW55: EC_SW; ecs_pad_no_ring__SW55
SW56: EC_SW; ecs_pad_no_ring__SW56
SW57: EC_SW; ecs_pad_no_ring__SW57
SW58: EC_SW; ecs_pad_no_ring__SW58
SW59: EC_SW; ecs_pad_no_ring__SW59
SW60: EC_SW_1u&1.75u; ecs_pad_no_ring_1u1.75u__SW60
SW61: EC_SW; ecs_pad_no_ring__SW61
SW62: EC_SW_1u&1.75u; ecs_pad_no_ring_1u1.75u__SW62
SW63: EC_SW; ecs_pad_no_ring__SW63
SW64: EC_SW; ecs_pad_no_ring__SW64
SW65: EC_SW; ecs_pad_no_ring__SW65
SW66: EC_SW; ecs_pad_no_ring__SW66
SW67: EC_SW; ecs_pad_no_ring__SW67
SW68: EC_SW; ecs_pad_no_ring_stepped&normal__SW68
SW69: EC_SW; ecs_pad_no_ring_stepped&normal__SW69
SW70: EC_SW; ecs_pad_no_ring__SW70
SW71: EC_SW; ecs_pad_no_ring_stepped&normal__SW71
SW74: EC_SW; ecs_pad_no_ring__SW74
SW75: EC_SW; ecs_pad_no_ring__SW75

Connections:
COL0: SW2.1, SW18.1, SW33.1, SW47.2, SW48.1, SW63.1; also elsewhere on the board
COL1: SW3.1, SW19.1, SW34.1, SW49.2, SW64.1; also elsewhere on the board
COL2: SW4.1, SW20.1, SW35.1, SW50.1, SW65.1; also elsewhere on the board
COL3: SW5.1, SW21.1, SW36.1, SW51.1; also elsewhere on the board
COL4: SW6.1, SW22.1, SW37.1, SW52.1, SW66.1; also elsewhere on the board
COL5: SW7.1, SW23.1, SW38.1, SW53.1, SW67.1; also elsewhere on the board
COL6: SW8.1, SW24.1, SW39.1, SW54.1, SW68.1, SW75.1; also elsewhere on the board
COL7: SW9.1, SW25.1, SW40.1, SW55.1, SW69.1; also elsewhere on the board
COL8: SW10.1, SW26.1, SW41.1, SW56.1; also elsewhere on the board
COL9: SW11.1, SW27.1, SW42.1, SW57.1, SW70.1, SW74.1; also elsewhere on the board
COL10: SW12.1, SW28.1, SW43.1, SW58.1, SW71.1; also elsewhere on the board
COL11: SW13.1, SW29.1, SW44.1, SW59.1; also elsewhere on the board
COL12: SW14.1, SW30.1, SW45.1, SW60.1; also elsewhere on the board
COL13: SW15.1, SW31.1, SW32.2, SW46.2, SW60.3, SW61.1; also elsewhere on the board
COL14: SW16.1, SW17.1, SW62.2; also elsewhere on the board
GND: SW2.3 (SG), SW3.3 (SG), SW4.3 (SG), SW5.3 (SG), SW6.3 (SG), SW7.3 (SG), SW8.3 (SG), SW9.3 (SG), SW10.3 (SG), SW11.3 (SG), SW12.3 (SG), SW13.3 (SG), SW14.3 (SG), SW15.3 (SG), SW16.3 (SG), SW17.3 (SG), SW18.3 (SG), SW19.3 (SG), SW20.3 (SG), SW21.3 (SG), SW22.3 (SG), SW23.3 (SG), SW24.3 (SG), SW25.3 (SG), SW26.3 (SG), SW27.3 (SG), SW28.3 (SG), SW29.3 (SG), SW30.3 (SG), SW31.3 (SG), SW32.3 (SG), SW33.3 (SG), SW34.3 (SG), SW35.3 (SG), SW36.3 (SG), SW37.3 (SG), SW38.3 (SG), SW39.3 (SG), SW40.3 (SG), SW41.3 (SG), SW42.3 (SG), SW43.3 (SG), SW44.3 (SG), SW45.3 (SG), SW46.3 (SG), SW47.3 (SG), SW48.3 (SG), SW49.3 (SG), SW50.3 (SG), SW51.3 (SG), SW52.3 (SG), SW53.3 (SG), SW54.3 (SG), SW55.3 (SG), SW56.3 (SG), SW57.3 (SG), SW58.3 (SG), SW59.3 (SG), SW60.4 (SG), SW61.3 (SG), SW62.4 (SG), SW63.3 (SG), SW64.3 (SG), SW65.3 (SG), SW66.3 (SG), SW67.3 (SG), SW68.3 (SG), SW69.3 (SG), SW70.3 (SG), SW71.3 (SG), SW74.3 (SG), SW75.3 (SG); also elsewhere on the board
ROW0: SW2.2, SW3.2, SW4.2, SW5.2, SW6.2, SW7.2, SW8.2, SW9.2, SW10.2, SW11.2, SW12.2, SW13.2, SW14.2, SW15.2, SW16.2, SW17.2; also elsewhere on the board
ROW1: SW18.2, SW19.2, SW20.2, SW21.2, SW22.2, SW23.2, SW24.2, SW25.2, SW26.2, SW27.2, SW28.2, SW29.2, SW30.2, SW31.2, SW32.1; also elsewhere on the board
ROW2: SW33.2, SW34.2, SW35.2, SW36.2, SW37.2, SW38.2, SW39.2, SW40.2, SW41.2, SW42.2, SW43.2, SW44.2, SW45.2, SW46.1; also elsewhere on the board
ROW3: SW47.1, SW48.2, SW49.1, SW50.2, SW51.2, SW52.2, SW53.2, SW54.2, SW55.2, SW56.2, SW57.2, SW58.2, SW59.2, SW60.2, SW62.3; also elsewhere on the board
ROW4: SW61.2, SW62.1, SW63.2, SW64.2, SW65.2, SW66.2, SW67.2, SW68.2, SW69.2, SW70.2, SW71.2, SW74.2, SW75.2; also elsewhere on the board

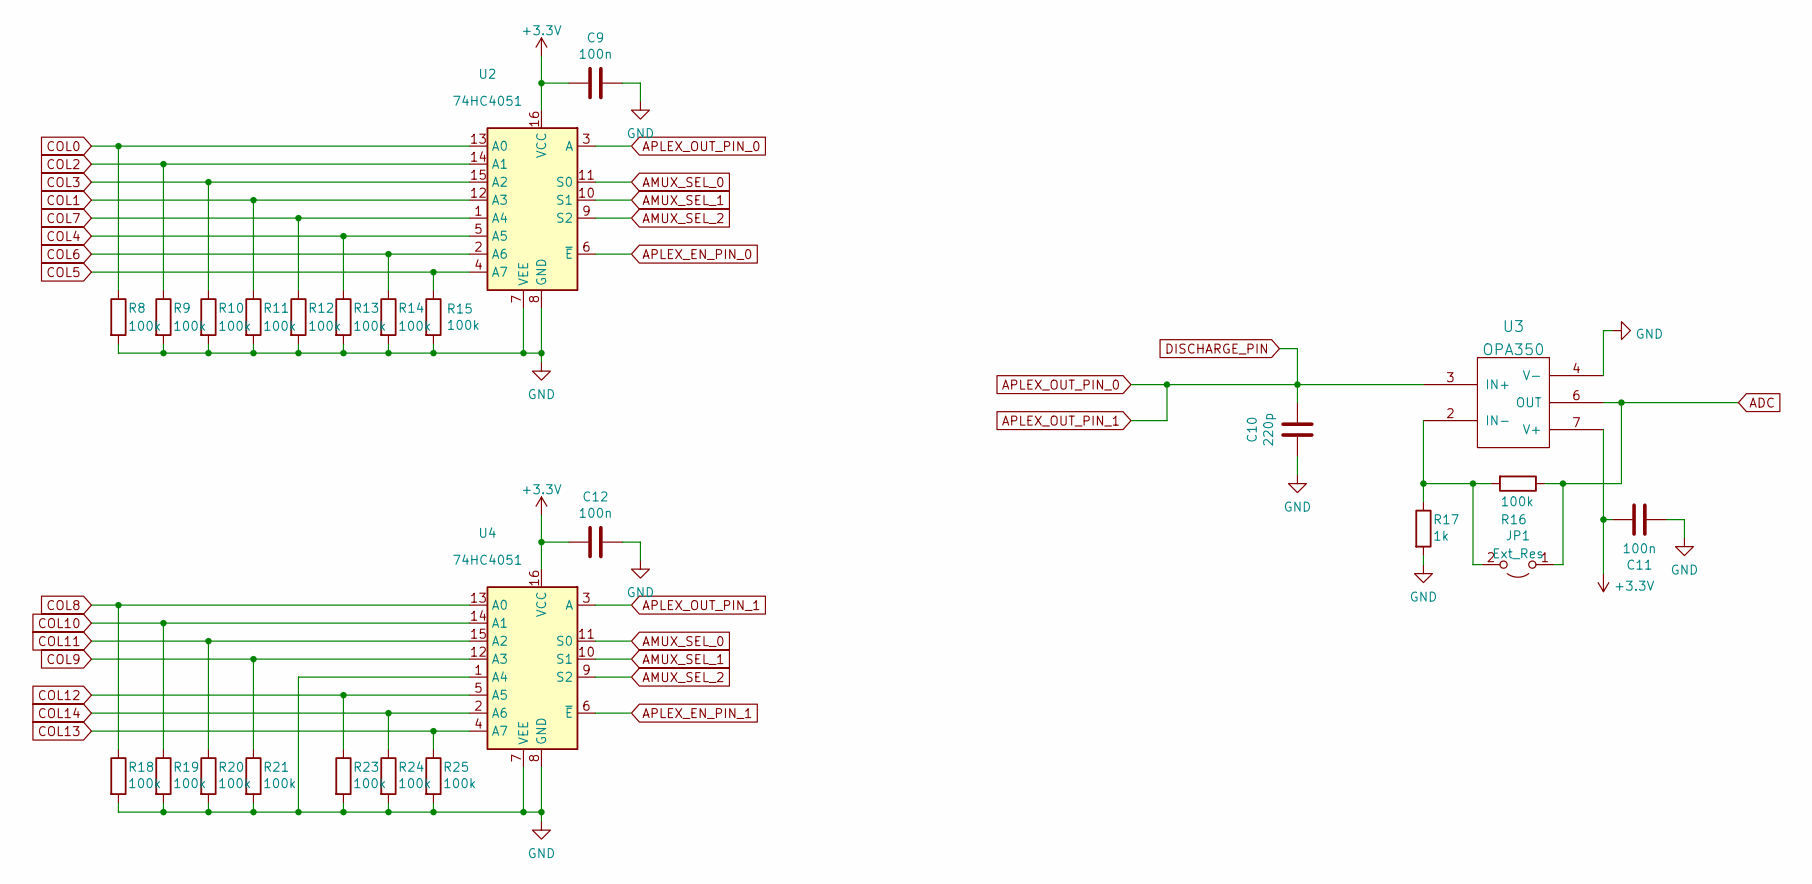
[picture p200: schematic analog.kicad_sch, EC60 - Analog Circuit]

Parts:
C9, C11, C12: 100n; C_0402_1005Metric; LCSC C307331
C10: 220p; C_0402_1005Metric; LCSC C1530
JP1: Ext_Res; R_0603_1608Metric_Pad0.98x0.95mm_HandSolder
R8, R9, R10, R11, R12, R13, R14, R15, R16, R18, R19, R20, R21, R23, R24, R25: 100k; R_0402_1005Metric; LCSC C25741
R17: 1k; R_0402_1005Metric; LCSC C11702
U2, U4: 74HC4051; TSSOP16; LCSC C5645
U3: OPA350; SOIC-8_3.9x4.9mm_P1.27mm; LCSC C13388

Connections:
ADC: JP1.1 (A), R16.1, U3.6 (OUT); also elsewhere on the board
AMUX_SEL_0: U2.11 (S0), U4.11 (S0); also elsewhere on the board
AMUX_SEL_1: U2.10 (S1), U4.10 (S1); also elsewhere on the board
AMUX_SEL_2: U2.9 (S2), U4.9 (S2); also elsewhere on the board
APLEX_EN_PIN_0: U2.6 (~E); also elsewhere on the board
APLEX_EN_PIN_1: U4.6 (~E); also elsewhere on the board
APLEX_OUT_PIN_0: C10.1, U2.3 (A), U3.3 (IN+), U4.3 (A); also elsewhere on the board
COL0: R8.1, U2.13 (A0); also elsewhere on the board
COL1: R11.1, U2.12 (A3); also elsewhere on the board
COL2: R9.1, U2.14 (A1); also elsewhere on the board
COL3: R10.1, U2.15 (A2); also elsewhere on the board
COL4: R13.1, U2.5 (A5); also elsewhere on the board
COL5: R15.1, U2.4 (A7); also elsewhere on the board
COL6: R14.1, U2.2 (A6); also elsewhere on the board
COL7: R12.1, U2.1 (A4); also elsewhere on the board
COL8: R18.1, U4.13 (A0); also elsewhere on the board
COL9: R21.1, U4.12 (A3); also elsewhere on the board
COL10: R19.1, U4.14 (A1); also elsewhere on the board
COL11: R20.1, U4.15 (A2); also elsewhere on the board
COL12: R23.1, U4.5 (A5); also elsewhere on the board
COL13: R25.1, U4.4 (A7); also elsewhere on the board
COL14: R24.1, U4.2 (A6); also elsewhere on the board
GND: C9.1, C10.2, C11.1, C12.1, R8.2, R9.2, R10.2, R11.2, R12.2, R13.2, R14.2, R15.2, R17.2, R18.2, R19.2, R20.2, R21.2, R23.2, R24.2, R25.2, U2.7 (VEE), U2.8 (GND), U3.4 (V-), U4.1 (A4), U4.7 (VEE), U4.8 (GND); also elsewhere on the board
unnamed: JP1.2 (B), R16.2, R17.1, U3.2 (IN-)

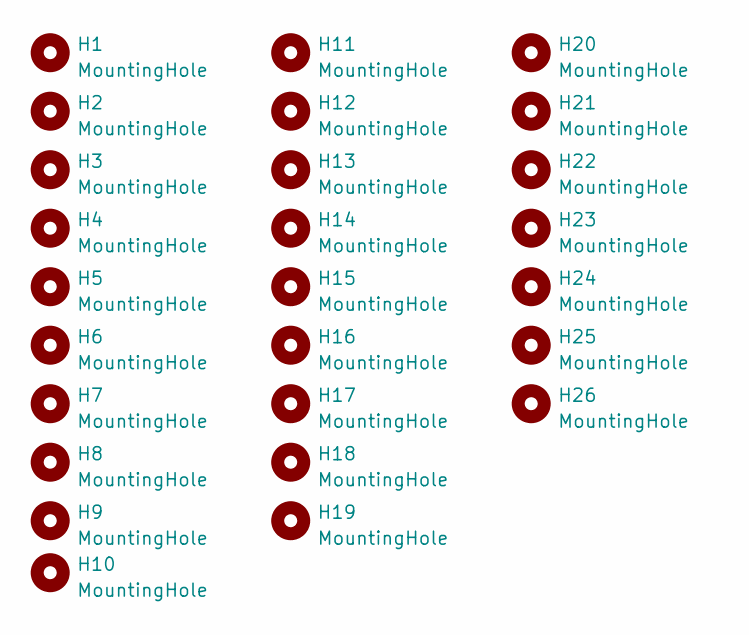
[picture p201: schematic mounting.kicad_sch, EC60 - Mounting Points]

Parts:
H1, H2, H3, H4, H5, H6, H7, H8, H9, H10, H11, H12, H13, H14, H15, H16, H17, H18, H19, H20, H21, H22, H23, H24, H25, H26: MountingHole; HOLE_M2

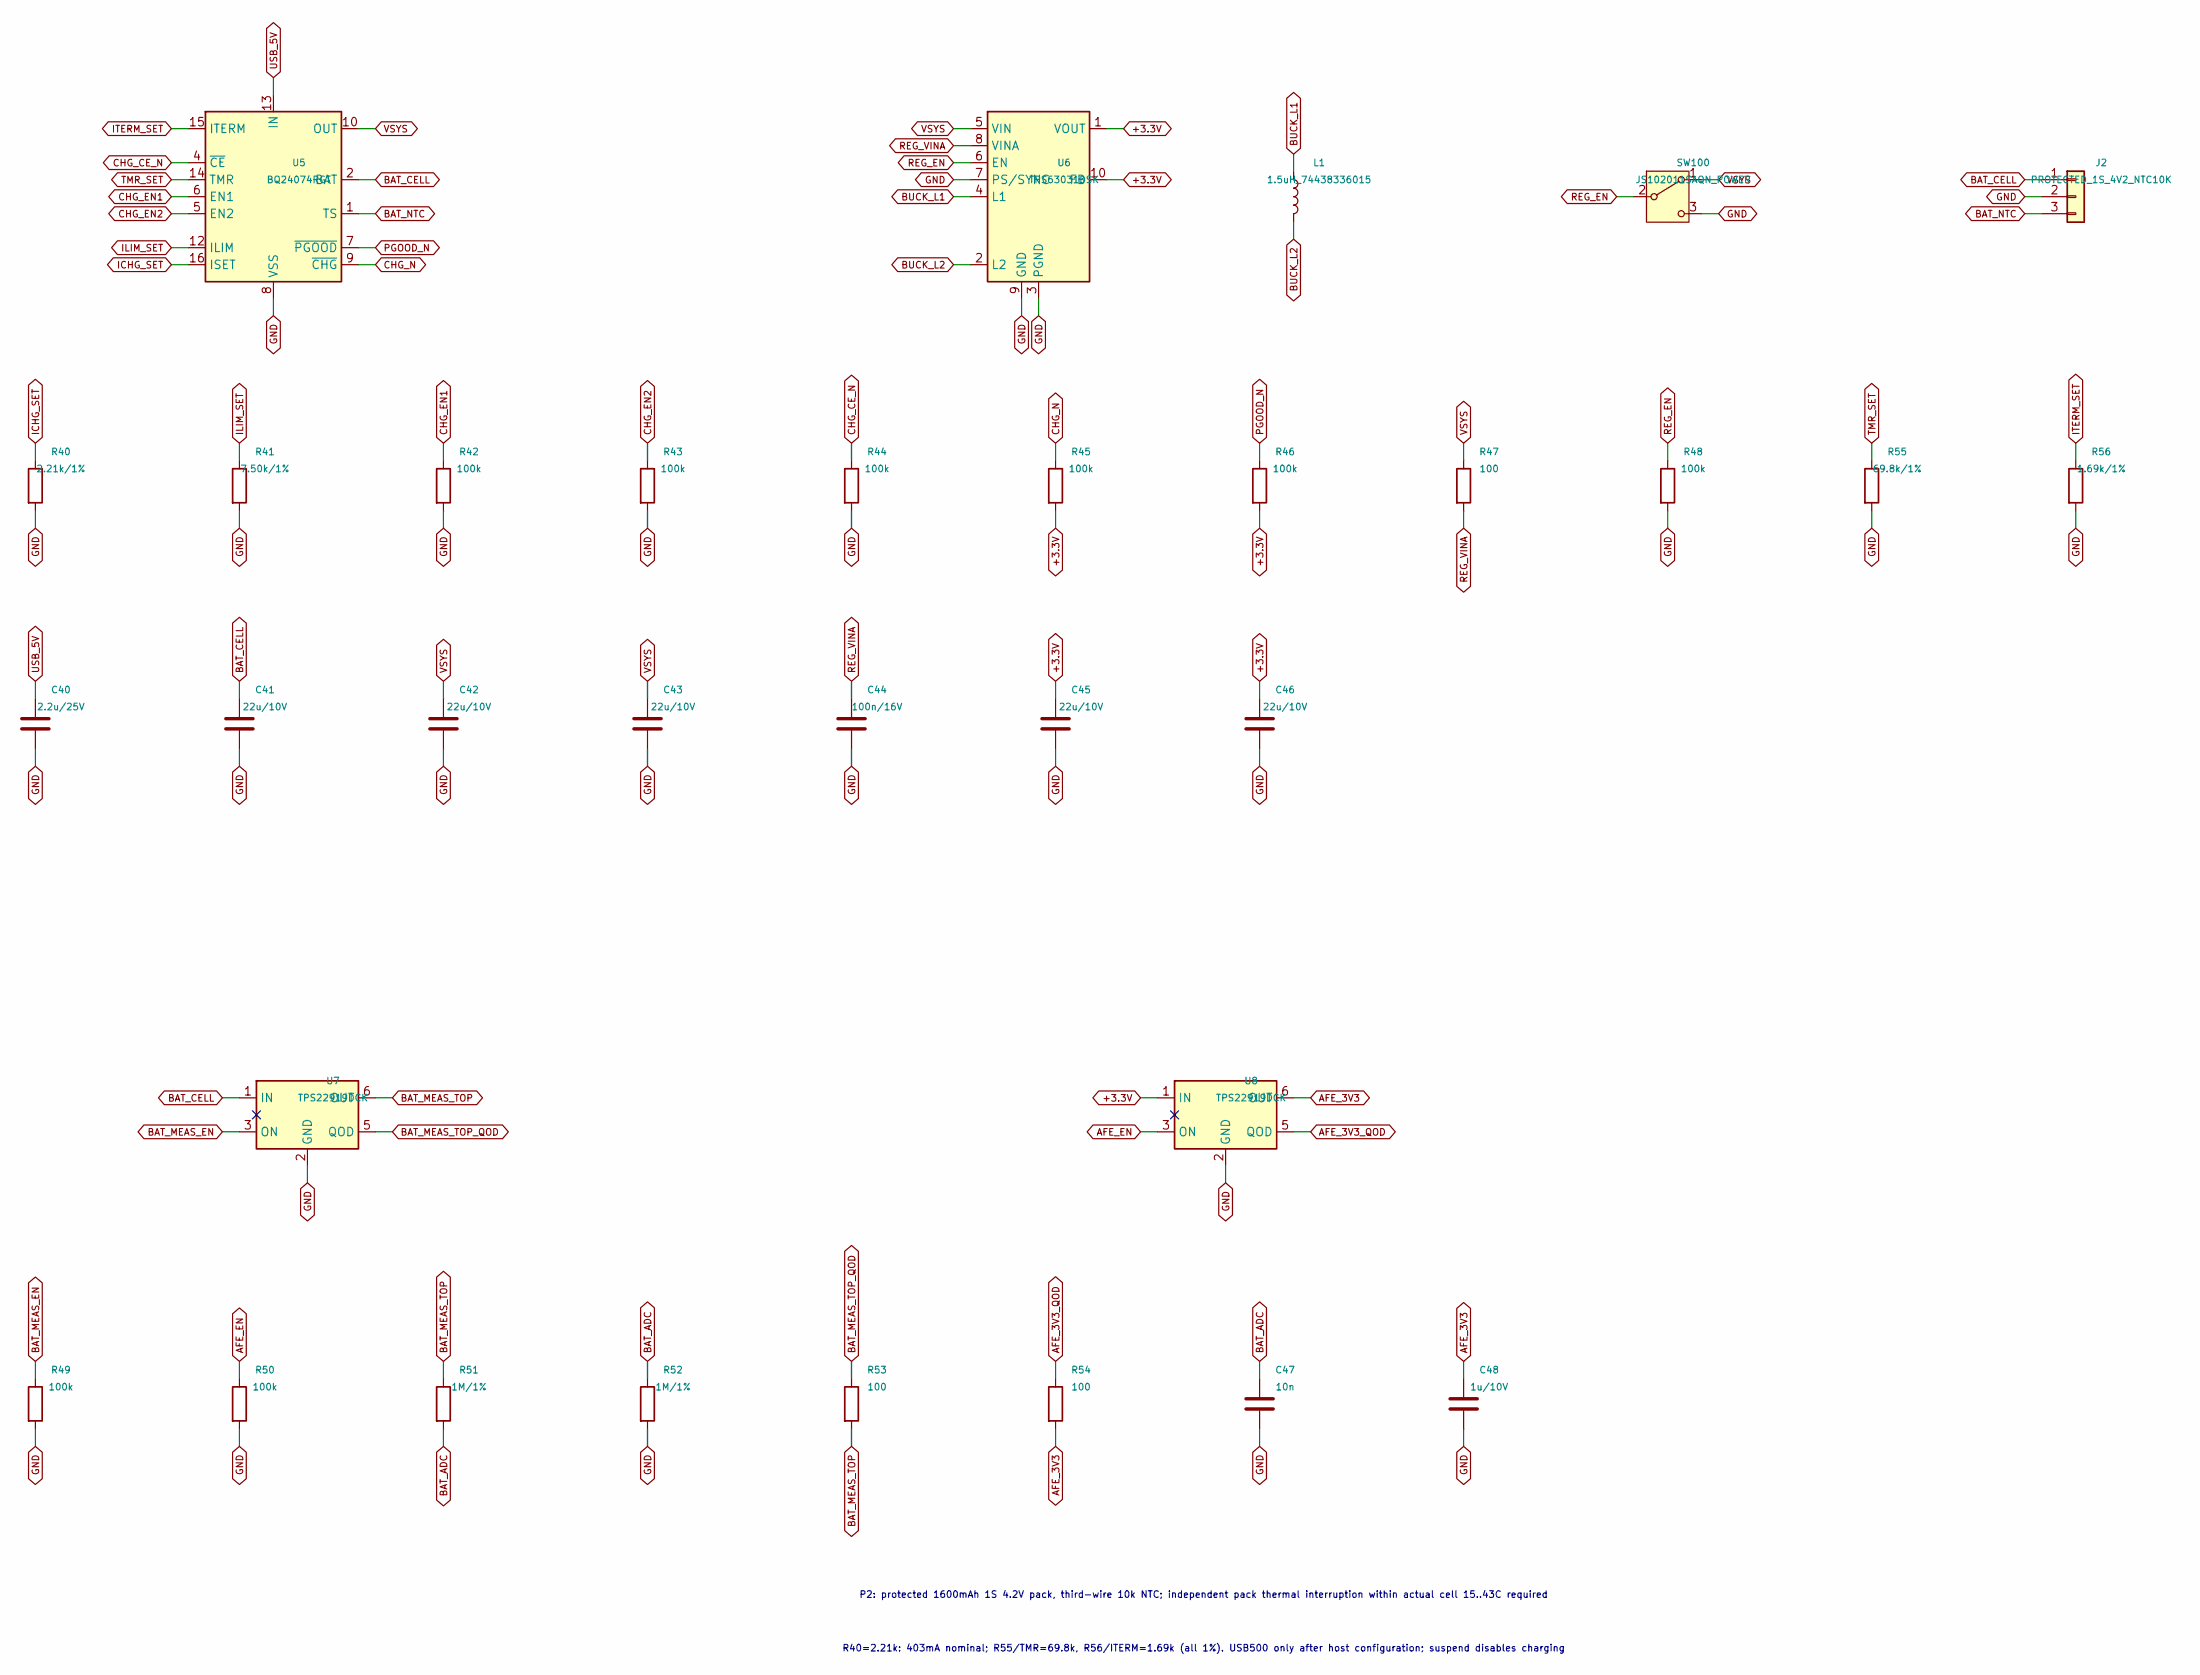
[picture p202: schematic power.kicad_sch, Single-cell protected battery / power path / 3.3V / AFE]

Parts:
C40: 2.2u/25V; C_0805_2012Metric__C40
C41: 22u/10V; C_0805_2012Metric__C41
C42: 22u/10V; C_0805_2012Metric__C42
C43: 22u/10V; C_0805_2012Metric__C43
C44: 100n/16V; C_0603_1608Metric__C44
C45: 22u/10V; C_0805_2012Metric__C45
C46: 22u/10V; C_0805_2012Metric__C46
C47: 10n; C_0402_1005Metric__C47
C48: 1u/10V; C_0402_1005Metric__C48
J2: PROTECTED_1S_4V2_NTC10K; JST_SH_SM03B-SRSS-TB_1x03-1MP_P1.00mm_Horizontal__J2
L1: 1.5uH_74438336015; L_Wuerth_MAPI-3015__L1
R40: 2.21k/1%; R_0402_1005Metric__R40
R41: 7.50k/1%; R_0402_1005Metric__R41
R42: 100k; R_0402_1005Metric__R42
R43: 100k; R_0402_1005Metric__R43
R44: 100k; R_0402_1005Metric__R44
R45: 100k; R_0402_1005Metric__R45
R46: 100k; R_0402_1005Metric__R46
R47: 100; R_0402_1005Metric__R47
R48: 100k; R_0402_1005Metric__R48
R49: 100k; R_0402_1005Metric__R49
R50: 100k; R_0402_1005Metric__R50
R51: 1M/1%; R_0402_1005Metric__R51
R52: 1M/1%; R_0402_1005Metric__R52
R53: 100; R_0402_1005Metric__R53
R54: 100; R_0402_1005Metric__R54
R55: 69.8k/1%; R_0402_1005Metric__R55
R56: 1.69k/1%; R_0402_1005Metric__R56
SW100: JS102011SAQN_POWER; SW_SPDT_CK_JS102011SAQN__SW100
U5: BQ24074RGT; VQFN-16-1EP_3x3mm_P0.5mm_EP1.6x1.6mm__U5
U6: TPS63031DSK; WSON-10-1EP_2.5x2.5mm_P0.5mm_EP1.2x2mm__U6
U7: TPS22919DCK; SOT-363_SC-70-6__U7
U8: TPS22919DCK; SOT-363_SC-70-6__U8

Connections:
+3.3V: C45.1, C46.1, R45.2, R46.2, U6.1 (VOUT), U6.10 (FB), U8.1 (IN); also elsewhere on the board
AFE_3V3_QOD: R54.1, U8.5 (QOD)
AFE_EN: R50.1, U8.3 (ON); also elsewhere on the board
BAT_ADC: C47.1, R51.2, R52.1; also elsewhere on the board
BAT_CELL: C41.1, J2.1, U5.2 (BAT), U5.3 (BAT), U7.1 (IN)
BAT_MEAS_EN: R49.1, U7.3 (ON); also elsewhere on the board
BAT_MEAS_TOP: R51.1, R53.2, U7.6 (OUT)
BAT_MEAS_TOP_QOD: R53.1, U7.5 (QOD)
BAT_NTC: J2.3, U5.1 (TS)
BUCK_L1: L1.1, U6.4 (L1)
BUCK_L2: L1.2, U6.2 (L2)
CHG_CE_N: R44.1, U5.4 (~CE); also elsewhere on the board
CHG_EN1: R42.1, U5.6 (EN1); also elsewhere on the board
CHG_EN2: R43.1, U5.5 (EN2); also elsewhere on the board
CHG_N: R45.1, U5.9 (~CHG); also elsewhere on the board
GND: C40.2, C41.2, C42.2, C43.2, C44.2, C45.2, C46.2, C47.2, C48.2, J2.2, R40.2, R41.2, R42.2, R43.2, R44.2, R48.2, R49.2, R50.2, R52.2, R55.2, R56.2, SW100.3 (C), U5.8 (VSS), U5.17 (VSS), U6.3 (PGND), U6.7 (PS/SYNC), U6.9 (GND), U6.11 (PGND), U7.2 (GND), U8.2 (GND); also elsewhere on the board
ICHG_SET: R40.1, U5.16 (ISET)
ILIM_SET: R41.1, U5.12 (ILIM)
ITERM_SET: R56.1, U5.15 (ITERM)
PGOOD_N: R46.1, U5.7 (~PGOOD); also elsewhere on the board
REG_EN: R48.1, SW100.2 (B), U6.6 (EN)
REG_VINA: C44.1, R47.2, U6.8 (VINA)
TMR_SET: R55.1, U5.14 (TMR)
USB_5V: C40.1, U5.13 (IN); also elsewhere on the board
VSYS: C42.1, C43.1, R47.1, SW100.1 (A), U5.10 (OUT), U5.11 (OUT), U6.5 (VIN)

Notes on the sheet:
P2: protected 1600mAh 1S 4.2V pack, third-wire 10k NTC; independent pack thermal interruption within actual cell 15..43C required
R40=2.21k: 403mA nominal; R55/TMR=69.8k, R56/ITERM=1.69k (all 1%). USB500 only after host configuration; suspend disables charging

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
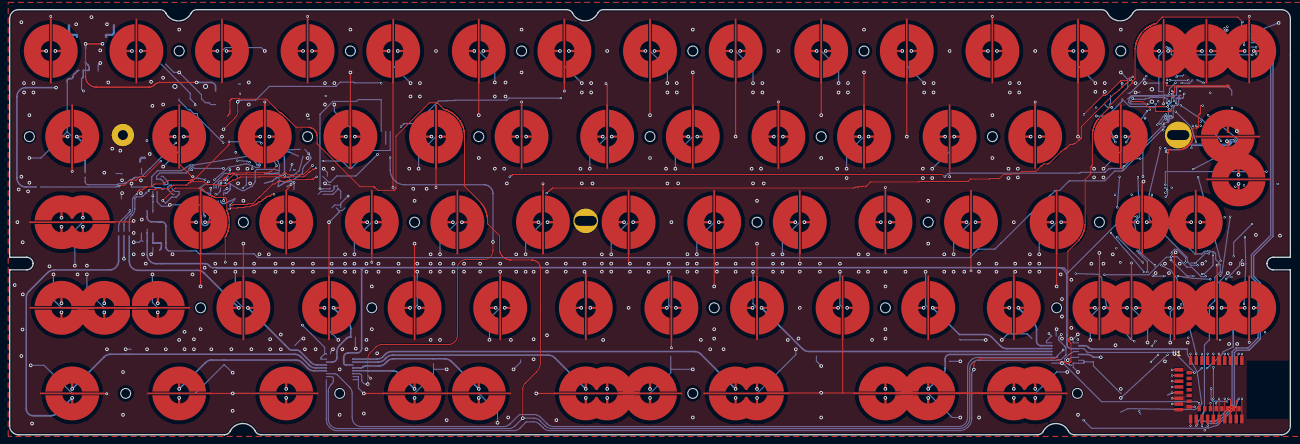
[picture p203: board EC60-nRF52840.kicad_pcb from above]

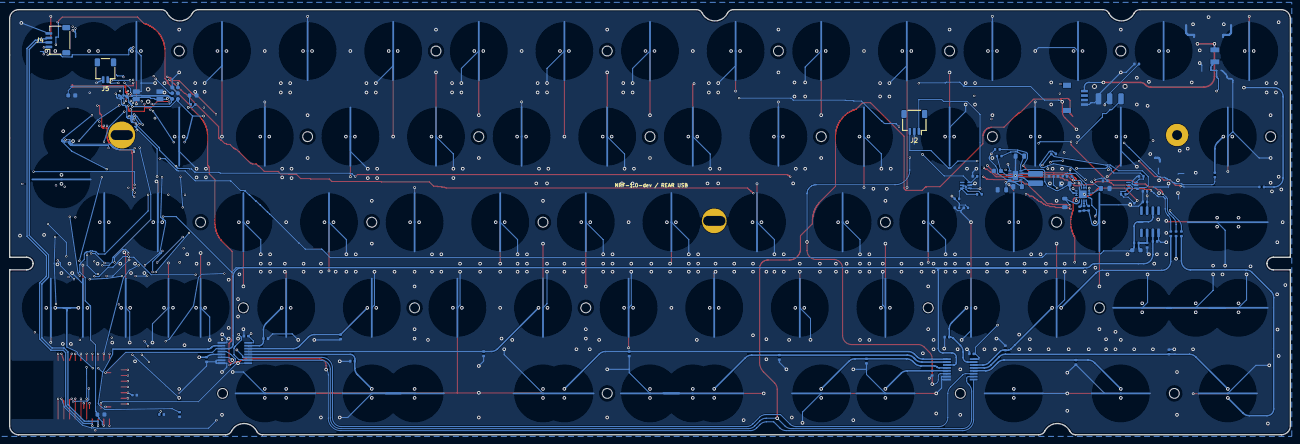
[picture p204: board EC60-nRF52840.kicad_pcb from below]

Board: 4 copper layers, 285.0 x 94.6 mm, 175 parts (76 on the bottom side), 68 nets.
