wZuck/YETI60/scripts/check_project_integration.py

#!/usr/bin/env python3
"""Reject stale or contradictory CAD, firmware, assembly and image evidence."""
import hashlib,json,traceback
from pathlib import Path
ROOT=Path(__file__).resolve().parents[1]; HW=ROOT/'hardware/ec60-nrf52840'; AUD=ROOT/'docs/audit'
def sha(p):return hashlib.sha256(p.read_bytes()).hexdigest()
def read(p):return json.loads(p.read_text())
def hashes(items,base=ROOT):
    for name,expected in items.items():
        assert sha(base/name)==expected,'Stale source: '+name

def verify():
    config=read(ROOT/'design-constraints.json')
    assert config['fabrication']['process']=='ordinary-four-layer-FR4' and not config['fabrication']['HDI_allowed']
    ordinary=read(AUD/'yeti60-ordinary-process.json');assert ordinary['blind_buried_vias']==0 and not ordinary['module_via_in_pad'];hashes(ordinary['source_sha256'])
    fabrication=read(AUD/'yeti60-fabrication.json');assert fabrication['blind_drill_hits']==0 and fabrication['placement_parts']==76;hashes(fabrication['source_sha256']);hashes(fabrication['outputs'])
    assert config['mcu_count']==1 and config['wireless_controller']=='nRF52840' and not config['stm32_allowed']
    assert config['external_usb_c']['connector_path']=='rear-daughterboard-to-J1'
    parts=read(HW/'components.json')
    assert parts['U1']['value']=='E73-2G4M08S1C','E73 branch contains a different MCU module'
    module=read(AUD/'yeti60-e73-variant.json');hashes(module['source_sha256'])
    assert module['status']=='e73-module-contract-passed' and module['vendor_lands']==43
    assert module['connected_bottom_lands']==[12,24,28,32,34]
    assert module['scan_ADC_AIN']==4 and module['battery_ADC_AIN']==3 and module['REG1_mode']=='LDO'
    reference=read(AUD/'yeti60-e73-reference.json');hashes(reference['source_sha256'])
    assert reference['status']=='vendor-reference-and-pin-contract-passed'
    assert parts['J1']['pins']=={'1':'VBUS','2':'D-','3':'D+','4':'GND'}
    assert parts['J2']['pins']=={'1':'BAT_CELL','2':'GND','3':'BAT_NTC'}
    schematic=read(AUD/'schematic-current.json'); assert schematic['status']=='passed'; hashes(schematic['source_sha256'])
    cad=read(HW/'audit-current.json'); assert cad['status']=='cad-checks-passed'; hashes(cad['source_sha256'],HW)
    assert cad['mcu_count']==1 and not cad['failed_pin_pairs'] and not cad['failed_critical_paths']
    pcb=read(HW/'pcb-contract-check.json'); assert pcb['netlist_parity']=='pass' and pcb['copper_layers']==4
    regression=read(HW/'connectivity-changes.json'); assert not regression['regressed_pairs']; hashes(regression['source_sha256'])
    electrical=read(AUD/'yeti60-electrical.json'); assert sha(HW/'EC60-nRF52840.kicad_pcb')==electrical['source_sha256']
    sim=read(AUD/'yeti60-firmware-simulation.json'); assert sim['status']=='passed'; hashes(sim['source_sha256']); assert sha(ROOT/sim['trace_file'])==sim['trace_sha256']
    plate=read(AUD/'plate.json'); assert plate['status']=='passed'; hashes(plate['source_sha256'])
    meta=read(AUD/'yeti60-pcb-mechanical-metadata.json'); assert sha(ROOT/meta['source'])==meta['source_sha256']
    fit=read(AUD/'yeti60-assembly.json'); hashes(fit['source_sha256']); hashes(fit['verification_recipe_sha256'])
    repaired=read(AUD/'e73-fit-candidate.json'); hashes(repaired['source_sha256']); hashes(repaired['outputs'])
    assert repaired['status']=='e73-bounded-plate-switch-fit-passed' and repaired['selected_by_assembly']
    geometry=read(ROOT/'mechanical/assembly-spec.json')['geometry']
    assert fit['selected_geometry']==repaired['selected_geometry']==geometry
    assert fit['case_files']=={name:geometry[name] for name in ['top','bottom']}
    assert geometry['plate'] in fit['source_sha256'] and geometry['plate'] in repaired['outputs']
    assert geometry['bottom'] in repaired['outputs']
    assert fit['bounded_fit_evidence_sha256']==sha(AUD/'e73-fit-candidate.json')
    assert not repaired['complete_keyboard_tolerance_qualified']
    assert not repaired['canonical_selection_changed'] and not repaired['manufacturing_released'] and not repaired['physical_verification']
    assert len(repaired['interfaces'])==3 and all(r['remaining_air_gap_mm']>=.15 for r in repaired['interfaces'])
    assert len(repaired['gasket_bearing_checks'])==8 and len(repaired['lower_shell_repair']['insert_supports'])==8
    hashes(repaired['selected_sources_unchanged'])
    assert sha(AUD/'yeti60-pcb-mechanical-metadata.json')==fit['mechanical_metadata_sha256']
    assert not fit['colliding_envelopes'] and max(fit['pcb_case_overlap_mm3']+fit['plate_case_overlap_mm3'])<1e-5
    assert len(fit['mounting_hole_matches'])==28 and len(meta['mount_holes'])==29
    # Three upstream mechanical footprints share REF**; identify mounts by position.
    assert len({tuple(h['pcb_center_case_mm']) for h in fit['mounting_hole_matches']})==28
    contract=read(AUD/'plate-mount.json');hashes(contract['source_sha256'])
    assert fit['mechanism_contract']=={k:v for k,v in contract.items() if k!='source_sha256'}
    assert contract['installed_mount_sets']==28 and contract['unused_pcb_mount_refs']==['H26']
    assert contract['active_key_centers_preserved']==60 and contract['plate_stabilizer_pairs']==3
    mechanism_drawing=read(AUD/'key-mechanism-drawing.json');hashes(mechanism_drawing['source_sha256']);hashes(mechanism_drawing['outputs'])
    assert fit['nominal_stack']['plate_thickness_mm']==1.6
    assert abs(fit['finished_board_envelope_thickness_mm']-meta['pcb_thickness_mm'])<1e-6
    assert all(max(c['case_overlap_mm3'])<1e-5 for c in fit['battery_candidates'])
    tolerance=read(AUD/'e73-tolerance-diagnostic.json');hashes(tolerance['source_sha256'])
    from study_e73_mechanical_tolerances import verify_evidence as verify_tolerances
    verify_tolerances(tolerance,read(ROOT/'mechanical/assembly-spec.json'),read(ROOT/'mechanical/pcb-fabrication-spec.json'))
    harness=read(AUD/'yeti60-interconnects.json');assert harness['status']=='controlled-route-geometry-passed' and not harness['production_approved'];hashes(harness['source_sha256']);hashes(harness['published_guide_sha256'])
    assert len(harness['wires']['usb'])==4 and len(harness['wires']['battery'])==3
    assert not harness['case_modification_required'] and harness['minimum_expanded_harness_to_harness_gap_mm']>=.15
    geometry=read(AUD/'yeti60-render-geometry.json'); hashes(geometry['geometry_sources']); assert geometry['case_scale']==[1,1,1] and not geometry['case_modifiers']
    for folder,recipe in [('ec60-nrf52840','render_single_nrf.py'),('yeti60-assembly','render_yeti60_assembly.py')]:
        base=ROOT/'renders'/folder; m=read(base/'render-manifest.json'); assert sha(ROOT/'scripts'/recipe)==m['recipe_sha256'],folder+' recipe changed; regenerate renders'
        if folder=='ec60-nrf52840': assert sha(ROOT/m['source'])==m['source_sha256']
        else:
            hashes(m['geometry_sources']); assert m['mechanism_source_sha256']==sha(ROOT/'mechanical/yeti60-key-mechanism.e73.json')
            assert m['fitted_BOM_sha256']==sha(AUD/'yeti60-bom.json') and len(m['fitted_mainboard_references'])==76
            assert m['exploded_visible_objects_by_group']['electronics']==76 and m['exploded_visible_objects_by_group']['stabilizers']==15
            assert set(m['exploded_frame_checks'])=={'feet','electronics','battery','interconnect'}
            assert all(v['in_frame'] and v['above_desk'] for v in m['exploded_frame_checks'].values())
            assert m['assembly_report_sha256']==sha(AUD/'yeti60-assembly.json')
            assert m['mesh_export_recipe_sha256']==sha(ROOT/'scripts/export_yeti60_render_meshes.py')
            assert m['case_scale']==[1,1,1] and not m['case_geometry_modifiers']
            assert m['interconnect_report_sha256']==sha(AUD/'yeti60-interconnects.json')
            assert m['daughterboard_report_sha256']==sha(AUD/'yeti60-daughterboard.json')
            assert set(m['outputs'])=={'assembled.png','rear.png','exploded.png','battery-space.png'}
        for name,item in m['outputs'].items():
            assert sha(base/name)==item['sha256'],'Changed render asset: '+name
            if folder=='yeti60-assembly':
                for key in ['recipe_sha256','assembly_report_sha256','mesh_export_recipe_sha256','interconnect_report_sha256','daughterboard_report_sha256','mechanism_source_sha256']:
                    assert item[key]==m[key],name+' was not rendered from current inputs'
    plot=read(ROOT/'renders/yeti60-firmware/plot-manifest.json'); assert plot['trace_sha256']==sim['trace_sha256']; assert plot['recipe_sha256']==sha(ROOT/'scripts/plot_yeti60_simulation.py'); hashes(plot['outputs'],ROOT/'renders/yeti60-firmware')
    materials=read(AUD/'yeti60-materials.json');assert materials['fitted_mainboard_parts']==76;hashes(materials['source_sha256'])
    inventory=read(AUD/'yeti60-inventory.json');hashes(inventory['source_sha256']);hashes(inventory['outputs'])
    assert inventory['required_mainboard_parts']==inventory['planned_stock_parts']+inventory['net_purchase_parts']==76
    assert inventory['in_transit_credited']==inventory['optional_c5_parts_credited']==0
    assert not inventory['physical_remaining_count_confirmed'] and not inventory['production_approved']
    key_geometry=read(AUD/'yeti60-key-geometry.json');hashes(key_geometry['source_sha256'])
    assert key_geometry['status']=='plate-copper-firmware-mapping-passed' and len(key_geometry['matches'])==60
    guide=read(AUD/'yeti60-build-guide.json');hashes(guide['source_sha256']);hashes(guide['outputs'])
    guide_check=read(AUD/'yeti60-build-guide-check.json')
    assert guide_check['status']=='passed' and guide_check['guide_manifest_sha256']==sha(AUD/'yeti60-build-guide.json')
    assert guide_check['verification_recipe_sha256']==sha(ROOT/'scripts/check_yeti60_build_guide.py')
    engineering=read(AUD/'yeti60-engineering.json');assert engineering['status']=='passed';hashes(engineering['evidence_sha256'],AUD)
    target=read(AUD/'yeti60-target-build.json');assert target['status']=='built';hashes(target['source_sha256'])
    for variant in target['variants'].values():hashes(variant['outputs'])
    target_check=read(AUD/'yeti60-target-check.json');assert target_check['status']=='passed' and target_check['build_manifest_sha256']==sha(AUD/'yeti60-target-build.json')
    assert all(v['USB_configuration_mA']==500 for v in target_check['variants'].values())
    from check_yeti60_firmware_suite import verify as verify_firmware_suite
    verify_firmware_suite()
    assert read(AUD/'documentation-check.json')['status']=='passed'
    return {'status':'passed','controller_count':1,'physical_pin_pairs':len(cad['physical_pin_pairs']),'matched_mount_holes':28,'assembly_condition':'NiZ 1.6 mm plate, 28 mounts, H26 unused; supplier and physical fit pending','firmware_condition':'normal/calibrator ARM targets built, USB500 descriptor verified; hardware enumeration/BLE/calibration untested','production_approved':False,'open_requirements':config['open_requirements']}
def main():
    try: report=verify()
    except (AssertionError,KeyError,FileNotFoundError,ValueError) as error:
        location=traceback.extract_tb(error.__traceback__)[-1]
        report={'status':'failed','error':str(error) or location.line,'check_location':f'{Path(location.filename).name}:{location.lineno}','production_approved':False}
    (AUD/'integration.json').write_text(json.dumps(report,indent=2)+'\n'); print(json.dumps(report,indent=2))
    raise SystemExit(report['status']!='passed')
if __name__=='__main__':main()
