wZuck/YETI60/scripts/check_yeti60_assembly.py

#!/usr/bin/env python3
"""Check current PCB/case fit and a provisional battery envelope; build render geometry.

Run with requirements-audit.txt. Z assumptions and proxy heights are explicit.
No claim of qualified switch/dome/keycap/battery manufacturing tolerances.
"""
import hashlib,json,math,subprocess
from pathlib import Path
import ezdxf
from ezdxf.path import make_path
from OCP.BRepBuilderAPI import BRepBuilderAPI_MakePolygon,BRepBuilderAPI_MakeFace,BRepBuilderAPI_Transform
from OCP.BRepPrimAPI import BRepPrimAPI_MakePrism,BRepPrimAPI_MakeBox,BRepPrimAPI_MakeCylinder
from OCP.BRepExtrema import BRepExtrema_DistShapeShape
from OCP.gp import gp_Pnt,gp_Vec,gp_Trsf,gp_Ax2,gp_Dir
from OCP.STEPControl import STEPControl_Writer,STEPControl_AsIs
from OCP.BRepCheck import BRepCheck_Analyzer
from OCP.TopAbs import TopAbs_FACE
from OCP.TopExp import TopExp_Explorer
from OCP.TopoDS import TopoDS
from OCP.BRepGProp import BRepGProp
from OCP.GProp import GProp_GProps
from cad_geometry import load,bounds,intersection_volume
ROOT=Path(__file__).resolve().parents[1];WORK=ROOT/'.assembly-work';WORK.mkdir(exist_ok=True)
CLI='/Applications/KiCad/KiCad.app/Contents/MacOS/kicad-cli'
def sha(path):return hashlib.sha256(path.read_bytes()).hexdigest()
def move(shape,x=0,y=0,z=0):
    t=gp_Trsf();t.SetTranslation(gp_Vec(x,y,z));return BRepBuilderAPI_Transform(shape,t,True).Shape()
def box(bb):return BRepPrimAPI_MakeBox(gp_Pnt(*bb[:3]),bb[3]-bb[0],bb[4]-bb[1],bb[5]-bb[2]).Shape()
def distance(a,b):
    d=BRepExtrema_DistShapeShape(a,b);d.Perform();assert d.IsDone();return d.Value()
def wire(points,ccw):
    pts=[]
    for p in points:
        if not pts or math.dist(p,pts[-1])>1e-8:pts.append(p)
    if math.dist(pts[0],pts[-1])<1e-8:pts.pop()
    area=sum(p[0]*q[1]-q[0]*p[1] for p,q in zip(pts,pts[1:]+pts[:1]))
    if (area>0)!=ccw:pts.reverse()
    builder=BRepBuilderAPI_MakePolygon()
    for x,y,z in pts:builder.Add(gp_Pnt(x,y,z))
    builder.Close();return builder.Wire()
def write_step(shape,path):
    w=STEPControl_Writer();w.Transfer(shape,STEPControl_AsIs);w.Write(str(path))
def build_plate(z,thickness=1.6):
    from check_yeti60_plate_mount import keys,SOURCE
    doc=ezdxf.readfile(ROOT/'mechanical/e73-fit/yeti60-e73-niz-m01.dxf');profiles=[];centers=keys(ezdxf.readfile(SOURCE))
    for e in doc.modelspace().query('LWPOLYLINE'):
        points=[(-v.x,-v.y,z) for v in make_path(e).flattening(.002)]
        xs=[p[0] for p in points];ys=[p[1] for p in points];area=(max(xs)-min(xs))*(max(ys)-min(ys));profiles.append((area,points))
        sx,sy=max(xs)-min(xs),max(ys)-min(ys)
        # Stabilizer cutouts are asymmetric about their sensing stem; never
        # infer a sensing center from the combined opening bounding box.
    profiles.sort(key=lambda a:-a[0]);face=BRepBuilderAPI_MakeFace(wire(profiles[0][1],True))
    for _,pts in profiles[1:]:face.Add(wire(pts,False))
    # Screw circles are also tessellated to <=0.002 mm sagitta.
    for c in doc.modelspace().query('CIRCLE'):
        n=max(64,math.ceil(math.pi/math.acos(1-.002/c.dxf.radius)));pts=[(-c.dxf.center.x+c.dxf.radius*math.cos(2*math.pi*i/n),-c.dxf.center.y+c.dxf.radius*math.sin(2*math.pi*i/n),z) for i in range(n)];face.Add(wire(pts,False))
    assert face.IsDone();shape=BRepPrimAPI_MakePrism(face.Face(),gp_Vec(0,0,thickness)).Shape();assert BRepCheck_Analyzer(shape).IsValid();assert len(centers)==60,len(centers)
    return shape,sorted(centers,key=lambda c:(-c['y'],c['x']))
def main():
    meta=json.loads((ROOT/'docs/audit/yeti60-pcb-mechanical-metadata.json').read_text());pcbpath=ROOT/meta['source'];assert sha(pcbpath)==meta['source_sha256']
    spec=json.loads((ROOT/'mechanical/assembly-spec.json').read_text());bottom=load(ROOT/'mechanical/e73-fit/yeti60-e73-bottom-m01.step');top=load(ROOT/'mechanical/generated/yeti60-top.step')
    subprocess.run([CLI,'pcb','export','step','--board-only','--user-origin','0x0mm','-f','-o',str(WORK/'pcb-body.step'),str(pcbpath)],check=True,stdout=subprocess.DEVNULL,stderr=subprocess.DEVNULL)
    body=load(WORK/'pcb-body.step');native_bounds=bounds(body);native_thickness=native_bounds[5]-native_bounds[2]
    faces=TopExp_Explorer(body,TopAbs_FACE);base_face=None;largest=0
    while faces.More():
        f=TopoDS.Face(faces.Current());bb=bounds(f)
        if abs(bb[2])<1e-6 and abs(bb[5])<1e-6:
            prop=GProp_GProps();BRepGProp.SurfaceProperties_s(f,prop)
            if prop.Mass()>largest:base_face=f;largest=prop.Mass()
        faces.Next()
    assert base_face is not None
    # KiCad STEP body excludes outer copper/mask; use a conservative envelope
    # extruded to the declared finished thickness without stretching XY.
    body=BRepPrimAPI_MakePrism(base_face,gp_Vec(0,0,meta['pcb_thickness_mm'])).Shape()
    prop=GProp_GProps();BRepGProp.VolumeProperties_s(body,prop)
    if prop.Mass()<0:body.Reverse()
    assert BRepCheck_Analyzer(body).IsValid()
    # FELK60 ledges stay at z=3.19 and 6.39. The 1.6 mm plate uses
    # separate 2.0 mm lower and 1.2 mm upper gasket stock at the fixed datum.
    plate_bottom=spec['stack']['plate_bottom_z'];plate_thickness=spec['stack']['plate_thickness'];plate,keys=build_plate(plate_bottom,plate_thickness);write_step(plate,WORK/'plate.step')
    plate_collision=[intersection_volume(plate,s) for s in (bottom,top)]
    nominal_gap=spec['stack']['pcb_to_plate_gap']
    pcb_top=plate_bottom-nominal_gap;shift=pcb_top-meta['pcb_thickness_mm'];placed=move(body,z=shift);write_step(placed,WORK/'pcb-placed.step')
    pcb_collisions=[intersection_volume(placed,s) for s in (bottom,top)];pcb_distances=[distance(placed,s) for s in (bottom,top)]
    envelopes=[];hits=[]
    for part in meta['parts']:
        if not part['back']:continue
        x0,y0,x1,y1=part.get('physical_body_bbox_pcb_mm') or part['xy_courtyard_and_graphics_bbox_pcb_mm'];height=part['height_envelope_mm'];bb=[x0,-y1,shift-height,x1,-y0,shift];s=box(bb)
        volumes=[intersection_volume(s,c) for c in (bottom,top)];entry={**part,'bounds_case_mm':bb,'collision_volume_mm3':volumes,'min_case_distance_mm':min(distance(s,c) for c in (bottom,top))};envelopes.append(entry)
        if max(volumes)>1e-5:hits.append(entry)
    # Hole correspondence is not a manufacturing tolerance approval.
    hole_matches=[];used=set()
    dxf=ezdxf.readfile(ROOT/'mechanical/e73-fit/yeti60-e73-niz-m01.dxf')
    for circle in dxf.modelspace().query('CIRCLE'):
        center=(-circle.dxf.center.x,circle.dxf.center.y)
        choices=[(math.dist(center,h['center_pcb_mm']),i,h) for i,h in enumerate(meta['mount_holes']) if i not in used and h['ref'] not in spec['pcb_fastener']['unused_pcb_mount_refs']]
        offset,i,h=min(choices,key=lambda v:v[0]);used.add(i)
        hole_matches.append({'pcb_ref':h['ref'],'center_offset_mm':offset,'plate_pilot_diameter_mm':2*circle.dxf.radius,'pcb_min_clearance_diameter_mm':min(h['drill_mm']),'nominal_M2_radial_margin_before_tolerances_mm':min(h['drill_mm'])/2-1-offset,'pcb_center_case_mm':[h['center_pcb_mm'][0],-h['center_pcb_mm'][1]],'plate_center_case_mm':[-circle.dxf.center.x,-circle.dxf.center.y],'M1_6_radial_margin_worst_case_mm':(min(h['drill_mm'])-spec['pcb_fastener']['pcb_hole_minus_tolerance']-spec['pcb_fastener']['screw_major_diameter_max'])/2-offset-spec['pcb_fastener']['pcb_hole_position_tolerance']-spec['pcb_fastener']['plate_hole_position_tolerance']-spec['pcb_fastener']['thread_concentricity']})
    assert len(hole_matches)==spec['pcb_fastener']['installed_quantity']==28
    assert len(meta['mount_holes'])==29 and spec['pcb_fastener']['unused_pcb_mount_refs']==['H26']
    assert max(h['center_offset_mm'] for h in hole_matches)<.1
    # Current board and component envelopes at several plausible stack gaps.
    sweep=[]
    for gap in (4.0,4.3,4.6,4.9,5.2):
        z=plate_bottom-gap-meta['pcb_thickness_mm'];shape=move(body,z=z);sweep.append({'pcb_to_plate_gap_mm':gap,'pcb_bottom_z':z,'pcb_case_overlap_mm3':[intersection_volume(shape,c) for c in (bottom,top)],'flat_floor_pack_thickness_budget_mm':round(z-.5-(-5.91+.5),3)})
    # The selected custom pack envelope includes its PCM, NTC, wrapping and growth.
    battery=spec['battery'];width,depth,height=battery['full_envelope_including_growth'];x0,y0,x1,y1=battery['bounds_xy']
    assert abs(x1-x0-width)<1e-6 and abs(y1-y0-depth)<1e-6
    pack_top=battery['top_z'];bb=[x0,y0,pack_top-height,x1,y1,pack_top];pack=box(bb)
    component_clearances=[distance(pack,box(e['bounds_case_mm'])) for e in envelopes]
    assert min(component_clearances)>=.5-1e-6,'Battery is too close to a component envelope'
    head_clearances=[]
    for h in meta['mount_holes']:
        if h['ref'] in spec['pcb_fastener']['unused_pcb_mount_refs']:continue
        x,y=h['center_pcb_mm'];r=battery['fastener_exclusion_radius']
        head=box([x-r,-y-r,shift-1.9,x+r,-y+r,shift])
        assert intersection_volume(pack,head)<1e-6,'Battery hits a fastener head'
        head_clearances.append(distance(pack,head))
    assert min(head_clearances)>=.7-1e-6
    candidates=[{'bounds_case_mm':bb,'size_mm':[width,depth,height],'case_overlap_mm3':[intersection_volume(pack,s) for s in (bottom,top)],'component_and_fastener_3d_envelopes_clear':True,'minimum_component_clearance_mm':min(component_clearances),'minimum_fastener_clearance_mm':min(head_clearances),'envelope_must_include_swelling_and_protection':True,'bottom_case_distance_mm':distance(pack,bottom),'top_insulation_gap_mm':shift-pack_top,'status':'custom-pack-design-envelope-supplier-qualification-pending'}]
    report={'status':'conditional-fit-review','source_sha256':{str(p.relative_to(ROOT)):sha(p) for p in [pcbpath,ROOT/'mechanical/e73-fit/yeti60-e73-bottom-m01.step',ROOT/'mechanical/generated/yeti60-top.step',ROOT/'mechanical/assembly-spec.json',ROOT/'mechanical/e73-fit/yeti60-e73-niz-m01.dxf']},'verification_recipe_sha256':{str(p.relative_to(ROOT)):sha(p) for p in [Path(__file__).resolve(),ROOT/'scripts/cad_geometry.py',ROOT/'scripts/export_yeti60_mechanical_metadata.py']},'mechanical_metadata_sha256':sha(ROOT/'docs/audit/yeti60-pcb-mechanical-metadata.json'),'pcb_frame_to_case':'X=PCB_X; Y=-PCB_Y; Z=export_Z+pcb_bottom_z','nominal_stack':{'bottom_gasket_ledge_z':3.19,'top_gasket_ledge_z':6.39,'compressed_bottom_gasket_mm':plate_bottom-3.19,'compressed_top_gasket_mm':6.39-plate_bottom-plate_thickness,'plate_bottom_z':plate_bottom,'plate_thickness_mm':plate_thickness,'pcb_to_plate_gap_mm':nominal_gap,'pcb_top_z':pcb_top,'pcb_bottom_z':shift,'pcb_gap_basis':'4.5 mm machined shoulder plus 0.1 mm insulating film; physical dome/housing acceptance requires first article'},'mounting_hole_matches':hole_matches,'max_hole_center_offset_mm':max(h['center_offset_mm'] for h in hole_matches),'min_M2_radial_margin_before_tolerances_mm':min(h['nominal_M2_radial_margin_before_tolerances_mm'] for h in hole_matches),'power_switch_access':'8 mm underside service port; insulated-tool access to SW100','plate_profile_chord_error_mm':.002,'active_key_positions':keys,'native_step_substrate_body_thickness_mm':native_thickness,'finished_board_envelope_thickness_mm':meta['pcb_thickness_mm'],'finished_envelope_basis':'Native STEP bottom face extruded to declared finished copper/mask thickness; conservative full board envelope','pcb_case_overlap_mm3':pcb_collisions,'pcb_case_distances_mm':pcb_distances,'plate_case_overlap_mm3':plate_collision,'component_envelopes':envelopes,'colliding_envelopes':[e['ref'] for e in hits],'pcb_gap_sweep':sweep,'battery_candidates':candidates,'not_verified':['Final switch/dome/fastener PCB-to-plate gap and tolerances','Actual battery/protection/NTC, swelling/insulation, cable bend and daughterboard envelope','J2 mating plug and current component height assumptions except sourced Raytac and JST body heights','Resin insert conversion and print shrinkage; original M3 metal-thread pilots are retained','Generic keycap shapes in renders are illustrative, not qualified OEM CAD']}
    # Ordinary JLC thickness range: PCB top remains fixed by the standoffs.
    profile_path=ROOT/'mechanical/pcb-fabrication-spec.json';profile=json.loads(profile_path.read_text())
    low_t,high_t=profile['ordinary_thickness_acceptance_range_mm'];deep_shift=meta['pcb_thickness_mm']-high_t;shallow_shift=meta['pcb_thickness_mm']-low_t
    envelope_distances=[]
    for e in envelopes:
        eb=e['bounds_case_mm'].copy();eb[2]+=deep_shift;eb[5]+=shallow_shift
        envelope_distances.extend(distance(box(eb),c) for c in (bottom,top))
        assert intersection_volume(box(eb),pack)<1e-6
    minimum_case=min(envelope_distances)
    assert minimum_case>=spec['case']['linear_tolerance']+.1-1e-6,'Ordinary board thickness leaves inadequate component/case allowance'
    thick_body=BRepPrimAPI_MakePrism(base_face,gp_Vec(0,0,high_t)).Shape();thick_body=move(thick_body,z=pcb_top-high_t)
    board_min_case=min(distance(thick_body,c) for c in (bottom,top))
    assert board_min_case>=.2+spec['case']['linear_tolerance']+.1-1e-6,'Ordinary outline/case allowance exhausted'
    worst_head_gaps=[];component_head_gaps=[]
    washer_r=spec['pcb_fastener']['washer_od_max']/2+.15
    for h in meta['mount_holes']:
        if h['ref'] in spec['pcb_fastener']['unused_pcb_mount_refs']:continue
        x,y=h['center_pcb_mm'];cy=-y;r=battery['fastener_exclusion_radius']
        deep_head=box([x-r,cy-r,shift+deep_shift-1.9,x+r,cy+r,shift+deep_shift]);worst_head_gaps.append(distance(pack,deep_head))
        washer=BRepPrimAPI_MakeCylinder(gp_Ax2(gp_Pnt(x,cy,shift-spec['pcb_fastener']['washer_thickness']),gp_Dir(0,0,1)),washer_r,spec['pcb_fastener']['washer_thickness']).Shape()
        for e in envelopes:
            eb=e['bounds_case_mm'];dx=max(eb[0]-x,0,x-eb[3]);dy=max(eb[1]-cy,0,cy-eb[4])
            if math.hypot(dx,dy)>3:continue
            component_head_gaps.append(distance(washer,box(eb)))
            assert intersection_volume(washer,box(eb))<1e-6,('Washer/component collision',h['ref'],e['ref'])
    assert min(worst_head_gaps)>=.5-1e-6
    report['ordinary_board_thickness_budget']={'finished_range_mm':[low_t,high_t],'CAD_nominal_mm':meta['pcb_thickness_mm'],'PCB_top_fixed':True,'minimum_component_case_gap_over_thickness_range_mm':minimum_case,'minimum_gap_after_case_tolerance_mm':minimum_case-spec['case']['linear_tolerance'],'minimum_max_thickness_board_case_gap_mm':board_min_case,'PCB_outline_allowance_mm':.2,'minimum_pack_to_worst_depth_fastener_mm':min(worst_head_gaps),'minimum_washer_component_gap_mm':min(component_head_gaps),'washer_radial_position_allowance_mm':.15,'nominal_screw_engagement_range_mm':[5-.8-high_t-.1,5-.8-low_t-.1]}
    report['source_sha256'][str(profile_path.relative_to(ROOT))]=sha(profile_path)
    from check_yeti60_plate_mount import verify as verify_plate,SOURCE,TARGET,SPEC
    mechanism=json.loads(SPEC.read_text())
    contract=verify_plate(ezdxf.readfile(SOURCE),ezdxf.readfile(TARGET),mechanism)
    assert mechanism['assembly_spec']=='mechanical/assembly-spec.json' and mechanism['plate_thickness_mm']==spec['stack']['plate_thickness']
    assert set(h['ref'] for h in meta['mount_holes'])-set(h['pcb_ref'] for h in hole_matches)=={'H26'}
    h26=next(h for h in meta['mount_holes'] if h['ref']=='H26')
    assert math.dist([h26['center_pcb_mm'][0],-h26['center_pcb_mm'][1]],mechanism['unused_mount_center_case_mm'])<.1
    report['mechanism_contract']=contract
    report['source_sha256'].update({str(p.relative_to(ROOT)):sha(p) for p in [SPEC,SOURCE,TARGET,ROOT/'scripts/check_yeti60_plate_mount.py']})
    report['case_files']={'bottom':'mechanical/e73-fit/yeti60-e73-bottom-m01.step','top':'mechanical/generated/yeti60-top.step'}
    report['selected_geometry']=spec['geometry']
    report['bounded_fit_evidence_sha256']=sha(ROOT/'docs/audit/e73-fit-candidate.json')
    report['source_sha256']['docs/audit/e73-fit-candidate.json']=report['bounded_fit_evidence_sha256']
    report['selected_battery']=spec['battery']
    report['selected_fasteners']=spec['pcb_fastener']
    report['unused_pcb_mount_refs']=spec['pcb_fastener']['unused_pcb_mount_refs']
    report['gasket_stock_mm']={'bottom':spec['stack']['bottom_gasket_stock_mm'],'top':spec['stack']['top_gasket_stock_mm']}
    report['minimum_fastener_radial_margin_worst_case_mm']=min(h['M1_6_radial_margin_worst_case_mm'] for h in hole_matches)
    assert report['minimum_fastener_radial_margin_worst_case_mm']>0
    report['not_verified']=['Physical first-article dome/housing fit, printed-resin properties and insert pullout','Supplier-signed custom battery drawing, thermal protection and production capacity acceptance','Actual enclosure USB enumeration, pairing, charging, runtime and wake measurements']
    (ROOT/'docs/audit/yeti60-assembly.json').write_text(json.dumps(report,indent=2)+'\n');print(json.dumps({'PCB_overlap':pcb_collisions,'PCB_distance':pcb_distances,'plate_overlap':plate_collision,'colliding_envelopes':report['colliding_envelopes'],'battery_candidates':len(candidates)},indent=2))
    if max(pcb_collisions+plate_collision)>1e-5 or hits or any(max(c['case_overlap_mm3'])>1e-5 for c in candidates):
        raise SystemExit('Assembly geometry has collisions; inspect report')
if __name__=='__main__':main()
