wZuck/YETI60/(commit log)

2026-10-27 feat: checkpoint single-nRF52840 EC60 redesign
    Add pinned FELK60/EC60 sources, single-controller schematics and PCB routing work, design constraints, audit records, and validation scripts. Preserve the prior dual-controller interface as historical reference.
    Work in progress: PCB routing and DRC, nRF firmware, assembly validation, and later interference simulation remain unfinished.
2026-10-27 fix: validate single-nRF PCB and add 3D renders
    Complete routing and native clearance repairs, freeze footprint metadata, and preserve EC60 sensing and mounting geometry. Add reproducible KiCad stills and a six-second 3D turntable with model provenance.
    Validation: strict DRC 0 errors and 0 opens; ERC 0 errors; 268 physical pin pairs pass with no connectivity regressions. Render source hashes are unchanged, and MP4/GIF decoding passes. Physical assembly and SI/RF validation remain pending.
2026-10-27 feat: checkpoint YETI60 electrical review and firmware simulation
    Replace inherited USB series resistance with 0R links for the nRF52840 PHY. Add a schematic-derived pin contract, portable scan/power/HID control core and ASan/UBSan host simulation. Begin YETI60 branding and English/Chinese documentation migration.
    CAD: zero strict DRC errors, zero opens and all 268 physical pin pairs pass. Host simulation passes; real peripherals and transport stacks remain mocked. Power-route optimization, assembly Z fit, battery-space study, assembled renders and remaining bilingual documents continue after this checkpoint.
2026-10-27 feat: add YETI60 assembly review and verified simulation renders
2026-10-27 refactor: remove dual-controller prototype and render source-sized FELK60 assembly
2026-10-28 refactor: retain current YETI60 sources and verify integrated design artifacts
2026-10-28 feat: checkpoint HDI power layout and buildable YETI60 firmware
2026-10-28 docs: add YETI60 procurement BOM and remove decorative board branding
2026-10-28 docs: publish assembly drawings and battery capacity feasibility checkpoint
2026-10-28 feat: make the 1600mAh single-cell pack the YETI60 default
    Retain the C5 JSH daughterboard, revise BQ24074 charge programming and USB500 firmware, and synchronize the recessed case, bilingual engineering evidence and current renders. All 31 audit stages pass; supplier pack qualification and physical acceptance remain pending.
2026-10-28 feat: add idle AFE gating and BLE power tuning
    Add 30 s idle scan slowdown, AFE gating through U8, REG1 DC/DC, BLE connection/advertising interval configuration, and the project ZMK fork. Include the P2 feasibility assessment, interconnect evidence, rebuilt target artifacts, and refreshed audit outputs.
2026-10-29 feat: support ordinary JLC fabrication and document complete materials
2026-10-29 fix: publish accessible C5 self-assembly materials
2026-10-29 feat: checkpoint E73 reference footprint and pin proposal
2026-10-29 feat: implement E73 schematic and buildable USB BLE firmware checkpoint
2026-10-29 test: verify both module variants and publish assembly evidence
2026-10-29 fix: use guarded per-key calibration and define RF remediation
2026-10-30 fix: prioritize wired HID while charging in both module options
2026-10-31 feat: publish Raytac PCB and Gerber package
2026-11-01 docs: add Raytac ordering and soldering entry point
2026-11-01 fix: review Raytac USB routing and publish complete assembly evidence
2026-11-01 feat: select Deskeys mechanism and adapt Raytac plate with build guide
2026-11-02 feat: switch Raytac to NiZ and plate-mounted stabilizers
2026-11-02 feat: add Raytac open-bench qualification studies and prototype order gates
2026-11-02 docs: add supplier battery parameter handoff for Raytac
2026-11-02 feat: add Raytac short-USB prototype candidate and verified firmware
2026-11-02 feat: add Raytac closed-case harness and printable guides checkpoint
2026-11-02 feat: synchronize Raytac enclosed assembly and feed qualification review
2026-11-03 fix: qualify Raytac input fuse and record service-path obstruction
2026-11-03 fix: clear Raytac RF wing and verify continuous rigid extraction
2026-11-03 fix: specify Raytac passives and enlarge power capacitor lands
2026-11-04 fix: shorten Raytac power loops and sync procurement specs
    Relocate the regulator stage and charger capacitors, repair local ground returns, and retain ordinary through-via fabrication. Bind power paths and assembly positions to frozen checks; synchronize generic purchasing specifications, firmware and renders. All 75 software/CAD audit stages pass. Physical acceptance and fabrication release remain open.
2026-11-05 feat: export verified Raytac first-article CAM files
    Export current candidate Gerbers, drills, stencil, placement and IPC data. Validate native-to-CAM geometry, net and drill parity, omit JP1 paste, and exercise CAM fault injection. Update first-article ordering instructions and download mirrors. Physical, supplier DFM and enclosed assembly qualification remain open.
2026-11-05 feat: audit Raytac shell clearance tolerance deficits
    Measure plate locating-ear clearance against both shells and calculate directional allowance subtotals for the ears and SW100 floor. Include ordinary PCB thickness, shoulder, film, case and profile approximation terms. Record unknown terms and repair requirements in paired documents. Integrate the diagnostic and fault injection into the 80-stage audit without claiming enclosed or physical acceptance.
2026-11-05 fix: repair Raytac plate and switch clearances
    Inset the plate exterior by 0.40 mm while preserving all 88 interior entities. Relieve the SW100 floor, verify continuous bounded plate envelopes and switch clearance, and check eight gasket bearing footprints. Update paired ordering and installation documents, tapped-hole instructions, assembly drawings and four studio renders. All 83 audit stages pass; full-keyboard physical, foam/retention and connected-service qualification remain open. PCB and built firmware are unchanged.
2026-11-05 fix: harden Raytac calibration and BLE recovery
    Version saved thresholds against scanner sources and effective scan settings. Add guarded selected-profile bond clearing, resolved device-tree verification, and native recovery tests using the pinned ZMK implementation.
    Rebuild matched normal/calibrator ARM firmware for reference and current candidate boards. All 85 audit stages passed; physical USB, BLE, analog and charging acceptance remain open.
2026-11-05 fix: handle Raytac USB power events synchronously
    Move charger control into the wrapped legacy USB status callback, honor configuration zero, preserve original ZMK forwarding, avoid external-ILIM intermediate states, and latch GPIO/enable failures. Verify real ARM call targets and exercise the pinned ZMK USB callback under sanitizers.
    Rebuild reference and candidate normal/calibrator firmware. Refresh illustrated-guide provenance and retain the failed initial matrix with executed targeted reruns; all 86 final stages pass. Synchronize the current handbook, stock counts, soldering, wiring and candidate flash paths. Physical acceptance remains open.
2026-11-05 fix: preserve Raytac electrocapacitive scan pulses
    Release the sense clamp before each row rising edge and reclamp before the falling edge. Reject both reversed-order mutants and trace the actual core into a netlist-based RC sensitivity model.
    Add calibrator timing diagnostics using the actual 32768 Hz RTC, with reported frequency and a one-tick quantization guard. Rebuild matched normal/calibrator ARM bundles and document the model assumptions, 36 sensitivity cases, physical timing limits and per-key recalibration requirement.
    All 87 audit stages passed. Rerun analog and integration checks after generated CSV/SVG whitespace normalization. Native PCB, CAM/stencil archives and C04 renders a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
2026-11-05 fix: disconnect Raytac analog GPIO input buffers
    Use GPIO_DISCONNECTED for analog high impedance and discharge release, and shut down an initialized AFE before returning a startup failure. Include the mode helper in the calibration fingerprint.
    Compile the actual target GPIO/init bodies with the production helper and core under sanitizers. Verify flag values against pinned Zephyr headers, pass five positive cases and reject four electrical/cleanup mutants. Rebuild both normal/calibrator bundles and repeat the GPIO tests inside the isolated candidate build.
    All 88 audit stages pass. PCB, CAM/stencil archives and C04 renders remain unchanged; real leakage, analog behavior and hardware accept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
2026-11-05 fix: harden Raytac scan faults and calibration commands
2026-11-05 fix: verify Raytac calibration records with CRC
2026-11-05 test: cover Raytac interrupted-write recovery
2026-11-05 fix: reconcile Raytac review with current candidate evidence
2026-11-06 test: verify Raytac reset defaults and off-state power paths
2026-11-07 fix: reconcile Raytac package models and thermal lands
    Resolve all 75 fitted native models, verify lead landing and TSSOP pin-one orientation, and repair the RGT exposed pad with ordinary mask-tented vias and controlled paste windows. Rebuild matched normal/calibrator firmware and regenerate CAM, assembly views, bilingual guidance and 98-stage audit evidence.
2026-11-11 fix: qualify E73 scanner calibration and storage firmware
2026-11-12 fix: integrate E73 NiZ assembly and expose tolerance limits
2026-11-12 fix: build and verify E73 plate and switch-floor repair candidate
2026-11-12 fix: integrate selected E73 M01 fit with firmware and assembly evidence
2026-11-13 fix: verify E73 USB return copper and local model landing
2026-11-13 fix: verify E73 USB connector fit and ordered service clearance
2026-11-13 fix: add E73 SH3 battery repair and M03 connector clearances
2026-11-14 Complete E73 corner routing and reference-ground repair
2026-11-14 Publish PCB-bound E73 corner firmware and validation evidence
